Jay-Void-BA/OpenKeys/hardware/README.md

# 硬件导航

当前版本为 **[R0.5 PIN＋十键](r05/README.md)**，包含 10 页电路、已布线四层 PCB、BOM、制造包与结构候选。

| 内容 | 文件 |
|---|---|
| 整机图 | [尺寸 PDF](r05/exports/OpenKeys-dimensions.pdf)、[PNG](r05/exports/OpenKeys-dimensions.png) |
| 电路 / 板源 | [原理图](r05/exports/OpenKeys-schematic.pdf)、[PCB](r05/kicad/OpenKeys.kicad_pcb) |
| 打样 | [Gerber / 钻孔](r05/exports/OpenKeys-fabrication.zip)、[BOM](r05/BOM.csv)、[坐标](r05/exports/OpenKeys-SMD-position.csv) |
| 固件对应 | [引脚](r05/pinout.csv)、[R05 目标](../firmware/r05/README.md) |
| 规则与摘要 | [板网报告](r05/review/board-check.json)、[CAD 清单](r05/review/cad-manifest.json) |
| 制作 / 验证 | [R05 手册](../manufacturing/BUILD_R05_ZH.md)、[安全复查](../docs/SECURITY_REVIEW_R05.md) |

当前工程候选未生产放行，完整认证镜像和物理安全验证尚未完成。

历史：[R04 指纹 / 四键](r04/README.md)、[R03](r03/README.md)、[R02](HISTORY_R02.md)。旧资料保持原路径追溯，不与 R05 制造包混用。不要运行旧生成器覆盖新板。
