Jay-Void-BA/OpenKeys/docs/SE_NATIVE_PIN_FEASIBILITY_R05.md

# SE 原生 PIN 强制：候选机制与验收条件

当前经典版已改选 SE051C2 / OEF A8FA / Applet 7.2；本页旧 E2 / 通用 SE05x API 研究不能视为新实片资格证明。见[选型与待验项目](CLASSICAL_SE_POWER_R05.md)。
[当前复查](SECURITY_REVIEW_R05.md) · [会话规则](PIN_SESSIONS_R05.md)

**整机尚未接通或通过实片验证。** 已新增[原生 PIN v4 后端](NATIVE_PIN_RUNTIME_R05.md)
与密封私钥接口；旧 `pin_only` 的 HKDF / MCU 比较后端继续保留用于历史与回归，
不能充当原生私钥权限。SE_EN 不是 PIN 验证器，本页不能作为整机硬件强制的证明。

## 已核对的原厂接口事实

来源：[NXP plug-and-trust](https://github.com/NXP/plug-and-trust/tree/7102413e0457d3dfa4fc4be686ca8ec50bd9f5e2)，
固定提交 `7102413e0457d3dfa4fc4be686ca8ec50bd9f5e2`，
`hostlib/hostLib/se05x_03_xx_xx/se05x_APDU_apis.h` 中的接口说明：

- `WriteUserID` 创建 4–16 字节的 UserID 对象，因此六个数字的编码长度在范围内。
- 创建认证对象时可指定 `TAG_MAX_ATTEMPTS`；PIN 的最大尝试值必须小于 256。
  **省略或填 0 表示无限次数**，不能用于本项目。该字段只在首次创建且设置
  `INS_AUTH_OBJECT` 时适用，不能假设后续普通写入会改变限次策略。
- `CreateSession` 引用四字节认证对象 ID，返回八字节临时会话标识；
  `VerifySessionUserID` 验证成功才完成该类会话建立，错误则不建立。
- `CloseSession` 关闭后不能重开该会话，参数为临时状态。
- AN12413 Rev2.12 §3.2.4.4 明确 UserID 的通用 object counter 不报告失败次数，
  保持 0；不能据此判断没有猜测、次数返还或原生限次正确。须用有限次数的合成对象
  直接验证拒绝行为。`ReadSize` 对 UserID 不返回长度，不能作为六位 PIN 检查。

这是通用 SE05x API 的描述。仍须确认 **实际采购的 SE051C2 料号、Applet / profile、
对象策略、SCP 组合、尝试计数及掉电行为**。有函数声明不代表选定器件和配置已经满足要求。
没有复制或编译 NXP C 实现。

## 不能只增加一次 Verify 调用

1. FIDO / OpenPGP / PIV 私钥、OTP HMAC 与 vault 解密 / 包装密钥，必须由 SE 对象 ACL
   限制为正确的本地 PIN 认证会话。仅在 MCU 设置 `unlocked=true`，或用 SCP03
   验证 MCU 身份后直接允许全部密码操作，仍然能够绕过本地 PIN。
2. 必须排除运行期管理员凭证的旁路授权。尤其不能允许删除 / 重写 PIN 对象后复用
   同一 AuthID 访问旧私钥；这会违反“改硬件 PIN 清空全部数据”。对象 ID 的复用、
   PIN 对象生命周期与所有私钥生命周期需要共同审查。
3. UserID / PIN 不可在未保护的 I2C 上传输。Platform SCP03、Applet SCP03 和 UserID
   会话是不同概念；必须验证实际组合和全程加密 / 完整性，不能根据接口名称推断。
4. SE 临时会话标识只留在受保护 Root 内部，不导出到管理器、日志或任意 APDU
   转发接口。设备配对通道的对端 / transcript / RF 场次绑定仍需独立完成。
5. 原生限次通常只说明认证对象会被限制，**不等于第 11 次失败自动擦除其他对象**。
   完整清空、掉电恢复、Flash 密钥 / 目录 / staging、协议 PIN 和配对必须另行实现。
   锁住 PIN 后如何执行不可读取旧秘密的全清空，也必须验证。
6. 原生会话不能被假设自带 30 秒空闲期限。可信计时、断连 / 离场撤权、SE 关闭 /
   断电和故障响应必须实测；不能把周期保活或 `RefreshSession` 当成用户有效活动。
   如果要求在 Root 已被攻陷时仍保证期限，需要额外硬件机制或更换能强制该策略的器件。

## 全清空的特殊响应不能放宽普通通道校验

同一固定 SDK 的 `DeleteAll` 文档明确：该命令只允许由
`RESERVED_ID_FACTORY_RESET` 凭据认证的会话执行；NXP 信任预置的对象不删除。
它会关闭运行中的会话，响应可能“not encrypted and no R-MAC”。

因此，收到裸 `9000`、断连或一次普通 SCP03 校验失败，都不能证明已经清空。
不能为此修改普通 `ScpSession`，让它接受未认证响应。当前代码没有加入这种例外，
已补[固定 DeleteAll 请求与冷复位后观察](../crates/se-state/src/reset.rs)：独立16字节
reset-only UserID 认证、一次固定命令、不接受裸应答为完成、物理断电、重新认证后清点；
没有放宽普通 SCP03，也没有默认 / 工厂密钥。该组件只产生 Pending / Observation，
不能表示整机全清空。完整擦除服务仍需要独立状态机：先持久锁存擦除中，执行受控
重置，再重新建立认证通道，核对预期的 NXP 预置对象、所有用户命名空间和 Flash
解密 / 包装密钥的销毁结果；错误、断电或无法核对时继续保持锁定。

缺少 PIN 标记或用户对象不是“已回到安全空白”的证明。尤其要测试半擦除后
PIN AuthID 被删除 / 重建、旧私钥仍残留的情况，不能让新 PIN 访问旧秘密。
这项设计风险必须在完整销毁服务和真实 Applet 验证完成后才能关闭。

保留[默认关闭的样板会话探针](NATIVE_UID_QUALIFICATION_R05.md)用于独立实验；新原生
后端已实现编码 / 账本 / 私钥接口，完整擦除、初始化、Root 与资格验证仍是放行阻断项。

## 最小实片负向测试

使用合成密钥逐项测试：未验证 / 错 PIN / 错 AuthID / 错协议角色时签名、解密、
HKDF、OTP 均失败；跨每个 APDU 边界断电不能返还次数；十次错误后第十一次正确
与第十一次错误分别核对；达到限制后复位 / 重建会话 / 换接口不能恢复旧权限。

尝试普通 MCU SCP 会话、工厂命令、更新模式、对象删除重建、旧会话 ID 重放和
管理员权限替换，均不能保留旧秘密并跳过本地 PIN。随后验证改 PIN 全清空、
半擦除重启、NFC 快速重入、USB 重置 / 挂起、30 秒保活、短电压 / 时钟 / EM 故障。

必须记录器件批次、Applet/profile、对象策略字节、固件提交及测量证据。
在这些条件关闭前，当前 R05 继续维持生产放行 BLOCKED。
