Jay-Void-BA/OpenKeys/hardware/pinout.csv

pin | gpio | net | function
1 | VBAT | +3V3 | power / GPIO / dedicated
2 | PC13 | CASE_TAMPER_N | power / GPIO / dedicated
7 | NRST | NRST | power / GPIO / dedicated
10 | PC2 | FLASH_MISO | SPI2_MISO AF5
11 | PC3 | RTC_INT_N | power / GPIO / dedicated
12 | VSSA | GND | power / GPIO / dedicated
13 | VDDA | VDDA | power / GPIO / dedicated
14 | PA0 | USB_SEL | power / GPIO / dedicated
15 | PA1 | USB_OE_N | power / GPIO / dedicated
16 | PA2 | PGOOD_N | power / GPIO / dedicated
17 | PA3 | CHG_N | power / GPIO / dedicated
18 | VSS | GND | power / GPIO / dedicated
19 | VDD | +3V3 | power / GPIO / dedicated
20 | PA4 | NFC_CS_N | power / GPIO / dedicated
21 | PA5 | NFC_SCK | SPI1_SCK AF5
22 | PA6 | NFC_MISO | SPI1_MISO AF5
23 | PA7 | NFC_MOSI | SPI1_MOSI AF5
24 | PC4 | VBUS_A_N | power / GPIO / dedicated
25 | PC5 | VBUS_C_N | power / GPIO / dedicated
26 | PB0 | BTN_UP_N | power / GPIO / dedicated
27 | PB1 | BTN_DOWN_N | power / GPIO / dedicated
28 | PB2 | BTN_OK_N | power / GPIO / dedicated
29 | PB10 | UI_SCL | I2C2_SCL AF4
30 | VCAP | VCAP | power / GPIO / dedicated
31 | VSS | GND | power / GPIO / dedicated
32 | VDD | +3V3 | power / GPIO / dedicated
33 | PB12 | FLASH_CS_N | power / GPIO / dedicated
34 | PB13 | FLASH_SCK | SPI2_SCK AF5
35 | PB14 | UI_SDA | I2C2_SDA AF4
36 | PB15 | FLASH_MOSI | SPI2_MOSI AF5
37 | PC6 | NFC_IRQ_N | power / GPIO / dedicated
38 | PC7 | FP_RESET_N | power / GPIO / dedicated
39 | PC8 | SE_EN | power / GPIO / dedicated
40 | PC9 | FP_IRQ | power / GPIO / dedicated
44 | PA11 | USB_DM | USB_DM AF10
45 | PA12 | USB_DP | USB_DP AF10
46 | PA13 | SWDIO | power / GPIO / dedicated
47 | VSS | GND | power / GPIO / dedicated
48 | VDDUSB | +3V3 | power / GPIO / dedicated
49 | PA14 | SWCLK | power / GPIO / dedicated
50 | PA15 | FP_CS_N | power / GPIO / dedicated
51 | PC10 | FP_SCK | SPI3_SCK AF6
52 | PC11 | FP_MISO | SPI3_MISO AF6
53 | PC12 | FP_MOSI | SPI3_MOSI AF6
55 | PB3 | SWO | power / GPIO / dedicated
56 | PB4 | CHARGE_ENABLE | power / GPIO / dedicated
57 | PB5 | BTN_CANCEL_N | power / GPIO / dedicated
58 | PB6 | USB_LIMIT_500 | power / GPIO / dedicated
59 | PB7 | USB_LIMIT_EXT | power / GPIO / dedicated
60 | PH3 | BOOT0 | power / GPIO / dedicated
61 | PB8 | SE_SCL | I2C1_SCL AF4
62 | PB9 | SE_SDA | I2C1_SDA AF4
63 | VSS | GND | power / GPIO / dedicated
64 | VDD | +3V3 | power / GPIO / dedicated
