Jay-Void-BA/OpenKeys/docs/ADVERSARIAL_REVIEW_R04.md

# R04对抗性复核：当前不能给整机安全背书

日期：2026-11-09。范围：当前R04电路/PCB网表、Rust源码及其明确补丁；不是独立第三方认证，不证明全部漏洞不存在。

**结论：在已实现的软件切片内有可复现的防绕过措施；整机尚不能被确认“理论上不易攻破”，也尚不能正式投入真实账户。** 生产启动/隔离、实际硬件密钥桥接、管理通道和生命周期尚未闭合，物理攻击资格全部NOT_RUN。零ERC/DRC、Rust、安全芯片和CI成功分别证明有限事项，不能组合成未完成的整机安全证明。

## 从真实网表能确认什么

`SE_ENABLE_REQUEST`只连接U4.39与U12.2，U12另一输入来自NRST；U12.4输出SE_EN到U5.11。没有传感器匹配结果的独立硬件证明输入。它是故障/复位使能门，**不是指纹授权门**。必须由受保护启动/内存/外设归属和经过认证的指纹状态机建立真正授权链。

`CASE_CLOSED`连接SW6、U11及U4.2；NRST同时驱动U12与U15，U15.4进入LCD_RESET_N。复位/开盖具有独立电路路径，但触点/连线仍可能被桥接，I2C LCD也没有对显示内容的密码认证。不能据“可信GPIO/有开关”推定对探针、改屏或维护夹具同样可信。

电源有TPS259470L、TPS3702、电池保护和真实NTC的设计；现有OVLO5.5612–5.8436V仅是DC角落计算。eFuse的VBUS保护不能等同USB数据/CC引脚抵抗任意持续过压，ESD器件额定也不是所有注入能量的安全保证。TPS3702约19µs典型响应不能覆盖更快VCAP/FP/SE/时钟/EM故障。网表/布线摘要与独立核对见R04 review，不假定它们验证了这些物理条件。

## 未关闭风险和交付门槛

| 编号 | 风险／实际攻击路径 | 当前状态与必须关闭的条件 |
|---|---|---|
| A01，阻止交付 | 不可信固件、调试恢复、错误SAU/GTZC/DMA归属可使攻击者直接接触SE、GCM、LCD、按键或授权RAM | OPEN。当前可烧录物是OPEN/TZEN=0诊断；生产可信启动、签名更新/防降级/调试闭合、实际Secure地址及异常退出仍待部署/实测 |
| A02，阻止交付 | 共享FPC对称密钥被掌握后，可以构造传感器方向的合法GCM匹配帧；“标签有效”不独立证明手指确曾通过 | OPEN。Root TCB与密钥使用权必须不可被主机/NS/DMA取得；配对、固件/模块真实性、默认安全状态及传感器替换必须验证。若要抵抗被攻陷Root本身，现有对称协议不能提供该保证，需更换能独立证明匹配的架构 |
| A03，高风险未验证 | 快速降压/VCAP、时钟或EM故障使启动检查、GCM/PIN/授权/计数/提交判定发生错误 | NOT_RUN。分域、关键时间点扫描；有效无指纹输出即失败。外部监控器及软件重复检查不能自动关闭该项 |
| A04，高风险未验证 | 桥接开盖触点、探针或改写LCD总线，使机壳被打开却不撤权，或显示与真实操作不符 | OPEN/NOT_RUN。必须评估结构、断电/备用域丢失策略、屏幕路径；若威胁模型含持续侵入，需评估主动网格/屏蔽/封装和相应撤权/密钥销毁，不能把普通触点作为等价替代 |
| A05，高风险未验证 | 功耗、EM或时序泄漏SE操作、MCU中的配对/会话/派生秘密、CMAC/HMAC相关处理 | NOT_RUN。SAES掩码与SE非导出是部分防护，不覆盖CPU所有中间值；须测SE、SCP、FP、PIN、vault及hmac-secret各实际实现，并报告攻击预算与残余泄漏 |
| A06，可用性门槛 | 8次持久连续失败/不确定取消或65535标签耗尽会阻止新指纹；签名槽预留耗尽/中途失败可消耗容量 | OPEN。新请求必须先有安全GPIO上的本地意图，不能由远端请求直接耗尽预算；制造前须确定维护/轮换和永久锁定的可用性策略，不得用PIN单独恢复。256槽是软件边界，不是SE容量承诺 |
| A07，需量化 | 当前SCP03 S8的MAC为64bit，AES256不改变该标签长度；反复重启/建会话的累计攻击预算不能只看每会话4096命令上限 | OPEN。核对所选SE能力/安全等级、持久失败预算和实际生命周期；不能宣称整条总线有128/256bit认证强度 |
| A08，阻止交付 | 伪装USB/NFC设备、中间人或重放管理请求，导致notes/recovery泄漏或错对象修改 | OPEN。真实认证加密管理通道及完整Root dispatcher尚未部署；VID/PID、序列号、手机系统指纹和主机“成功”按钮都不是设备身份/解锁证明。当前管理器后端拒绝私密操作 |
| A09，需明确范围 | 删除后旧扇区仍有密文；泄漏密钥、强制回退或错误重置流程可能使旧数据可读 | OPEN。现有SE锚点阻止普通快照回退，不等于密码学安全删除；密钥轮换/销毁与全局重置需有跨SE/传感器/vault的掉电安全事务 |
| A10，功能及安全集成门槛 | 1MiB最坏NOR写入超过15s原始批准期限；上游静态密码接口若被接到软件私钥，会丢失预期SE保护 | OPEN，部分源码已修正。新增精确请求绑定、不可续期的Execution，批准必须在15s内消费；慢写执行上限300s，读取/签名15s。FIDO前后检查真实代际并拒绝时钟回退。实际Root检查点、可取消批量staging、硬件Env与故障传播桥接仍未完成；不得全局延长解锁或回退软件私钥 |
| A11，高风险未验证 | 传感器在复位/故障下重复同一配对密钥的GCM IV，可能破坏消息认证；16位请求tag只防旧请求重放，不能修复GCM nonce复用 | NOT_RUN。公开安全补充只说明随机12字节IV，不能据此推定抗故障唯一性；须测试两个方向、状态/识别帧、模块复位和RNG故障，并核对原厂版本与保证。接收端最近nonce缓存也不能证明被攻击者截获/拦下的传感器输出从未重复 |
| A12，高风险未验证 | 假指纹/误匹配也可能让真实模块发出合法匹配帧；总线加密无法判断此次匹配是否来自合法使用者 | NOT_RUN。所选Pro模块公开声明增强spoof检测，但本项目没有生物识别实测或适用证书。必须核对确切模块/算法/固件、匹配阈值、登记数量和模板更新策略，并测FAR/FRR与PAD；不可仅用正常手指的几次成功/失败推断安全性，也不可通过PIN备用路径规避本项目强制指纹要求 |

## 已修正且有软件证据的具体路径

* 主机不能用`uv=false/up=false`绕过设备UV/UP；公共GetInfo去掉私密凭据剩余容量和未开放的主机PIN/config API。
* 私密调用消费不可由主机反序列化/构造的Authorization，绑定操作/实际字节摘要/通道，前后检查时间/状态；授权转移给Root，结束范围即撤销。
* 已批准长事务只获得一次、固定且不可续期的执行范围；不同操作/对象/通道不可借用。FIDO在密码操作前和输出后检查当前授权代际；激活过程中的时钟回退也会在首次密码操作前被拒绝。终端代际耗尽后不再签发授权。
* GetNextAssertion保留原RP、通道、序列和原期限，每个结果需新指纹/确认；U2F不复用缓存触摸。
* I2C仅确认地址阶段忙时可重试；数据阶段NACK、部分收发、时钟回退和晚故障均关闭实例，不自动重发未知完成的SE命令。
* 存储中途掉电/应答丢失不退款nonce，提交锚点坏时不回旧head；流式编辑和范围读取的后段故障会清空前段已复制明文。缓存条目索引也随私密读取故障关闭。
* 逻辑记录排序/数量/长度/命名空间严格核对；notes/recovery另有设备端借用解析器，拒绝错类型、尾随数据、非法UTF8和全部Bidi_Control。主机与设备共享规范编码，不信任主机校验结果。
* SE签名先核对公钥/DER并独立验签；签名计数不回绕、不随notes写入复用，密钥槽先持久预留后生成，未知结果不覆盖或复用。
* 已拦截上游通用FIDO重置，防止先删除共享指纹模板再因持久操作失败而丢失访问。完整Root重置事务未实现时返回不支持，不报告假成功。
* 桌面对话框/后台读取前撤销与遮蔽，选择后重新设备授权；未知焦点、挂起/时钟回退、过期或跨代结果拒绝。宿主/GPU/OS缓存的零化不作绝对保证。

这些测试在公开/合成输入和模型上执行；它们没有把上述OPEN或NOT_RUN改成PASS。芯片已有认证也不自动认证我们的PCB、应用或管理器。下一步由[大陆候选机构](../manufacturing/MAINLAND_SUPPLIERS_AND_LABS.md)先做架构预评估，再按[硬件验收](../manufacturing/HARDWARE_ACCEPTANCE.md)对确定版本开展独立测试。

生物识别的匹配性能与呈现攻击检测应分别评估；参见[FIDO生物识别文件入口](https://fidoalliance.org/certification/resource-documentation-biometric/)及[已发布v4.0要求](https://fidoalliance.org/specs/biometric/requirements/Biometrics-Requirements-v4.0-fd-20240522.html)。委托时与实验室确认当时适用版本和级别，不把2026年v5.0审查草案自动当作已生效要求。
