Jay-Void-BA/OpenKeys/docs/SECURITY_REVIEW_R04.md

# R0.4 硬件与软件核查记录

本记录对应先完成电路与实际PCB、再写板级固件的顺序。源文件和最终电气报告在[hardware/r04](../hardware/r04/README.md)；[安全测试方法](SECURITY_TEST_PLAN.md)给出三把实物的逐项检查。未执行的物理测试保持NOT_RUN。

最新[对抗性复核](ADVERSARIAL_REVIEW_R04.md)按真实网表/当前源码列出未关闭攻击路径；[大陆制造/实验室候选](../manufacturing/MAINLAND_SUPPLIERS_AND_LABS.md)附官方来源。当前不能据本记录确认整机“理论上不易攻破”。下列历史续更中的“尚缺”须结合最新状态表阅读。

| 核查发现 | 修正及证据 | 边界 |
|---|---|---|
| 旧版只有放置研究，无法证明连通 | R04从原理图XML分配实际焊盘网络；完整放置130个BOM位置，最终0DRC/0未连接，624项独立核对 | 不等于芯片实物功能通过 |
| SMD地焊盘不能因为画了内层地面就假定已连接 | 显式连接114个SMD地焊盘并加接地通孔，再交由KiCad连通性检查 | 高频回流、电源瞬态和热仍需测量 |
| LCD只灭背光不能隐藏文字 | 新增U15复位缓冲，NRST独立拉低LCD_RESET_N，3.0V上拉；PC3必须开漏 | AiP31032实际复位清屏时间需实测；不声称瞬时消除残像 |
| 天线图形未被通用路由器当作电气障碍；曾有走线碰馈线 | 明确建模馈线电气铜、RF区域边界和跨层真实导线；最终零短路/零断线 | 最终外壳、手持及器件寄生下仍需VNA与手机互通 |
| 切换电源节点和MCU VCAP容易被长路径/过孔绕行 | 先布短B.Cu电感回路和VCAP局部线，独立检查无过孔、总长度各<6mm | 环路面积、寄生/纹波/故障窗口未由长度检查覆盖 |
| 旧保护电池型号/NTC未冻结 | 明确保护500mAh电池及独立103AT-2贴芯NTC、两组不同插座，预留膨胀和绝缘空间 | 接线极性、保护阈值、温升、容量及寿命须逐样件确认 |
| 屏蔽耦合电容旧封装不符合耐压目标 | 选KEMET C1206C102KGRACTU 1nF/2kV，1206实际封装 | 不能据额定电压推断整机ESD等级 |
| 结构图曾混淆二维Y向下与三维右手系 | SCAD/Blender/尺寸数据统一X=x,Y=98-y,Z向外；修正LCD LED孔及圆形指纹模块/排线 | 打印收缩、接插件和按键行程需要实物试装 |

## 仍须解决和验证的安全条件

1. **硬件强制指纹尚不能单凭电路宣称成立。** SE_EN门控只反映复位与主控请求。认证传感器协议、可信启动和TrustZone/GTZC/DMA归属必须实际部署，私密操作在同一保护域内消费单次凭据后执行，不允许主机/非安全域发原始SE、GCM、显示或GPIO指令。
2. **SE050及FPC的安全配对和持久预算没有实物证据。** 工厂测试密钥、默认SCP03密钥不可用于真实秘密。16位指纹操作tag不得回绕；耗尽、断电歧义和备用域丢失必须锁定，不能回退PIN或重新变成空白设备。密钥轮换与恢复流程必须在耗尽前验证。
3. **快故障注入仍是开放威胁。** TPS3702约19µs典型传播延迟不覆盖更短VCAP降压、时钟/EM/激光故障。外部比较器、Brownout、软件重复检查或Rust均不证明无旁路；参照测试计划扫描时间/幅度/脉宽，若产生无指纹签名或秘密输出即停用该版本。
4. **触点防拆可能被短接。** 结构没有经过验证的主动网格或不可绕过断电清除。电池拔除、backup丢失、保留电压、传感器替换、探针接触和调试恢复分别测试。禁止把“有开盖开关”写成抗所有物理攻击。
5. **侧信道未测。** SE私钥不可导出、常时代码和零化都是设计条件。功耗/近场EM/时序、编译优化和受控请求条件下泄漏仍需测量。TVLA筛查阴性不等于无泄漏，须结合攻击实验及密钥/模板保护评审。
6. **电源保护计算只覆盖已列DC角落。** 需实测eFuse动态越压、反灌、TVS/PPTC热与能量协调，USB枚举/休眠限流及Apple20W适配器5V下实际输入/充电电流。不能给成品充电功率贴0.42W保证值。
7. **软件当前范围不能冒充完整认证器。** 现有策略、导入解析和锁定桌面程序的测试仅覆盖其真实实现。完整CTAP、SE持久存储、认证管理通道、签名更新与实际ARM运行时须分别通过功能/负向/模糊测试；未实现的接口保持拒绝，不伪造成功。

未发现问题的有限测试不能得出“所有软件漏洞均已排除”。仓库记录可重现的工具、具体输入和测试范围；不提供自签的安全认证结论，不借用上游或芯片认证为本整机背书。

## 板级软件自查续更

- LCD驱动在通信失败、非法字符、锁定和对象释放时主动拉低复位，保持至少2ms，避免GPIO析构恢复浮空后保留可见文字。I/O故障在该实例内不可重新初始化解锁。总线ACK不是实际显示内容的光学证明，仍须U04实测。
- 四键只在稳定释放后产生一次短按或长按；组合键、场景切换残留按键、长采样中断和时钟回退会丢弃或锁住输入。Flash驱动在发送写命令前检查地址/长度/页边界，检查WEL，写后回读；这些不是AEAD持久vault或抗回滚实现。
- 桌面端发现仅凭`Instant`可能在部分系统休眠后延长显示授权，已增加独立墙钟期限/回退拒绝及帧间隔检查。设备端授权与USB挂起撤销仍是安全权威；这个修正不宣称覆盖所有OS的短休眠通知。
- 严格依赖扫描发现Cortex-M0.7.10依赖已归档`bare-metal`（RUSTSEC-2026-0110，维护警告）。已用明确记录的源码补丁移除该兼容层，改为维护中的critical-section token/Mutex，保留原PRIMASK及内存屏障后端；添加嵌套、线程互斥和异常释放测试。未通过审计忽略列表消除警告。补丁及许可证随源交付。
- ARM诊断ELF/BIN是真实目标代码，但不是安全启动/认证运行时；SE/指纹始终关闭，无充电服务、USB/NFC/FIDO或私密写入。不会把“可烧录”当作“可存真实秘密”。

## 加密存储与硬件AEAD续更

新增no_std双区快照核心及实际W25Q64区间适配：提交点之前只写非活动区；源摘要、密文回读和flush全部成功后才更新受保护head。模型逐点断电（含半写扇区及commit已生效但返回不确定）、完整旧快照重放、分块交换和写后篡改均作为负向案例。epoch必须由真实SE预扣且永不退款，不能用测试内存计数替代。

自查发现开始时检查授权不足以覆盖慢I/O；已增加强制Checkpoint，跨读写/加解密后重读实时状态，并在最终输出/提交前拒绝过期或取消。测试确认在解密完成后过期仍输出全零，在每个写入检查点取消均不改变旧head。实际Ledger提交必须保持在同一保护域；已经线性化的提交无法被事后取消“撤销”。

实际H573 SAES AES-256-GCM适配器已编写并进行目标编译/Clippy检查：先在私有零化缓冲中解密，常时核对tag后才复制明文；每次运算及释放时用IPRST清理硬件key状态，清理失败重置MCU。它要求受保护的独立vault密钥、正确外设/RAM/DMA归属及watchdog；不会由公开UID、默认常量或测试key生成生产密钥。尚无芯片KAT、波形或侧信道证据，编译通过不是这些条件的证明。

明确未解决：真实SE原子ledger和密钥配对、记录解析与授权集成、旧密文安全删除、大小/活动时序泄漏及全部物理侧信道/故障测试。它们仍阻止生产安全发布，不能被新的模型测试覆盖或自动豁免。

## SE与H573密码续更

后续对照厂商资料发现前述SAES适配所用HAL存在H573 IV映射/故障标志处理及通用RNG配置问题，已经由专用有界寄存器序列与检查型RNG替换，不能继续把旧路径的“编译通过”当作密码行为证据。新增严格T=1和SCP03组合，要求四项保护、实时检查及异常终止；全部参考版本、修正、unsafe MMIO例外和未执行项目见[专项核查](H573_CRYPTO_REVIEW.md)。

桌面端先前发现同步文件选择/读取会阻塞帧驱动的清屏和超时处理。源码现已改为：先撤销授权、清除私密行并完成两帧遮蔽，再创建异步文件选择器；选择结果只含路径，必须重新通过设备指纹才允许后台读取；读取取消、代际绑定和过期结果丢弃独立检查。整个批次1 MiB/256条上限，最多一个未结束读取线程。原生选择器即使回退同步，创建前也已经撤销/遮蔽。模型与真实后台fixture测试不证明三系统合成器已经显示遮蔽帧，焦点/挂起/慢网络盘/原生对话框仍须M03实测。当前硬件后端继续拒绝解锁和写入；未用主机假授权绕过。详情与宿主内存清理边界见[AuthDesk说明](../apps/manager/README.md)。

## 持久SE实现续更

新增实际SE050对象指令和持久状态适配，明确分开nonce预扣、未提交head写入及commit锚点。模型逐条APDU中断/应答丢失/半写后，重启只接受锚点指定的完整旧版或新版；选中head坏、旧head重放、counter回退均拒绝。测试还将真实device-vault核心接到这个ledger，对NOR旧镜像进行负向验证。成功返回与readback的实际NVM持久语义仍需实片证明。

硬化credit接口与状态共享：仅在已认证指纹结果、原请求和预扣tag/次数一致时credit；失败实例不能自动重开。共享State和SAES服务重入后整个服务被poison，外层正在执行的调用也不能释放成功结果。密码错误清零输出；FPC GCM和vault标签错使共享密码服务拒绝后续运算。Root仍须独立撤销授权、清屏并处理硬件fault。

当时命名空间只含生物重试与vault对象；当前schema2已补独立签名计数与密钥槽预留，PIN持久适配和完整管理协议仍未完成。8次持久失败可能永久停止该配对的指纹尝试，PIN不能替代；尚无经验证的维护恢复。marker绑定策略与布局，但既不证明对象ACL，也不证明对端芯片身份。禁止将源码模型通过提升为量产批准。

## 指纹SPI与发送续更

受保护Identify构造在持久预扣之后、加密之前及之后重读时间；SE应答不确定/密码错误不返回报文。发送消费构造器输出，前后核对当前request/channel及期限；SPI错误不重试，保持reset并锁住实例。独立AES-GCM双向向量、真实ExclusiveDevice与模型总线检查已加入。详见[FPC专项核查](FPC_RUNTIME_REVIEW.md)。

自查新增明确约束：阻塞HAL中的标志等待不能由事后100ms检查抢占，必须有独立硬件watchdog；H573 PAC使用非安全别名范围，不能以引脚匹配或U5专用trustzone-secure功能推定实际安全事务。SAU/GTZC/GPIO/RCC/中断/DMA配置、传感器随机IV抗故障以及配对/取消/模板管理仍未合格，生产发布继续阻止。

导入解析追加自查修复：原来只拒绝bidi覆盖/隔离控制，遗漏了ALM(U+061C)、LRM(U+200E)、RLM(U+200F)，可导致标题/恢复码视觉顺序混淆。现拒绝全部Unicode Bidi_Control码点；新增恶意notes/recovery JSON回归输入。此修复不等于一般Unicode同形字符问题已消失，可信设备确认仍须绑定实际内容摘要。

焦点自查追加修复：原先只在OS明确报告focused=false时撤销桌面授权，focused未知(None)仍被放行。现在只有Some(true)保持显示授权；未知焦点同样清除预览并取消/丢弃后台结果。现有焦点/休眠测试追加None输入，整套125项测试保留。
