Jay-Void-BA/OpenKeys/hardware/r04/exports/OpenKeys-dimensions.pdf

# OPENKEYS R0.4

### ASSEMBLY / ELECTRICAL PCB CANDIDATE - PHYSICAL QUALIFICATION REQUIRED

# 74 x 98 x 20 mm

USB-C female / white16x2 LCD / device fingerprint

74.0

98.0

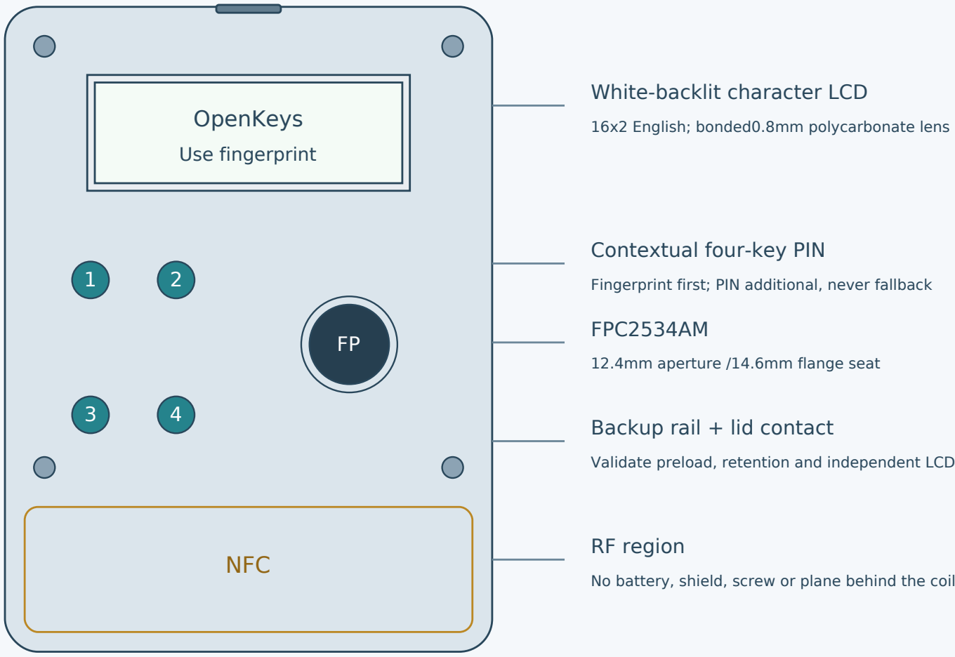
[picture p5: figure]
OpenKeys; Use fingerprint; NFC; White-backlit character LCD; 16x2 English; bonded0.8mm polycarbonate lens; Contextual four-key PIN; FPC2534AM; 12.4mm aperture /14.6mm flange seat; Backup rail + lid contact; RF region

## FRONT

Fingerprint first; PIN additional, never fallback

Validate preload, retention and independent LCD reset

No battery, shield, screw or plane behind the coil

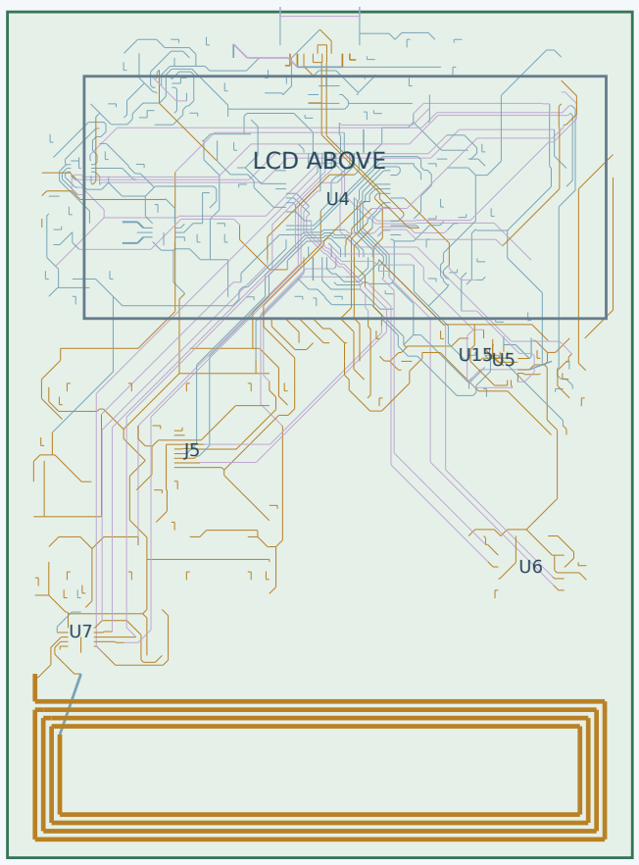
[picture p6: figure]
LCD ABOVE

ACTUAL PCB LINEWORK

F.Cu / B.Cu / In2 signals; In1 ground

RF
20.0

SECTION / PCB1.0 / wall1.8 / floor1.6

## ASSEMBLY NOTES

PCB and enclosure controls checked together.

FP tail left, contacts down; pin1 at lower edge.

Support sensor back; do not clamp the flex bend.

500mAh protected pack plus attached10k NTC.

0.50W input budget; cell charge up to0.42W.

No IP rating or physical-attack certificate.

CAD AND SIMULATION ARE ENGINEERING EVIDENCE / QUALIFY BEFORE REAL KEY PROVISIONING
