Jay-Void-BA/OpenKeys/hardware/r03/exports/OpenKeys-dimensions.pdf

# OPENKEYS R0.3

DIMENSIONED ENGINEERING REVIEW / NOT FOR MANUFACTURE

# 74 x 98 x 20 mm

Single USB-C / 16x2 white LCD / fingerprint mandatory

74.0

98.0

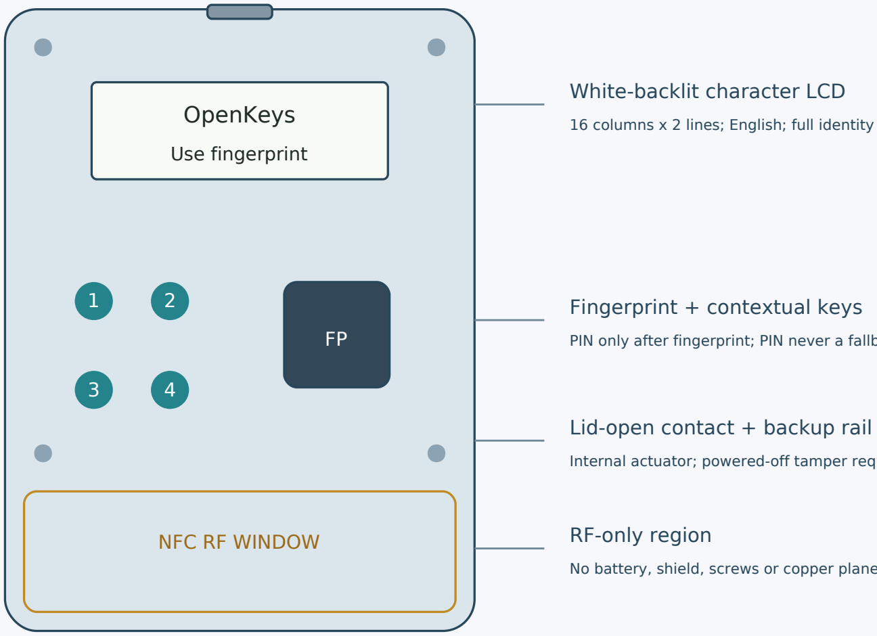
[picture p7: figure]
OpenKeys; Use fingerprint; NFC RF WINDOW; White-backlit character LCD; Fingerprint + contextual keys; Lid-open contact + backup rail; RF-only region

## FRONT

16 columns x 2 lines; English; full identity paging

PIN only after fingerprint; PIN never a fallback

Internal actuator; powered-off tamper requires VBAT/LSE

No battery, shield, screws or copper planes here

LCD envelope

CELL BELOW

RF ONLY

68 x 92 x 1.0 / 4 LAYERS

UNROUTED PLACEMENT STUDY

RF
20.0

SECTION / enclosure1.6mm / PCB1.0mm

## ASSEMBLY LIMITS

LCD selected; FP/body/connector fit needs actual samples.

Protected500mAh pack target:32x37x6mm incl PCM/NTC.

Polymer shell; four M2 fasteners; captive button plungers.

Tamper contact travel/preload must be measured, not assumed.

Target mass60-100g is a budget, not measured product weight.

No IP rating, physical-attack certification or battery-life claim.

REVIEW DRAWING / NO GERBER RELEASE / ASSEMBLY + RF + SECURITY TESTS PENDING
