Jay-Void-BA/OpenKeys/manufacturing/ORDER_SHEET_R04.md

# OpenKeys R0.4 工程首板订购 / 代焊确认单

[完整制作说明书](BUILD_MANUAL_ZH.md) · [板上采购表](procurement-r04-board.csv) · [板外采购表](procurement-r04-external.csv) · [硬件验收](HARDWARE_ACCEPTANCE.md)

用途：供个人、小批量工程询价与 DFM；**不是生产放行、已付款订单或正式安全认证器出厂指令**。

## 委托与数量

| 字段 | 约定内容 / 待填写 |
|---|---|
| 委托主体 | 个人；工厂须书面确认个人合同、付款和凭证方式 |
| 项目版本 | 本次 Git 提交：由双方填入；R0.4 CAD 摘要随附件 |
| 最终目标 | K01 / K02 / K03 三把日用密钥；完整软件与安全资格尚未完成 |
| 首轮询价 | 裸板 MOQ 依报价；可询 5 裸板、先只装 1 块 E01 |
| 后续装配 | 首板审核通过再定；开发板不默认计入三把成品 |
| 额外样件 | 实验室破坏试验板另列数量与费用，不自动追加 |
| 一次性 / 单件费用 | PCB、工程边、钢网、物料、两面贴片、后焊、治具、测试、结构、税运与返工分列 |

## PCB 和装配参数

| 项目 | 设计条件 |
|---|---|
| 层序 | F.Cu / In1.Cu / In2.Cu / B.Cu，共 4 层 |
| 板厚 | 1.0 mm；实际公差 / 叠层待审核 |
| 外形 | 主体 68×92 mm，加顶部 12×2.5 mm 凸出；最大外包络 68×94.5 mm，不含工程边；以原 Gerber 外形为准 |
| 线 / 间距与通孔 | 最小 0.15 / 0.15 mm；典型过孔铜盘 / 孔 0.60 / 0.30 mm，完整孔表为准 |
| 材料 / 表面 | 可先按 FR-4、1 oz 铜、无铅 ENIG 询价；具体材料、叠层和阻抗审核后确认 |
| 工艺 | 双面 SMT；顶面 50、底面 76，共 126 个 SMD 位置 |
| 后焊 | J2 电池板端连接器、U8 LCD，及 LCD 背光 A/K 线、批准的线束 / 机械装配 |
| 非采购位置 | J4 为 PCB 铜天线，不另买线圈 / 连接器 |
| 生产 DNP | J3 内部 SWD；开发治具 / 临时排针另约定，最终无外露调试口 |
| 采购表边界 | J2 / J5 / J6 是板端连接器；电池、指纹模块、真实 NTC 和线束见板外表；LCD U8 已计入原 BOM，不重复采购 |
| 方向 / 坐标 | 使用交付 CPL 和两面图；按原点与厂商旋转规范核对，不手工镜像底层 |
| RF / 结构 | 不改线圈、不加 RF 区金属 / 地铜 / 标记；工程边 / 拼板须回传审核 |

## 工厂确认清单

- [ ] 接受个人和本次数量，并明确最少费用 / 排期 / 报价有效期。
- [ ] 已补齐完整 MPN、容差 / 耐压 / 功率 / 温度参数、采购 MOQ 和损耗；F1 等待定物料已明确。
- [ ] 特殊 SE / NFC / 电源封装、指纹底接触插座与实际物料图纸核对一致；安全关键料不自行替代。
- [ ] 回传 DFM、工程边 / 拼板、钢网开窗和贴装预览；有源单板改动须回项目修订。
- [ ] 机贴后进行 AOI 和关键焊点检查，QFN / EP 的检查方法明确。
- [ ] 首次上电先不装电池，核对 J2.1=BAT+、J2.2=GND 与实物插头极性。
- [ ] 电源 / 故障 / 显示复位按验收表记录波形；不以“亮屏”代替测量。
- [ ] 现有镜像仅为空白 OPEN / TZEN=0 板的电气诊断，不启用指纹、SE、充电、USB / NFC 认证。
- [ ] NFC 装壳调谐和手机实测需相应固件 / 仪器，另列范围。
- [ ] 未接收生产密钥、真实指纹模板、PIN 或恢复码；本单不授权生产个性化、熔丝闭合或付费安全认证。

## 工厂交回资料

报价 / 受理确认、实际物料 / 批次、未决项、DFM / 厂稿、AOI / X-ray 结果、装配照片、上电与波形、诊断镜像摘要 / 工具版本、返修 / 不良 / 退料清单。任何超出本单的收费工作须先取得用户明确同意。
