Jay-Void-BA/OpenKeys/manufacturing/critical-parts-r05.csv

reference | manufacturer | bom_value | footprint | status | source | mainland_channels | personal_three_piece_order | notes
U4 | STMicroelectronics | STM32H573RIT6 | Package_QFP:LQFP-64_10x10mm_P0.5mm | ENGINEERING_CANDIDATE_NOT_QUALIFIED | https://www.st.com/resource/en/datasheet/stm32h573ri.pdf | Authorized China distributor / exact-part PCBA consignment quote; do not infer domestic stock | NOT_CONFIRMED | STiRoT/closed lifecycle and active backup configuration require qualification
U5 | NXP | SE051C2HQ1/Z01XDZ | OpenKeys:SE050_SOT1969-1_HX2QFN20 | ENGINEERING_CANDIDATE_NOT_QUALIFIED | https://www.nxp.com/docs/en/data-sheet/SE051.pdf | Authorized China distributor / exact-part PCBA consignment quote; do not infer domestic stock | NOT_CONFIRMED | Exact C2 OEF A8FA Applet7.2;12NC935414457472; unique keys; no E2 substitution
U2 | Texas Instruments | BQ25185DLHR | Package_DFN_QFN:Texas_DLH0010A_WSON-10-1EP_2.2x2mm_P0.4mm_EP0.9x1.5mm | ENGINEERING_CANDIDATE_NOT_QUALIFIED | https://www.ti.com/lit/ds/symlink/bq25185.pdf | Authorized China distributor / exact-part PCBA consignment quote; do not infer domestic stock | NOT_CONFIRMED | 100mA input/charge target; real protected main pack and pouch NTC
U7 | Fudan Micro | FM11NC08S (DFN10 + EP) | OpenKeys:FM11NC08S_DFN10_3x3_EP1.7x2.4 | ENGINEERING_CANDIDATE_NOT_QUALIFIED | https://wiki.nfc.im/attachments/7 | Authorized China distributor / exact-part PCBA consignment quote; do not infer domestic stock | NOT_CONFIRMED | Exact DN-T-G DFN10+EP drawing/lot approval; not a whole-device NFC power source
U13 | Texas Instruments | LM66100DCKR | Package_TO_SOT_SMD:SOT-363_SC-70-6 | ENGINEERING_CANDIDATE_NOT_QUALIFIED | https://www.ti.com/lit/ds/symlink/lm66100.pdf | Authorized China distributor / exact-part PCBA consignment quote; do not infer domestic stock | NOT_CONFIRMED | CE must equal VOUT; unused ST grounded; finite reverse leakage; primary-cell acceptance pending
U24 | Texas Instruments | SN74AUP1G99DCUR | Package_SO:VSSOP-8_2.3x2mm_P0.5mm | ENGINEERING_CANDIDATE_NOT_QUALIFIED | https://www.ti.com/lit/ds/symlink/sn74aup1g99.pdf | Authorized China distributor / exact-part PCBA consignment quote; do not infer domestic stock | NOT_CONFIRMED | DCU8; fixed XOR straps; needs U27 conditioned fast inputs
U25 | Texas Instruments | SN74LVC1G14DCKR | Package_TO_SOT_SMD:SOT-353_SC-70-5 | ENGINEERING_CANDIDATE_NOT_QUALIFIED | https://www.ti.com/lit/ds/symlink/sn74lvc1g14.pdf | Authorized China distributor / exact-part PCBA consignment quote; do not infer domestic stock | NOT_CONFIRMED | Schmitt RC receiver; ordinary inverter substitution forbidden
U26 | Texas Instruments | SN74LVC1G07DCKR | Package_TO_SOT_SMD:SOT-353_SC-70-5 | ENGINEERING_CANDIDATE_NOT_QUALIFIED | https://www.ti.com/lit/ds/symlink/sn74lvc1g07.pdf | Authorized China distributor / exact-part PCBA consignment quote; do not infer domestic stock | NOT_CONFIRMED | Open-drain reset; push-pull substitution forbidden
U27 | Texas Instruments | SN74AUP2G17DCKR | Package_TO_SOT_SMD:SOT-363_SC-70-6 | ENGINEERING_CANDIDATE_NOT_QUALIFIED | https://www.ti.com/lit/ds/symlink/sn74aup2g17.pdf | Authorized China distributor / exact-part PCBA consignment quote; do not infer domestic stock | NOT_CONFIRMED | DCK6 not a single-gate pinout; VBAT-live inputs require Ioff and slow-input support
U28 | Texas Instruments | TMUX1511RWBR | Package_DFN_QFN:Texas_X2QFN-12_1.6x1.6mm_P0.4mm | ENGINEERING_CANDIDATE_NOT_QUALIFIED | https://www.ti.com/lit/ds/symlink/tmux1511.pdf | Authorized China distributor / exact-part PCBA consignment quote; do not infer domestic stock | NOT_CONFIRMED | RWB0012A12pins; signal-path powered-off protection; not TMUX1101 or TS5A3166
BT1 | Panasonic | Panasonic CR-2032/HFN | Battery:Battery_Panasonic_CR2032-HFN_Horizontal_CircularHoles | ENGINEERING_CANDIDATE_NOT_QUALIFIED |  | Authorized China distributor / exact-part PCBA consignment quote; do not infer domestic stock | NOT_CONFIRMED | Pre-tabbed primary CR-2032/HFN only; current manufacturer tab/capacity/reverse-current documents required; never rechargeable
J7 | DFRobot | DFR0555 V1.1 - OFFBOARD MODULE | Connector_PinHeader_2.54mm:PinHeader_1x04_P2.54mm_Vertical | ENGINEERING_CANDIDATE_NOT_QUALIFIED | https://www.dfrobot.com.cn/goods-1697.html | Authorized China distributor / exact-part PCBA consignment quote; do not infer domestic stock | NOT_CONFIRMED | DFR0555 V1.1 module plus custom pin-checked VCC/GND/SCL/SDA harness; no new stock check
SW12 | E-Switch | LID RESET contact | Button_Switch_SMD:SW_SPST_TL3342 | ENGINEERING_CANDIDATE_NOT_QUALIFIED | https://www.e-switch.com/product/tl3342-series-tact-switch/ | Authorized China distributor / exact-part PCBA consignment quote; do not infer domestic stock | NOT_CONFIRMED | Four internal lid contacts SW12..15; separate from ten user keys; actuator preload qualification
