Jay-Void-BA/OpenKeys/manufacturing/critical-parts.csv

reference | manufacturer | part_number | selection_status | footprint_or_interface | source | unit_price_cny | price_tax | observed_date | notes
U4 | STMicroelectronics | STM32H573RIT6 | selected | LQFP64 10x10 0.5mm | https://www.st.com/resource/en/datasheet/stm32h573ri.pdf |  |  | 2026-11-08 | STiRoT target; lifecycle/GTZC configuration and exact silicon revision not production-qualified
U5 | NXP | SE050E2HQ1/Z01Z3Z | selected | HX2QFN20 SOT1969-1 | https://www.nxp.com/docs/en/package-information/SOT1969-1.pdf |  |  | 2026-11-08 | Custom 1.9mm EP land pattern transcribed from NXP; not generic HVQFN
FP1 | Fingerprint Cards AB | 100026230 | selected_for_EVT | FPC2534AM flex 12pin 0.5mm 0.3mm bottom contact | https://www.digikey.cn/zh/products/detail/fingerprint-cards-ab/100026230/25649789 | 246.53 | 13% VAT included | 2026-11-08 | Snapshot price MOQ1; observed stock17 is not reservation; GCM and persistent operation-tag protocol must be enabled and validated
FP1-low-cost-option | Fingerprint Cards AB | 100026223 | alternative_not_in_current_circuit | FPC2534AP LGA47 | https://www.digikey.cn/zh/products/detail/fingerprint-cards-ab/100026230/25649789 | 197.24 | 13% VAT included | 2026-11-08 | Related-part price on same supplier page; LGA footprint and SMT rework cost not validated; cannot substitute without PCB revision
J5 | Hirose | FH12-12S-0.5SH(55) | selected_for_EVT | 12pin 0.5mm bottom-contact 0.3mm FPC | https://www.hirose.com/product/p/CL0586-0704-0-55 |  |  | 2026-11-08 | Electrical pin order and flex contact orientation must be continuity-checked on sample; same keying cannot be inferred from appearance
J1 | HRO | TYPE-C-31-M-12 | selected_for_EVT | KiCad HRO 16pad USB2 footprint | https://en.krhro.com/Product-Details/726.html |  |  | 2026-11-08 | Lock actual drawing revision and verify sample mating height
SW1 | C&K | JS102011SAQN | selected_for_EVT | SW_SPDT_CK_JS102011SAQN | https://www.digikey.com/en/products/detail/c-k/JS102011SAQN/1640095 |  |  | 2026-11-08 | Active part; PCM12SMTR obsolete and not selected
SW2-SW6 | E-Switch | TL3342F160QG | selected_for_EVT | SW_SPST_TL3342 | https://www.e-switch.com/product/tl3342-series-tact-switch/ |  |  | 2026-11-08 | SW6 also needs a dimensioned lid actuator; fitted footprint alone does not prove tamper response
U7 | Fudan Micro | FM11NC08S-DN-T-G | selected_for_EVT | DFN10 3x3 0.5mm pitch; rotated EP1.7x2.4 | https://wiki.nfc.im/attachments/7 |  |  | 2026-11-08 | Fudan-authored v1.0 p9 geometry now transcribed. Supplier revision, sample orientation and stencil/DFM not production-qualified
ANT1 | OpenKeys PCB copper | R04_integral_4T_62x15 | selected_for_EVT | NFC_PCB_Loop_4T_62x15;56pF initial match | hardware/r04/tools/footprints.py |  |  | 2026-11-08 | Actual copper and return connection routed; VNA and phones in final enclosure not qualified
U2 | TI | BQ25185DLHR | selected_for_EVT | DLH WSON10+EP | https://www.ti.com/lit/ds/symlink/bq25185.pdf |  |  | 2026-11-08 | 24k selects4.2V/input100mA;3k ISET target100mA
U8 | Newhaven Display | NHD-C0216CiZ-FSW-FBW-3V3 | selected_for_EVT | 1.5mm pins plus separate LED leads | https://newhavendisplay.com/content/specs/NHD-C0216CiZ-FSW-FBW-3V3.pdf |  |  | 2026-11-08 | 16x2 I2C white LED;3.0V logic; physical sample fit pending
U10 | TI | TPS3702CX33DDCR | selected_for_EVT | TSOT23-6 | https://www.ti.com/lit/ds/symlink/tps3702.pdf |  |  | 2026-11-08 | Open-drain UV/OV; SET high3.17/3.43V nominal; delay and fault coverage unmeasured
U13 | Microchip | MCP1700T-3002E/TT | selected_for_EVT | SOT23-3 | https://ww1.microchip.com/downloads/en/DeviceDoc/MCP1700-Data-Sheet-20001826F.pdf |  |  | 2026-11-08 | 3.0V always-on VBAT/tamper; backup injection/leakage tests pending
BAT1 | Adafruit | 1578 | selected_for_EVT | Protected500mAh29x36x4.75mm;JST PH2;separate10k NTC | https://www.adafruit.com/product/1578 |  |  | 2026-11-08 | Source-defined pack; availability not reserved; measure connector polarity; add insulated103AT-2 directly on pouch
Y1 | Abracon | ABS07-32.768KHZ-6-T | selected_for_EVT | 3215 2pad | https://abracon.com/Support/32khz-ultimate-solutions.pdf |  |  | 2026-11-08 | LSE tamper clock; actual load/startup/drive unqualified
U14 | Texas Instruments | TPS259470LRPWR | selected_for_EVT | RPW0010A VQFN-HR10 2x2 | https://www.ti.com/lit/ds/symlink/tps25947.pdf |  |  | 2026-11-08 | Independent adjustable input OVLO; true reverse blocking; EN divider/clamp. DC math only; startup/OV/fault thermal tests pending
D4 | Nexperia | BZT52-C5V1,115 | selected_for_EVT | SOD123 | https://www.nexperia.com/products/diodes/zener-diodes/serie/bzt52-c-series/ |  |  | 2026-11-08 | EN/UVLO clamp; leakage/temperature and actual supplier curve require qualification
D5 | Littelfuse | SMF16A | selected_for_EVT | SOD123F | https://www.mouser.com/datasheet/2/240/Littelfuse_TVS_Diode_SMF_Datasheet.pdf-1698977.pdf |  |  | 2026-11-08 | Input TVS after PPTC;26V datasheet pulse clamp is not a whole-device surge guarantee; qualify energy/layout/temperature
NTC1/J6 | Semitec | 103AT-2 | selected_for_EVT | 10k B3435;separate JST SH2 factory crimp harness | https://www.semitec-global.com/products/thermistor/at-thermistor/ |  |  | 2026-11-08 | Insulated thermal contact to cell; ambient-only or fixed resistor prohibited
C1 | KEMET | C1206C102KGRACTU | selected_for_EVT | 1206;1nF2kV X7R10percent | https://search.kemet.com/download/specsheet/C1206C102KGRACTU |  |  | 2026-11-08 | Source voltage rating; system ESD qualification still required
L1 | Sunlord | SWPA3015S1R5MT | selected_for_EVT | 3.0x3.0x1.5mm1.5uH;KiCad SWPA3015S | https://www.lcsc.com/product-detail/C83434.html |  |  | 2026-11-08 | Datasheet/supplier confirm current and saturation at temperature before purchasing
U15 | Texas Instruments | SN74LVC1G07DCKR | selected_for_EVT | SC70-5 open-drain LCD reset buffer | https://www.ti.com/lit/ds/symlink/sn74lvc1g07.pdf |  |  | 2026-11-08 | NRST independently pulls LCD reset low;R43 pulls up to LCD3V0;PC3 open-drain only
