Jay-Void-BA/OpenKeys/hardware/BOM.csv

ref | value | footprint | sheet | dnp | note
J1 | USB-A male (plug) | OpenKeys:USB_A_Plug_THT_PENDING | 01-usb | False | Exact plug mechanical footprint is a fabrication blocker
J2 | USB-C USB2 receptacle | Connector_USB:USB_C_Receptacle_HRO_TYPE-C-31-M-12 | 01-usb | False | HRO TYPE-C-31-M-12; verify actual connector drawing and mating envelope in EVT
U1 | TS3USB30EDGSR | Package_SO:VSSOP-10_3x3mm_P0.5mm | 01-usb | False
U2 | USBLC6-2SC6 | Package_TO_SOT_SMD:SOT-23-6 | 01-usb | False
U3 | USBLC6-2SC6 | Package_TO_SOT_SMD:SOT-23-6 | 01-usb | False
R1 | 5.1k 1% | Resistor_SMD:R_0603_1608Metric | 01-usb | False
R2 | 5.1k 1% | Resistor_SMD:R_0603_1608Metric | 01-usb | False
R3 | 100k | Resistor_SMD:R_0603_1608Metric | 01-usb | False
R4 | 100k | Resistor_SMD:R_0603_1608Metric | 01-usb | False
R5 | 1M | Resistor_SMD:R_0603_1608Metric | 01-usb | False
C1 | 1nF / 2kV | Capacitor_SMD:C_0603_1608Metric | 01-usb | False
Q1 | 2N7002 | Package_TO_SOT_SMD:SOT-23 | 01-usb | False
R6 | 100k | Resistor_SMD:R_0603_1608Metric | 01-usb | False
R7 | 1M | Resistor_SMD:R_0603_1608Metric | 01-usb | False
Q2 | 2N7002 | Package_TO_SOT_SMD:SOT-23 | 01-usb | False
R8 | 100k | Resistor_SMD:R_0603_1608Metric | 01-usb | False
R9 | 1M | Resistor_SMD:R_0603_1608Metric | 01-usb | False
C2 | 100nF | Capacitor_SMD:C_0603_1608Metric | 01-usb | False
D1 | SMF5.0A | Diode_SMD:D_SOD-123F | 01-usb | False
D2 | SMF5.0A | Diode_SMD:D_SOD-123F | 01-usb | False
D3 | PESD5V0S1BA | Diode_SMD:D_SOD-323 | 01-usb | False
D4 | PESD5V0S1BA | Diode_SMD:D_SOD-323 | 01-usb | False
F1 | 250mA hold - verify trip | Fuse:Fuse_1206_3216Metric | 02-power | False
F2 | 250mA hold - verify trip | Fuse:Fuse_1206_3216Metric | 02-power | False
U4 | TPS2116DRL | Package_TO_SOT_SMD:SOT-583-8 | 02-power | False
R10 | 300k 1% | Resistor_SMD:R_0603_1608Metric | 02-power | False
R11 | 100k 1% | Resistor_SMD:R_0603_1608Metric | 02-power | False
R12 | 100k | Resistor_SMD:R_0603_1608Metric | 02-power | False
U5 | BQ24074RGT | Package_DFN_QFN:VQFN-16-1EP_3x3mm_P0.5mm_EP1.6x1.6mm | 02-power | False
J3 | Protected 1S 200mAh + 10k NTC | Connector_JST:JST_PH_S3B-PH-K_1x03_P2.00mm_Horizontal | 02-power | False | NTC must be in cell pack; protection must include over/under-voltage and overcurrent
R13 | 8.87k 1% | Resistor_SMD:R_0603_1608Metric | 02-power | False | About 100 mA fast-charge; verify actual pack rating
R14 | 7.5k 1% | Resistor_SMD:R_0603_1608Metric | 02-power | False
R15 | 100k | Resistor_SMD:R_0603_1608Metric | 02-power | False
Q3 | 2N7002 | Package_TO_SOT_SMD:SOT-23 | 02-power | False
R16 | 100k | Resistor_SMD:R_0603_1608Metric | 02-power | False
R17 | 100k | Resistor_SMD:R_0603_1608Metric | 02-power | False
R18 | 100k | Resistor_SMD:R_0603_1608Metric | 02-power | False
C3 | 1uF 10V | Capacitor_SMD:C_0603_1608Metric | 02-power | False
C4 | 1uF 10V | Capacitor_SMD:C_0603_1608Metric | 02-power | False
C5 | 4.7uF 10V | Capacitor_SMD:C_0603_1608Metric | 02-power | False
C6 | 10uF 6.3V | Capacitor_SMD:C_0603_1608Metric | 02-power | False
C7 | 10uF 10V | Capacitor_SMD:C_0603_1608Metric | 02-power | False
SW1 | OFF / ON | Button_Switch_SMD:SW_SPDT_CK_JS102011SAQN | 02-power | False
U6 | TPS63031DSK (3.3 V) | Package_SON:WSON-10-1EP_2.5x2.5mm_P0.5mm_EP1.2x2mm | 02-power | False
R19 | 0R | Resistor_SMD:R_0603_1608Metric | 02-power | False
L1 | 1.5uH Isat>=1.5A | Inductor_SMD:L_Taiyo-Yuden_MD-3030 | 02-power | False
C8 | 10uF 10V | Capacitor_SMD:C_0603_1608Metric | 02-power | False
C9 | 100nF | Capacitor_SMD:C_0603_1608Metric | 02-power | False
C10 | 10uF 6.3V | Capacitor_SMD:C_0603_1608Metric | 02-power | False
C11 | 10uF 6.3V | Capacitor_SMD:C_0603_1608Metric | 02-power | False
C12 | 100nF | Capacitor_SMD:C_0603_1608Metric | 03-mcu | False
C13 | 100nF | Capacitor_SMD:C_0603_1608Metric | 03-mcu | False
C14 | 100nF | Capacitor_SMD:C_0603_1608Metric | 03-mcu | False
C15 | 100nF | Capacitor_SMD:C_0603_1608Metric | 03-mcu | False
C16 | 4.7uF | Capacitor_SMD:C_0603_1608Metric | 03-mcu | False
C17 | 4.7uF low ESR | Capacitor_SMD:C_0603_1608Metric | 03-mcu | False
C18 | 100nF | Capacitor_SMD:C_0603_1608Metric | 03-mcu | False
C19 | 1uF | Capacitor_SMD:C_0603_1608Metric | 03-mcu | False
FB1 | 600R@100MHz | Inductor_SMD:L_0603_1608Metric | 03-mcu | False
R20 | 10k | Resistor_SMD:R_0603_1608Metric | 03-mcu | False
C20 | 100nF | Capacitor_SMD:C_0603_1608Metric | 03-mcu | False
R21 | 10k | Resistor_SMD:R_0603_1608Metric | 03-mcu | False
J4 | Cortex SWD - DNP production | Connector_PinHeader_1.27mm:PinHeader_2x05_P1.27mm_Vertical | 03-mcu | True
U7 | STM32U585RIT6 | Package_QFP:LQFP-64_10x10mm_P0.5mm | 03-mcu | False | No PB11 on LQFP64; PC2=SPI2_MISO AF5, PB14=I2C2_SDA AF4
U8 | SE050E2HQ1/Z01Z3Z | OpenKeys:SE050_SOT1969-1_HX2QFN20 | 04-se-storage-rtc | False | Deep-power-down topology. VOUT powers VCC, never connect VOUT to +3V3
U9 | W25Q64JVSSIQ | Package_SO:SOIC-8_5.3x5.3mm_P1.27mm | 04-se-storage-rtc | False
U10 | RV-3028-C7 | Package_SON:MicroCrystal_C7_SON-8_1.5x3.2mm_P0.9mm | 04-se-storage-rtc | False
R22 | 4.7k | Resistor_SMD:R_0603_1608Metric | 04-se-storage-rtc | False
R23 | 4.7k | Resistor_SMD:R_0603_1608Metric | 04-se-storage-rtc | False
R24 | 100k | Resistor_SMD:R_0603_1608Metric | 04-se-storage-rtc | False
R25 | 47k | Resistor_SMD:R_0603_1608Metric | 04-se-storage-rtc | False
R26 | 4.7k | Resistor_SMD:R_0603_1608Metric | 04-se-storage-rtc | False
R27 | 4.7k | Resistor_SMD:R_0603_1608Metric | 04-se-storage-rtc | False
R28 | 47k | Resistor_SMD:R_0603_1608Metric | 04-se-storage-rtc | False
R29 | 47k | Resistor_SMD:R_0603_1608Metric | 04-se-storage-rtc | False
R30 | 47k | Resistor_SMD:R_0603_1608Metric | 04-se-storage-rtc | False
R31 | 47k | Resistor_SMD:R_0603_1608Metric | 04-se-storage-rtc | False
R32 | 47k | Resistor_SMD:R_0603_1608Metric | 04-se-storage-rtc | False
C21 | 100nF | Capacitor_SMD:C_0603_1608Metric | 04-se-storage-rtc | False
C22 | 100nF | Capacitor_SMD:C_0603_1608Metric | 04-se-storage-rtc | False
C23 | 1uF | Capacitor_SMD:C_0603_1608Metric | 04-se-storage-rtc | False
C24 | 100nF | Capacitor_SMD:C_0603_1608Metric | 04-se-storage-rtc | False
C25 | 100nF | Capacitor_SMD:C_0603_1608Metric | 04-se-storage-rtc | False
U11 | FM11NC08S (DFN10 + EP) | OpenKeys:FM11NC08S_DFN10_PENDING | 05-nfc | False | Fudan official pin map, EP must be checked against orderable package drawing
J5 | 13.56MHz PCB loop / fixture | OpenKeys:NFC_LOOP_PENDING | 05-nfc | False | Provisional RF window 38x18mm; coil geometry/tuning not released
C26 | 100nF | Capacitor_SMD:C_0603_1608Metric | 05-nfc | False
C27 | 1uF | Capacitor_SMD:C_0603_1608Metric | 05-nfc | False
C28 | 100nF 10V | Capacitor_SMD:C_0603_1608Metric | 05-nfc | False
C29 | DNP C0G tune | Capacitor_SMD:C_0603_1608Metric | 05-nfc | True
R33 | 47k | Resistor_SMD:R_0603_1608Metric | 05-nfc | False
R34 | 47k | Resistor_SMD:R_0603_1608Metric | 05-nfc | False
J6 | OLED 128x64 I2C / SSD1306 | Connector_PinHeader_2.54mm:PinHeader_1x04_P2.54mm_Vertical | 06-trusted-ui | False | Pick exact display and confirm pin order, supply and logic voltage
J7 | FPC2534AM / FH12-12S-0.5SH(55) | Connector_FFC-FPC:Hirose_FH12-12S-0.5SH_1x12-1MP_P0.50mm_Horizontal | 06-trusted-ui | False | Target module 100026230: 0.5mm, 0.3mm bottom-contact flex; verify contact orientation on EVT; key provisioning + SE persistent operation tags required
FB2 | 600R@100MHz | Inductor_SMD:L_0603_1608Metric | 06-trusted-ui | False
C30 | 1uF | Capacitor_SMD:C_0603_1608Metric | 06-trusted-ui | False
C31 | 100nF | Capacitor_SMD:C_0603_1608Metric | 06-trusted-ui | False
C32 | 10uF | Capacitor_SMD:C_0603_1608Metric | 06-trusted-ui | False
C33 | 100nF | Capacitor_SMD:C_0603_1608Metric | 06-trusted-ui | False
R35 | 47k | Resistor_SMD:R_0603_1608Metric | 06-trusted-ui | False
R36 | 100k | Resistor_SMD:R_0603_1608Metric | 06-trusted-ui | False
R37 | 100k | Resistor_SMD:R_0603_1608Metric | 06-trusted-ui | False
SW2 | UP | Button_Switch_SMD:SW_SPST_TL3342 | 06-trusted-ui | False
R38 | 47k | Resistor_SMD:R_0603_1608Metric | 06-trusted-ui | False
C34 | 10nF | Capacitor_SMD:C_0603_1608Metric | 06-trusted-ui | False
SW3 | DOWN | Button_Switch_SMD:SW_SPST_TL3342 | 06-trusted-ui | False
R39 | 47k | Resistor_SMD:R_0603_1608Metric | 06-trusted-ui | False
C35 | 10nF | Capacitor_SMD:C_0603_1608Metric | 06-trusted-ui | False
SW4 | CONFIRM | Button_Switch_SMD:SW_SPST_TL3342 | 06-trusted-ui | False
R40 | 47k | Resistor_SMD:R_0603_1608Metric | 06-trusted-ui | False
C36 | 10nF | Capacitor_SMD:C_0603_1608Metric | 06-trusted-ui | False
SW5 | CANCEL | Button_Switch_SMD:SW_SPST_TL3342 | 06-trusted-ui | False
R41 | 47k | Resistor_SMD:R_0603_1608Metric | 06-trusted-ui | False
C37 | 10nF | Capacitor_SMD:C_0603_1608Metric | 06-trusted-ui | False
SW6 | CASE CLOSED | Button_Switch_SMD:SW_SPST_TL3342 | 06-trusted-ui | False
R42 | 47k | Resistor_SMD:R_0603_1608Metric | 06-trusted-ui | False
C38 | 10nF | Capacitor_SMD:C_0603_1608Metric | 06-trusted-ui | False
