Jay-Void-BA/OpenKeys/hardware/r05/review/placement.csv

ref | x_mm | y_mm | rotation_deg | side | dnp
BT1 | 71.75 | 100.0 | 0.0 | B | False
C1 | 53.5 | 11.0 | 0.0 | B | False
C10 | 54.75 | 14.825 | 90.0 | B | False
C11 | 59.175 | 27.75 | 0.0 | B | False
C12 | 45.25 | 33.175 | -90.0 | B | False
C13 | 49.55 | 33.175 | -90.0 | B | False
C14 | 41.0 | 26.0 | 0.0 | B | False
C15 | 52.75 | 14.825 | 90.0 | B | False
C16 | 47.25 | 33.175 | -90.0 | B | False
C17 | 40.825 | 21.75 | 180.0 | B | False
C18 | 52.5 | 32.0 | 0.0 | B | False
C19 | 41.5 | 20.0 | 0.0 | B | False
C2 | 13.0 | 20.0 | 0.0 | B | False
C20 | 50.0 | 16.0 | 0.0 | B | False
C21 | 41.5 | 24.0 | 0.0 | B | False
C22 | 88.0 | 56.0 | 0.0 | F | False
C23 | 80.5 | 62.0 | 0.0 | F | False
C24 | 87.5 | 62.0 | 0.0 | F | False
C25 | 80.0 | 54.0 | 0.0 | F | False
C26 | 28.5 | 51.0 | 0.0 | F | False
C27 | 29.0 | 49.0 | 0.0 | F | False
C28 | 27.0 | 56.0 | 0.0 | F | False
C29 | 29.0 | 47.0 | 0.0 | F | False
C3 | 13.0 | 17.5 | 0.0 | B | False
C30 | 42.0 | 52.0 | 0.0 | F | False
C31 | 60.0 | 52.0 | 0.0 | F | False
C32 | 76.0 | 59.0 | -90.0 | F | False
C33 | 42.0 | 66.0 | 0.0 | F | False
C34 | 60.0 | 66.0 | 0.0 | F | False
C35 | 78.0 | 66.0 | 0.0 | F | False
C36 | 42.0 | 80.0 | 0.0 | F | False
C37 | 60.0 | 80.0 | 0.0 | F | False
C38 | 76.0 | 84.0 | 0.0 | F | False
C39 | 60.0 | 94.0 | 0.0 | F | False
C4 | 9.0 | 20.0 | 0.0 | B | False
C40 | 38.25 | 35.25 | -90.0 | B | False
C41 | 42.0 | 31.25 | -90.0 | B | False
C42 | 72.5 | 23.5 | 0.0 | B | False
C43 | 67.5 | 27.5 | 0.0 | B | False
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
U27 | 45.0 | 103.0 | 0.0 | F | False
U28 | 37.25 | 26.25 | -90.0 | F | False
U3 | 20.0 | 25.0 | 0.0 | B | False
U4 | 50.0 | 24.0 | 0.0 | B | False
U5 | 84.0 | 55.0 | 0.0 | F | False
U6 | 84.0 | 81.0 | 0.0 | F | False
U7 | 25.0 | 51.0 | -90.0 | F | False
Y1 | 60.0 | 22.5 | 90.0 | B | False
