Jay-Void-BA/OpenKeys/hardware/r05/exports/OpenKeys-base.stl

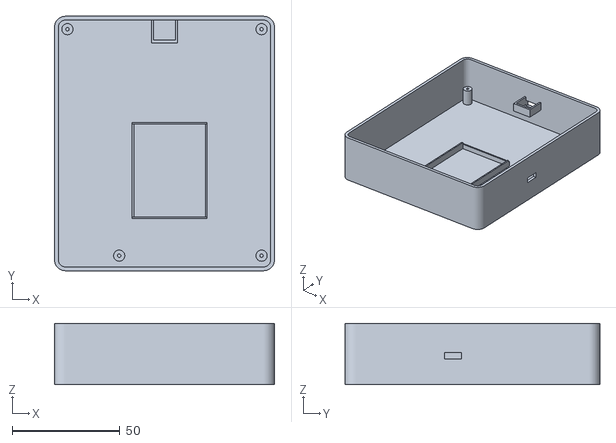
[picture p8: CAD file, 2026-11-14]
hardware/r05/exports/OpenKeys-base.stl
102.0 x 118.0 x 28.4
