Jay-Void-BA/OpenKeys/hardware/r05/exports/OpenKeys-PCB.step

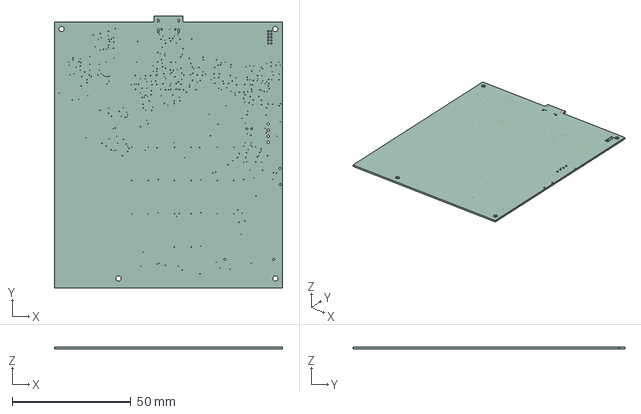
[picture p9: CAD file, 2026-11-14]
hardware/r05/exports/OpenKeys-PCB.step
96.0 x 114.5 x 0.91 mm
