Jay-Void-BA/OpenKeys/hardware/r05/exports/OpenKeys-retainer.stl

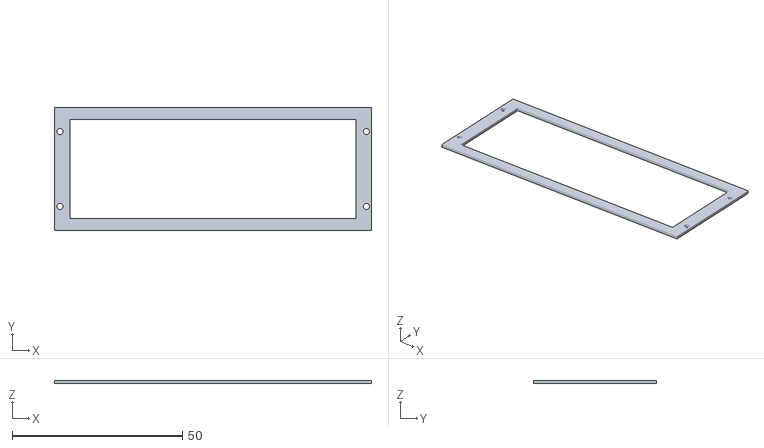
[picture p10: CAD file, 2026-11-14]
hardware/r05/exports/OpenKeys-retainer.stl
93.1 x 36.0 x 1.00
