Jay-Void-BA/OpenKeys/hardware/r05/exports/OpenKeys-lid.stl

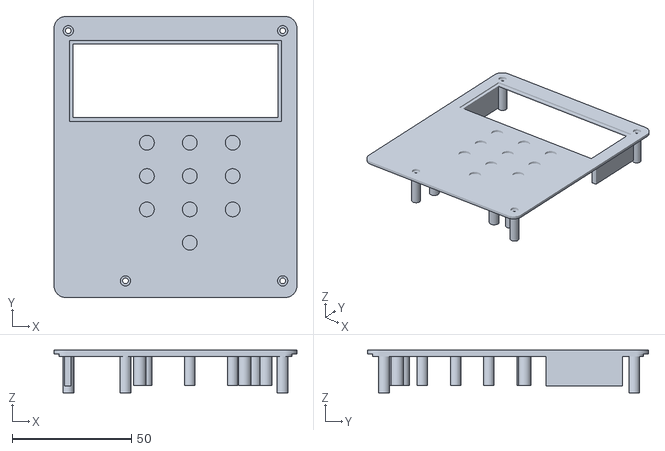
[picture p11: CAD file, 2026-11-14]
hardware/r05/exports/OpenKeys-lid.stl
102.0 x 118.0 x 18.0
