Jay-Void-BA/OpenKeys/hardware/r05/exports/OpenKeys-plungers.stl

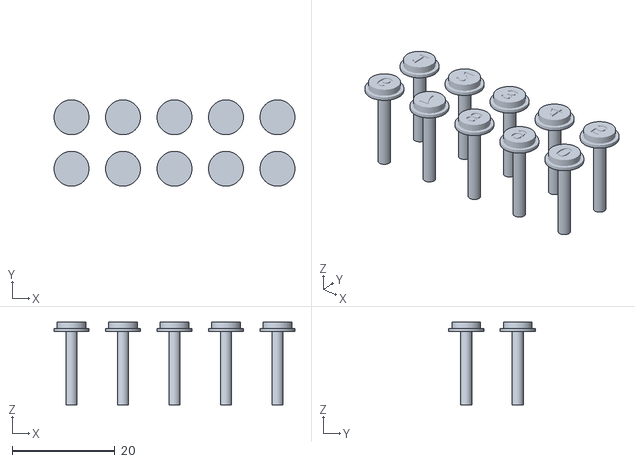
[picture p12: CAD file, 2026-11-14]
hardware/r05/exports/OpenKeys-plungers.stl
46.8 x 16.8 x 16.1
