Jay-Void-BA/OpenKeys/hardware/exports/OpenKeys-plungers.stl

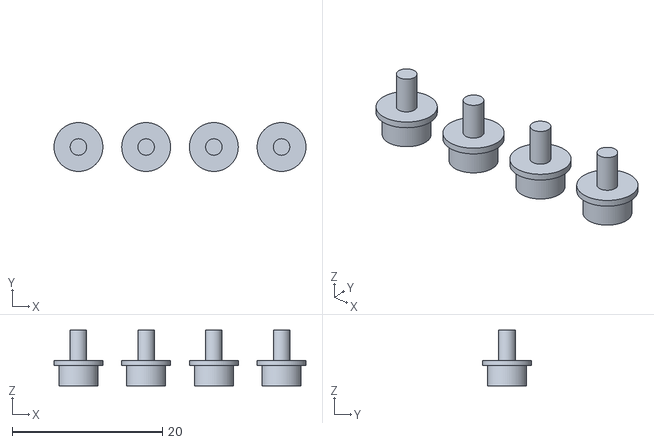
[picture p13: CAD file, 2026-11-08, an earlier design]
hardware/exports/OpenKeys-plungers.stl
33.5 x 6.50 x 7.40
