Jay-Void-BA/OpenKeys/hardware/r03/exports/OpenKeys-base.stl

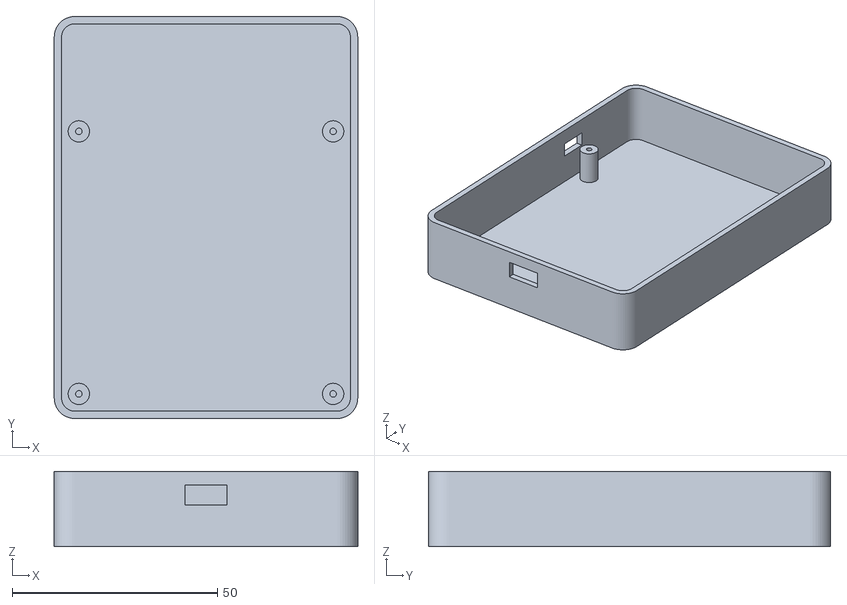
[picture p14: CAD file, 2026-11-08, an earlier design]
hardware/r03/exports/OpenKeys-base.stl
74.0 x 98.0 x 18.4
