Jay-Void-BA/OpenKeys/hardware/r04/exports/OpenKeys-PCB.step

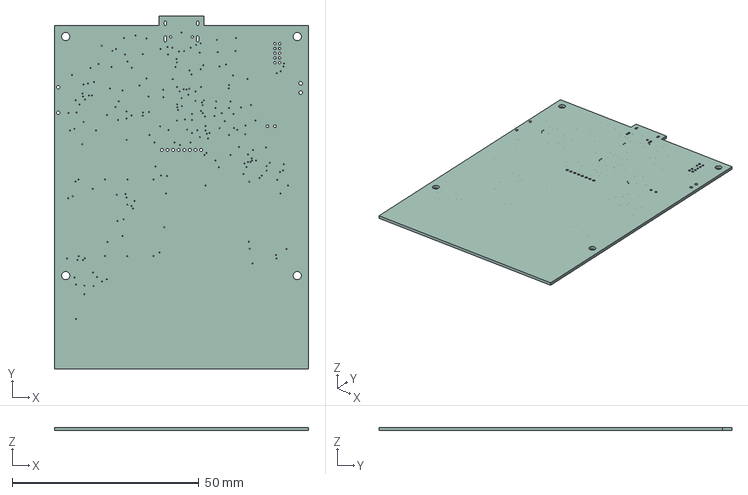
[picture p15: CAD file, 2026-11-08, an earlier design]
hardware/r04/exports/OpenKeys-PCB.step
68.0 x 94.5 x 0.91 mm
