Jay-Void-BA/OpenKeys/hardware/exports/OpenKeys-lid.stl

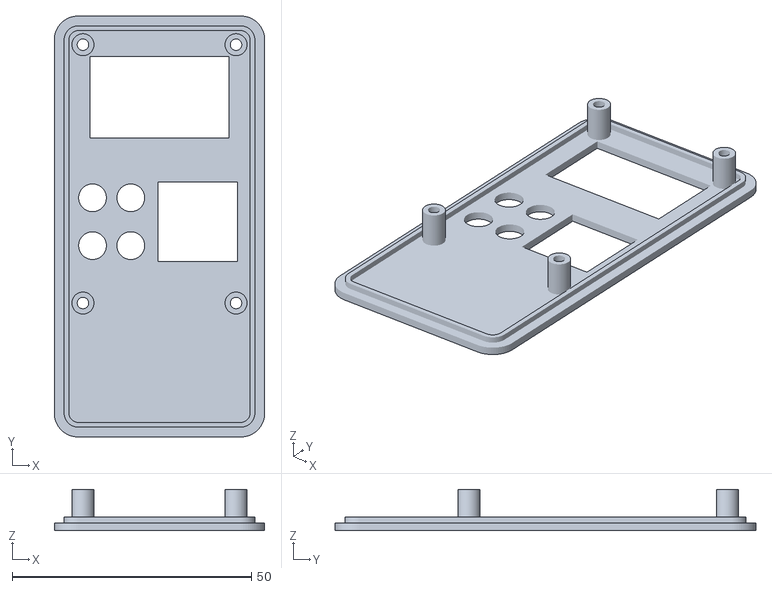
[picture p16: CAD file, 2026-11-08, an earlier design]
hardware/exports/OpenKeys-lid.stl
44.0 x 88.0 x 8.60
