Jay-Void-BA/OpenKeys/hardware/r04/exports/OpenKeys-plungers.stl

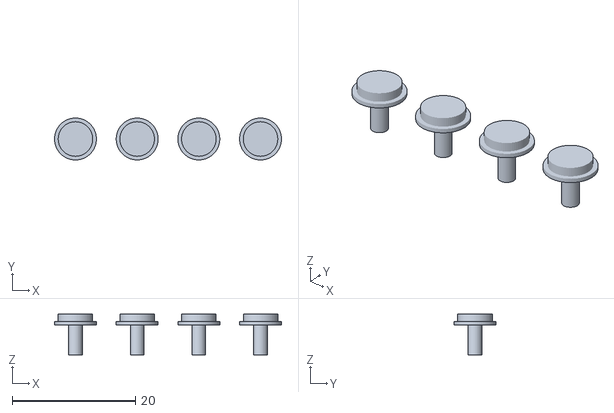
[picture p18: CAD file, 2026-11-08, an earlier design]
hardware/r04/exports/OpenKeys-plungers.stl
36.8 x 6.80 x 6.61
