Jay-Void-BA/OpenKeys/hardware/exports/OpenKeys-base.stl

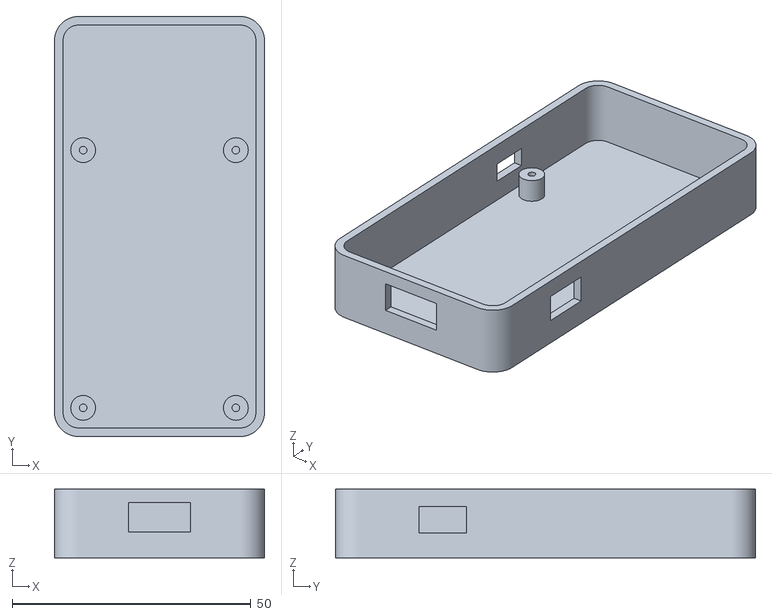
[picture p19: CAD file, 2026-11-08, an earlier design]
hardware/exports/OpenKeys-base.stl
44.0 x 88.0 x 14.4
