Jay-Void-BA/OpenKeys/hardware/r03/exports/OpenKeys-plungers.stl

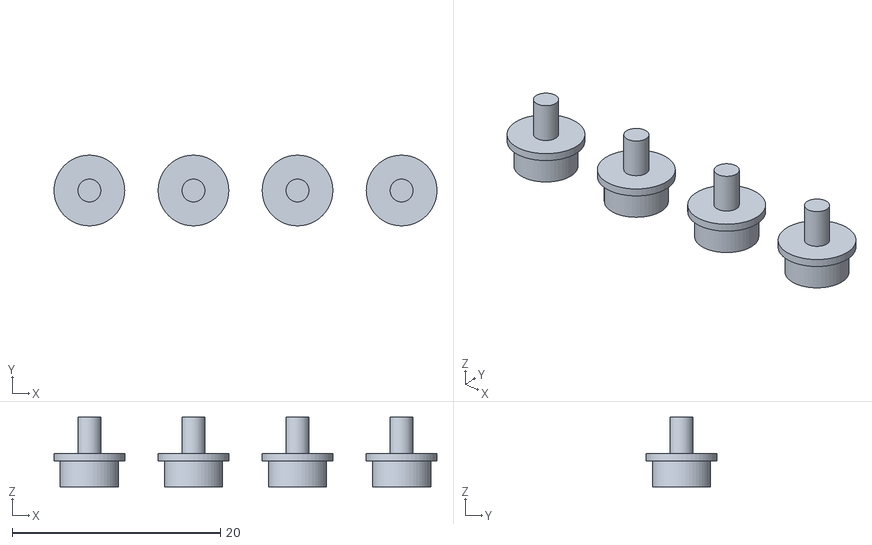
[picture p20: CAD file, 2026-11-08, an earlier design]
hardware/r03/exports/OpenKeys-plungers.stl
36.8 x 6.80 x 6.70
