Jay-Void-BA/OpenKeys/hardware/r04/exports/OpenKeys-lid.stl

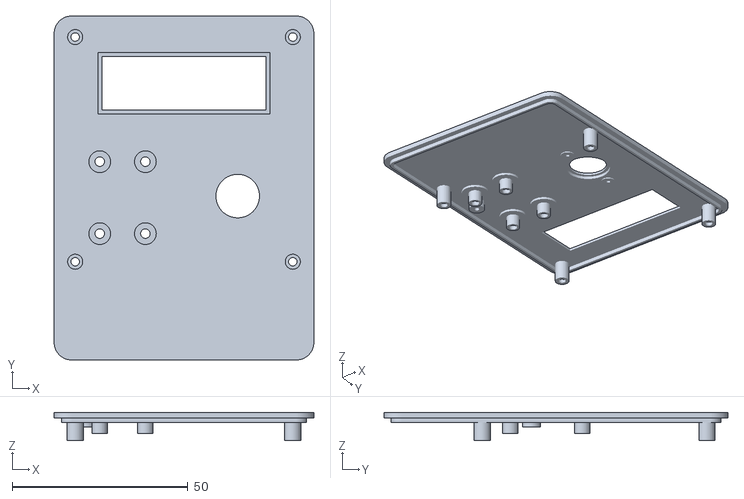
[picture p21: CAD file, 2026-11-08, an earlier design]
hardware/r04/exports/OpenKeys-lid.stl
74.0 x 98.0 x 8.00
