Jay-Void-BA/OpenKeys/hardware/r04/exports/OpenKeys-base.stl

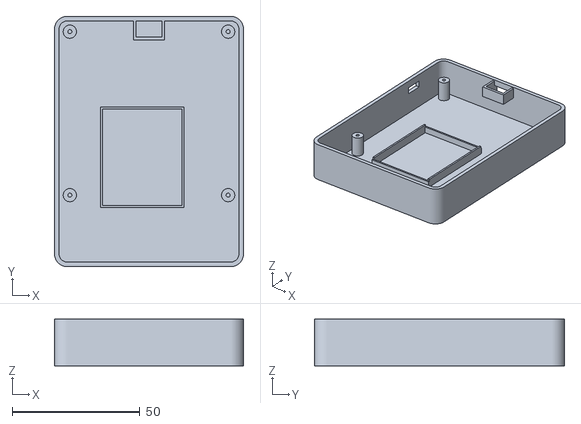
[picture p22: CAD file, 2026-11-08, an earlier design]
hardware/r04/exports/OpenKeys-base.stl
74.0 x 98.0 x 18.4
