Jay-Void-BA/OpenKeys/hardware/r04/exports/OpenKeys-retainer.stl

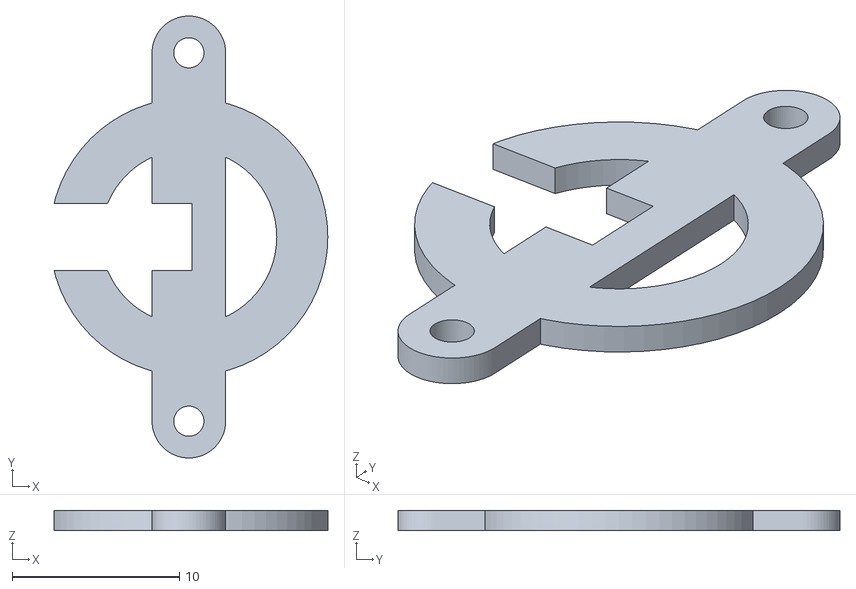
[picture p23: CAD file, 2026-11-08, an earlier design]
hardware/r04/exports/OpenKeys-retainer.stl
16.3 x 26.4 x 1.20
