Jay-Void-BA/OpenKeys/(list of files, cad)

Other CAD files:
hardware/mechanical/OpenKeys.scad
hardware/r04/mechanical/enclosure.scad
hardware/mechanical/OpenKeys-assembly.blend
hardware/r03/mechanical/OpenKeys-assembly.blend
hardware/r04/mechanical/OpenKeys-assembly.blend
