Jay-Void-BA/OpenKeys/manufacturing/REQUEST_FOR_CONFIRMATION.md

# 个人、小批量委托确认模板

[制造入口](README.md) · [候选与公开证据](MAINLAND_SUPPLIERS_AND_LABS.md) · [R05 制作与验收](BUILD_R05_ZH.md)

以下是 **2026-11-13 更新的 R05 经典版未发送稿**。2026-11-10 实际发出的是旧 R04 指纹版询问，
其回信与后续记录见[联系状态](OUTREACH_STATUS.md)。SGS Brightsight 已明确不接个人且询问已撤回，
不列为本稿的默认收件方。本轮没有发送新版邮件、追加附件或下单。

供评审的固定源码：[665c0a3](https://github.com/Jay-Void-BA/OpenKeys/tree/665c0a3d807ad49942cd228ba99b3c77d773179c)。
PCB SHA-256：`8e9d3e61d21afd76e613611d21ebfb939d797c794edf4927300f5d9421142efd`。
当前为工程候选；完整生产 Root、初始化 / 擦除、协议 / 管理器接线和电量采集尚未交付。
不能把 CAD 检查、模型测试或诊断镜像描述为已可生产的认证器。先确认个人和小数量受理，再提供正式附件。

## 发给工厂

**主题：个人 OpenKeys 经典版——3 把 USB-C/NFC、六位 PIN 十键认证器工程装配可否受理**

您好，我以个人名义自制 3 把开源认证器，无公司营业执照，希望先做工程审核与首块样板，验证修订后再完成其余设备。请先逐项确认：

1. 能否与个人签约、接受个人付款，并交付个人抬头的合同 / 发票或收款凭证？是否必须企业 / 学校主体？
2. 能否只装配 3 把？裸板、贴片、后焊 / 整机装配各自 MOQ 是多少？若裸板最少 5 片，可否只装 3 片并退回余板，不多购昂贵模块？
3. 是否接受四层 96×112×1mm 板体、含 USB 舌部包络 96×114.5mm、169 个 BOM 位置及工程边审核？主件为 STM32H573RIT6、SE051C2HQ1/Z01XDZ（OEF A8FA / Applet7.2）、DFRobot DFR0555 V1.1 蓝底白字双行 LCD、十个数字键、保护型 1S 500mAh 电池及真实贴芯 NTC；无指纹、无 SM2 / PQC。
4. 是否接受 SE / LCD 客供、双面 SMT、QFN 底焊盘检查、内部 LCD / 电池 / NTC 线束后焊、十键检查、防拆触点、102×118×30mm 非金属壳试装、限流首板上电和逐台测试？请说明不能承接的部分及分包。J4 是板上铜天线，J3 为 DNP；不自动采购或焊上它们。
5. 请分列 DFM、钢网 / 工程费、PCB、元件 / MOQ 损耗、装配、治具、测试、返工、税运、排期和报价有效期，并说明大陆生产主体与地点。

项目公开源码：https://github.com/Jay-Void-BA/OpenKeys 。请按上面的固定版本及 [R05 制作说明](BUILD_R05_ZH.md)审核，勿沿用旧指纹版 68×92mm / 130 位置资料。完整生产固件未完成，本次仅询工程装配资格与费用。后续附件绑定具体提交及摘要；不允许擅自替换芯片、LCD、NTC 或互锁器件，缺少完整 MPN 的通用阻容须列为待工程选料项。

安全配对与密钥注入是独立受控工序。普通代焊不提供生产密钥、真实 PIN 或恢复码。最终三把与工程首件 / 损耗 / 破坏试验样品分别列数、列价，不自行增加采购量。请回复“可以 / 不可以 / 需要补充信息”并指出条件，不仅回复通用能力介绍。

## 发给实验室

**主题：个人 OpenKeys 经典版——3 把 PIN 认证器的安全预评估与 SCA/FI 项目可否受理**

您好，我以个人名义开发三把自用的 USB-C/NFC、六位本地 PIN / 十键认证器，无公司 / 高校委托主体。已取消指纹。希望先做架构 / 源码预评估，再对固定版本工程样板开展专项测试与修复复测。请先逐项确认：

1. 能否接受个人签约、付款和报告抬头？是否需要营业执照、企业 / 高校介绍信、认证申请主体或最低年框？
2. 是否接受此类一次性研发项目，可否先只做预评估 / 工程摸底，不购买完整认证套餐？最低项目费用和最少计费工时是多少？
3. 三把是最终日用设备数量，不是破坏试验样品上限。请分别给出架构评审、SCA / FI、EMC 所需完整样机、牺牲板、治具与对照样本；如需额外板，请先报价。本版无指纹，不报价 FAR / FRR / PAD。
4. 哪些范围可由大陆本实验室完成，哪些需分包？请列实际签约主体、测试地点、认可范围、交付报告类型及可提供的原始证据。
5. 请分别报价各专项、最低费 / 最少计费工时、复测、税运、样品返还 / 销毁、排期和有效期。仅使用测试密钥和合成账户，不要求生产私钥、真实 PIN 或恢复码。

需要评审的目标包括：启动 / 签名更新 / 防降级 / 调试，MCU / SE 原生 PIN / 键盘 / 显示的可信路径，六位首次 PIN 设置、第 11 次完整错误或更改硬件 PIN 后全清空，独立协议 PIN 与配对会话 30 秒租约；FIDO2 / U2F / hmac-secret、OpenPGP / PIV / SSH、只在 LCD 显示六位结果的 TOTP / HOTP、**加密 notes / recovery codes 与桌面 / NFC 管理通道**。当前尚有软件缺口，请把设计预审、已实现代码和未来实机功能测试分开列项，不能把未实现功能当作已测通过。

物理范围包括功耗 / EM 侧信道，SYS / MCU / VCAP / SE 分域电压与时钟 / EM 故障，PIN / 重试账本 / 原生 SID 与 SCP03，防拆 / 总线探针 / 接口旁路，USB 无电池供电、LCD 切电残留 / 硬件延时，NFC 离场 / 重选 / 断连撤权，以及 ESD / 抗扰。测试预算、正负对照和轨迹数量请按专项提出；TVLA 无显著泄漏不等于不能恢复密钥。

希望报告明确实际版本 / 配置、测试预算、正负对照、失败判据、原始波形与未覆盖项。一般 FIDO 认证若不覆盖 notes / 管理器，请单列独立评估范围。项目仍在开发，不申请把当前诊断镜像认证为成品。

项目公开源码：https://github.com/Jay-Void-BA/OpenKeys 。请回复各项是否受理及限制；通用服务页或“可以咨询”不能代替个人与数量确认。

## 收到回复后记录

| 字段 | 填写内容 |
|---|---|
| 机构 / 实际签约主体 | 完整名称及大陆履约地点 |
| 业务联系人 | 私下保存；公开版本按需脱敏 |
| 个人委托 / 付款 / 报告 | 明确“接受”或“不接受”，附条件 |
| 数量 | 裸板 / 装配 MOQ，或各测试所需完整机 / 牺牲板数量 |
| 范围与交付物 | 本地 / 分包范围、报告、原始证据及复测 |
| 费用 / 有效期 | 最低费、一次性费、税运与报价到期日 |
| 确认日期与证据编号 | 邮件 / 报价 / 合同的私有编号，公开脱敏摘要 |
| 结论 | 待确认 / 不符合 / 本项目已确认；仅在必需项明确后升级状态 |

不要把身份证、私人邮箱 / 电话、付款信息或合同原件提交公开 GitHub。未经取得并核对回复，候选清单维持“待确认”。
