Jay-Void-BA/OpenKeys/manufacturing/OUTREACH_STATUS.md

# 个人、小批量接单询问状态

[制造入口](README.md) · [候选与公开证据](MAINLAND_SUPPLIERS_AND_LABS.md) · [确认模板](REQUEST_FOR_CONFIRMATION.md)

**2026-11-10，经用户授权，使用已连接的 iCloud Mail 向 2 家工厂、3 家实验室分别提交了资格询问信。** 每封单独发送，无抄送、无附件；只提供公开项目链接、固定工程版本和受理问题。未下单，也未授权付费服务。

**2026-11-13 已复核相关 iCloud 发件与回信。** 下表保留首次提交记录；当前结论见后面的回信表。
历史询问绑定 R04 指纹版 `9675cc330b10a74800e0c0edd0cd7866f888b648`，不能作为当前
R05 经典版六位 PIN、十键、SE051C2、169 BOM 的接单确认。新版[询问稿](REQUEST_FOR_CONFIRMATION.md)
已经更新，**本轮只读取相关邮件，没有发送新版邮件、附件或下单**。

## 已提交的询问

时间均为 UTC。公开记录不披露个人发件地址、Message-ID 或邮箱内部标识。

| 机构 | 角色与询问重点 | 提交时间 | iCloud 状态 | 接单状态 |
|---|---|---|---|---|
| Seeed Fusion | 工厂：个人合同、仅装 3 把、客供模块及整机后焊 | 03:53:50 | 已接受，已保存发件副本 | 已回信询问数量，接单待确认 |
| 华秋智造 | 工厂：个人合同、3 把工程装配及分项费用 | 03:54:06 | 已接受，已保存发件副本 | 等待书面回复 |
| 泰尔无锡 | 实验室：个人项目、整板 SCA / 分域 FI 与样品数 | 03:54:11 | 已接受，已保存发件副本 | 已转介 SCA 联系人，接单待确认 |
| atsec 北京 | 实验室：个人项目、架构 / 源码 / FIDO 边界预评估 | 03:54:15 | 已接受，已保存发件副本 | 等待书面回复 |
| SGS Brightsight | 实验室：大陆个人项目、预评估及各专项承接地点 | 03:54:22 | 已接受，已保存发件副本 | 已回复不接个人；历史询问已撤回 |

发件副本已逐封核对收件人和消息标识。发送使用公开资料核对过的官方地址，见[候选清单](MAINLAND_SUPPLIERS_AND_LABS.md)。工程审查链接固定到提交 `9675cc330b10a74800e0c0edd0cd7866f888b648`。

## 已复核的回信与跟进

下列是必要受理结论的脱敏摘要；不公开私人邮箱、工单号、Message-ID、签名、邮件全文或附件。

| 机构 | 日期 | 已知事实 | 当前结论 |
|---|---|---|---|
| Seeed Fusion | 2026-11-12 | 询问首批需求量，没有逐项确认个人主体 / 3 把 / 费用 | 待澄清；不能标为已接单 |
| 泰尔无锡 | 2026-11-11 | 转介可做侧信道测试的同事 | 技术联系人已转介；个人合同、样品数和费用仍待确认 |
| 泰尔无锡跟进 | 2026-11-11 | 已说明设计尚未定型，并询参考费用 / 最低起步费，不构成委托 | 本次检索范围内未见该费用问题的后续答复 |
| SGS Brightsight | 2026-11-10 | 明确本次只接公司项目，不承接个人项目；随后已撤回询问，对方确认结束往来 | **当前个人条件不符，移出默认候选**；不再列“等待个人接单确认” |
| 华秋 / atsec 北京 | 截至 2026-11-13 | 本次相关主题检索未找到受理答复 | 待确认，不推定已接受或拒绝 |

检索覆盖收件箱、Archive、Junk 中自 2026-11-10 起含 OpenKeys 的邮件，完成所有返回游标分页，
并核对相应发件记录；不标记已读、不下载附件。未发现匹配结果不代表邮件绝对未送达、
不存在其他主题答复，或正在持续监控邮箱。

## 这些状态代表什么

- **已接受**：iCloud 接受了发送请求并保存发件副本；不代表收件方已送达、阅读或同意接单。
- **待确认**：尚未取得覆盖个人主体、3 把目标、样品数量、当前 R05 范围和费用的确认。
- **当前已确认接单：0 家**。通用介绍、自动工单或“可以咨询”不能升级为项目已确认。

首次发件时的“未见回复”记录已被上面的回信复核更新。发送成功、转介技术同事和询问数量，均不等于本项目已获承接。

## 后续处理

收到回复后按[记录字段](REQUEST_FOR_CONFIRMATION.md)更新脱敏摘要。需企业主体、最低数量不匹配或不能覆盖必要范围时，标明条件或移出可选名单。付费测试、采购下单、追加技术附件或新增联系对象不由这次资格询问自动授权。

私人往来和邮箱证据仅私下保存，不将个人邮箱、合同原件、真实密钥、指纹模板或恢复码提交公开仓库。生产放行状态仍为 BLOCKED。
