Jay-Void-BA/OpenKeys/manufacturing/HANDOFF.md

# R0.4 成品开发与验收任务书

目标为3把个人使用设备。当前是待实作的工程候选设计，不能只交给普通SMT厂就取得可用认证器。源文件以[hardware/r04](../hardware/r04/README.md)为准；原R0.2双口/OLED/OTP版本仅保留历史。

从下载、采购、订板到代焊 / 验收的具体操作见[完整制作说明书](BUILD_MANUAL_ZH.md)及[工厂确认单](ORDER_SHEET_R04.md)。

服务商须明确接受**个人作为合同主体、个人付款和3把项目**。按[筛选证据](MAINLAND_SUPPLIERS_AND_LABS.md)与[书面确认模板](REQUEST_FOR_CONFIRMATION.md)核对；当前没有取得本项目接单回复，技术能力或采购入口不代表已符合这些条件。

固定功能：单USB-C母口兼USB2数据与5V充电、NFC、白背光16x2英文LCD、四个场景按键、强制设备指纹、仅附加的设备PIN；FIDO2/WebAuthn/Passkey、U2F、hmac-secret、凭据管理、加密notes与recovery codes。已取消动态验证码和USB-A。macOS/iOS认证分别验收；桌面管理软件覆盖macOS/Linux/Windows；手机NFC管理作为依赖设备认证协议的独立交付。

推荐核心：STM32H573RIT6、SE050E、FPC2534AM、NHD-C0216CiZ-FSW-FBW-3V3、TPS259470L输入保护、四层PCB。自研运行代码Rust，按模块允许Zig，不引入自研C/C++。芯片ROM/applet与OS/第三方库记录版本和信任边界。容量约500mAh电池包必须有PCM和真实NTC；已选Adafruit1578保护500mAh包及独立Semitec103AT-2热敏线束，仍需到货验证。

验收固定顺序：设备指纹→需要时四键PIN→完整请求与实体确认→单次操作。PIN、手机指纹、USB/NFC发现和工厂命令均不能替代设备指纹。初始化只允许无用户秘密的空白设备，已配置设备不能因为断电/备用域丢失而重开初始化。

| 独立报价项目 | 必须交付与验收 |
|---|---|
| 电路/PCB | 冻结BOM/封装及已绘制RF芯片候选EP的装配资格、天线、完整布局布线、叠层/回流/热/电源瞬态、DRC/DFM；可编辑源文件、Gerber/钻孔、贴片坐标、装配PDF与摘要 |
| Rust固件 | 实际ARM ELF/BIN、可重现构建、签名更新；STiRoT/TrustZone/GTZC/调试生命周期；SE/FP/LCD/按键/Flash/USB/NFC/充电/备用防拆驱动与完整FIDO/vault实现 |
| 生产与配对 | EVT板优先，3把成品另验；每台独立密钥、受控配对夹具、无默认密钥或普通工厂旁路；生产密钥不进入公开仓库/代焊资料 |
| 软件 | 真设备身份与经评审的加密管理通道、只导入选中项、拔插/休眠撤销；三系统真实设备端到端验证、安装包与必要签名/公证 |
| 结构/供电 | LCD/FP/排线/接口/电池配合与绝缘；盖板触点行程/预压；备用域留痕/全掉电锁定；Apple20W适配器5V、USB suspend、热与电池故障测试 |
| 功能/RF | 最终外壳下NFC调谐、目标iPhone/Android实测、FIDO各协议/扩展及负向请求；NFC需带电操作；USB-C插拔/ESD/回灌测试 |
| 安全 | 源码与二进制/配置一致性、持久失败预算、重放/模块替换/模板保护、启动/更新回滚/调试、掉电事务、降压/时钟/EM/时序/功耗分析；写明版本、范围、重复次数和残余风险 |

先评审→EVT证据→功能/负向检查→安全修复复测→制造冻结→3把成品。渲染图、ERC通过、策略库或模拟演示不等于完成上述交付。

## 成本分级

三档都保留指纹/PIN/SE与全部目标功能，不能用降低安全要求来冒充“低档安全成品”。

| 档位 | 用途 | 当前成本口径 |
|---|---|---|
| 低档研发 | 共用PCB/标准件，比较封装与代焊/返修成本，只接合成数据 | 已有R04工程候选BOM，尚未生产冻结或取得正式整机报价；不能据此使用真实秘密 |
| 中档推荐 | flex指纹模块、H573+SE050、选定LCD、低倍率电池、小批量外壳 | 可暂按3把材料/小批量装配/外壳合计¥2400–4200预留询价空间，**工程预算，不是供应商报价** |
| 高档验证 | 在同一功能基础上完成独立审计/EMC/侧信道/故障验证并修订 | 实验室、研发、额外测试板与返板费用单独询价，未承诺金额或认证结果 |

上述不含完整固件与管理软件研发、认证、签名服务或不可预见返板。2026-11-08已核对FPC2534AM模块MOQ1含税快照为¥246.53/颗，3颗¥739.59；不是锁库存承诺。其他新器件尚无本项目正式采购报价。旧R0.2的¥2100–3600预留不套用到新版LCD/备用电源方案。

大陆入口：[嘉立创](https://www.jlc.com/)、[立创商城](https://www.szlcsc.com/)、[华秋PCB](https://www.hqpcb.com/)、[华秋商城](https://www.hqchip.com/)；需Rust/安全认证器定制研发的部分另找具备能力的团队。已有安全密钥/OEM方案可核查[飞天诚信](https://www.ftsafe.com/)与[文鼎创](https://www.excelsecu.com/)是否接受开放源码/图纸/验证条款，不能把商用品默认称作开源替代。已经授权提交的资格询问见[联系进度](OUTREACH_STATUS.md)；没有下单或取得本项目接单承诺，OEM入口亦不是个人、小批量受理的证明。

当前完整未决清单见[SECURITY_REVIEW_R04](../docs/SECURITY_REVIEW_R04.md)与[readiness-report](readiness-report.json)。没有目标样板、手机连接和物理测试仪器，不能验收真实指纹强制授权或抗物理攻击性能。

R04输入保护续更：已补独立eFuse及DC误差计算；实际电气PCB与天线封装完成后ERC/DRC为0违规，不再沿用早期天线警告。过压动态/热/TVS协调以及全部系统安全资格仍未通过，不能仅按数据表值验收。2026-11-09核对的[制造与实验室候选](MAINLAND_SUPPLIERS_AND_LABS.md)包括SMT、客供/后焊及物理攻击/EMC分项能力，尚无本项目正式报价或接单承诺。
