Jay-Void-BA/OpenKeys/hardware/MANUFACTURING.md

> **历史资料**：下文对应较早版本。当前R0.3要求与状态以仓库README、manufacturing/HANDOFF.md和docs/SECURITY_REVIEW_R03.md为准，旧OTP/双USB/PIN备用方案不再适用。

# 中国大陆打样、代焊与询价

此处列出可询价的公开渠道，**未代你联络、未取得报价、没有背书其安全设计能力**。三把成品之外需要功能/破坏性测试板。指纹已收敛为FPC2534AM目标，但完整硬件与固件未验证，当前无法给出可靠的三把整机总价。

| 渠道 | 可询价内容 | 公开入口 |
|---|---|---|
| 嘉立创 / 立创商城 | 四层PCB、SMT、元件可供性及代采；核对小批量起贴/换料成本 | https://www.jlc.com/ 、https://www.szlcsc.com/ |
| 华秋 | 四层PCB、PCBA、DFM、元件采购 | https://www.hqpcb.com/ 、https://www.hqchip.com/ |
| 文鼎创（Excelsecu，深圳） | FIDO/生物认证硬件研发或现成产品是否可公开方案/小批量配合 | https://www.excelsecu.com/ 、https://www.excelsecu.com.cn/ |
| 飞天诚信（FEITIAN，北京） | FIDO/生物认证现成品、模块或研发配合；是否提供可开源交付需另确认 | https://www.ftsafe.com/ 、https://fido.ftsafe.com/products/ |
| NXP / ST 授权分销 | 指定料号/修订、可追溯来源、SE生命周期和配对支持 | https://www.nxp.com/ 、https://www.st.com/ |

现成产品如Solo2、Nitrokey3可作协议与工程参考，现有证据不能证明其中任一款原样满足本项目的屏幕+可信指纹+双USB+NFC+TOTP+私密notes全部要求。不要以普通指纹模块替换可信模块后仍宣称同等安全。

## 询价应附

1. 本包原理图PDF、BOM、分区尺寸图与发布门槛。**当前禁止当作已放行Gerber包使用**。
2. 精确料号、可接受替代规则、库存/价格有效期、最低采购量。MCU/SE/指纹禁止无审批替代；SE需原厂/授权链路与批次可追溯。
3. 完成后的Gerber、叠层/阻抗、贴片坐标、面向、钢网、电池/外壳装配要求。由代工厂给DFM反馈，设计方签核。
4. 由自有受控夹具烧录与每台独立配对，禁止交给代工方统一生产密钥或默认SCP03密钥。记录序号与测试版本，不在公开仓库提交真实密钥/指纹/OTP。
5. 分开报价：PCB、元件/损耗、SMT/钢网、壳体、装配、测试夹具、额外测试板、返板、NFC调谐、安全与EMC实验。

先在开发板验证固件/可信指纹链路和电源预算，再冻结一套PCB。三档预算和未报价项见[TIERS](../docs/TIERS.md)；“高级”应把钱花在独立攻击验证，不能靠更贵MCU或更多层板推定。

R0.2增加了[委托开发与验收任务书](../manufacturing/HANDOFF.md)、[关键器件](../manufacturing/critical-parts.csv)与制造预检。当前任务包含嵌入式/RF/安全开发，不能按普通来料代焊就可完成成品报价。
