Jay-Void-BA/OpenKeys/hardware/r05/exports/OpenKeys-dimensions.pdf

# OPENKEYS R0.5

# 102 x 118 x 30 mm

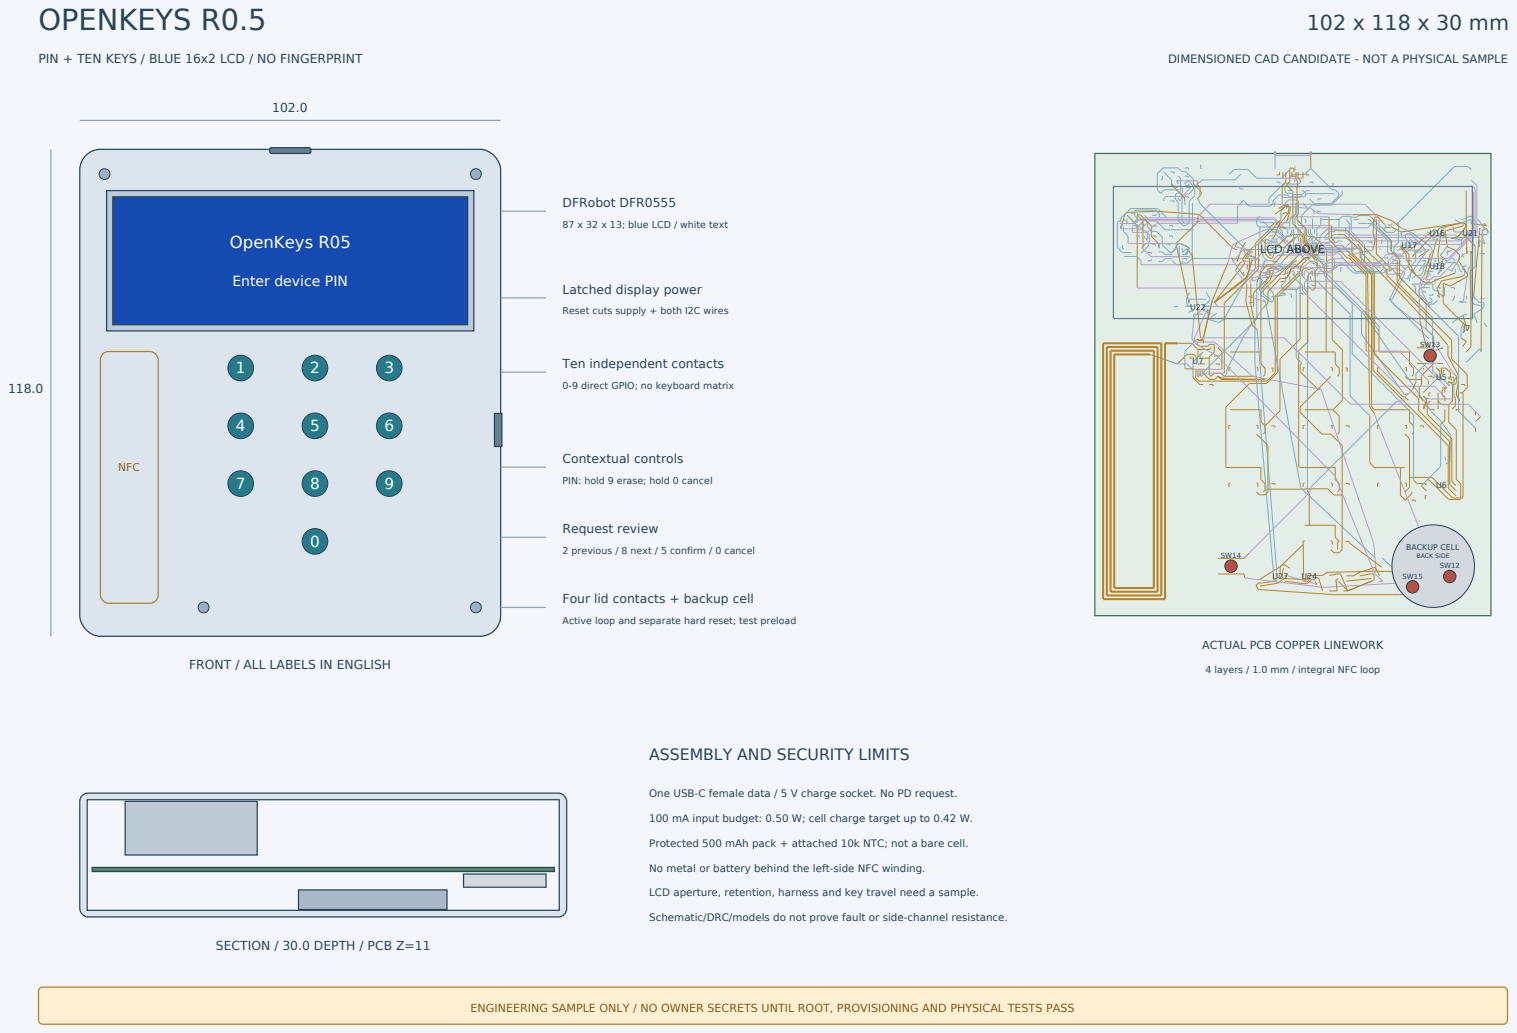
[picture p24: page 1]

PIN + TEN KEYS / BLUE 16x2 LCD / NO FINGERPRINT

DIMENSIONED CAD CANDIDATE - NOT A PHYSICAL SAMPLE

87 x 32 x 13; blue LCD / white text

Reset cuts supply + both I2C wires

0-9 direct GPIO; no keyboard matrix

PIN: hold 9 erase; hold 0 cancel

2 previous / 8 next / 5 confirm / 0 cancel

Four lid contacts + backup cell

Active loop and separate hard reset; test preload

ACTUAL PCB COPPER LINEWORK

FRONT / ALL LABELS IN ENGLISH

4 layers / 1.0 mm / integral NFC loop

ASSEMBLY AND SECURITY LIMITS

One USB-C female data / 5 V charge socket. No PD request.

100 mA input budget: 0.50 W; cell charge target up to 0.42 W.

Protected 500 mAh pack + attached 10k NTC; not a bare cell.

No metal or battery behind the left-side NFC winding.

LCD aperture, retention, harness and key travel need a sample.

Schematic/DRC/models do not prove fault or side-channel resistance.

ENGINEERING SAMPLE ONLY / NO OWNER SECRETS UNTIL ROOT, PROVISIONING AND PHYSICAL TESTS PASS
