Jay-Void-BA/OpenKeys/hardware/r05/exports/OpenKeys-schematic.pdf

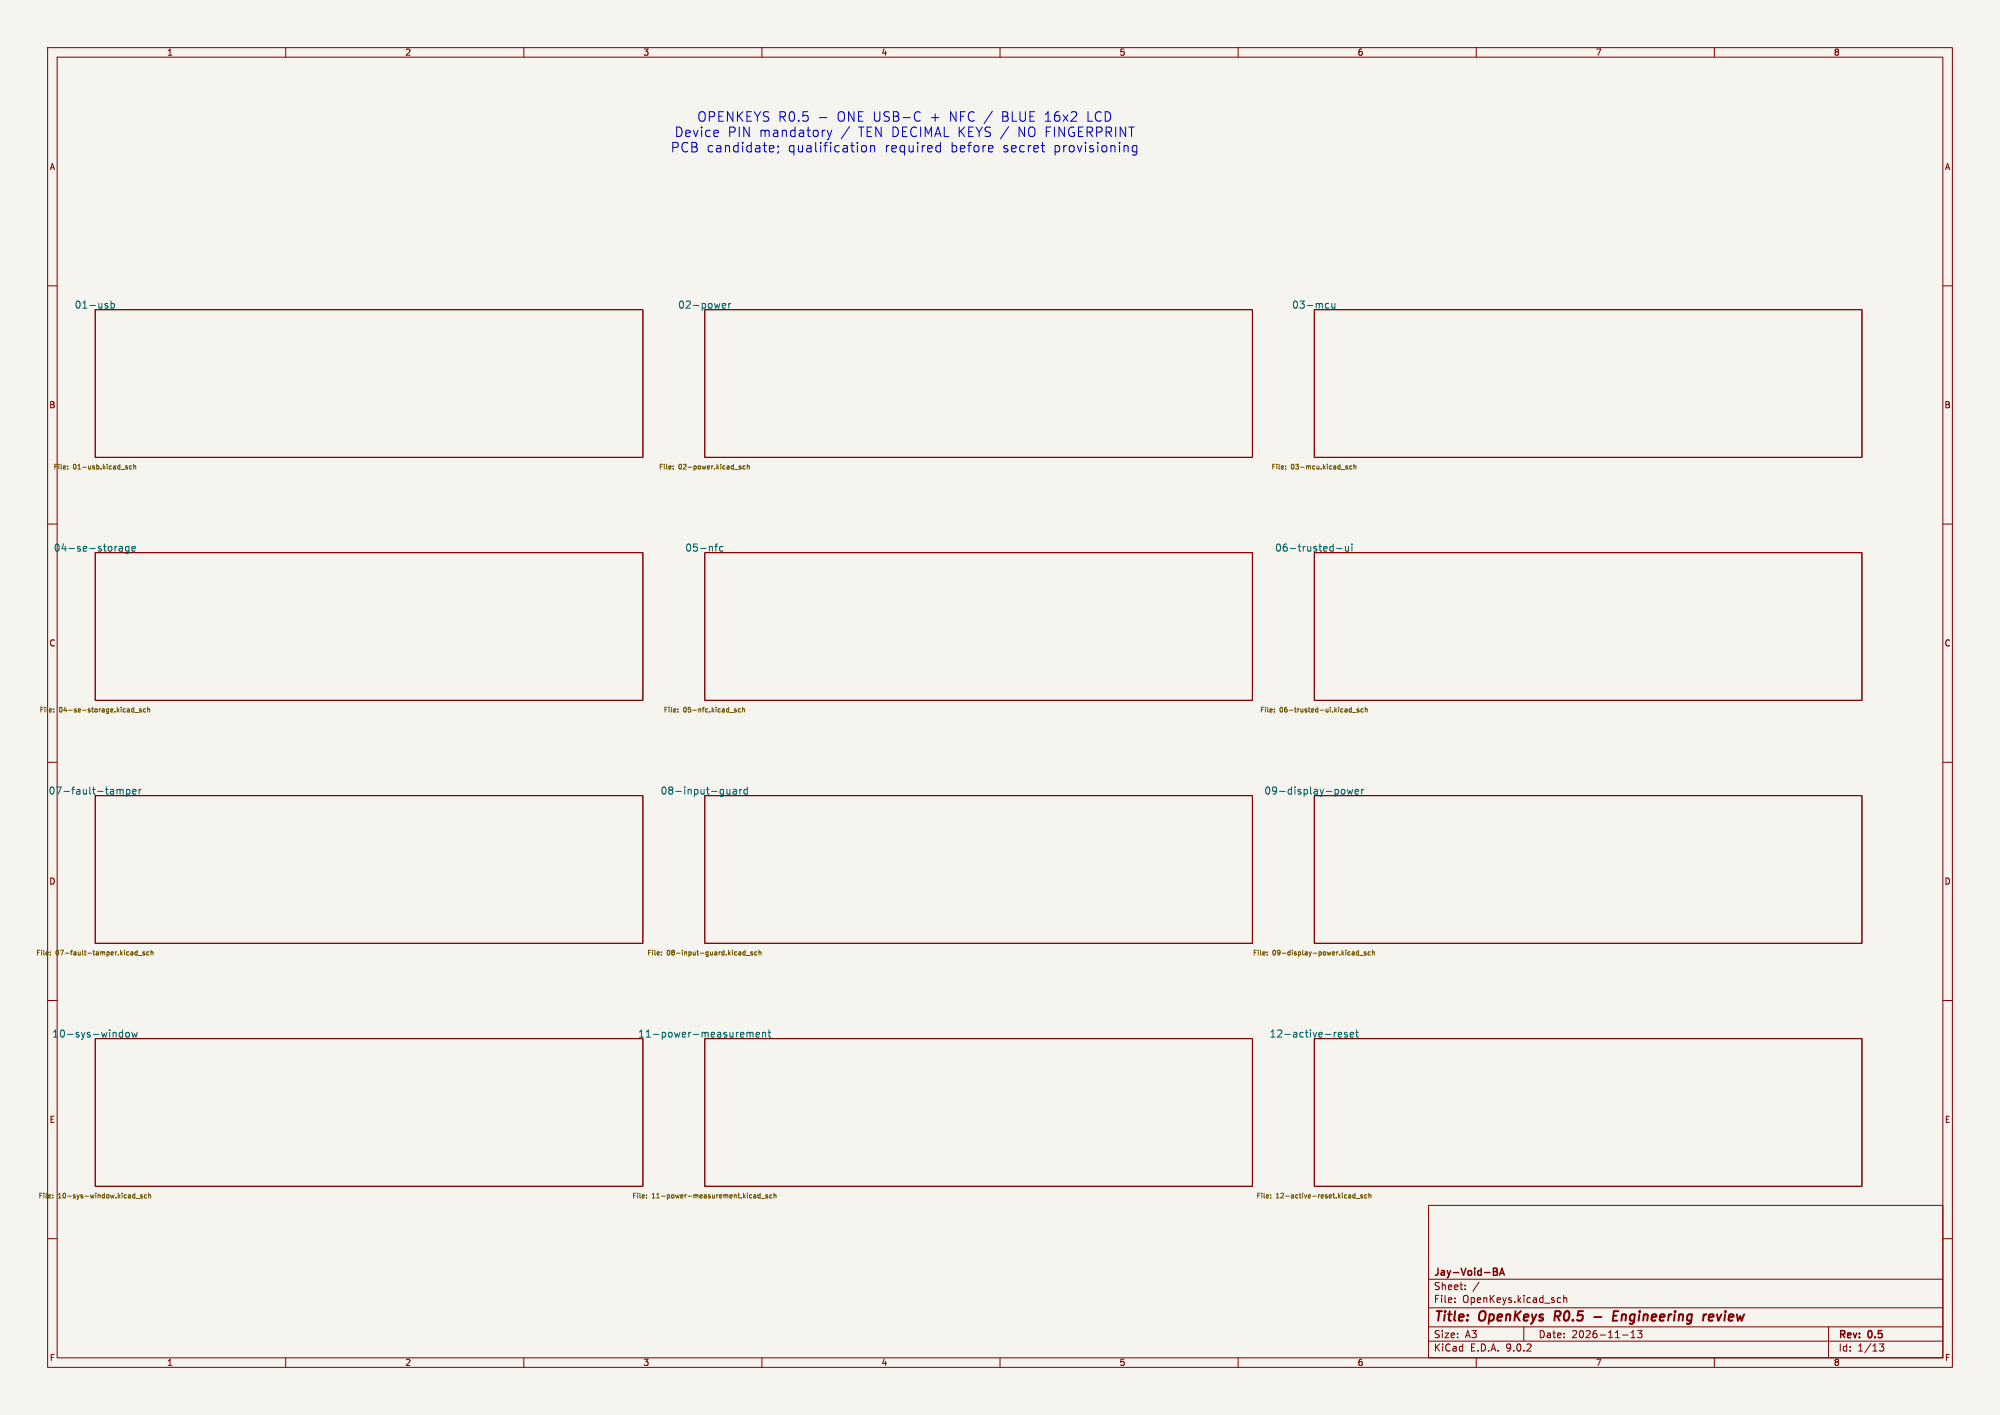
[picture p25: page 1]

File: 08-input-guard.kicad_sch 10-sys-window

File: OpenKeys.kicad_sch Sheet: / Jay-Void-BA

Id: 1/13 Title: OpenKeys R0.5 - Engineering review

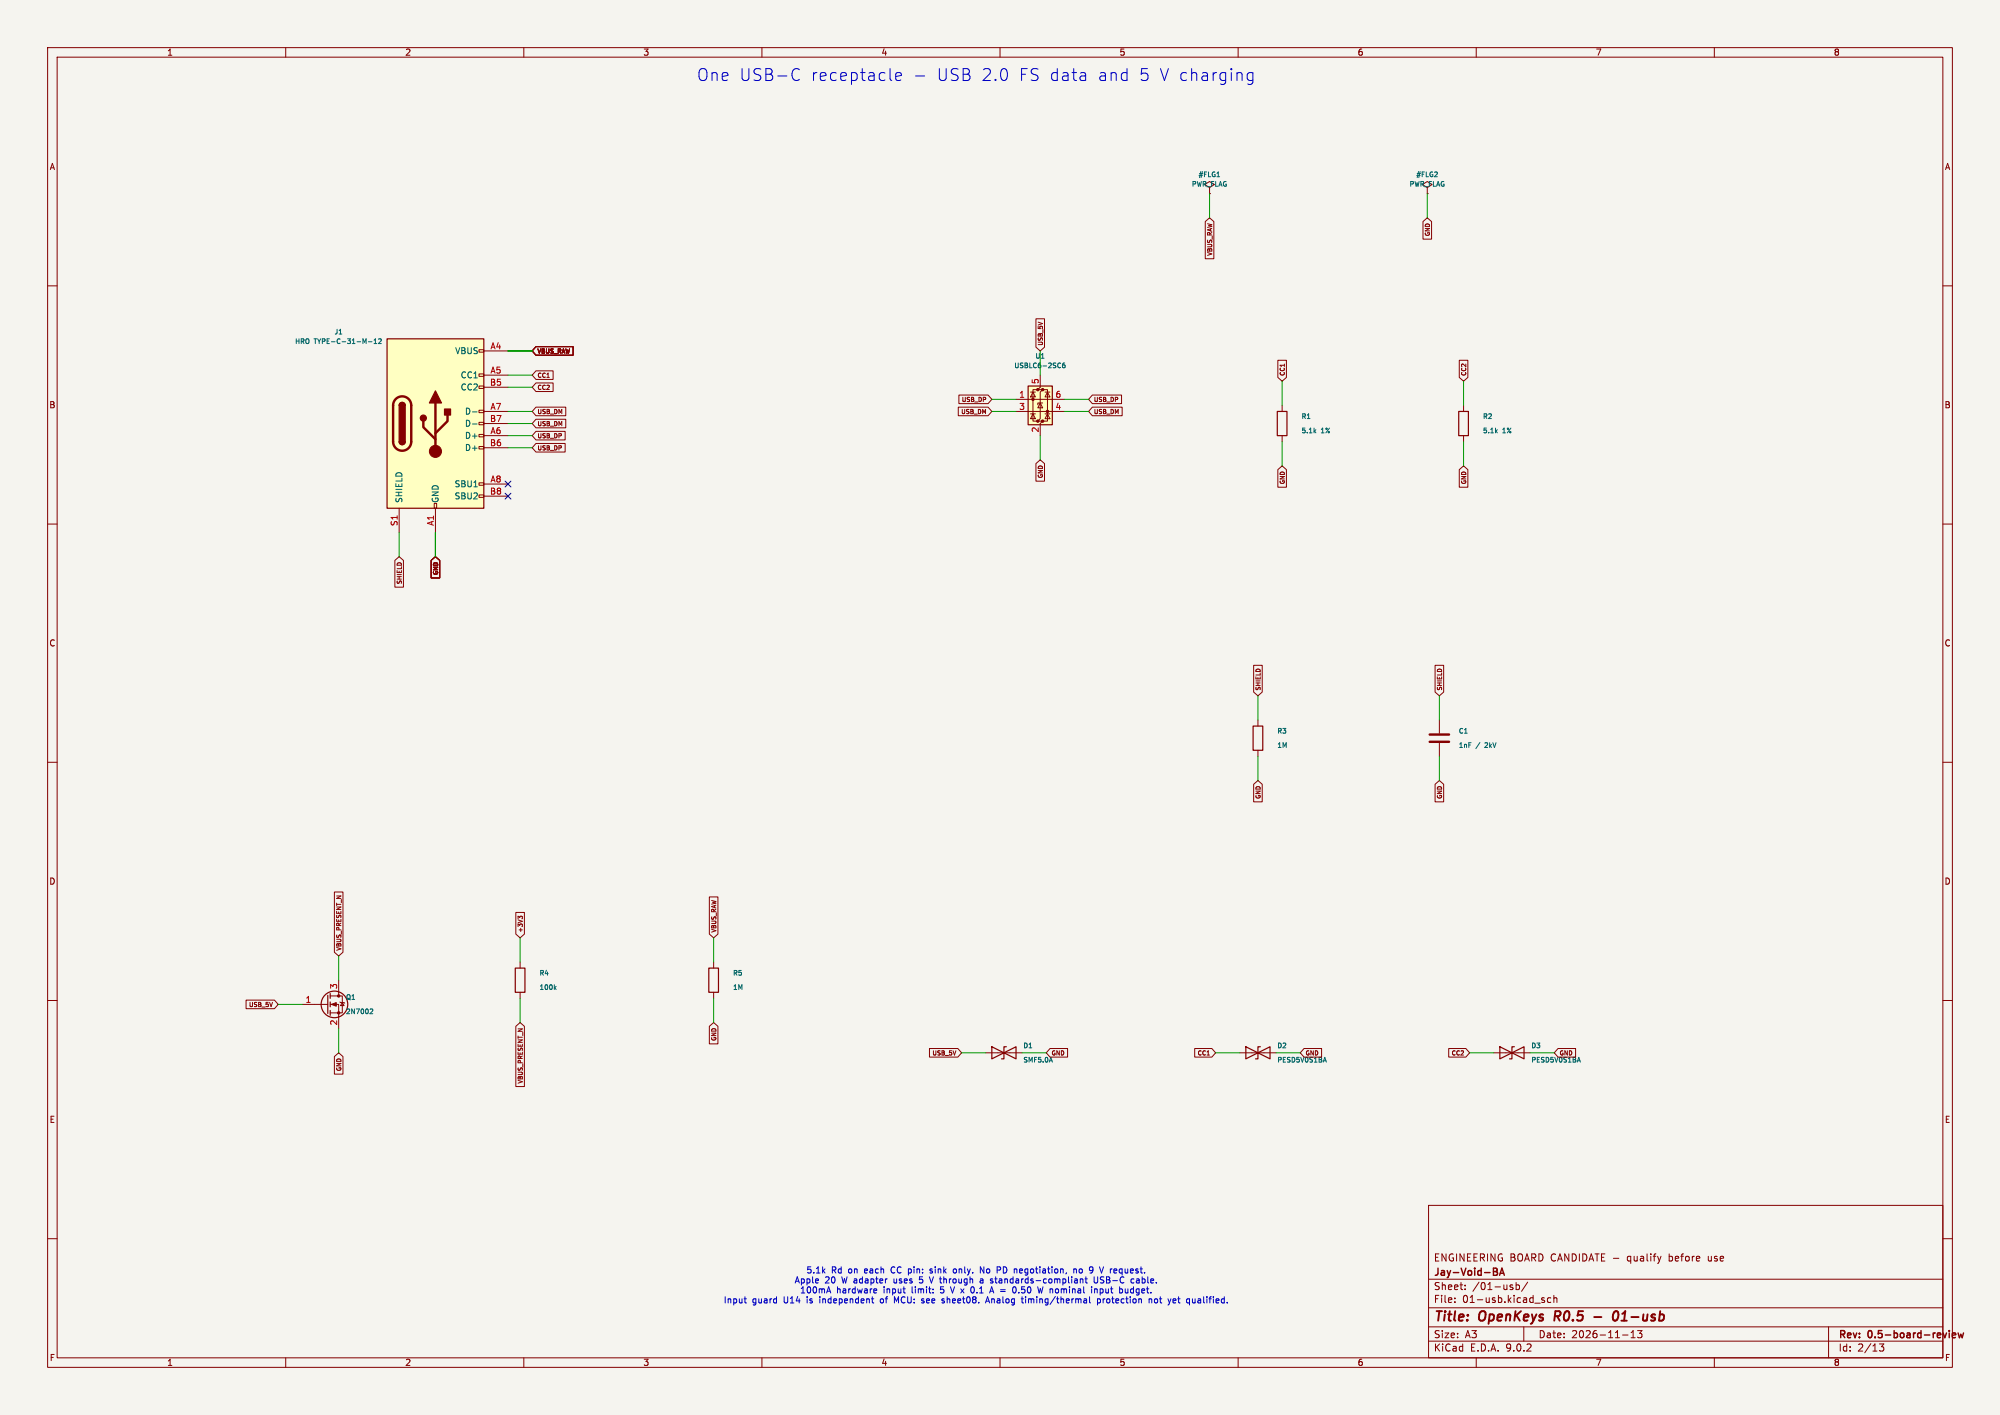
[picture p26: page 2]

File: 01-usb.kicad_sch Sheet: /01-usb/ Jay-Void-BA

Id: 2/13 Title: OpenKeys R0.5 - 01-usb

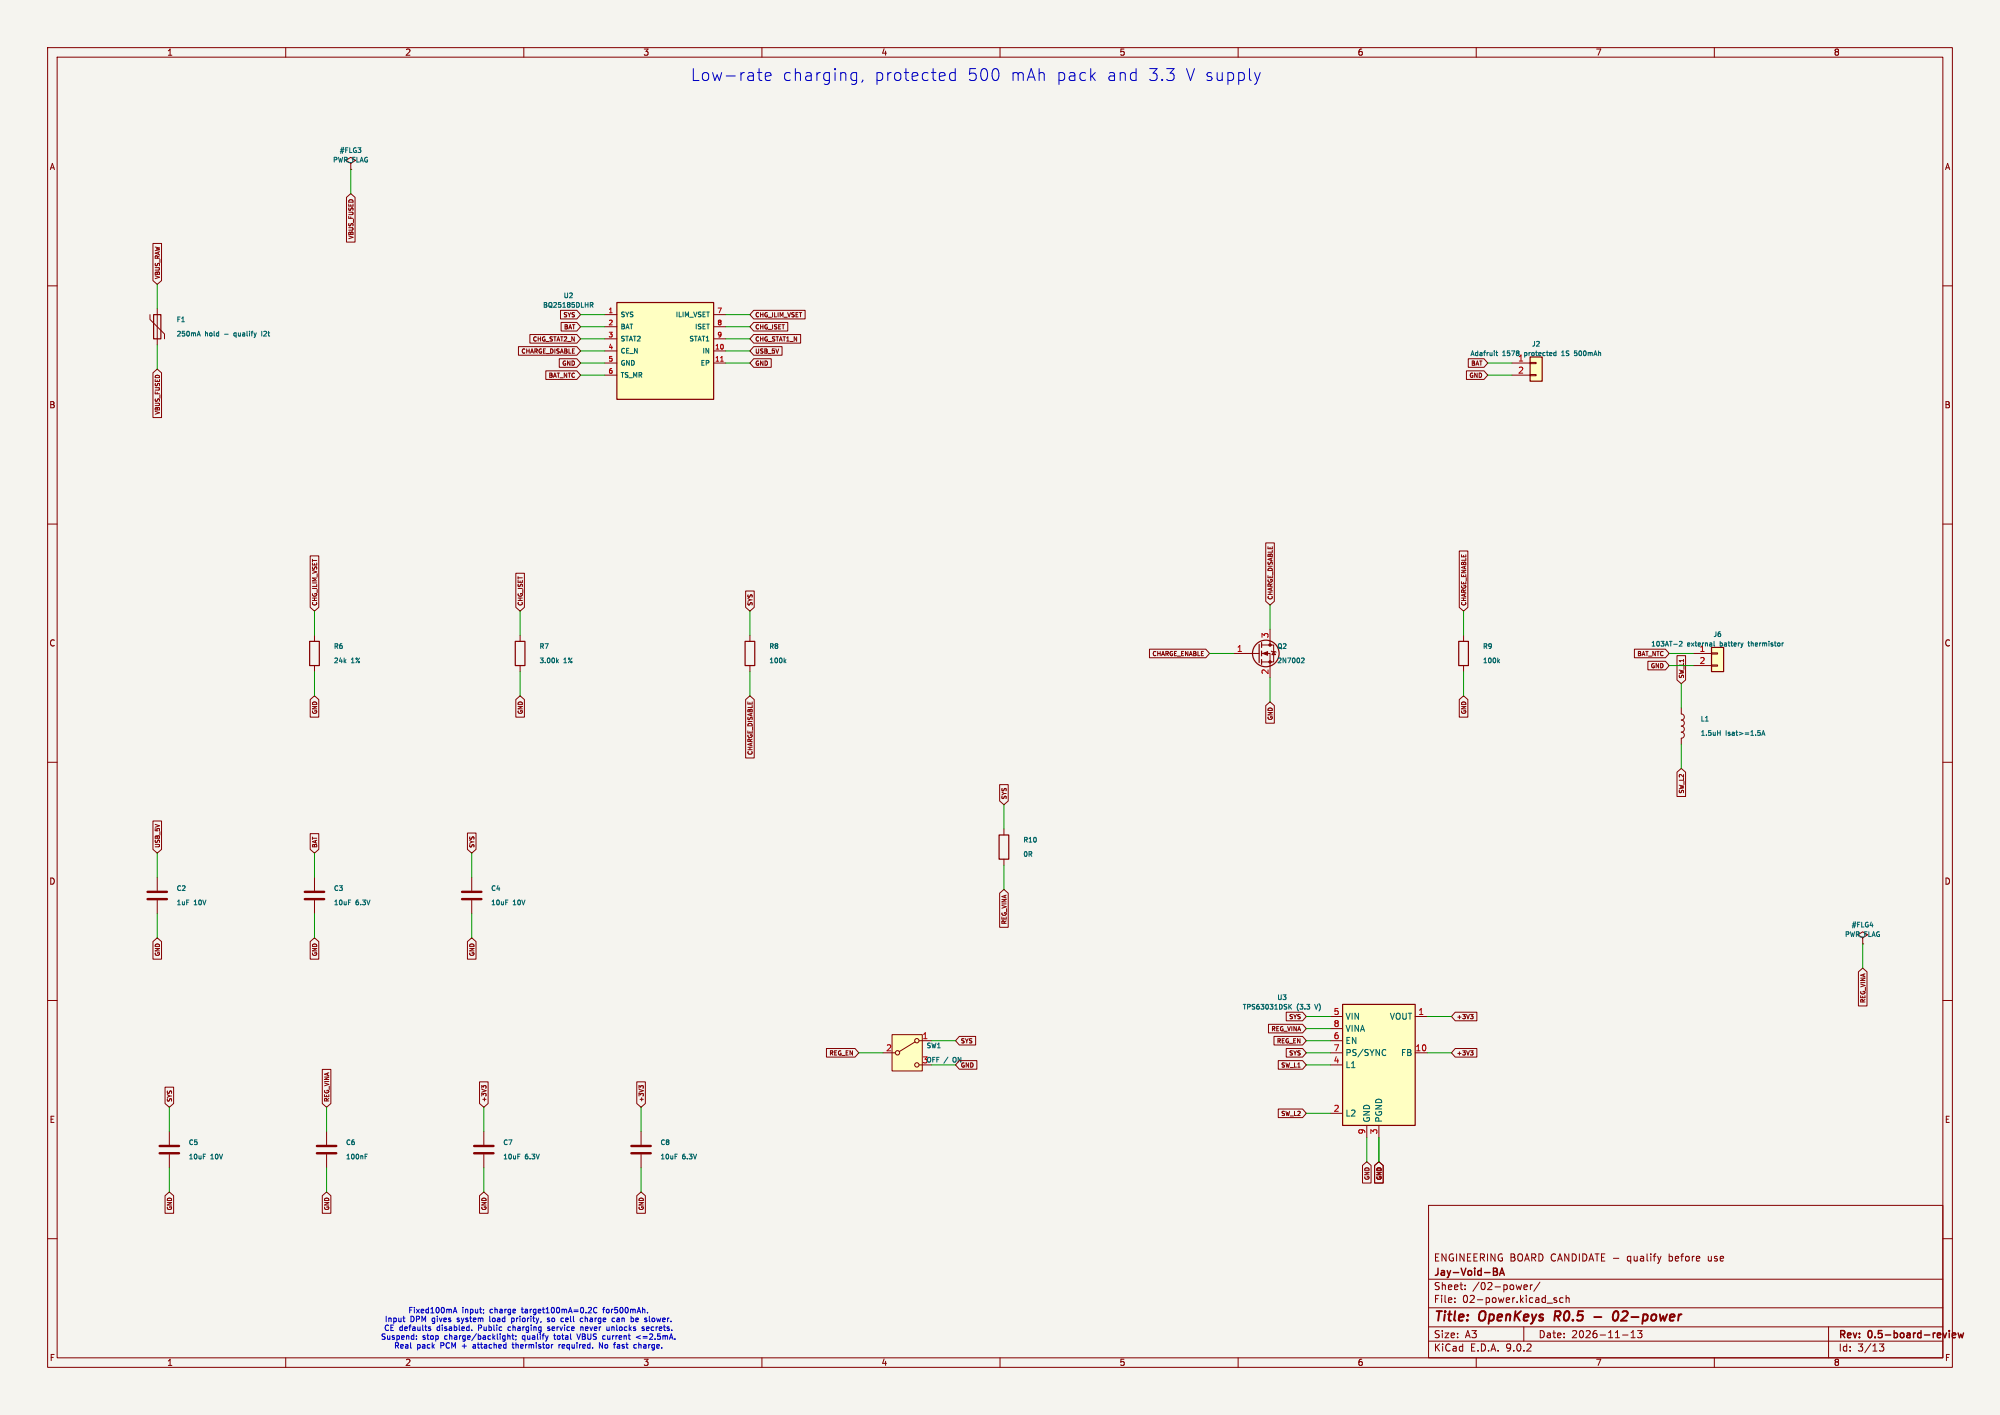
[picture p27: page 3]

Jay-Void-BA
Id: 3/13 Title: OpenKeys R0.5 - 02-power File: 02-power.kicad_sch Sheet: /02-power/

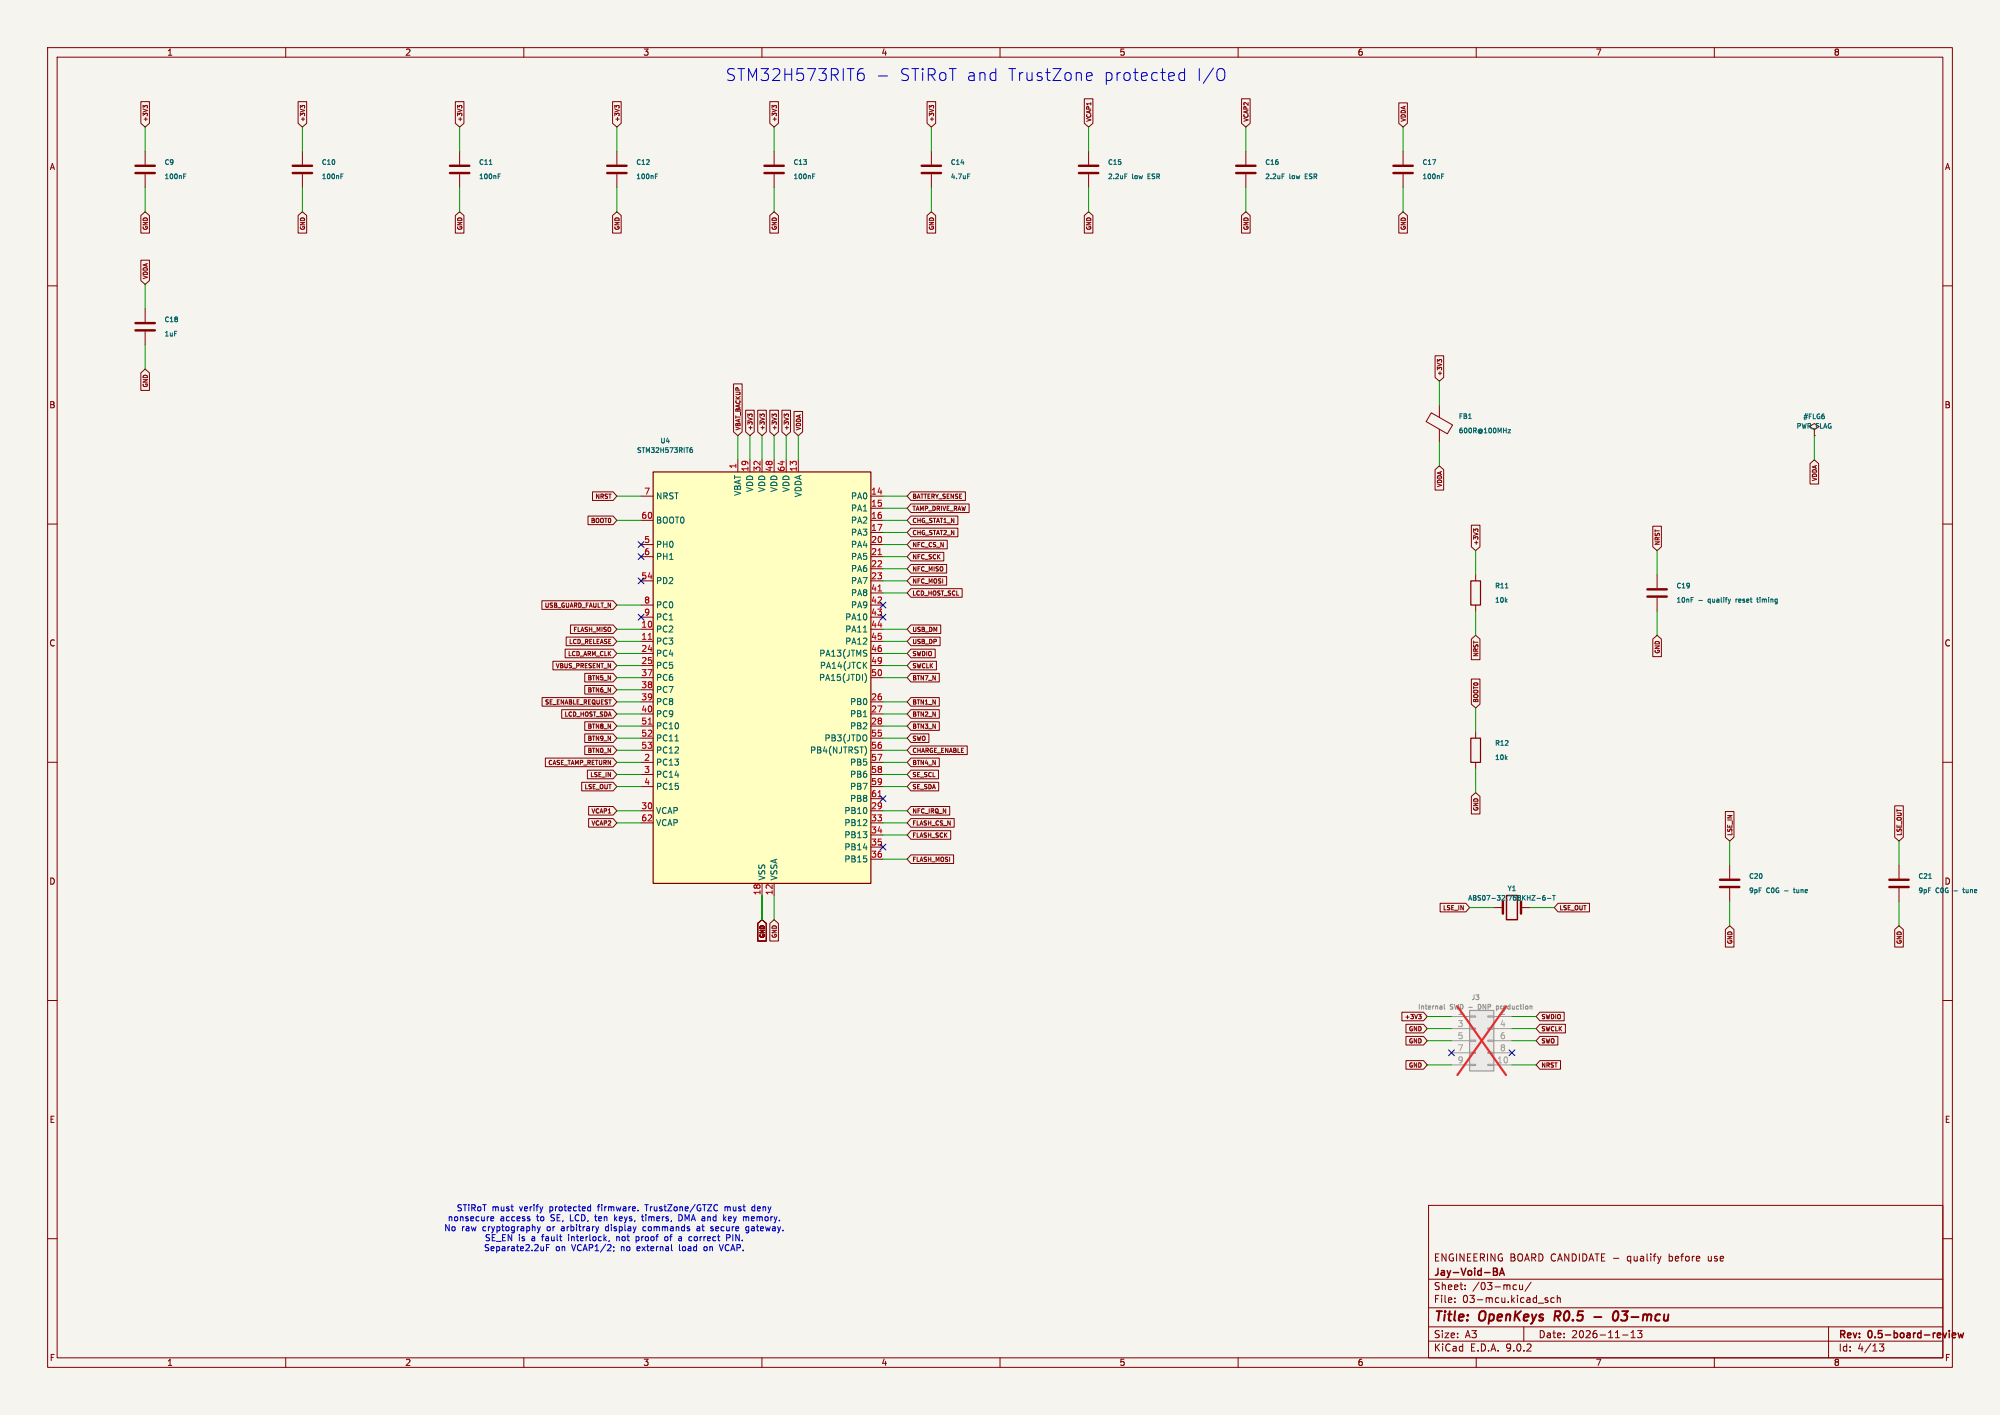
[picture p28: page 4]

1 VDD 19 VDD 32 VSS 18 VDD 48 VSSA 12 VDD 64 VDDA 13 PA0 14 PA1 15 PA2 16 PA3 17 PA4 20 PA5 21 PA6 22 PA7 23 PA8 41 PA9 42 PA10 43 PA11 44 PA12 45 PA13(JTMS 46 PA14(JTCK 49 PA15(JTDI) 50 PB0 26 PB1 27 PB2 28 PB3(JTDO 55 PB4(NJTRST) 56 PB5 57 PB6 58 PB7 59 PB8 61 PB10 29 PB12 33 PB13 34 PB14 35 PB15 36

File: 03-mcu.kicad_sch Sheet: /03-mcu/ Jay-Void-BA

Id: 4/13 Title: OpenKeys R0.5 - 03-mcu

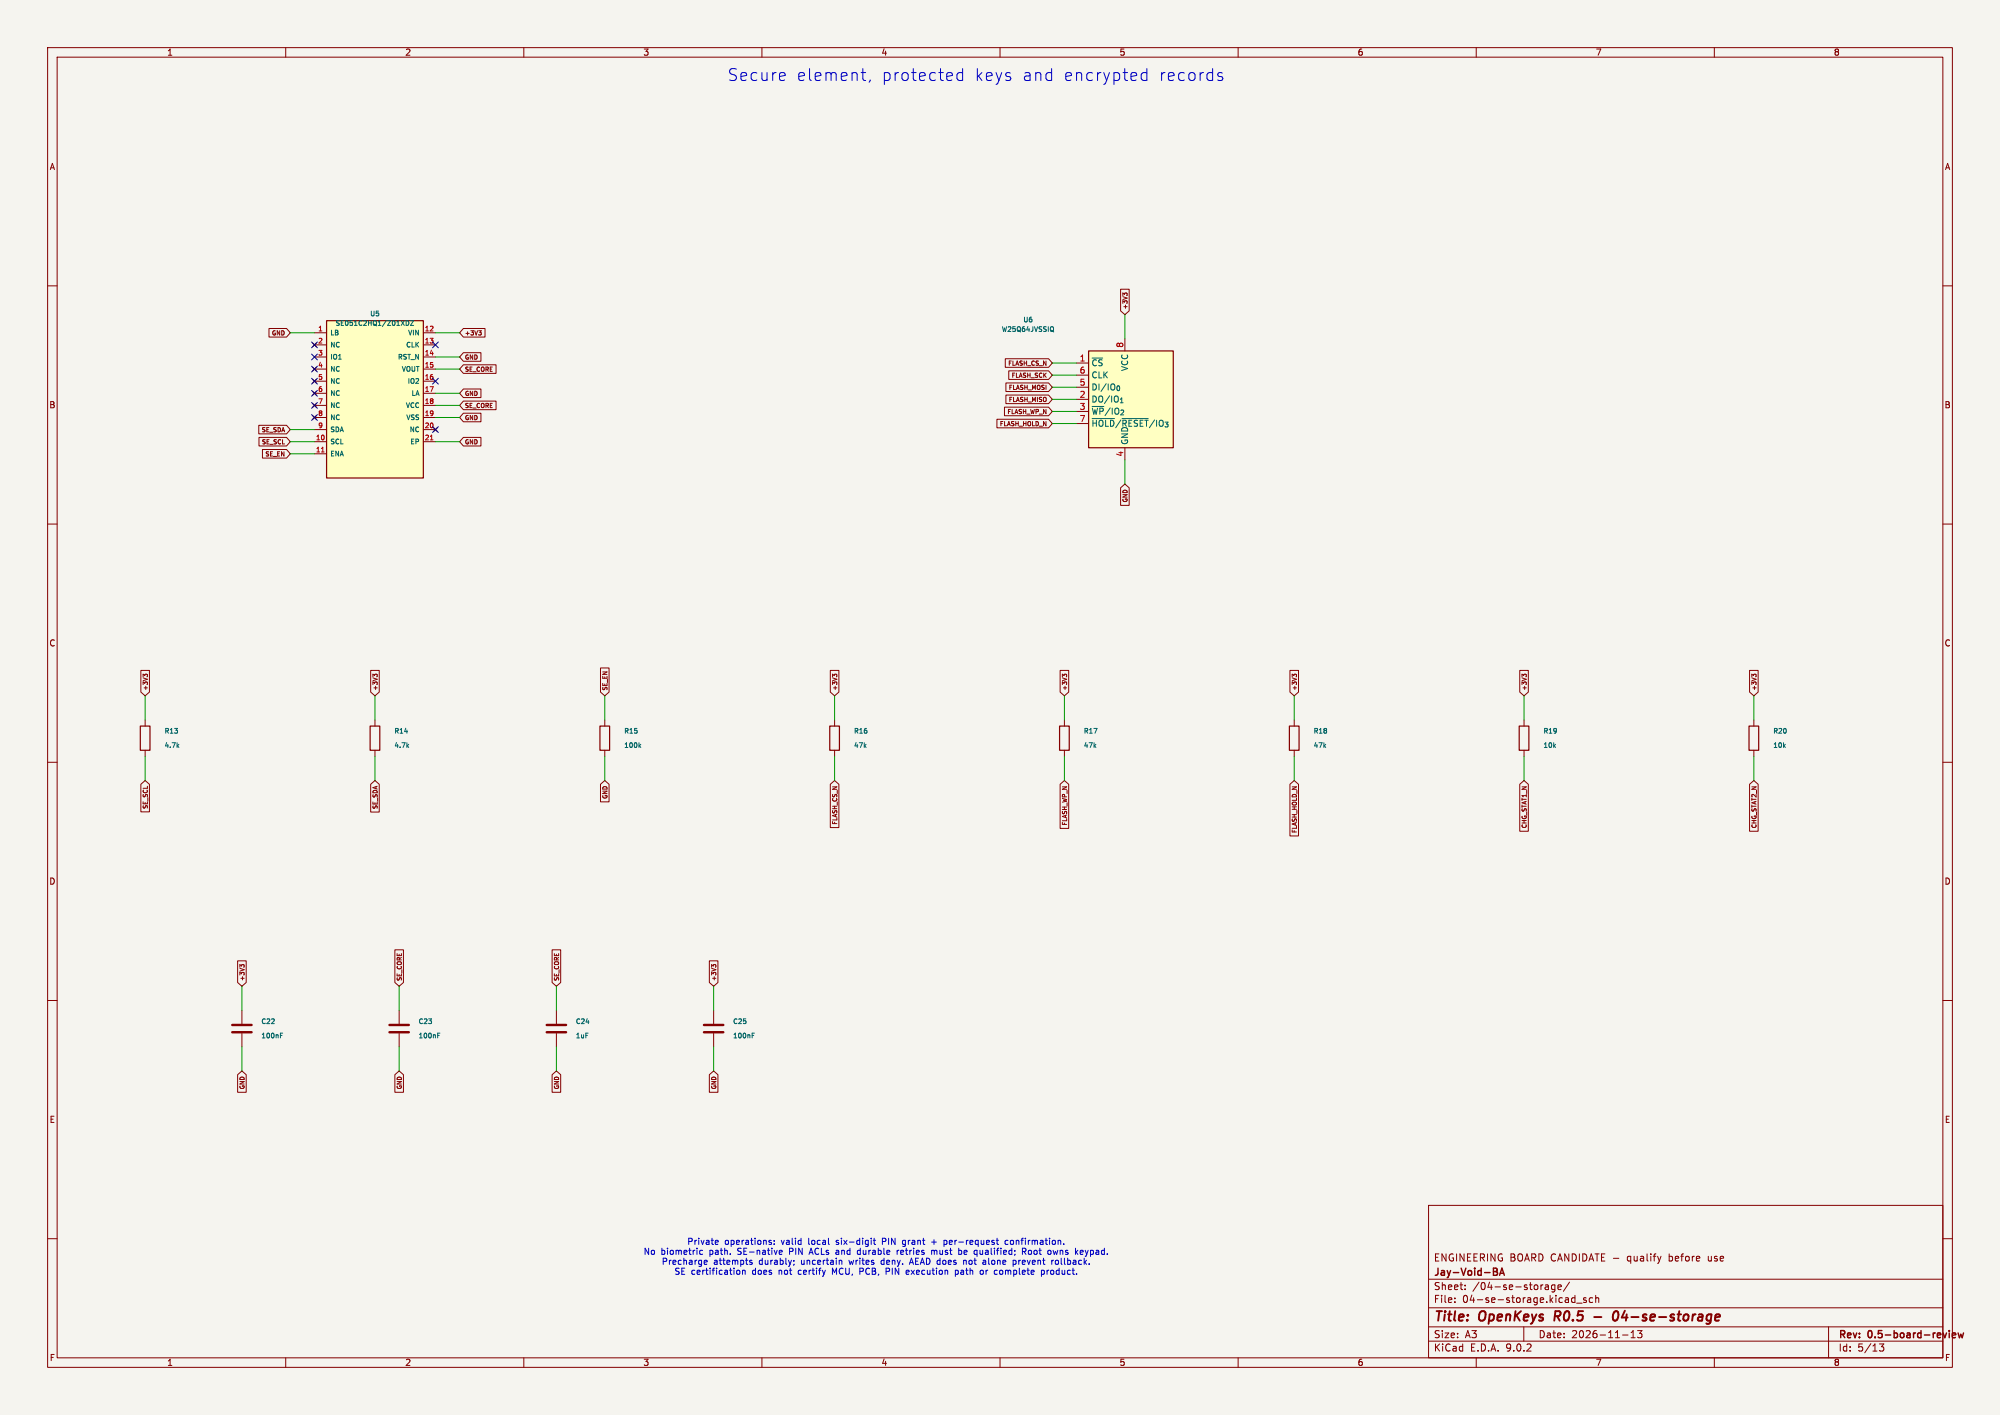
[picture p29: page 5]

Jay-Void-BA
File: 04-se-storage.kicad_sch Sheet: /04-se-storage/
Id: 5/13 Title: OpenKeys R0.5 - 04-se-storage

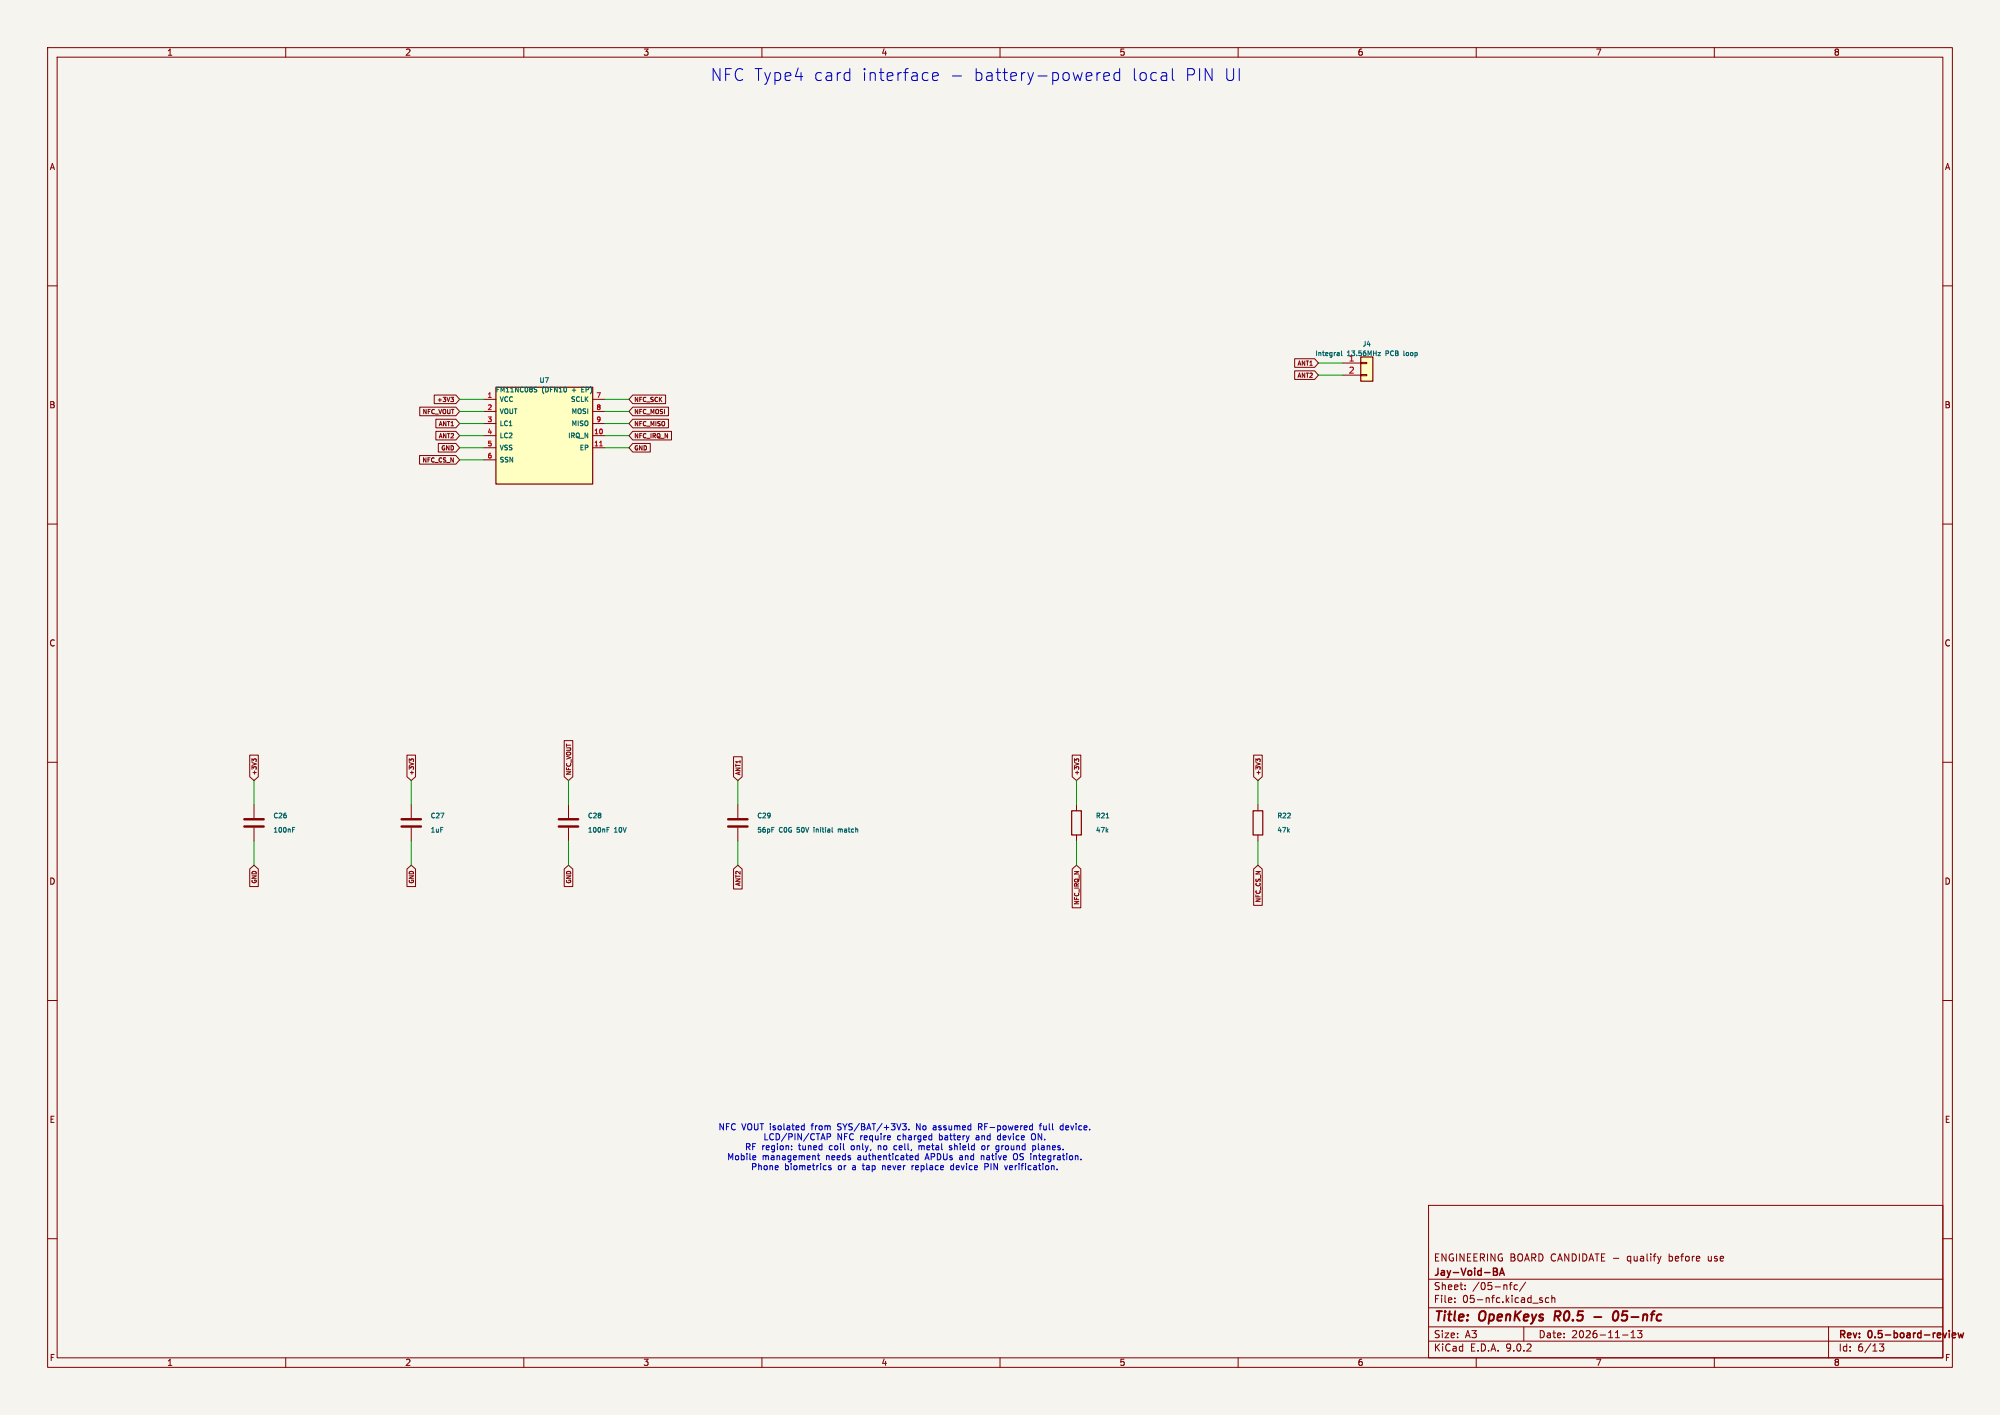
[picture p30: page 6]

File: 05-nfc.kicad_sch Sheet: /05-nfc/ Jay-Void-BA

Id: 6/13 Title: OpenKeys R0.5 - 05-nfc

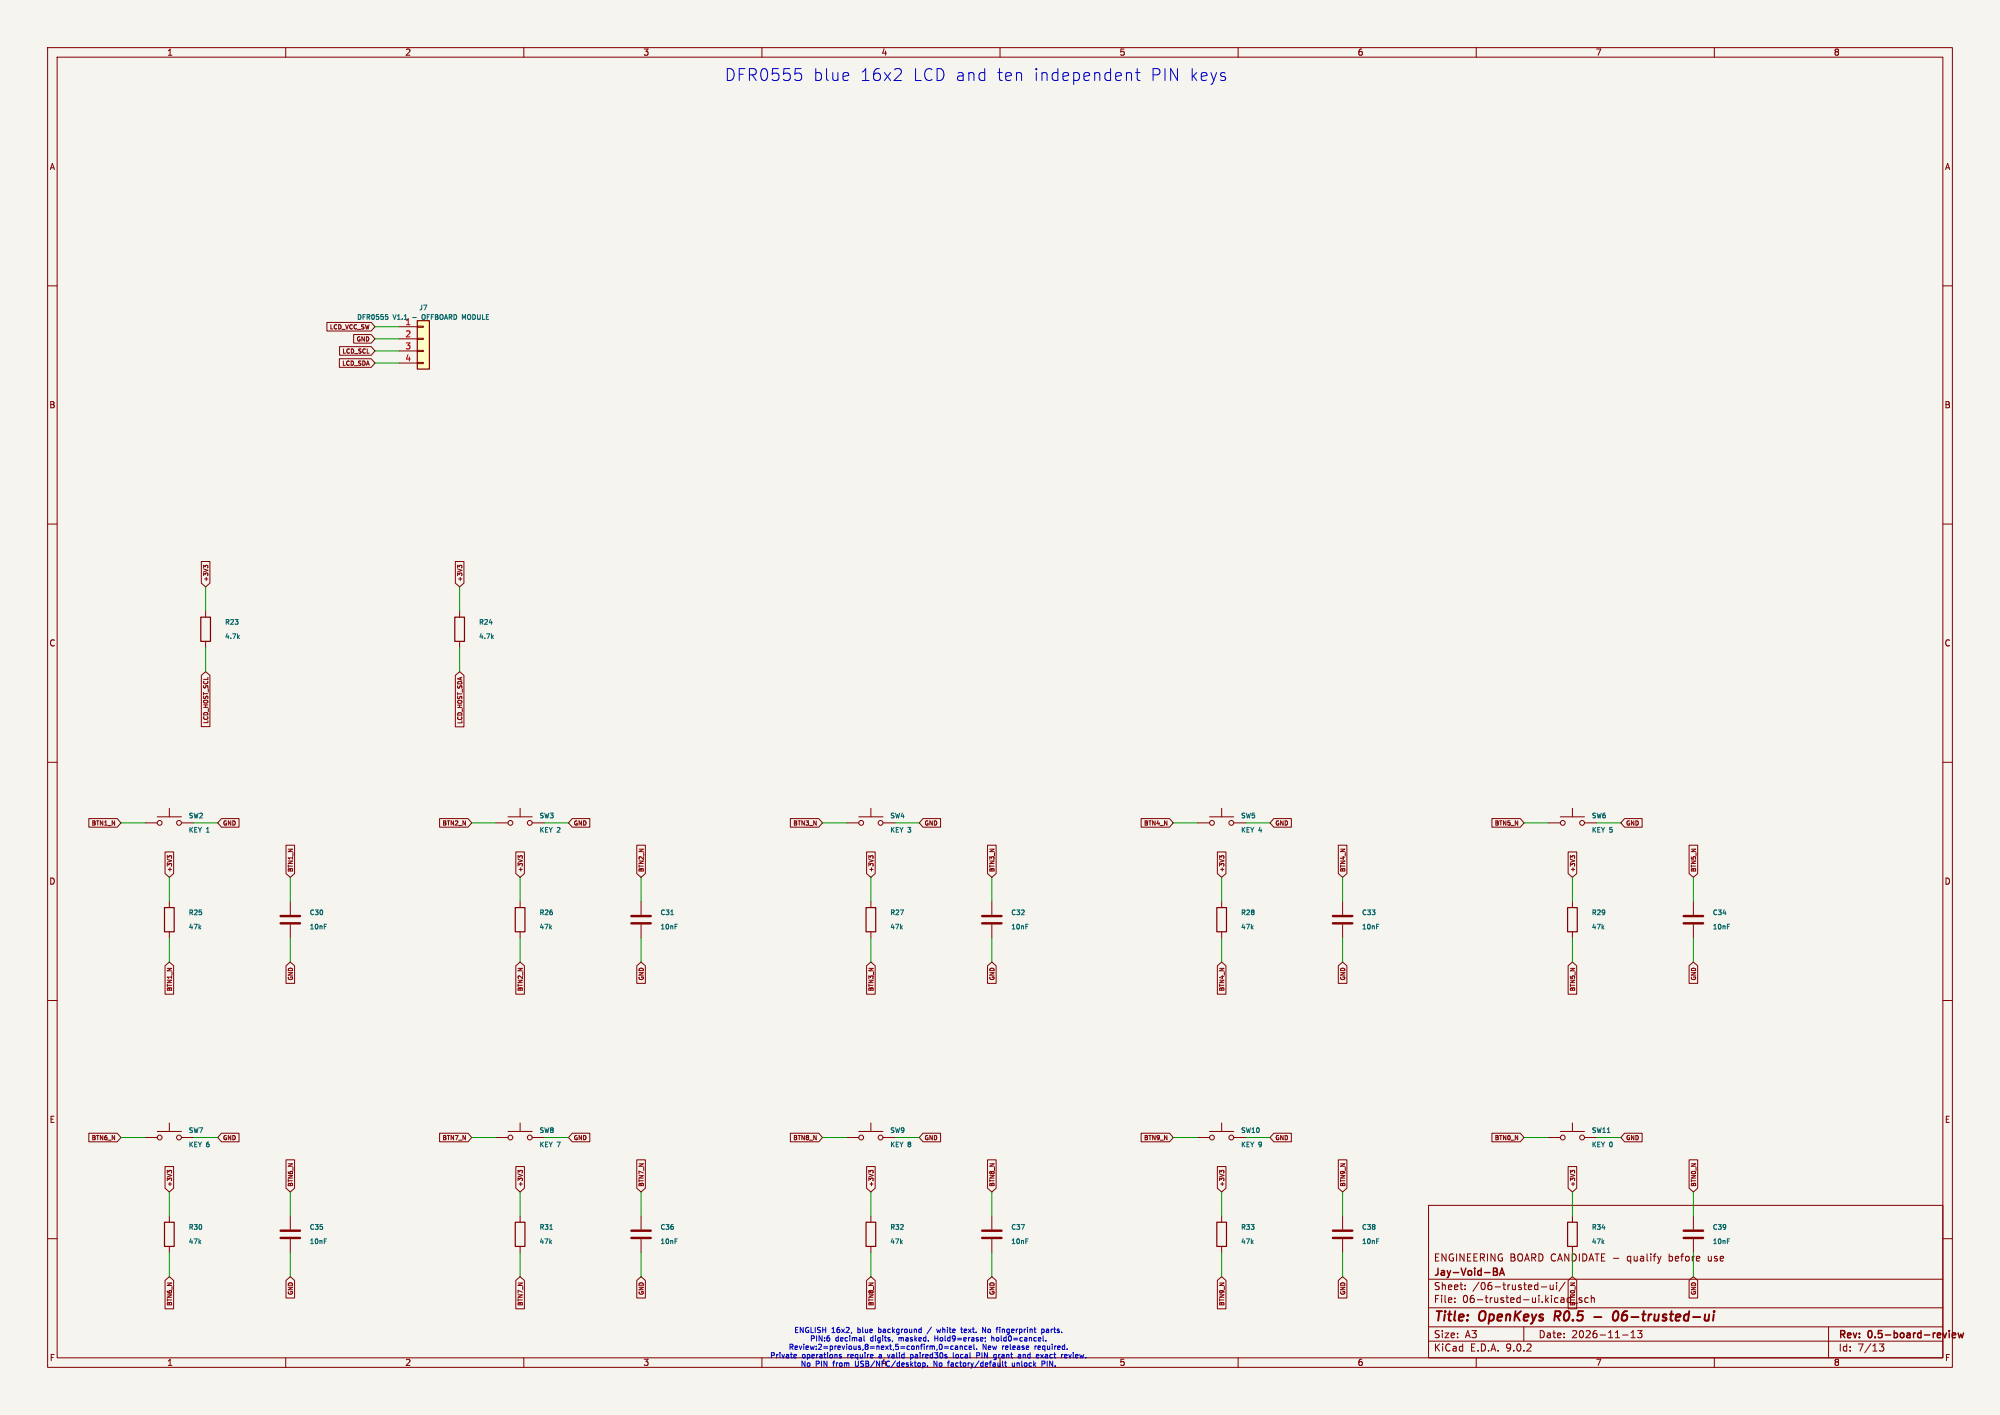
[picture p31: page 7]

Id: 7/13 Title: OpenKeys R0.5 - 06-trusted-ui File: 06-trusted-ui.kicad_sch Sheet: /06-trusted-ui/ Jay-Void-BA

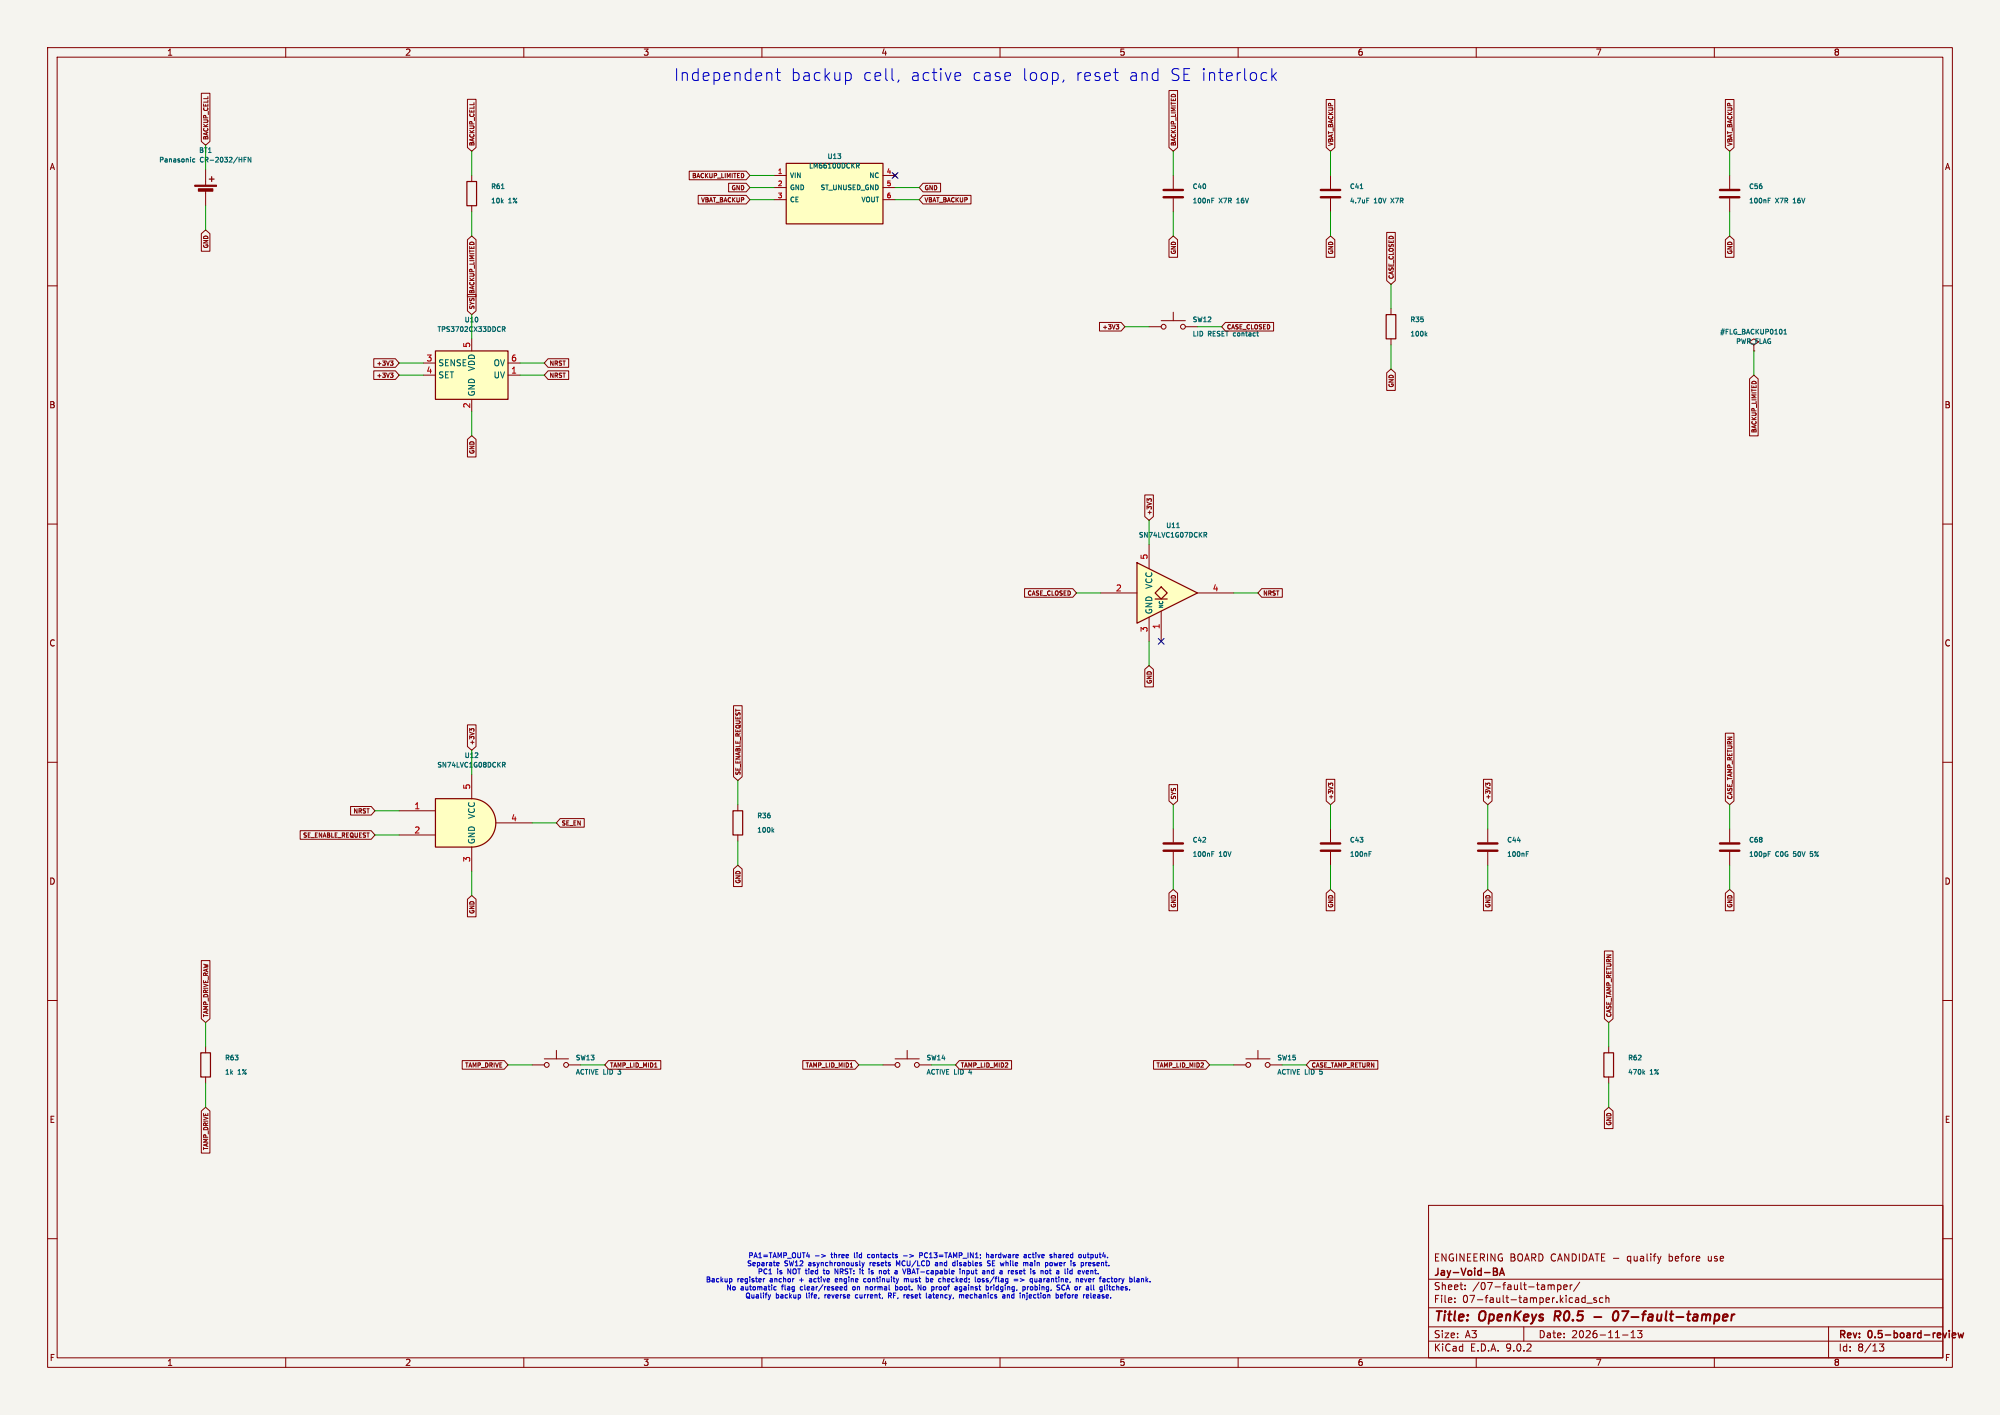
[picture p32: page 8]

Jay-Void-BA
Id: 8/13 Title: OpenKeys R0.5 - 07-fault-tamper File: 07-fault-tamper.kicad_sch Sheet: /07-fault-tamper/

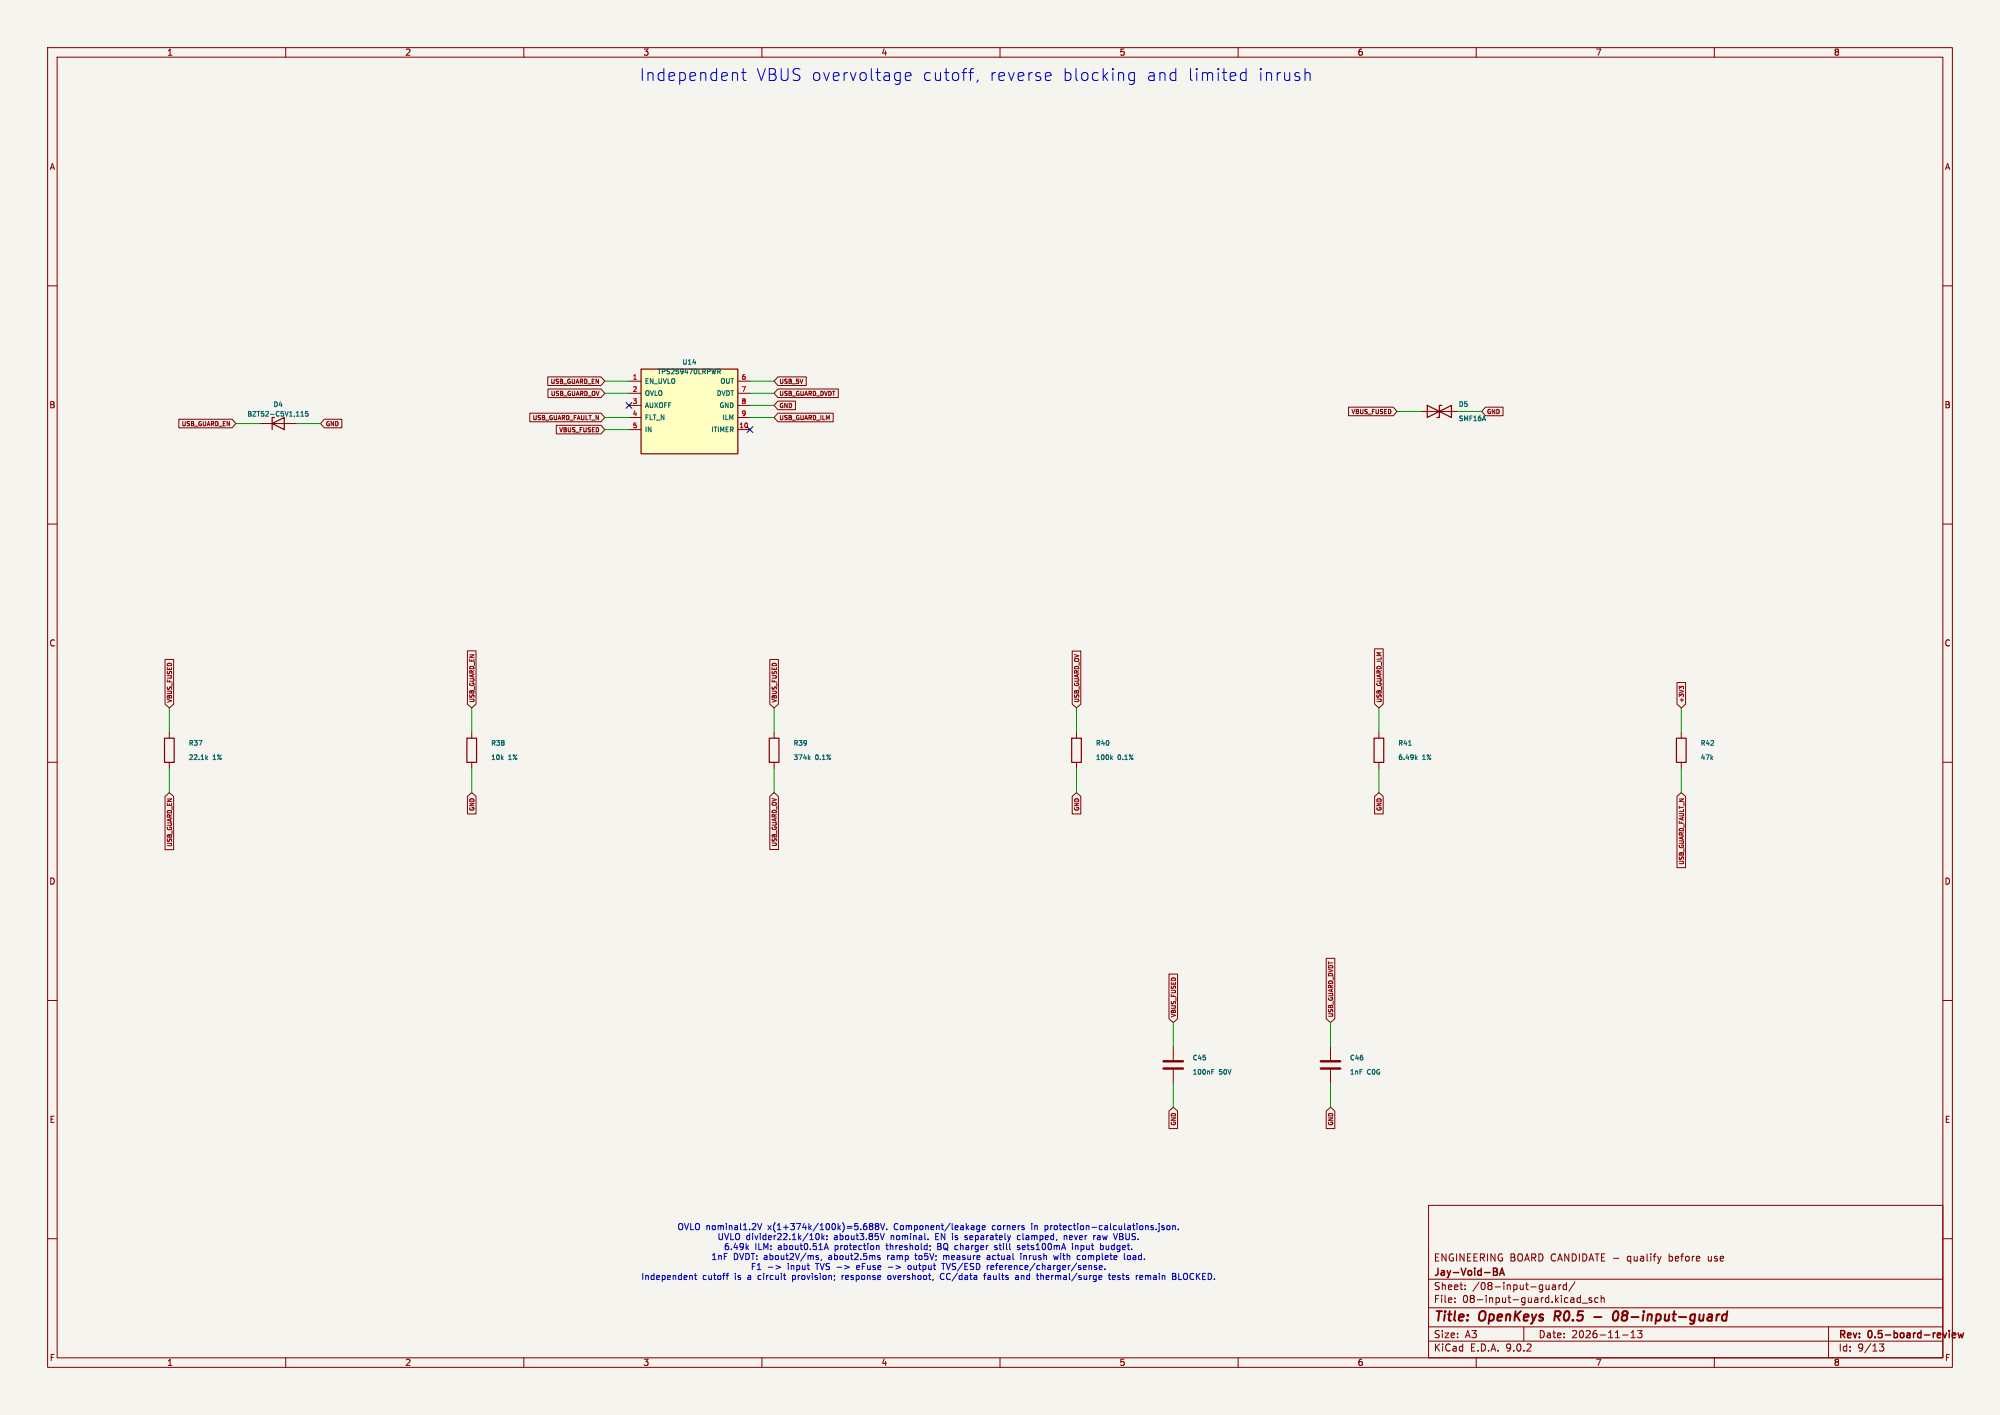
[picture p33: page 9]

Jay-Void-BA
File: 08-input-guard.kicad_sch Sheet: /08-input-guard/
Id: 9/13 Title: OpenKeys R0.5 - 08-input-guard

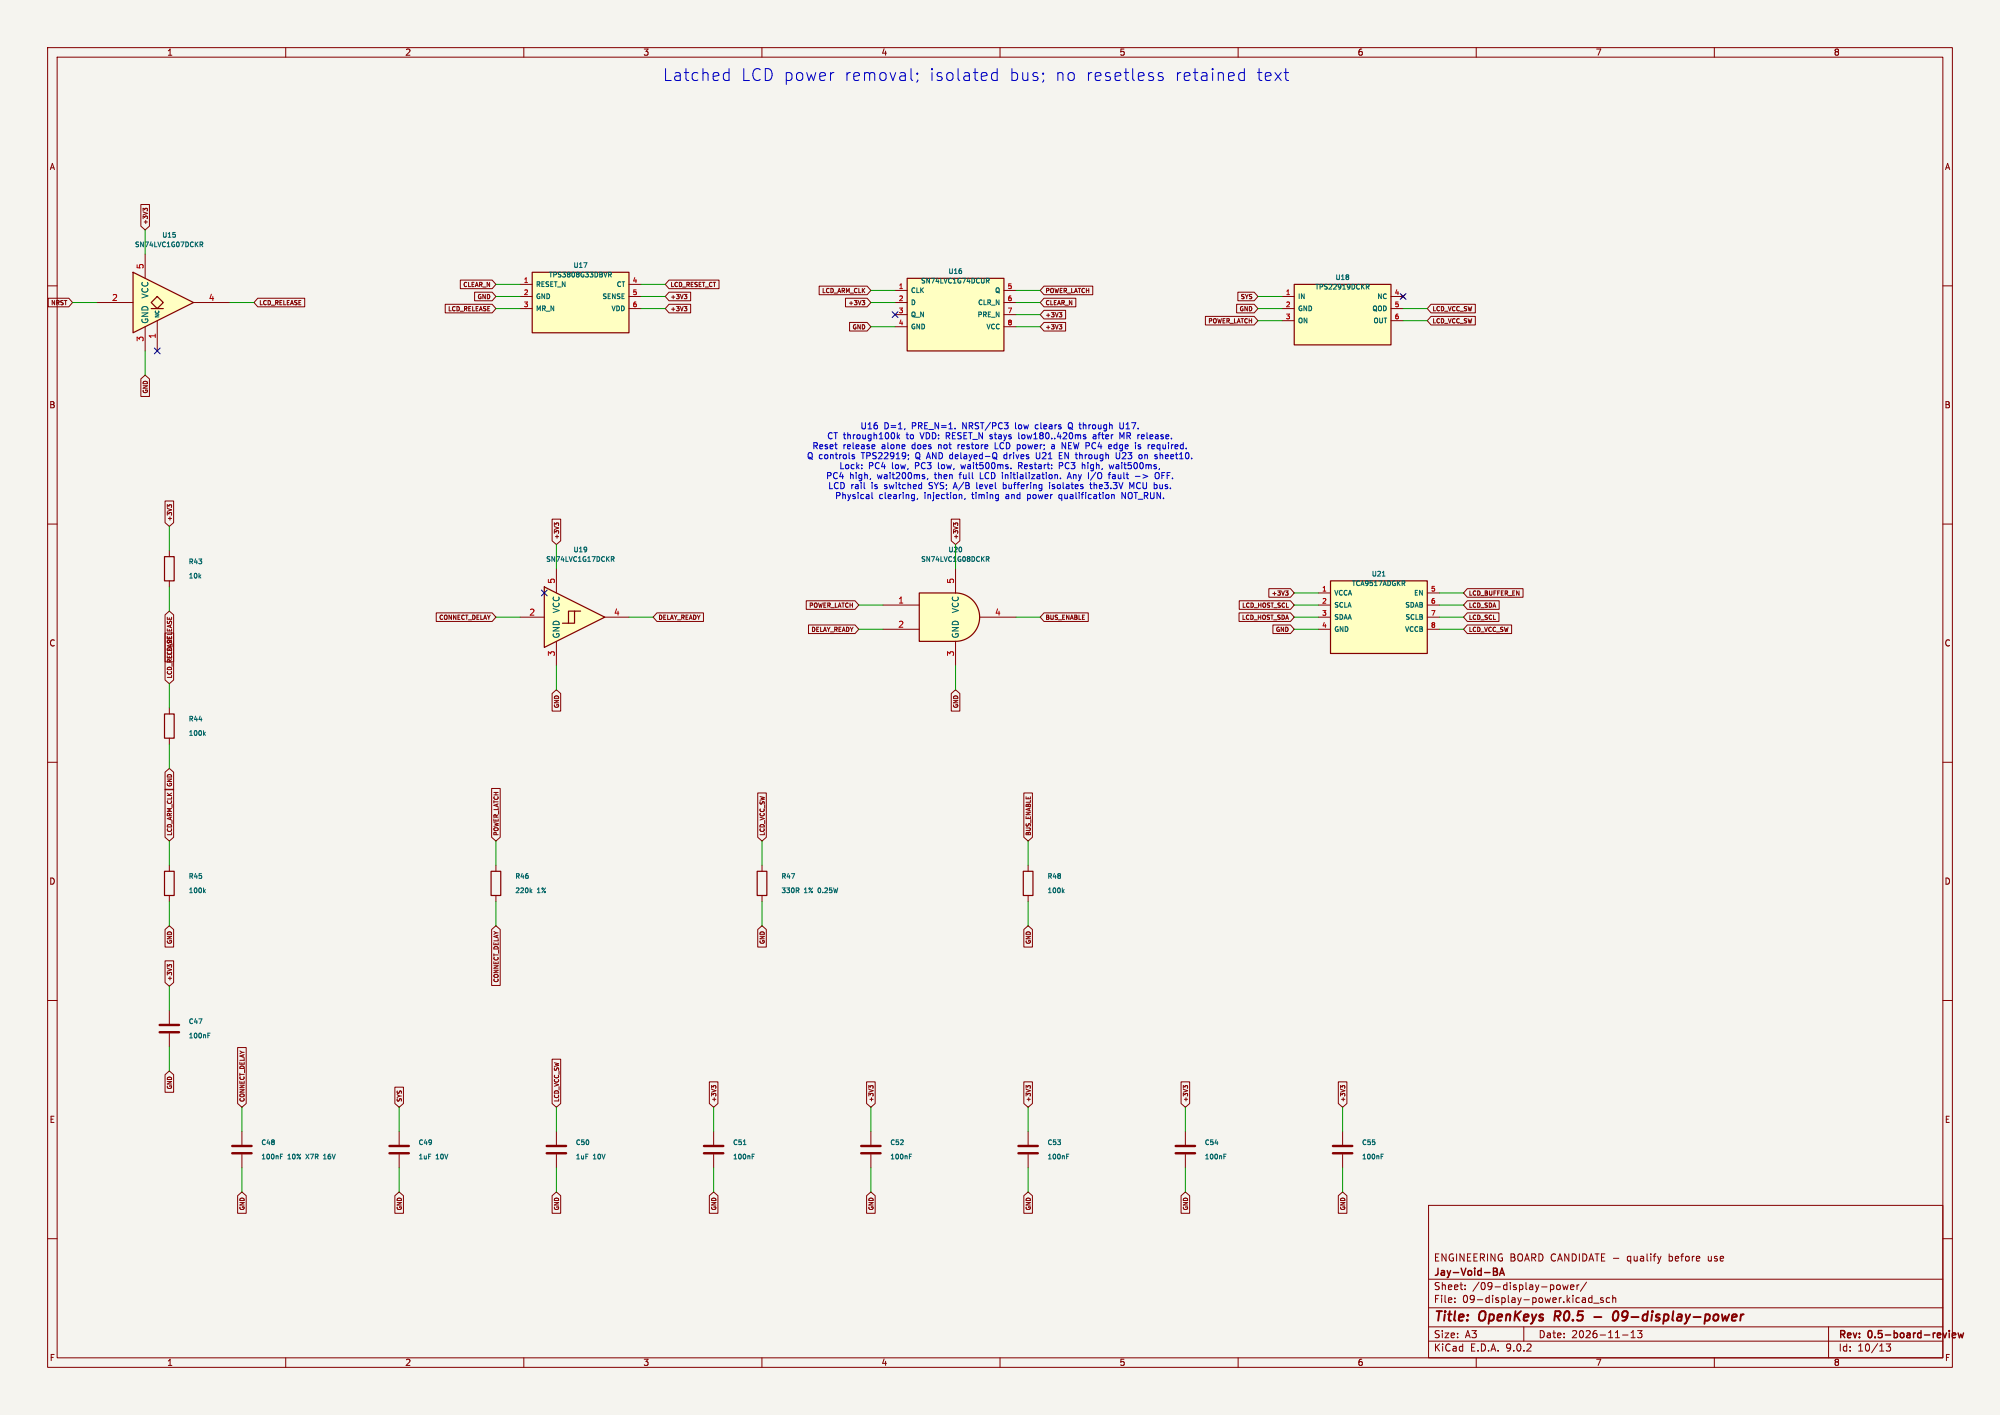
[picture p34: page 10]

Jay-Void-BA
Id: 10/13 Title: OpenKeys R0.5 - 09-display-power File: 09-display-power.kicad_sch Sheet: /09-display-power/

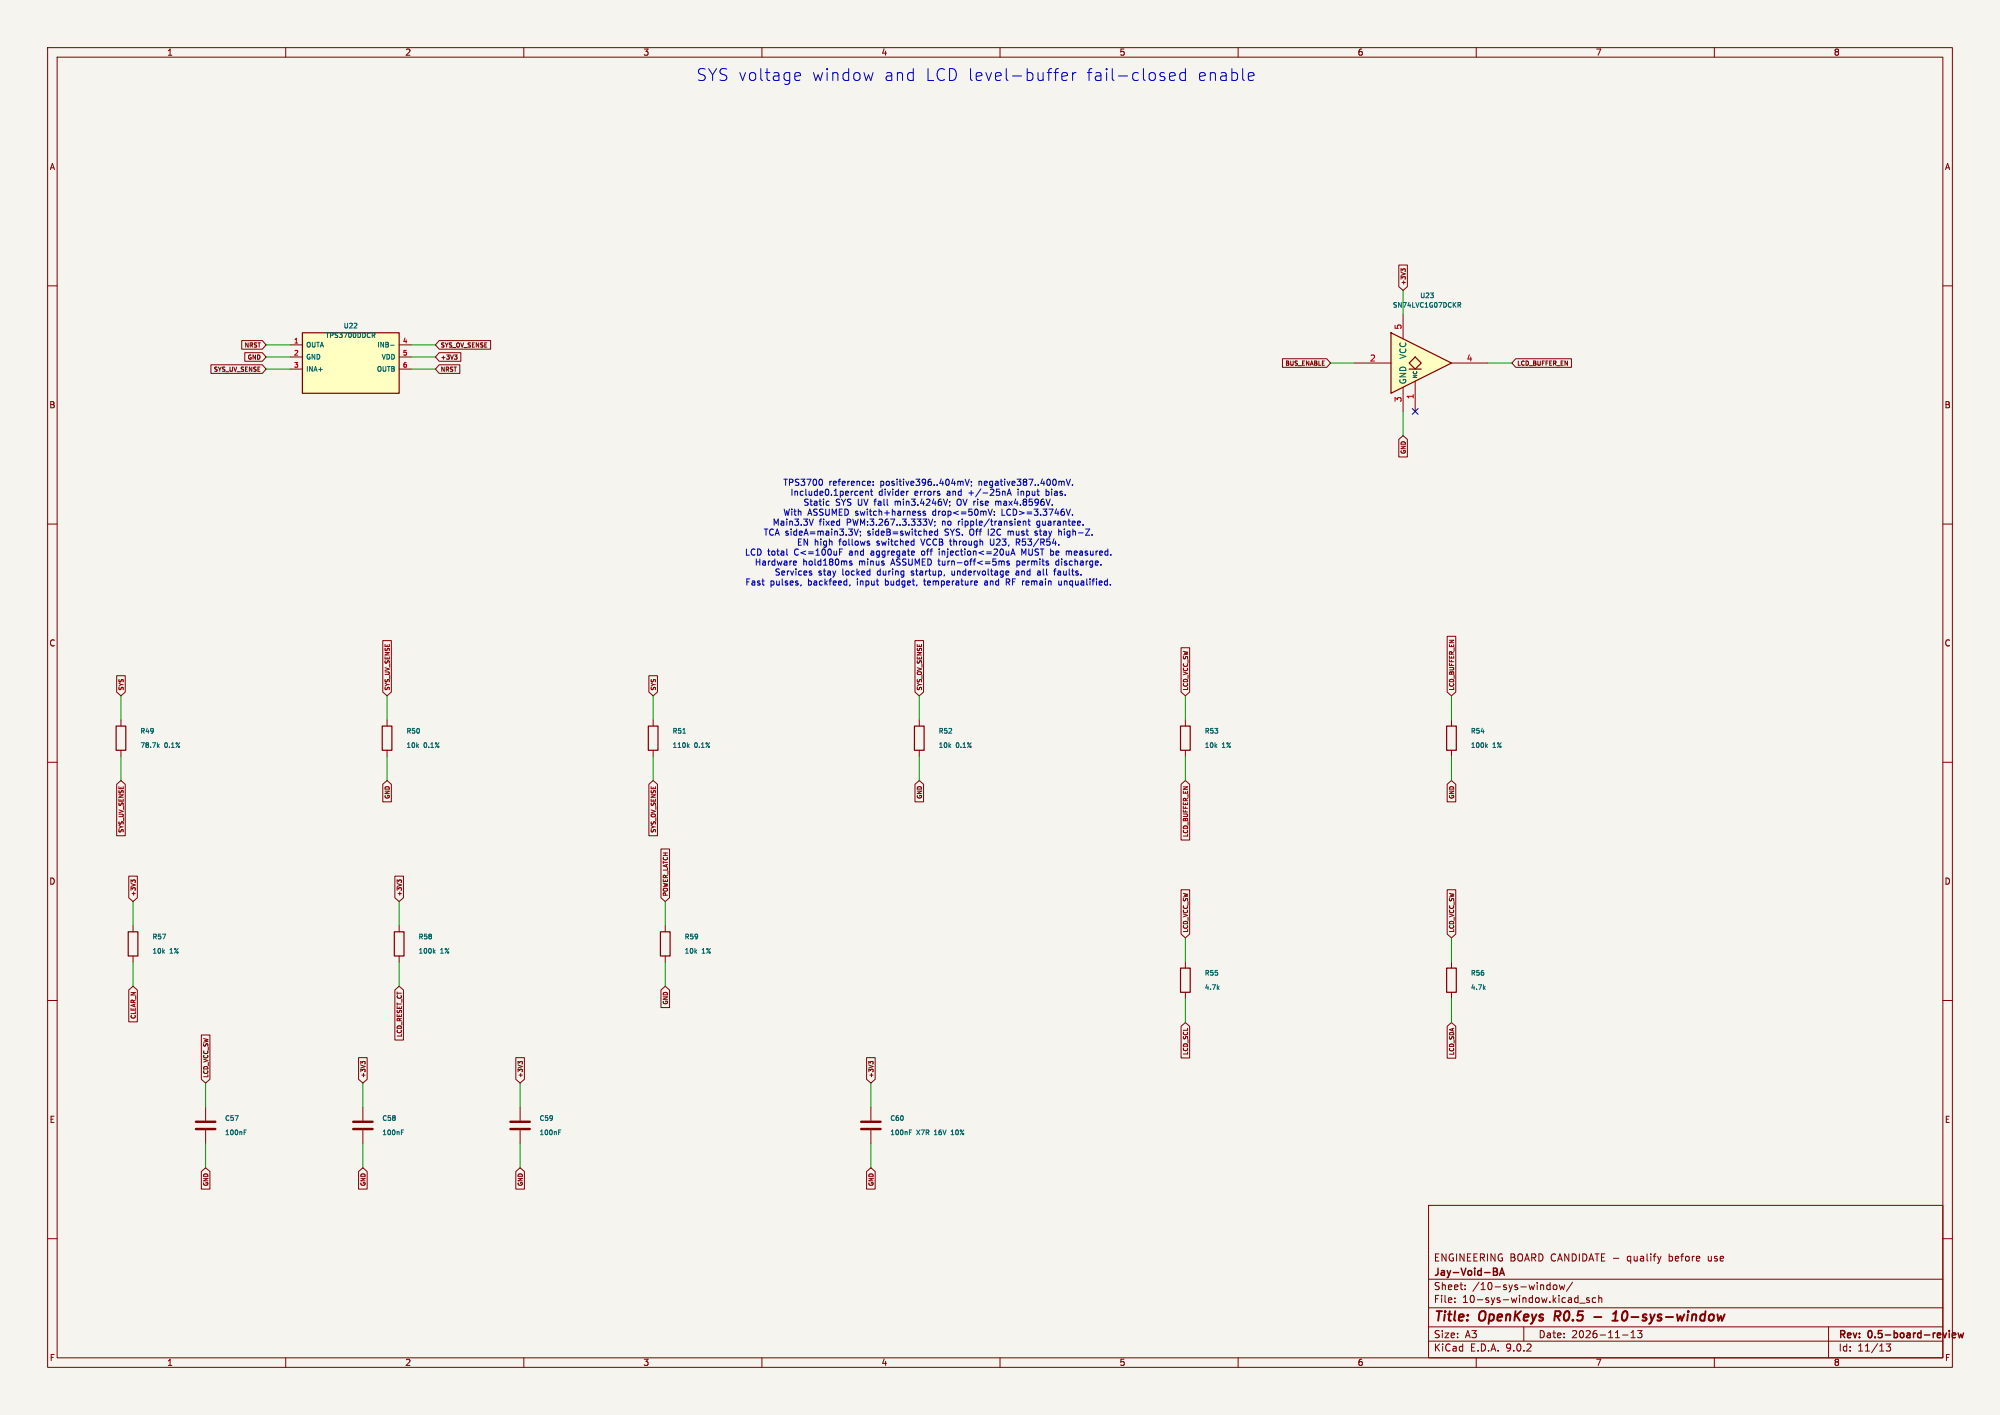
[picture p35: page 11]

Jay-Void-BA
File: 10-sys-window.kicad_sch Sheet: /10-sys-window/
Id: 11/13 Title: OpenKeys R0.5 - 10-sys-window

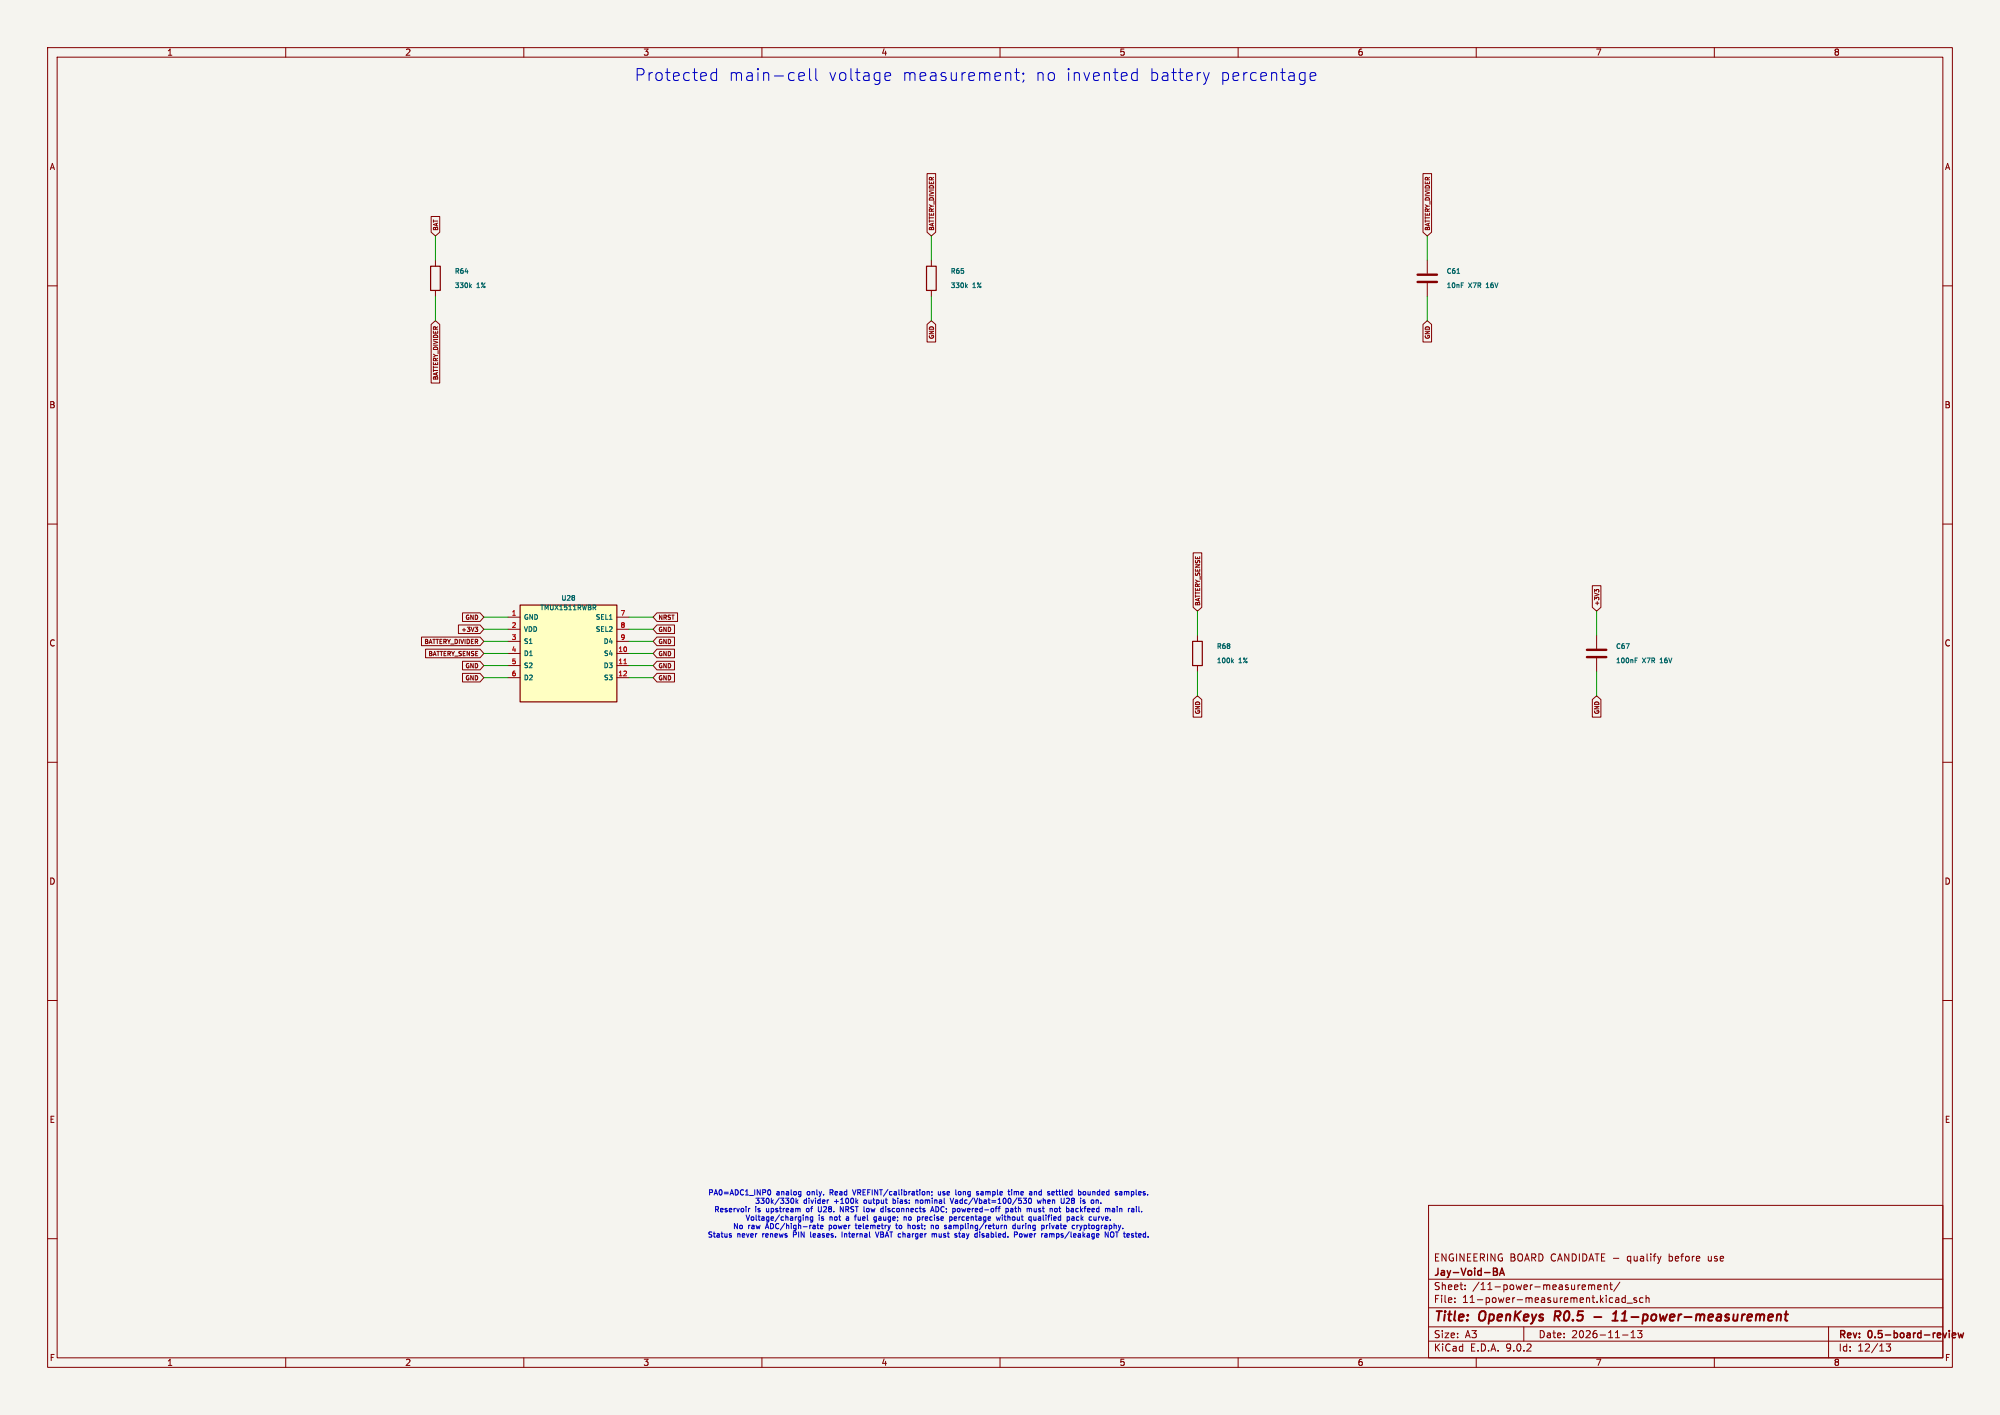
[picture p36: page 12]

Jay-Void-BA
Id: 12/13 Title: OpenKeys R0.5 - 11-power-measurement File: 11-power-measurement.kicad_sch Sheet: /11-power-measurement/

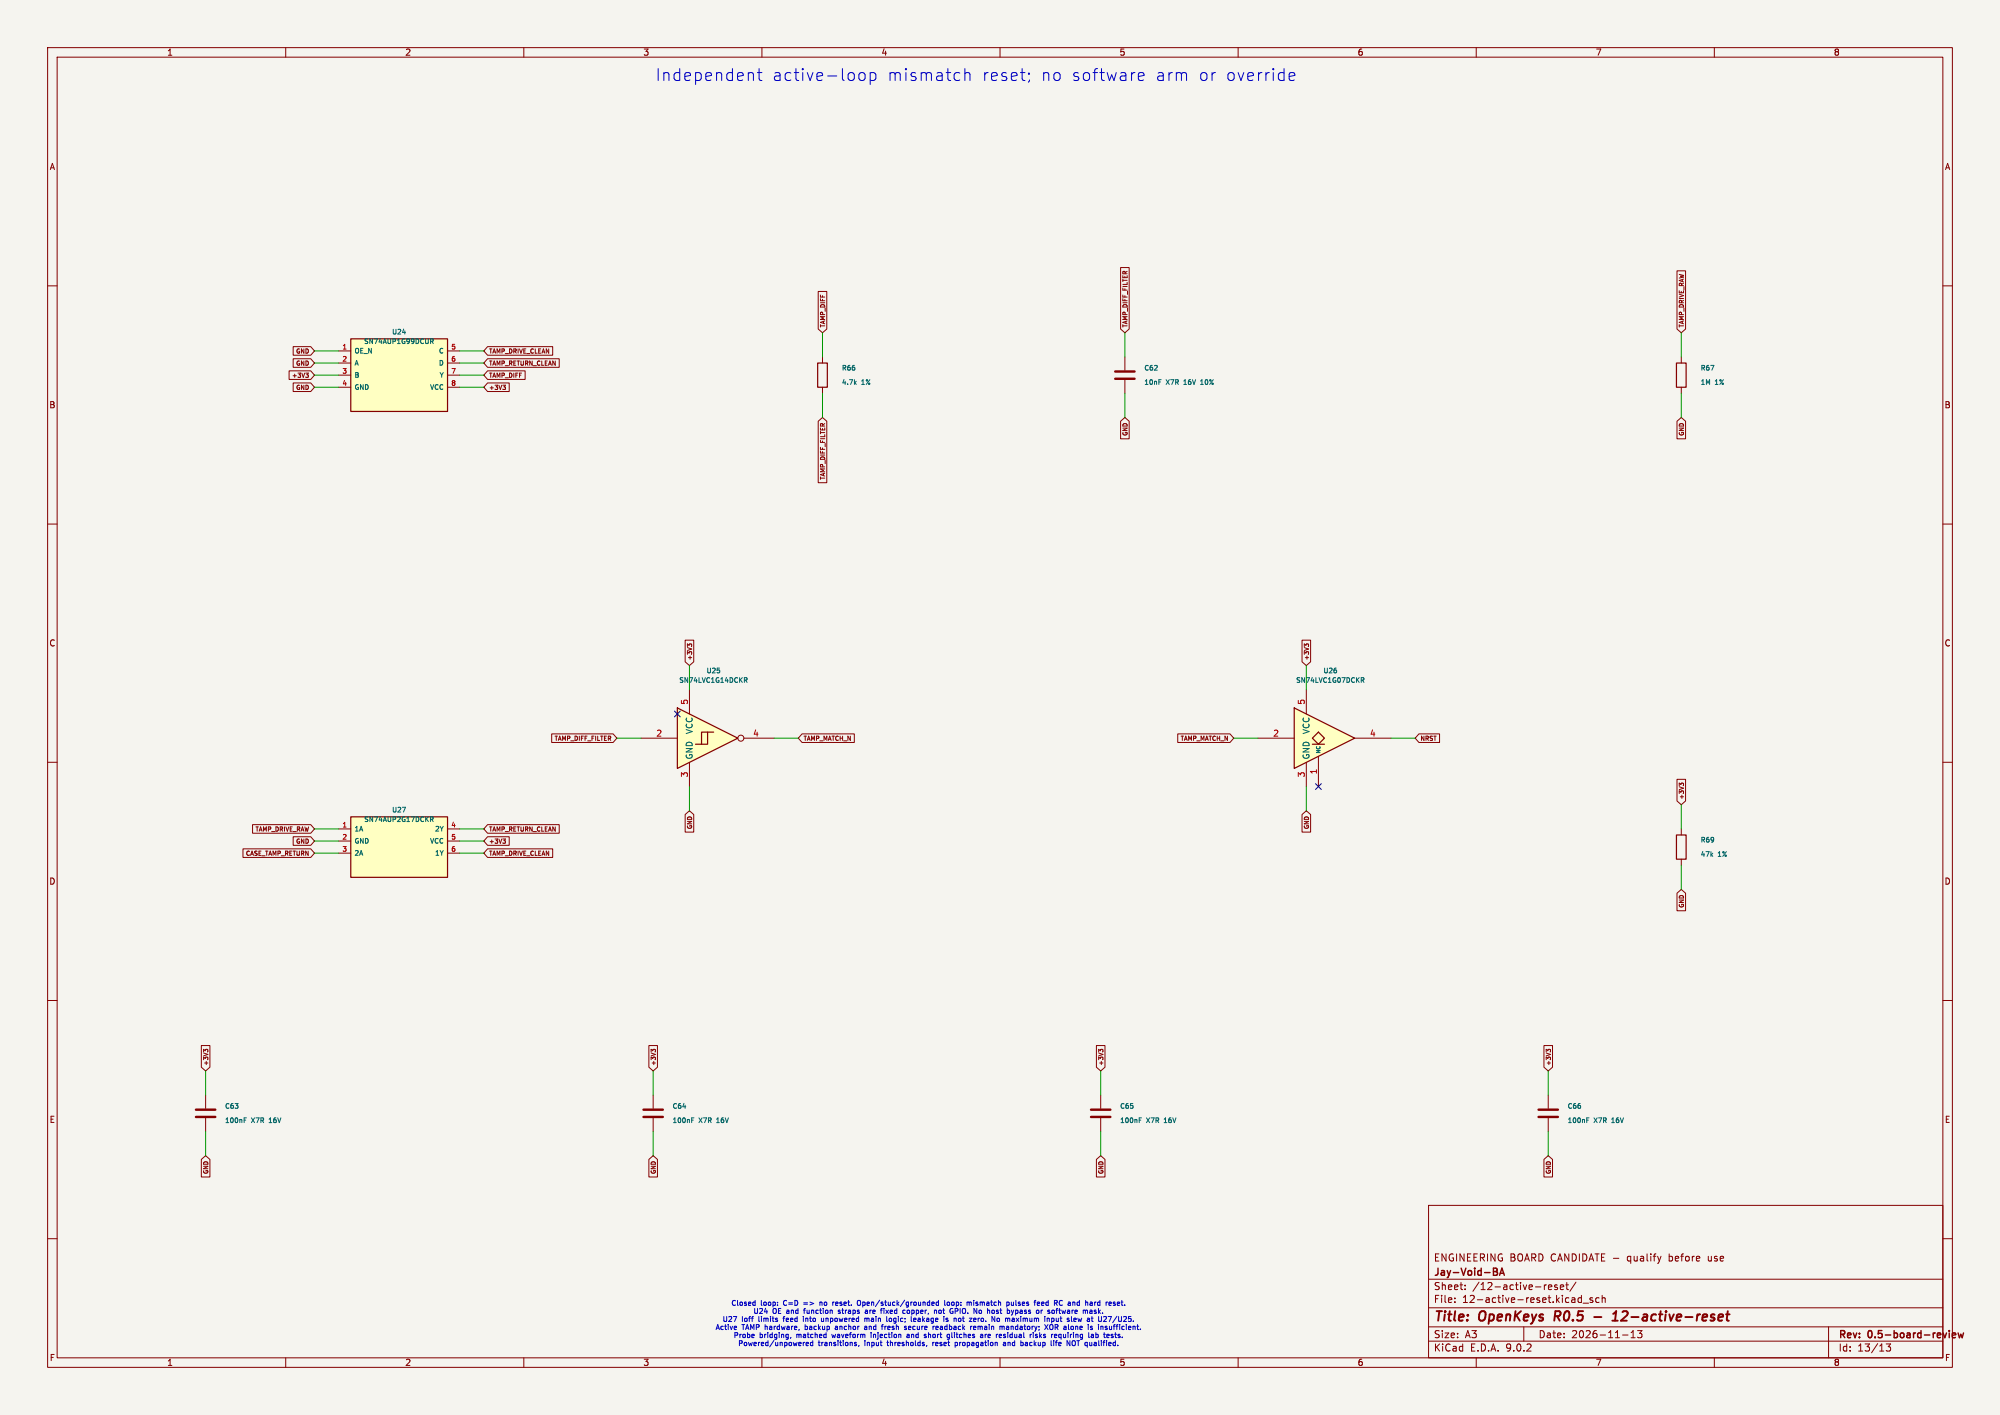
[picture p37: page 13]

Id: 13/13 Title: OpenKeys R0.5 - 12-active-reset File: 12-active-reset.kicad_sch Sheet: /12-active-reset/ Jay-Void-BA
