Jay-Void-BA/OpenKeys/hardware/exports/OpenKeys-dimensions.pdf

# OPENKEYS / R0

## MECHANICAL DESIGN REVIEW · 2026-11-08

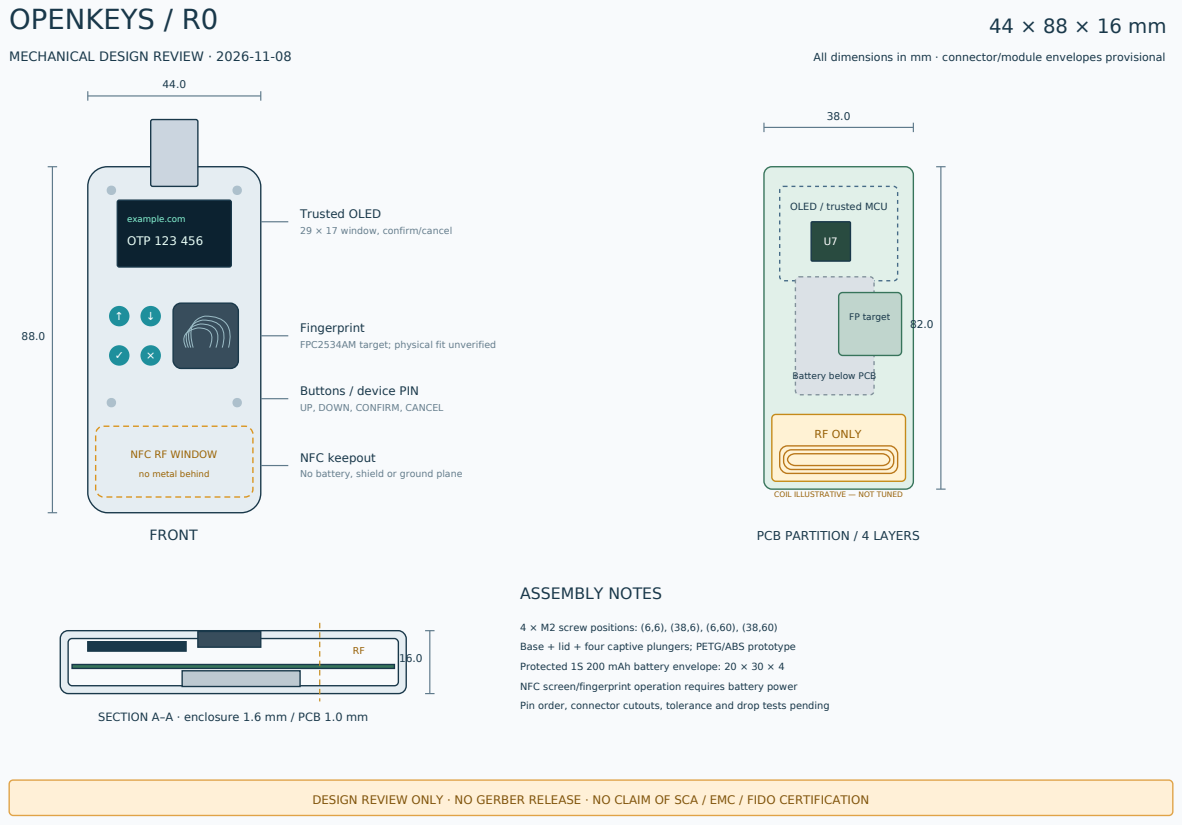
[picture p38: page 1]
example.com; OTP 123 456; FRONT; FP target; RF ONLY; ASSEMBLY NOTES

All dimensions in mm · connector/module envelopes provisional

Trusted OLED
29 × 17 window, confirm/cancel

OLED / trusted MCU

Fingerprint
FPC2534AM target; physical fit unverified

Battery below PCB

Buttons / device PIN
UP, DOWN, CONFIRM, CANCEL

NFC RF WINDOW

NFC keepout
No battery, shield or ground plane

no metal behind

COIL ILLUSTRATIVE — NOT TUNED

PCB PARTITION / 4 LAYERS

4 × M2 screw positions: (6,6), (38,6), (6,60), (38,60)
Base + lid + four captive plungers; PETG/ABS prototype
Protected 1S 200 mAh battery envelope: 20 × 30 × 4
NFC screen/fingerprint operation requires battery power
Pin order, connector cutouts, tolerance and drop tests pending

SECTION A–A · enclosure 1.6 mm / PCB 1.0 mm

DESIGN REVIEW ONLY · NO GERBER RELEASE · NO CLAIM OF SCA / EMC / FIDO CERTIFICATION
