Jay-Void-BA/OpenKeys/hardware/exports/OpenKeys-schematic.pdf

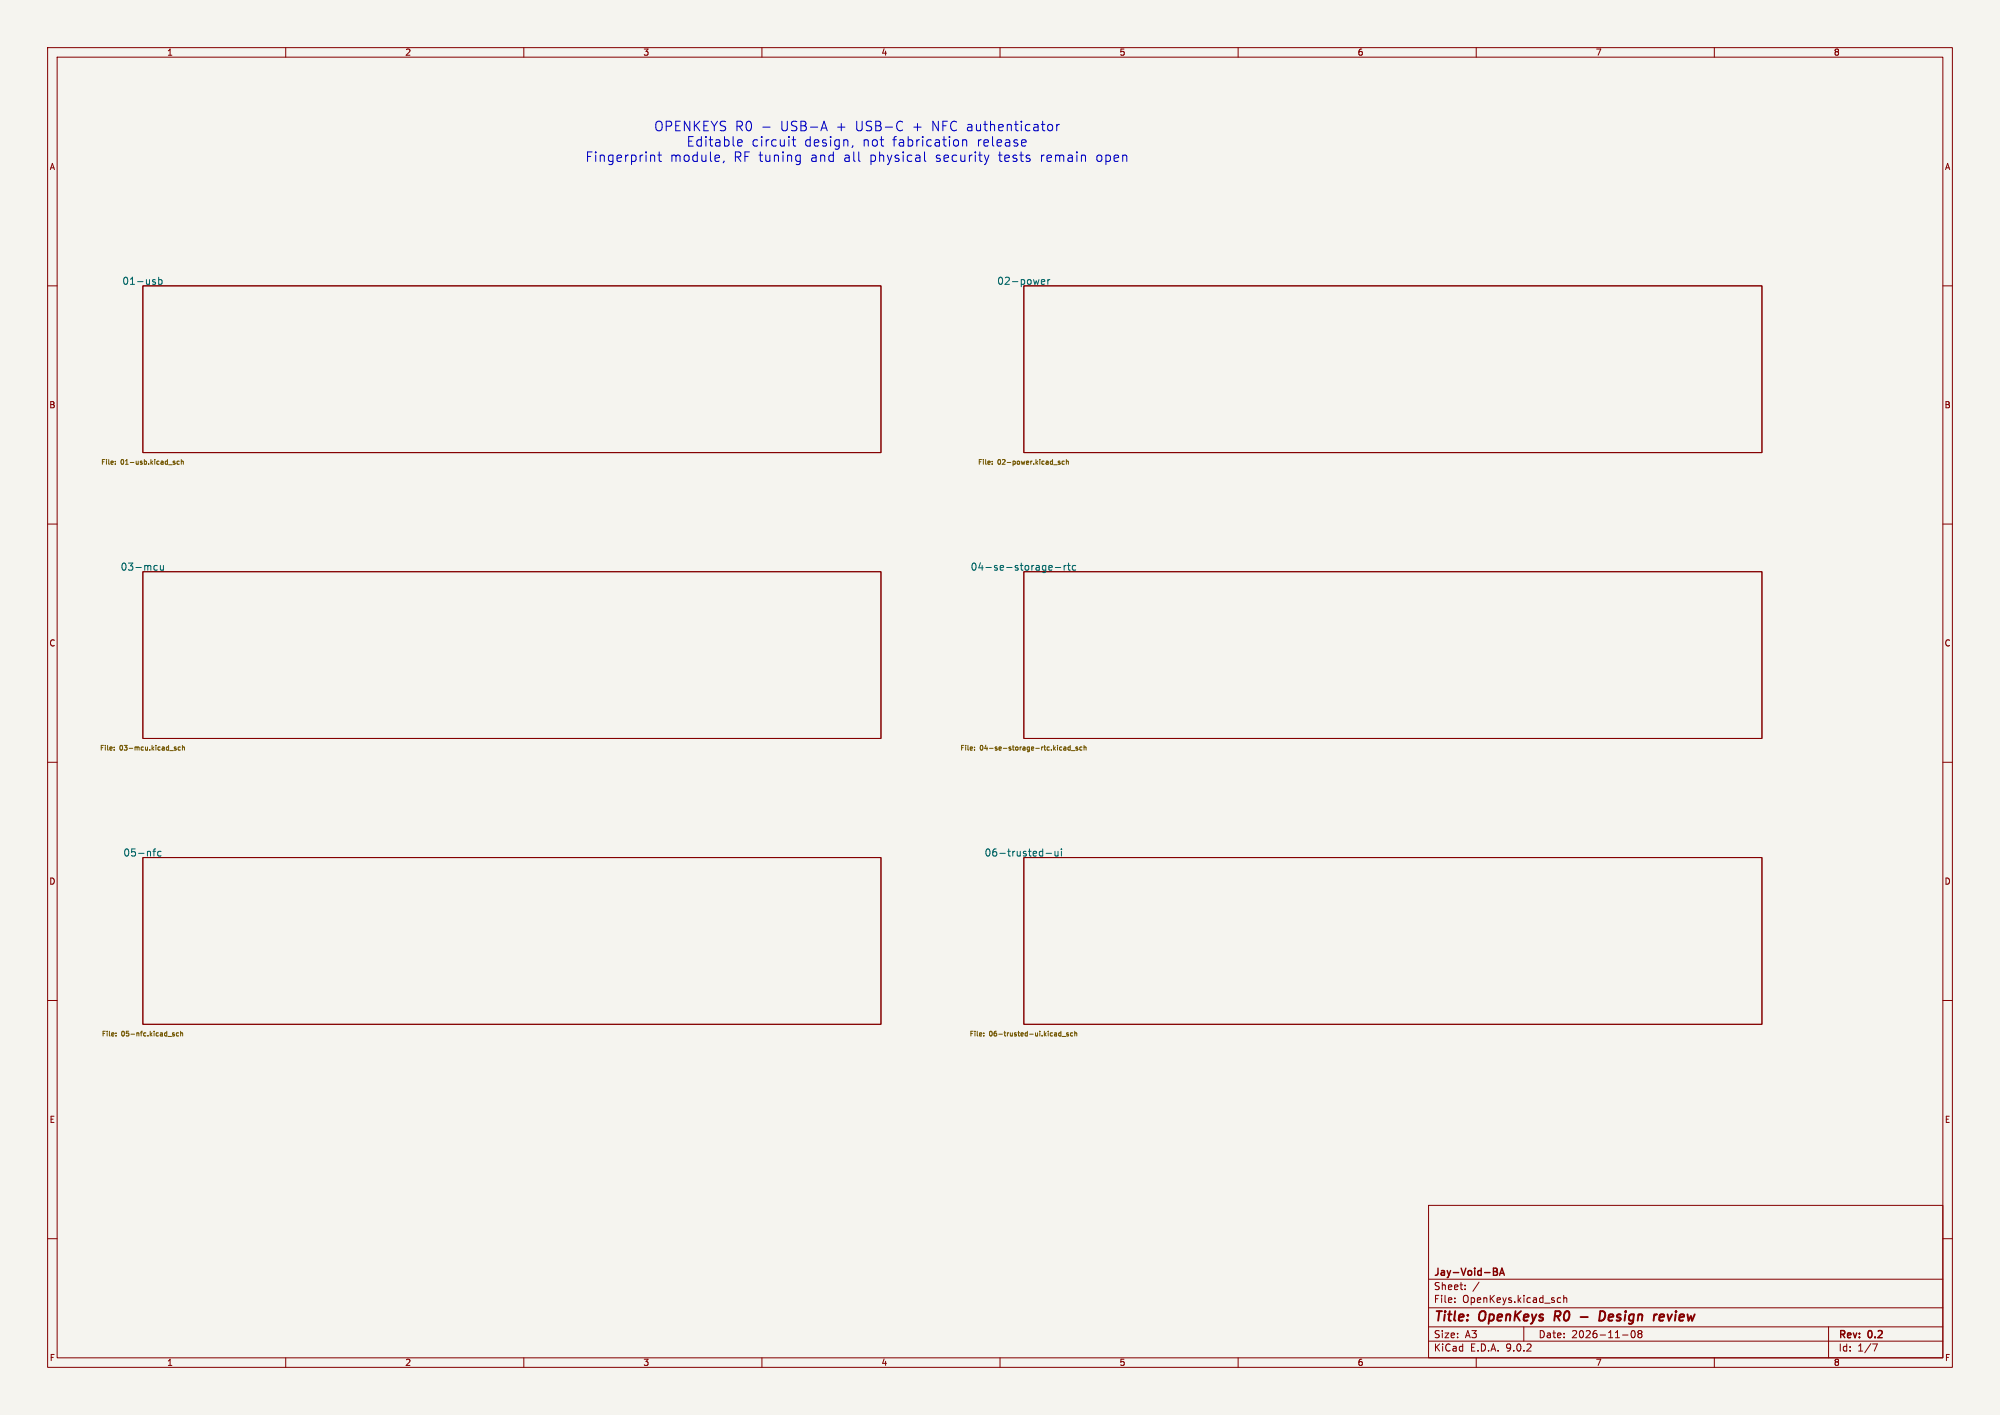
[picture p39: page 1]

File: 04-se-storage-rtc.kicad_sch 05-nfc

File: OpenKeys.kicad_sch Sheet: / Jay-Void-BA

Id: 1/7 Title: OpenKeys R0 - Design review

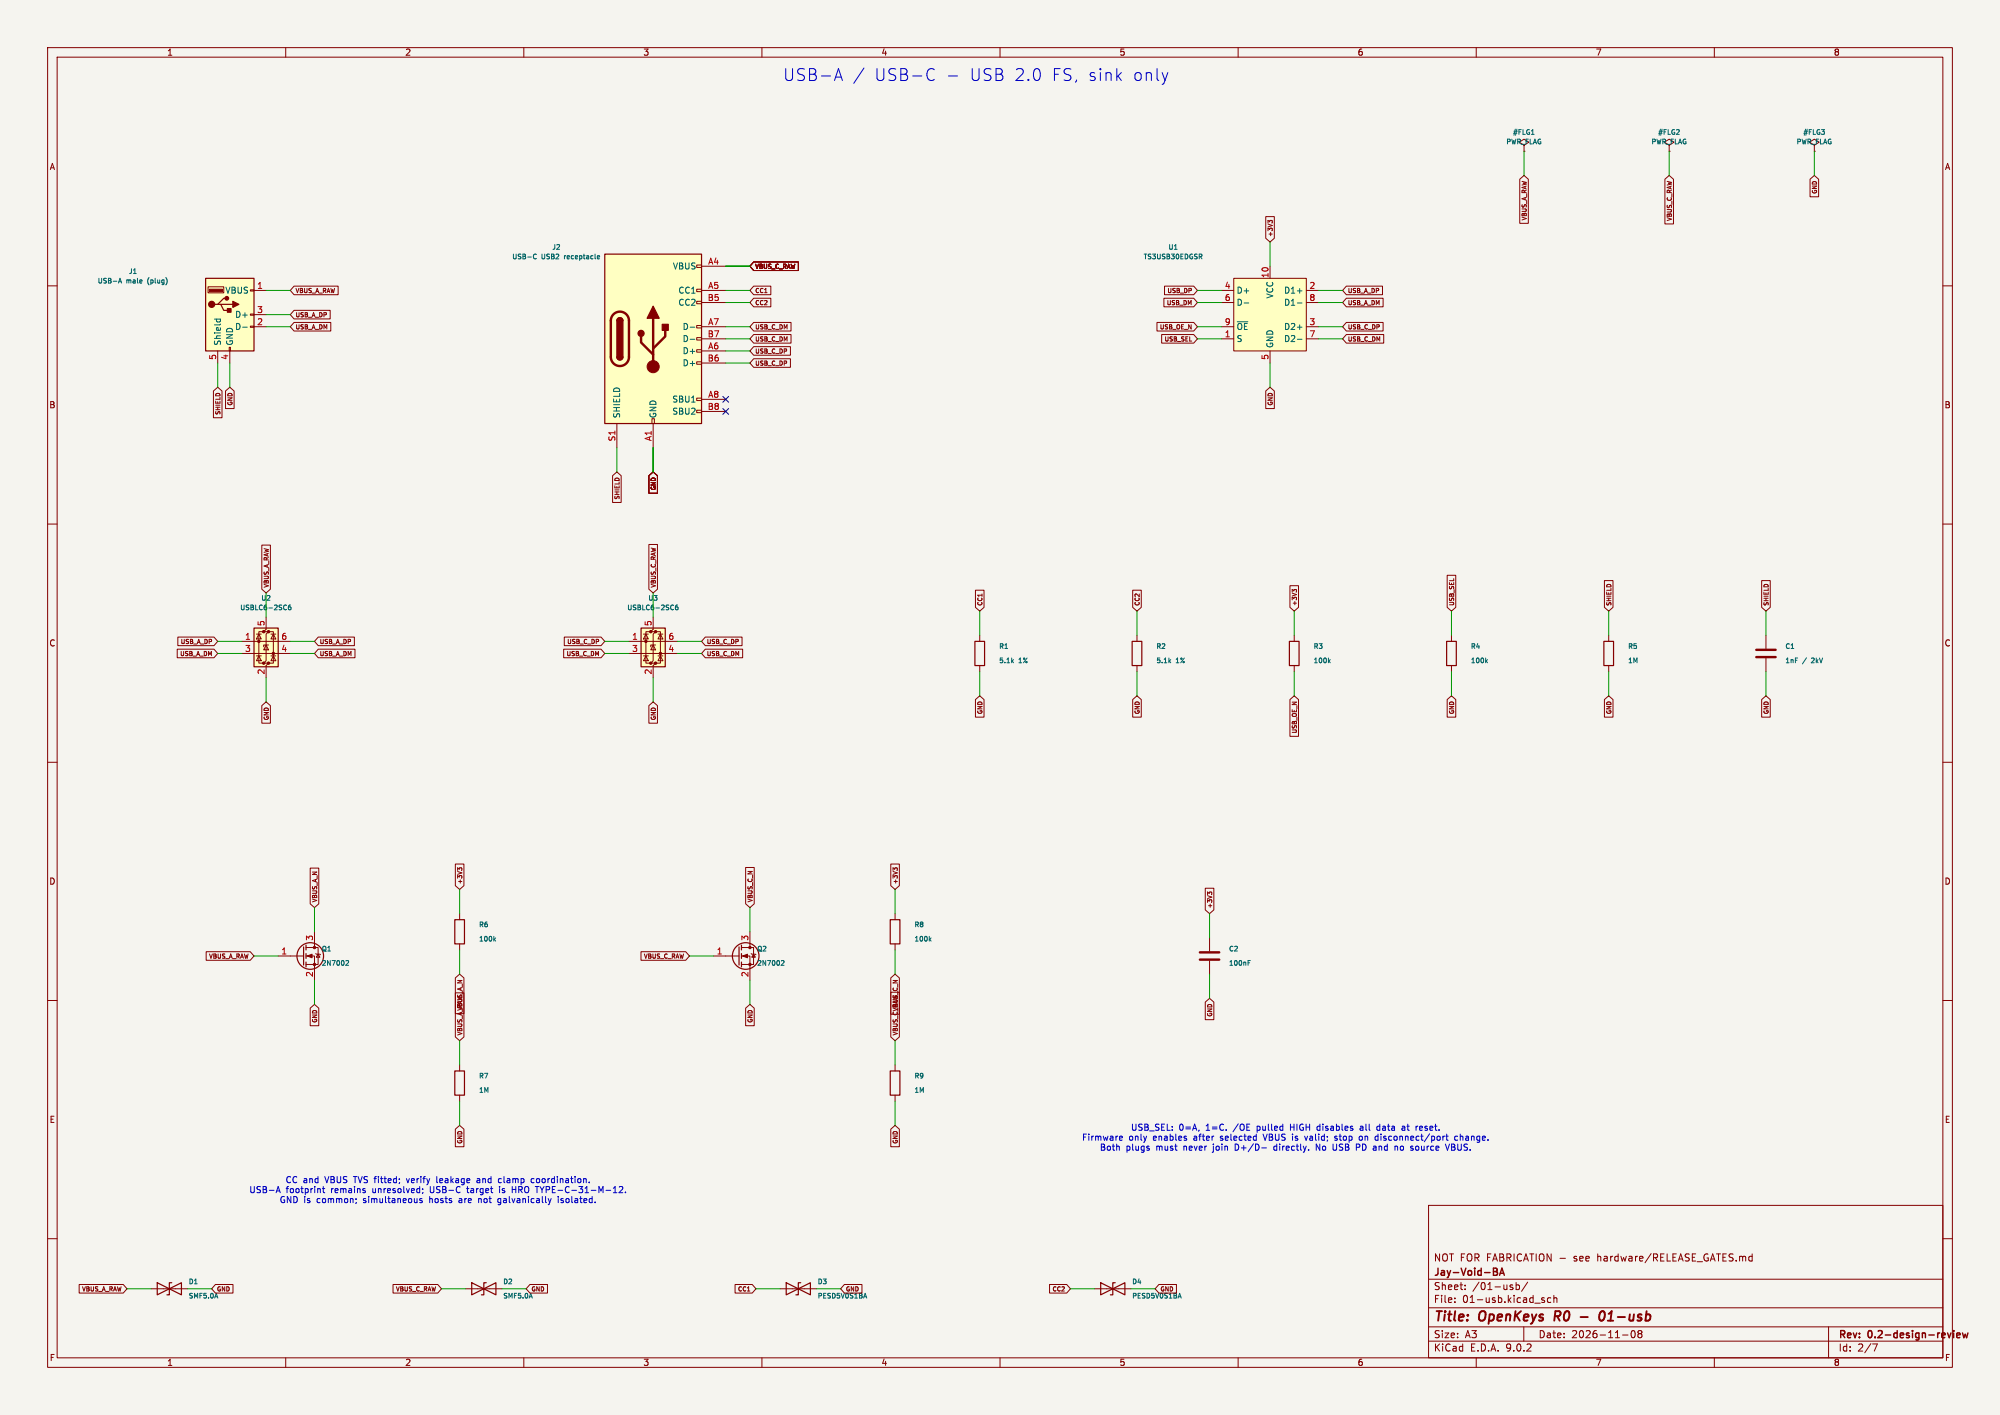
[picture p40: page 2]

USB-A / USB-C - USB 2.0 FS, sink only

File: 01-usb.kicad_sch Sheet: /01-usb/ Jay-Void-BA

Id: 2/7 Title: OpenKeys R0 - 01-usb

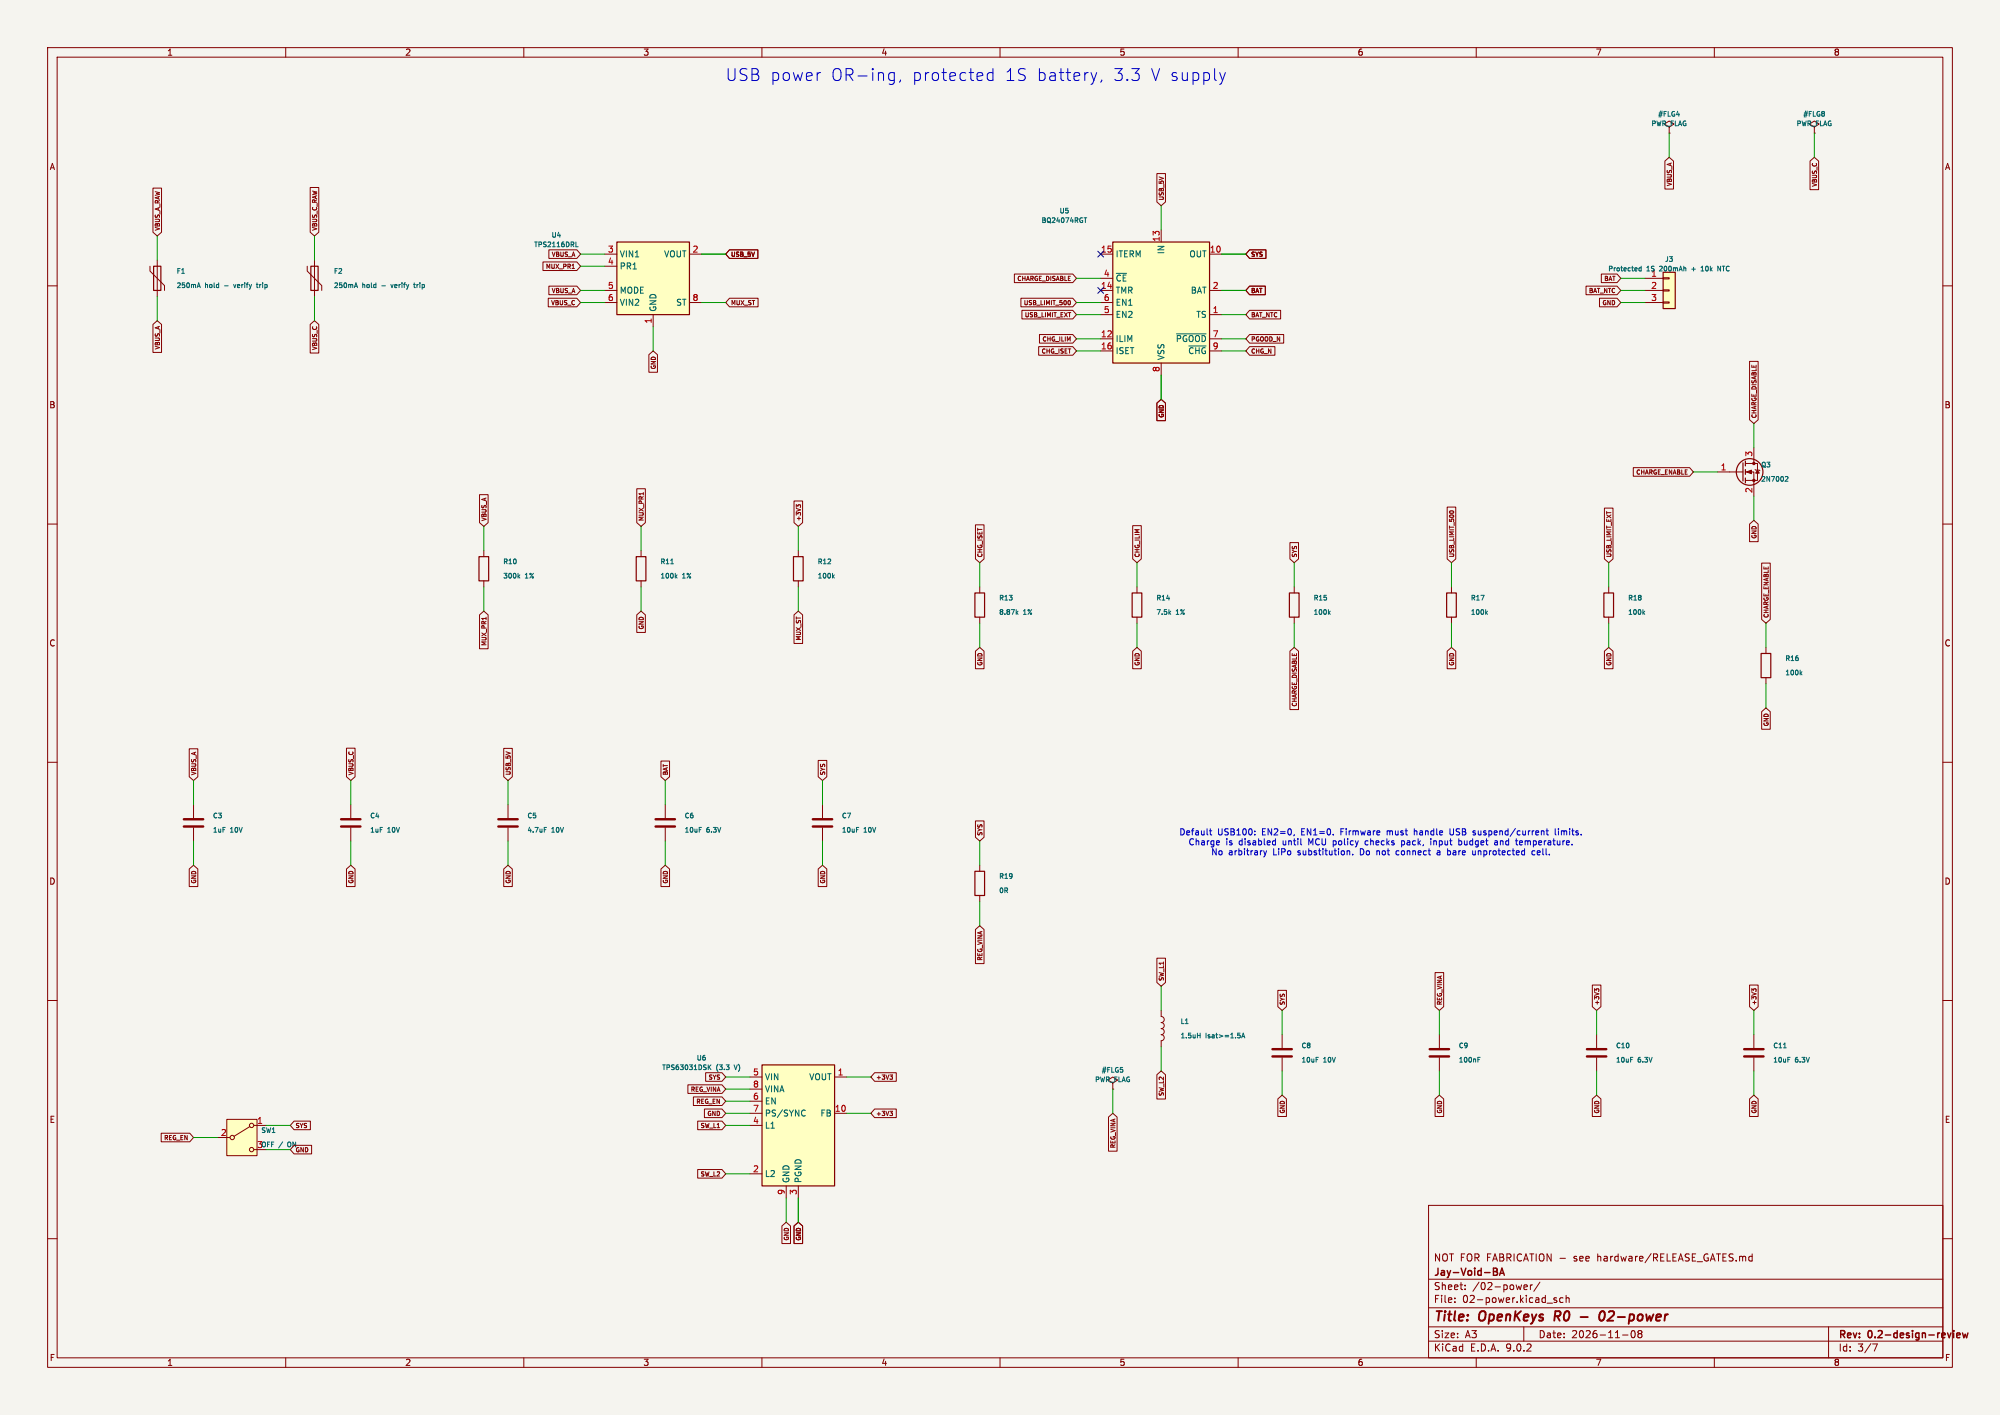
[picture p41: page 3]

8 OUT 10 BAT 2 TS 1 ~{PGOOD}7 ~{CHG}9 U5 BQ24074RGT 1

Jay-Void-BA
Id: 3/7 Title: OpenKeys R0 - 02-power File: 02-power.kicad_sch Sheet: /02-power/

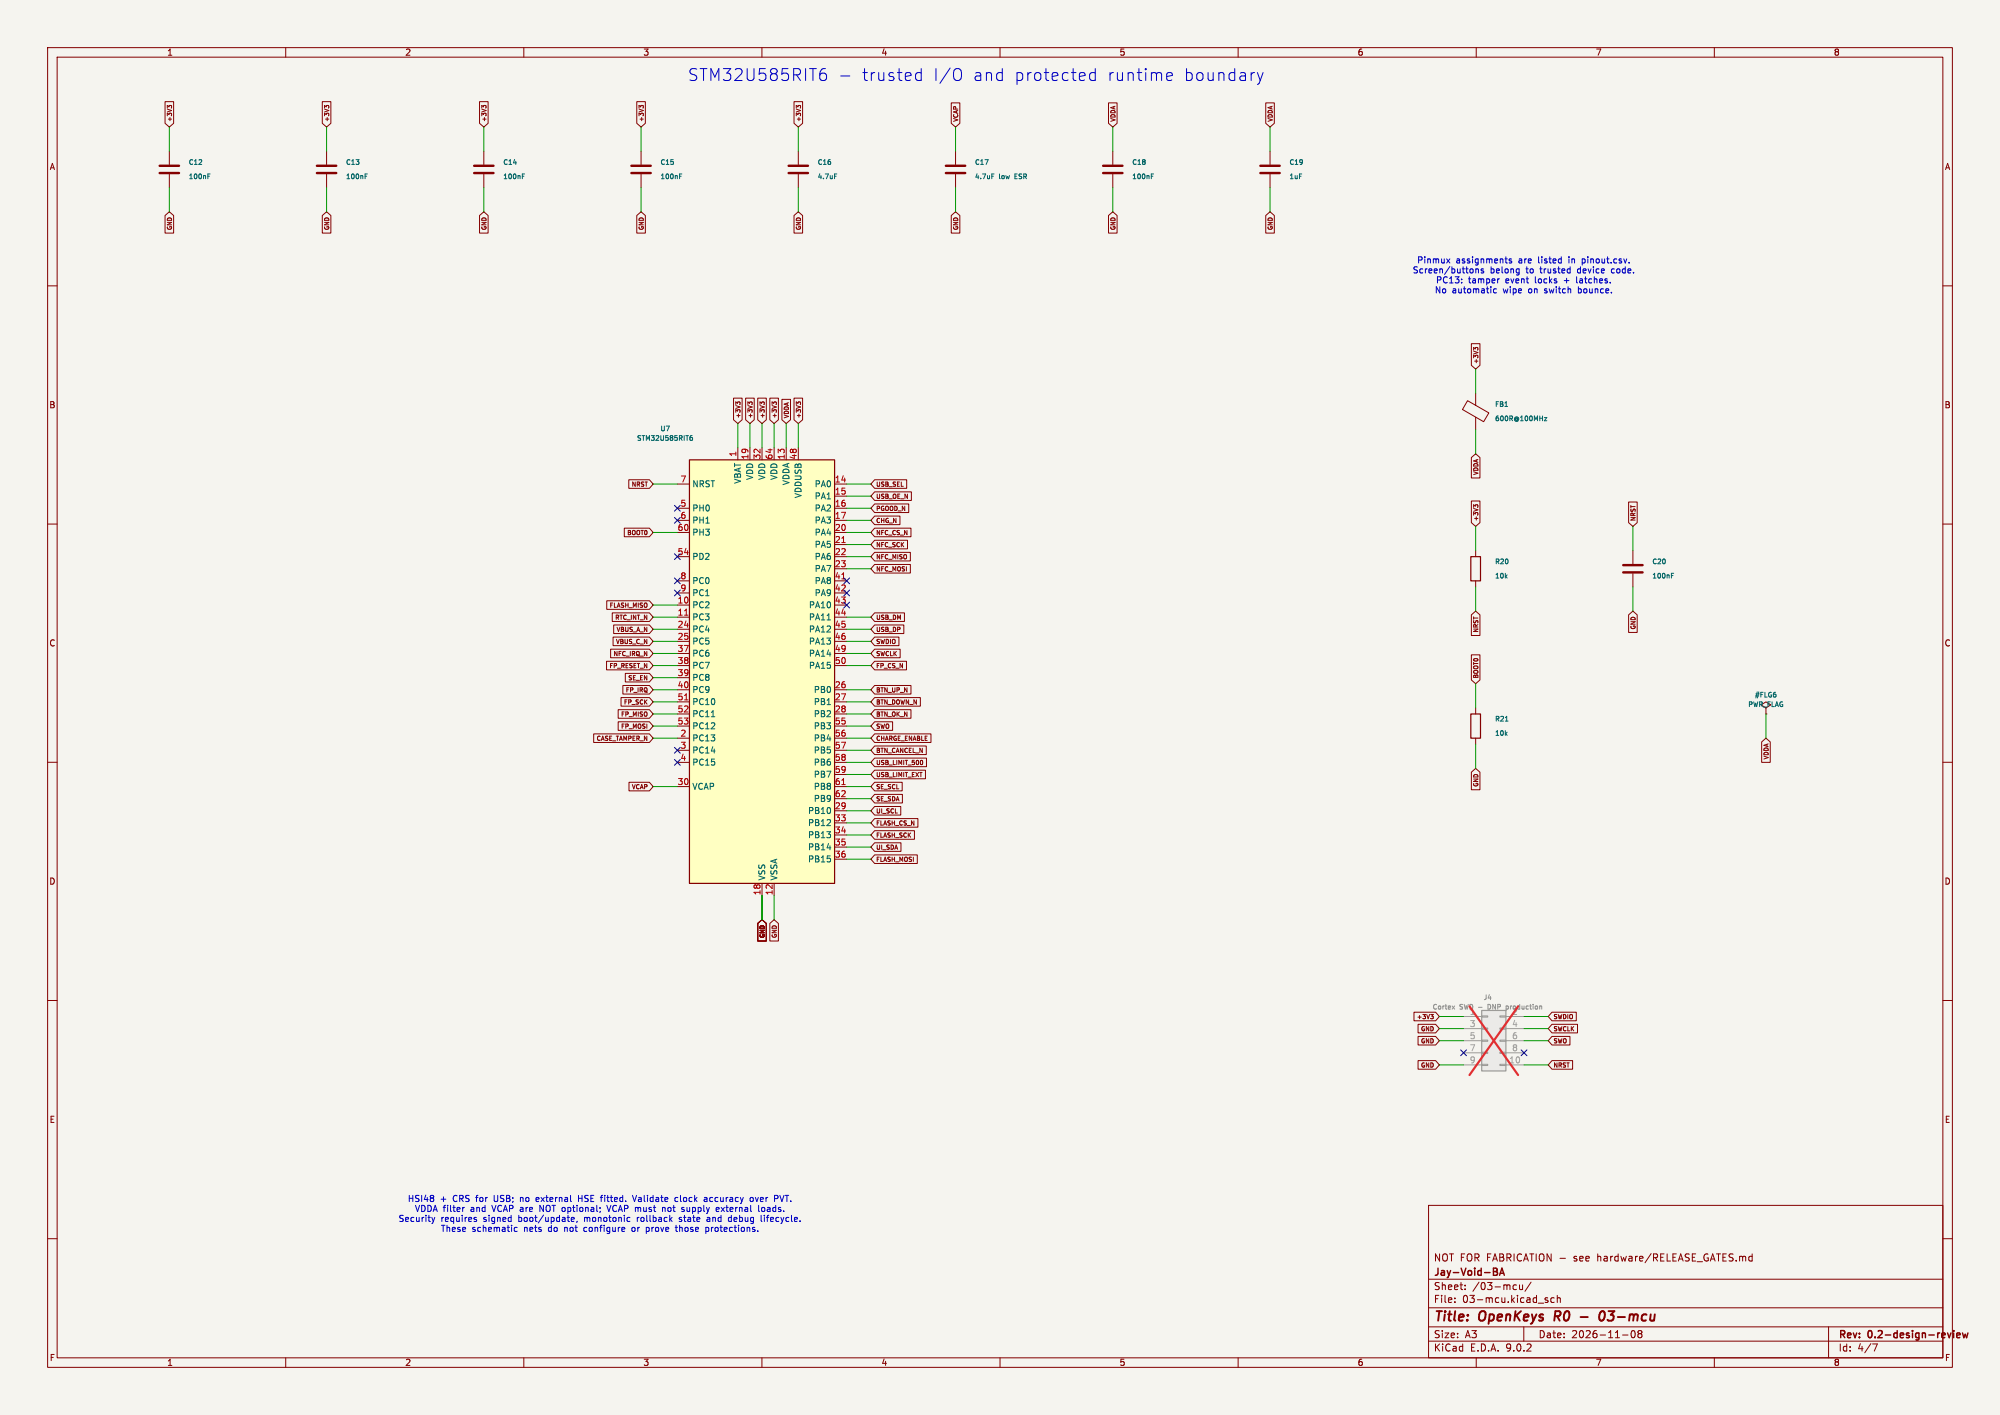
[picture p42: page 4]

1 VDD 19 VDD 32 VSS 18 VDD 64 VSSA 12 VDDA 13 VDDUSB 48 PA0 14 PA1 15 PA2 16 PA3 17 PA4 20 PA5 21 PA6 22 PA7 23 PA8 41 PA9 42 PA10 43 PA11 44 PA12 45 PA13 46 PA14 49 PA15 50 PB0 26 PB1 27 PB2 28 PB3 55 PB4 56 PB5 57 PB6 58 PB7 59 PB8 61 PB9 62 PB10 29 PB12 33 PB13 34 PB14 35 PB15 36

J4 Cortex SWD - DNP production

File: 03-mcu.kicad_sch Sheet: /03-mcu/ Jay-Void-BA

Id: 4/7 Title: OpenKeys R0 - 03-mcu

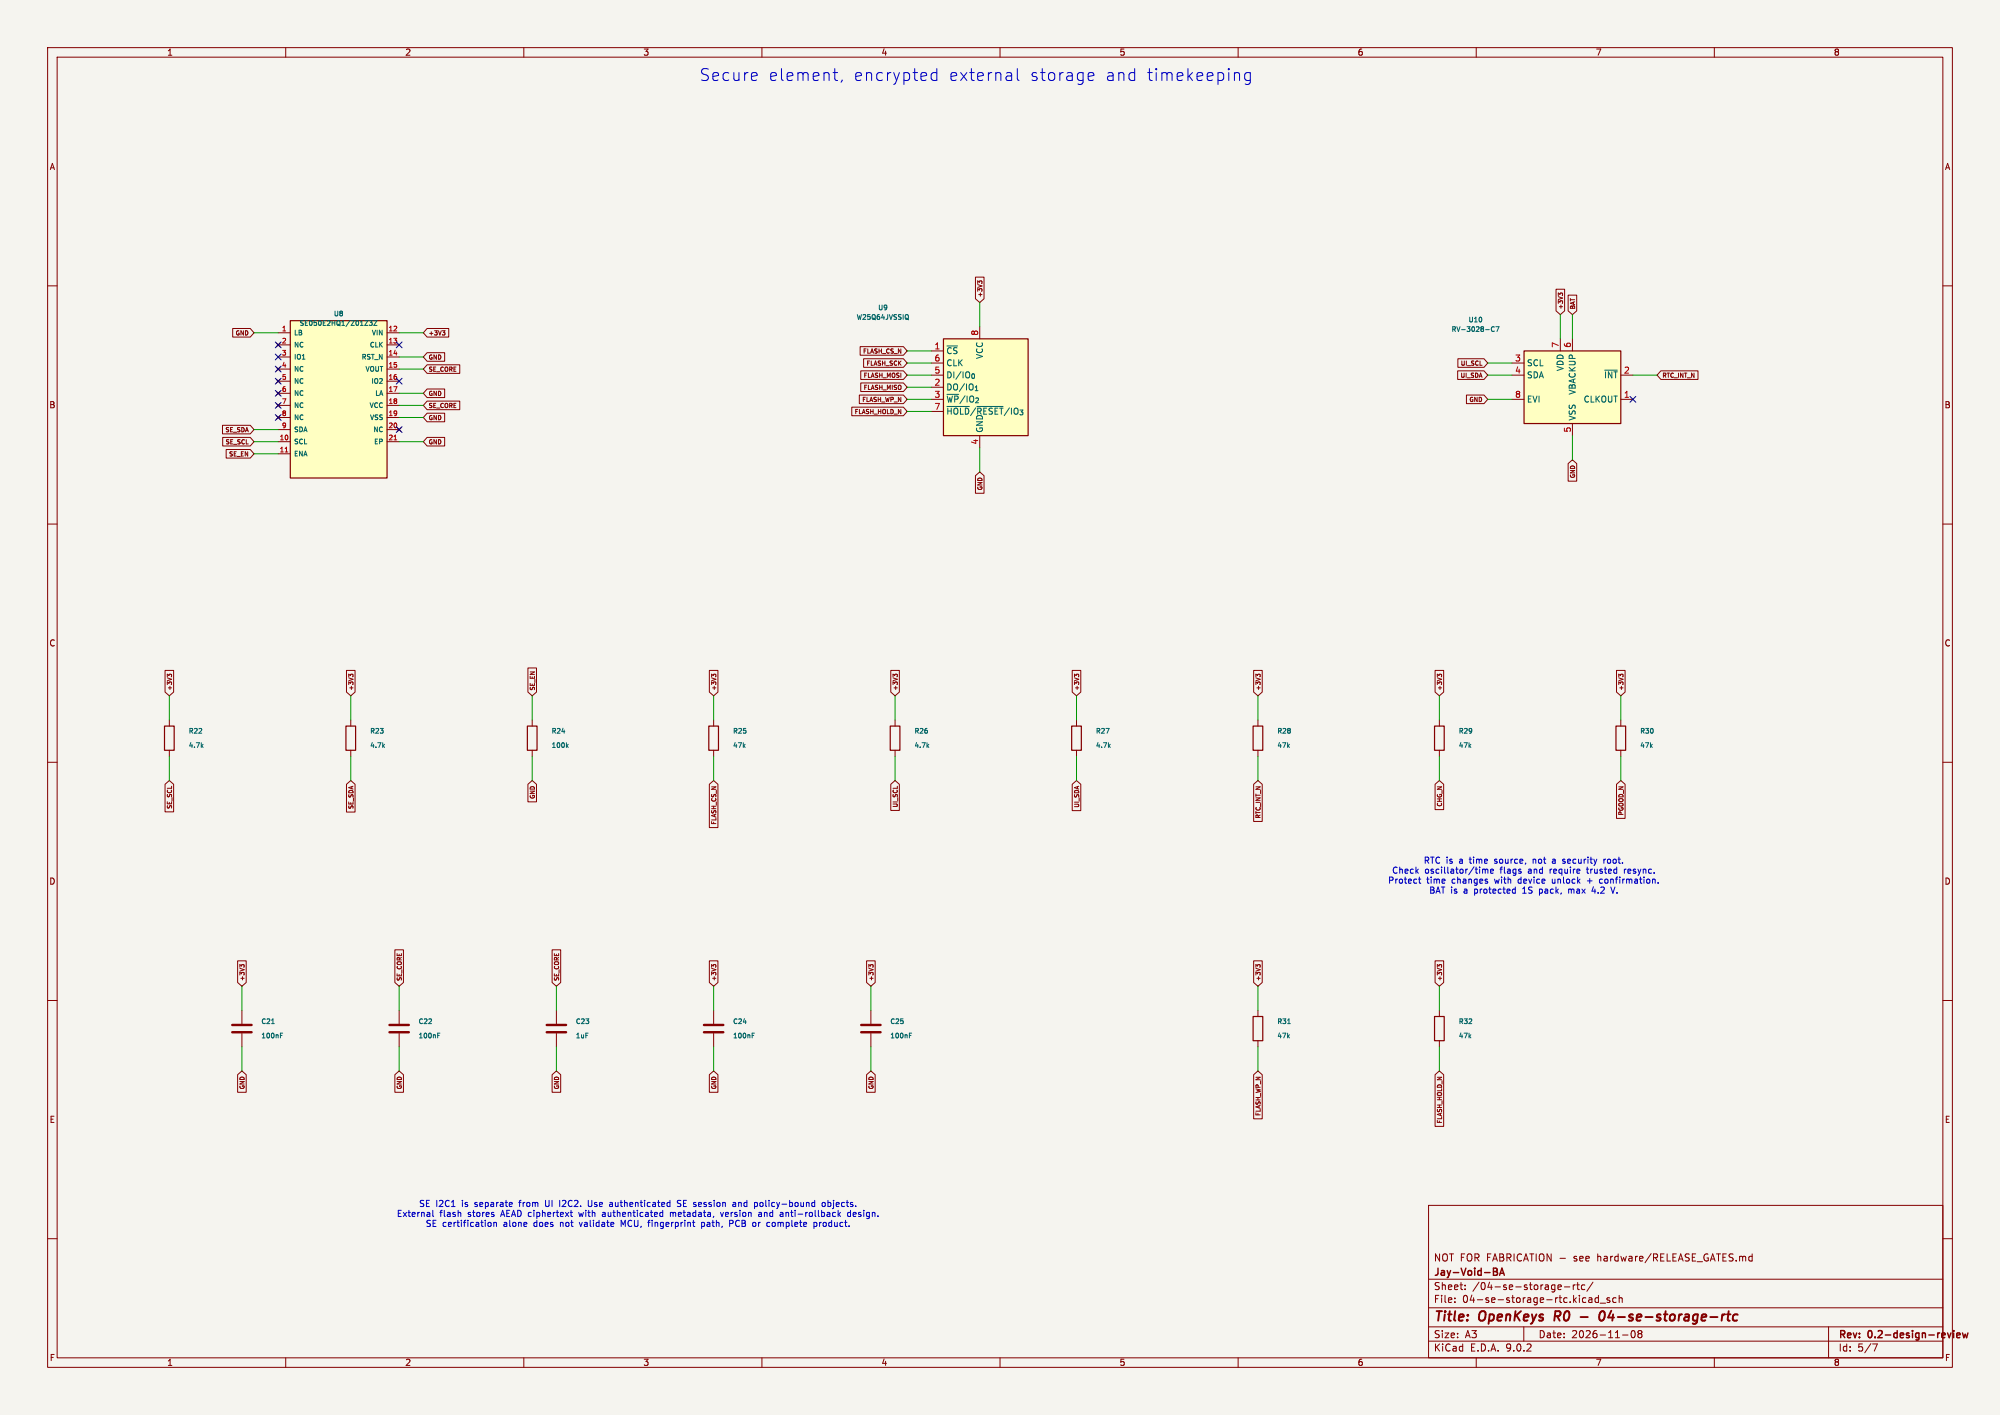
[picture p43: page 5]

Secure element, encrypted external storage and timekeeping

Jay-Void-BA
File: 04-se-storage-rtc.kicad_sch Sheet: /04-se-storage-rtc/
Id: 5/7 Title: OpenKeys R0 - 04-se-storage-rtc

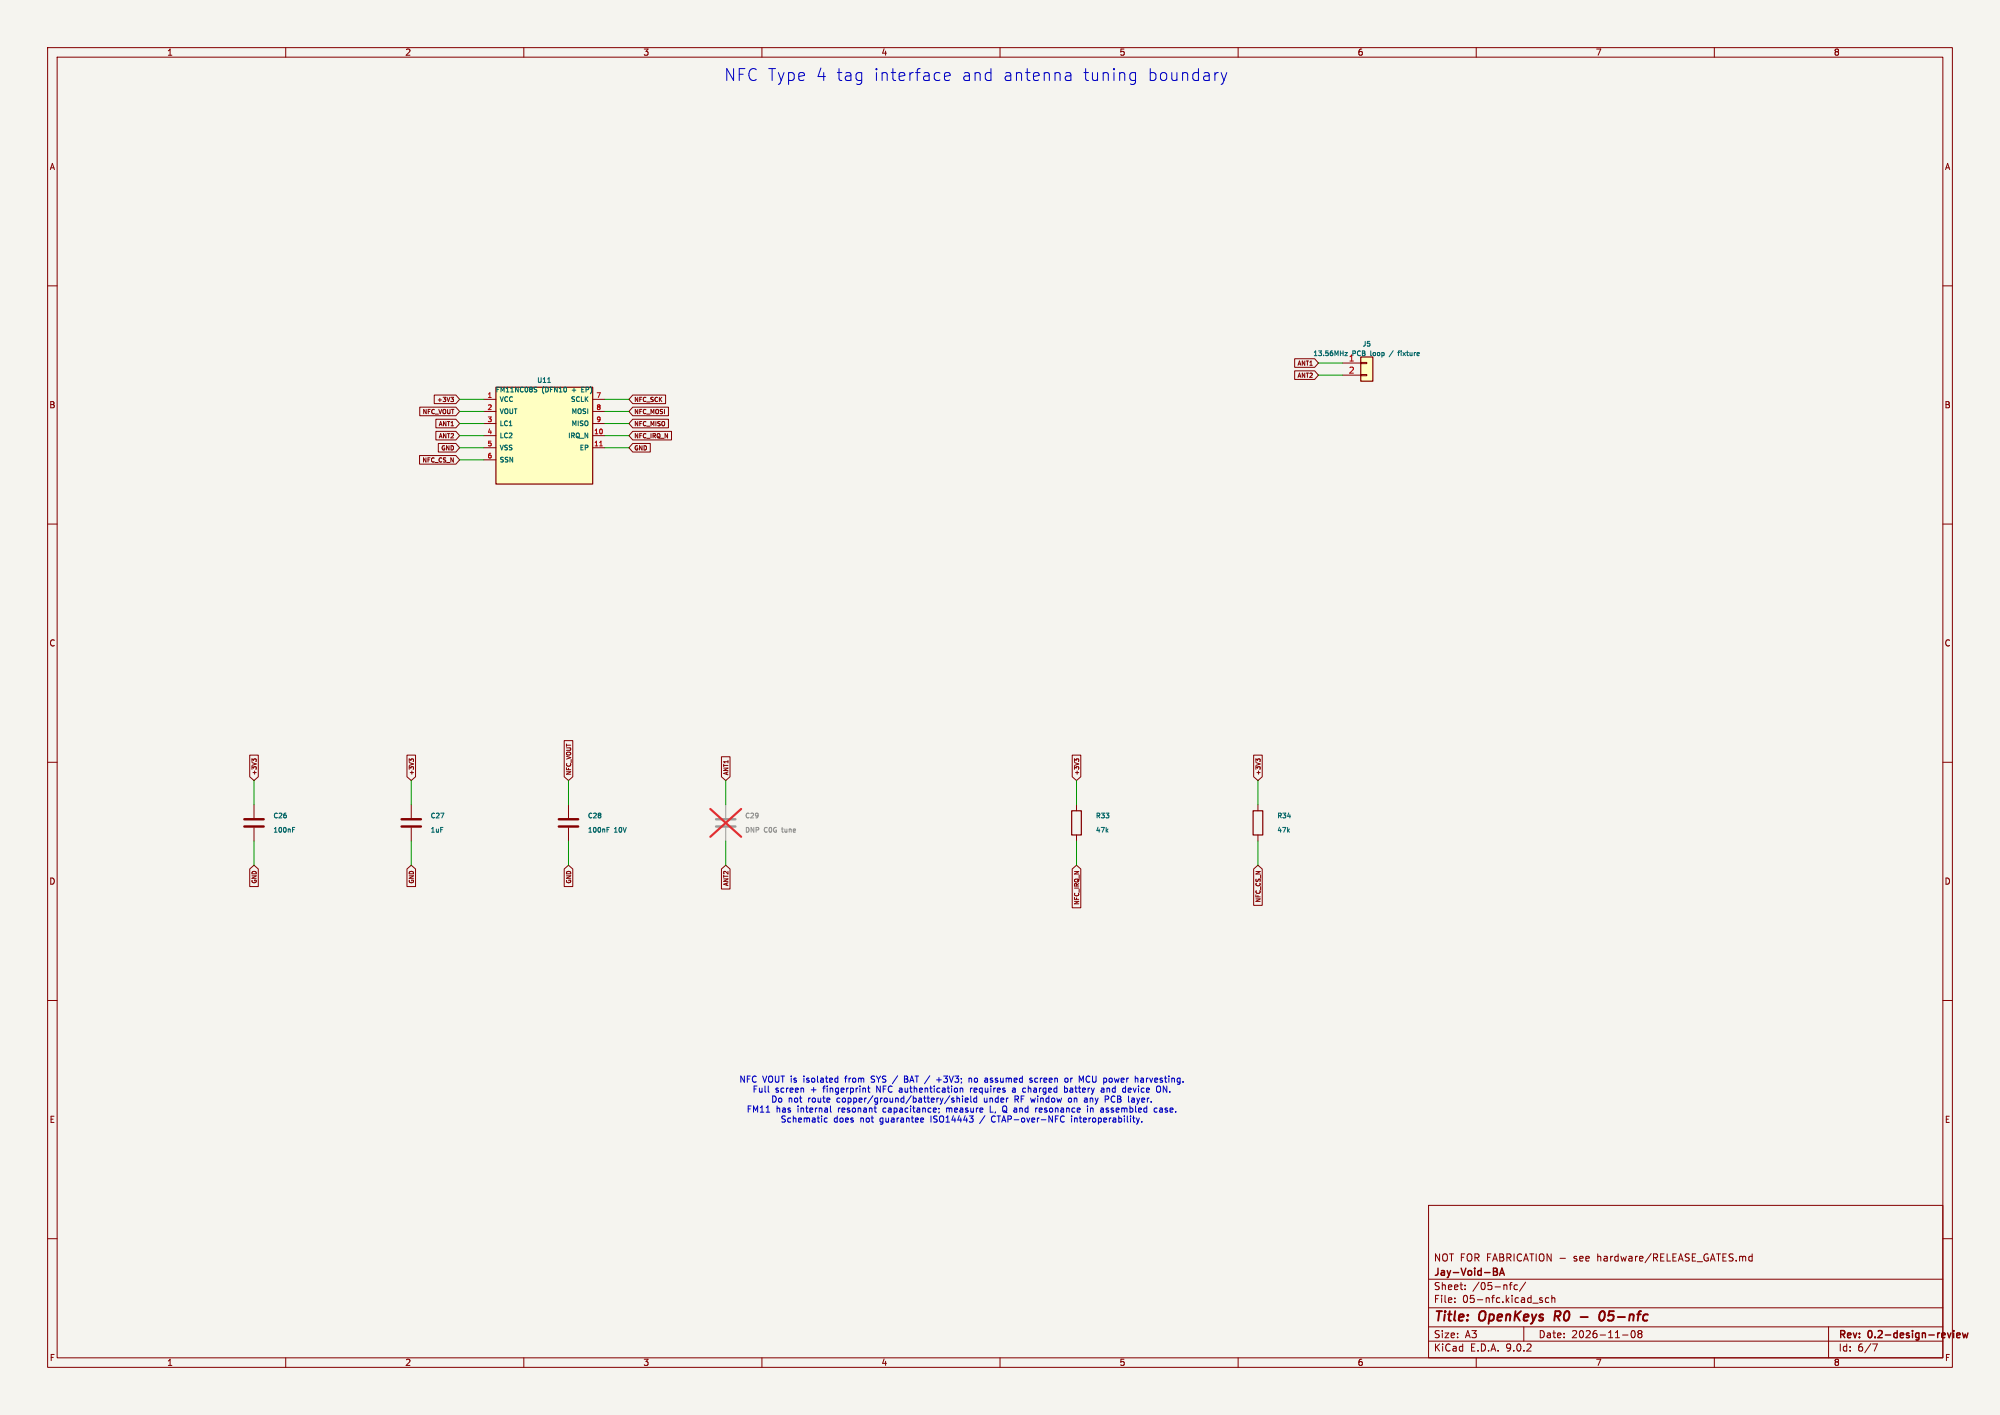
[picture p44: page 6]

File: 05-nfc.kicad_sch Sheet: /05-nfc/ Jay-Void-BA

Id: 6/7 Title: OpenKeys R0 - 05-nfc

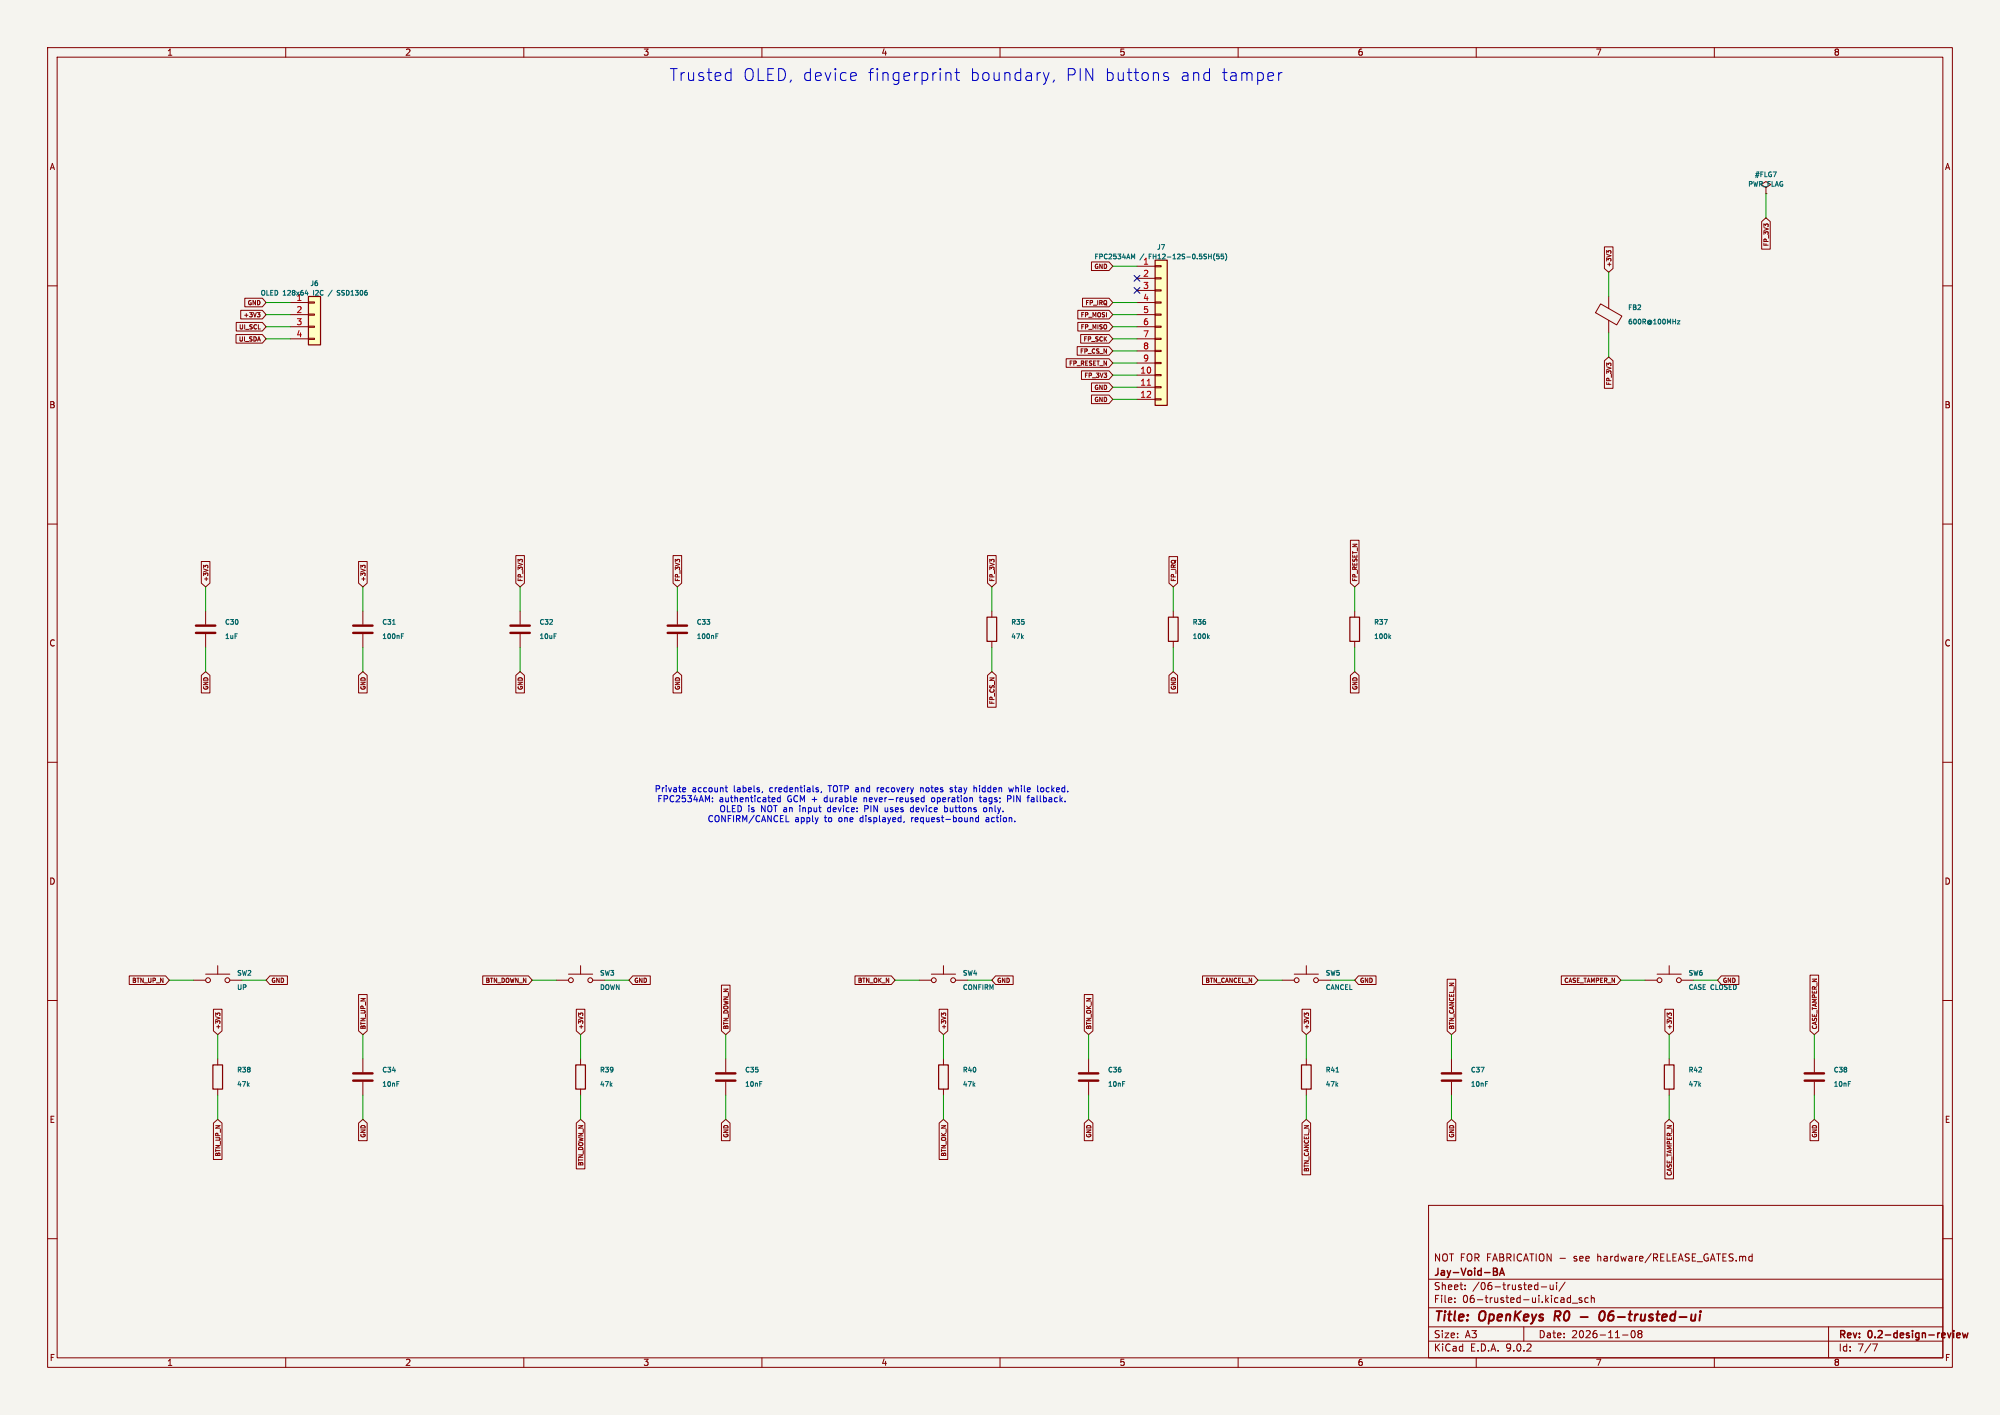
[picture p45: page 7]

Id: 7/7 Title: OpenKeys R0 - 06-trusted-ui File: 06-trusted-ui.kicad_sch Sheet: /06-trusted-ui/ Jay-Void-BA
