Jay-Void-BA/OpenKeys/hardware/r04/exports/OpenKeys-schematic.pdf

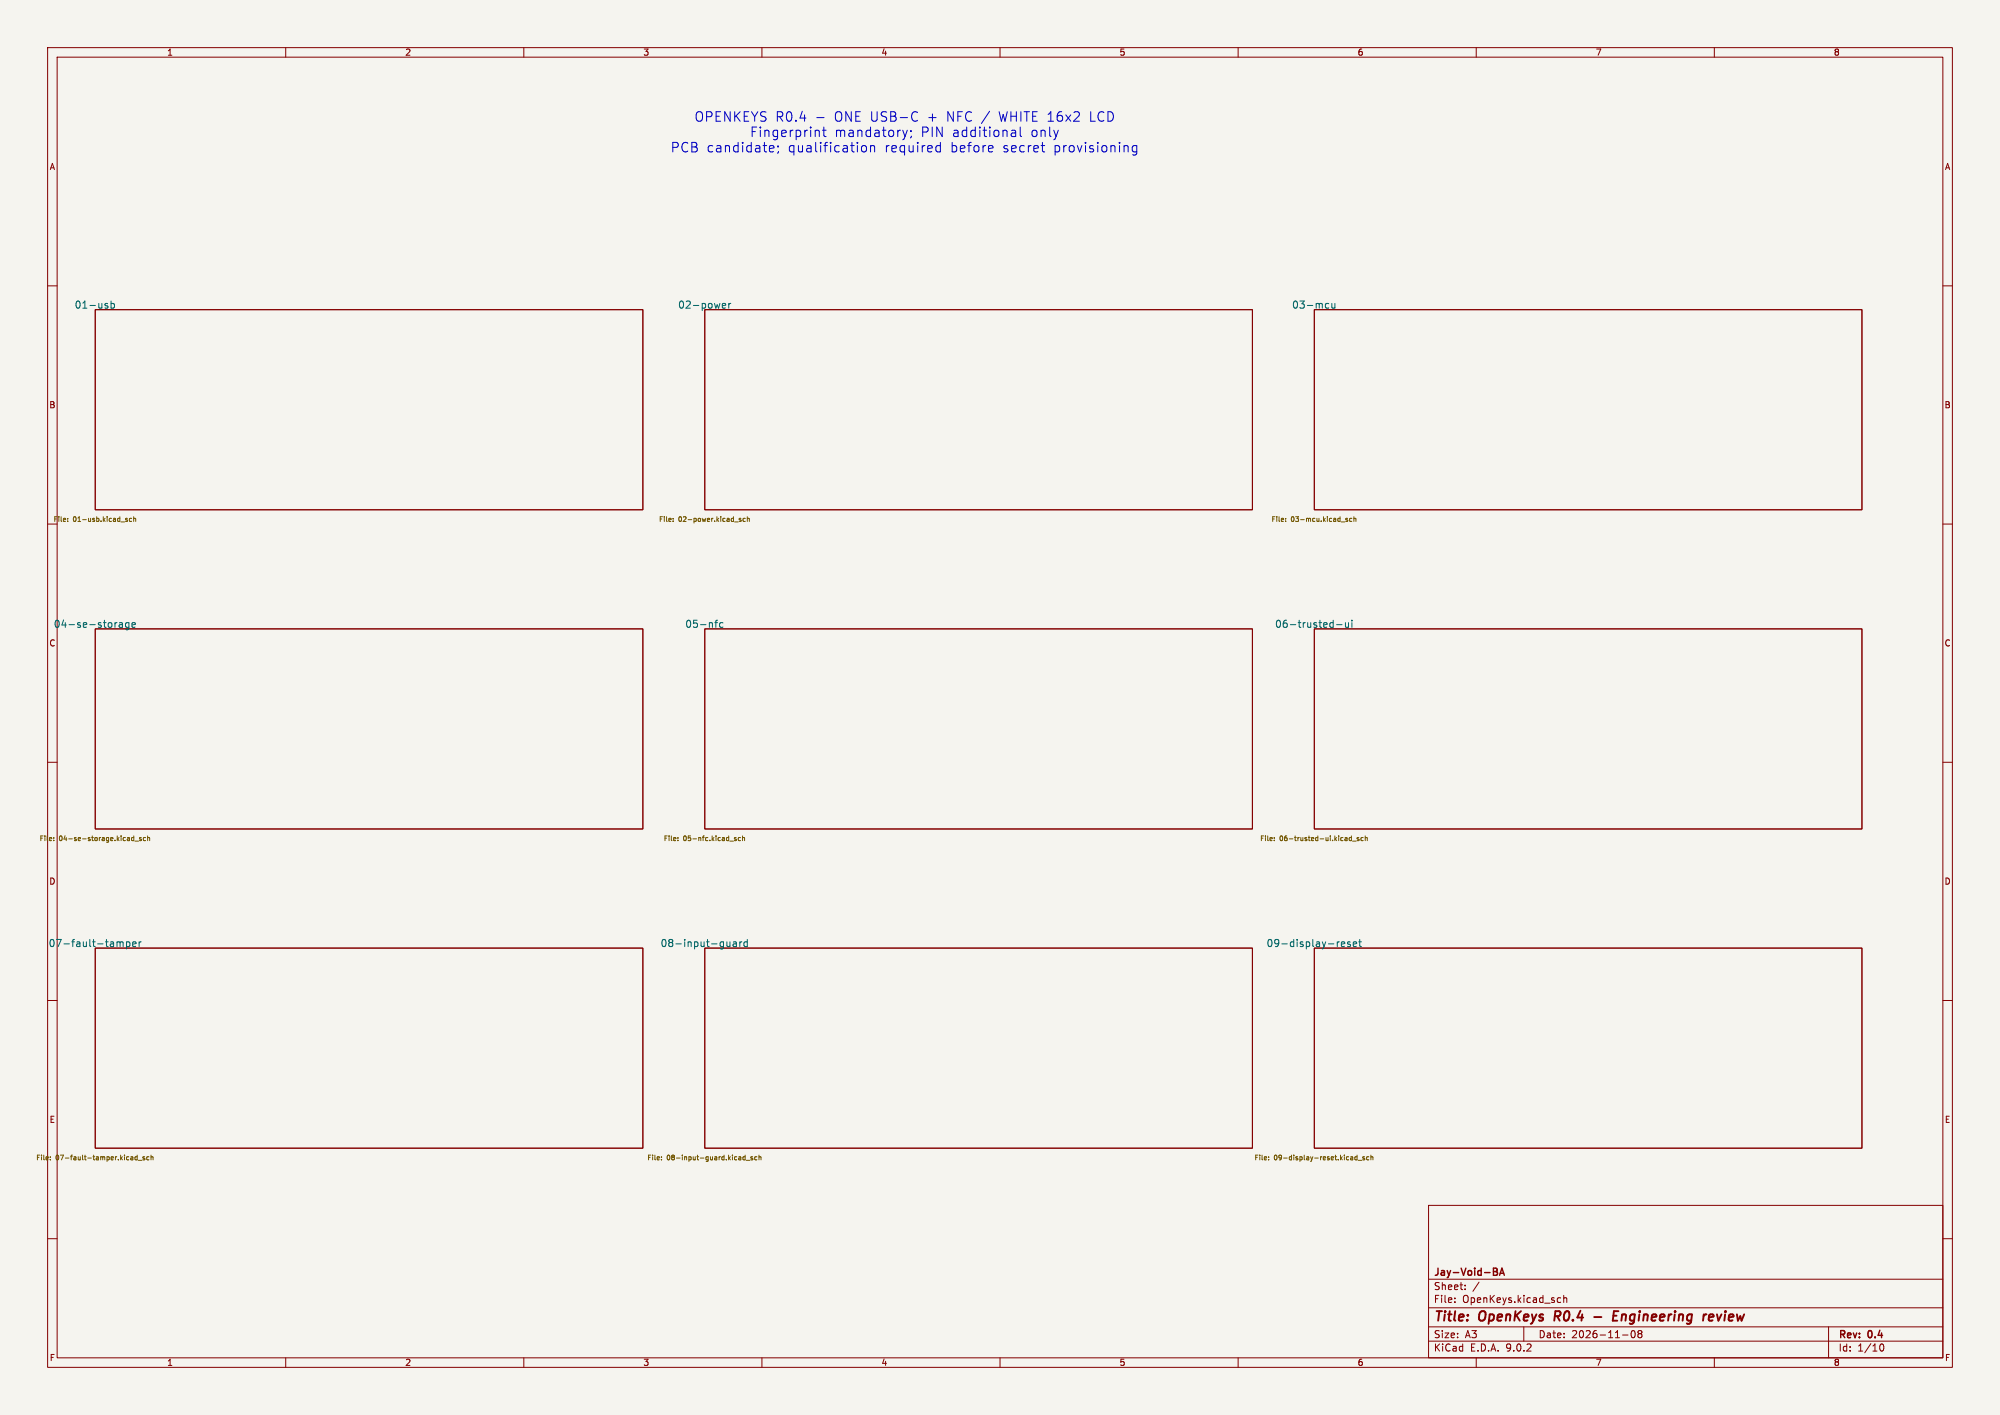
[picture p46: page 1]

File: OpenKeys.kicad_sch Sheet: / Jay-Void-BA

Id: 1/10 Title: OpenKeys R0.4 - Engineering review

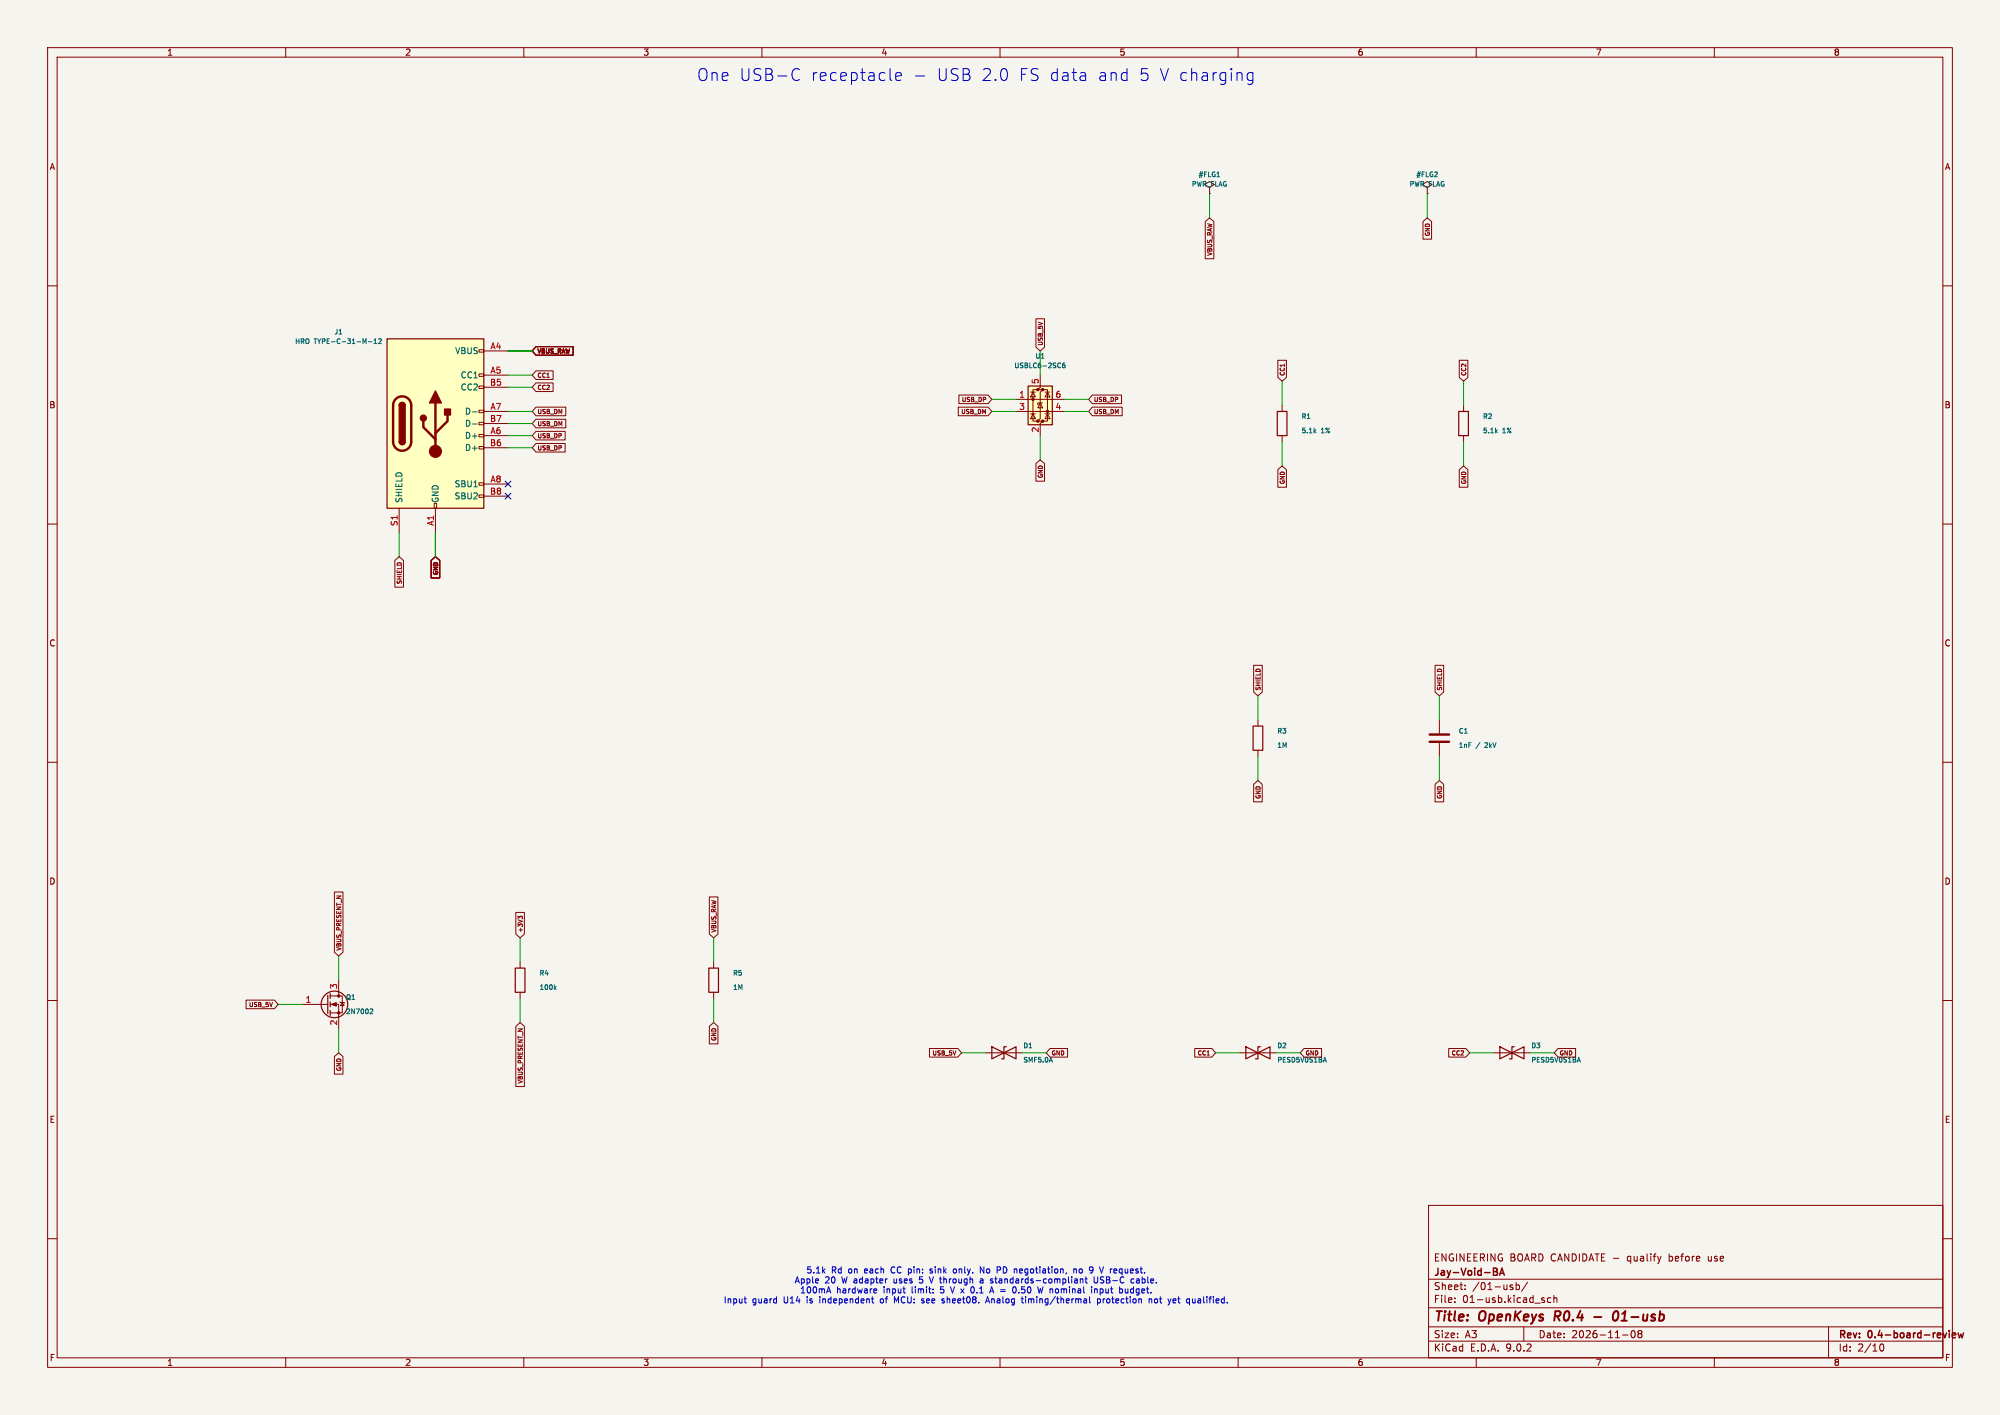
[picture p47: page 2]

File: 01-usb.kicad_sch Sheet: /01-usb/ Jay-Void-BA

Id: 2/10 Title: OpenKeys R0.4 - 01-usb

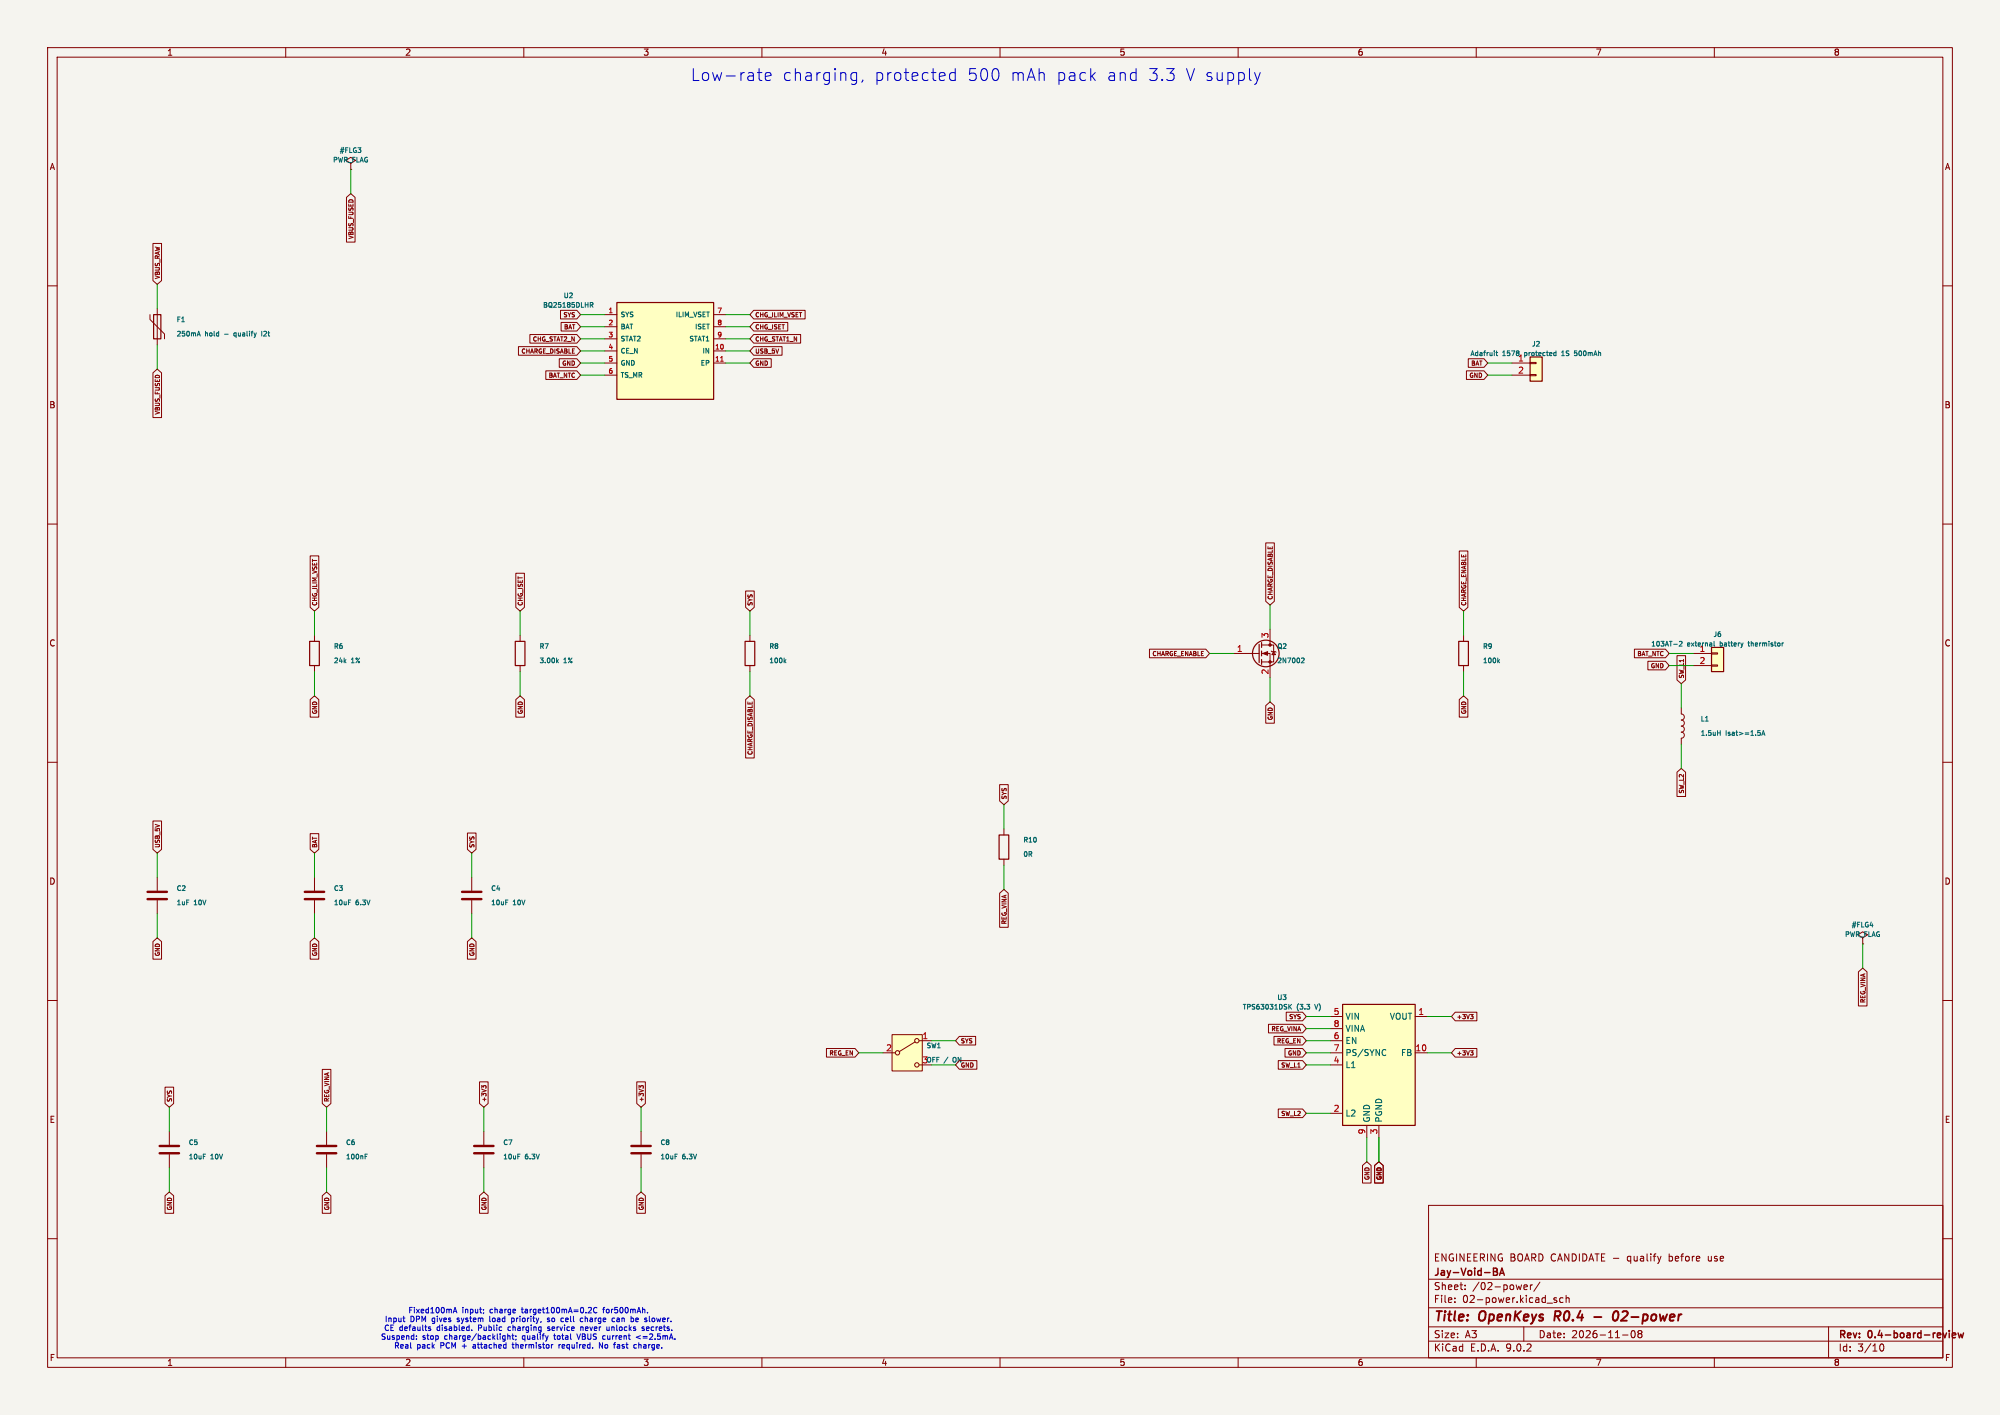
[picture p48: page 3]

Jay-Void-BA
Id: 3/10 Title: OpenKeys R0.4 - 02-power File: 02-power.kicad_sch Sheet: /02-power/

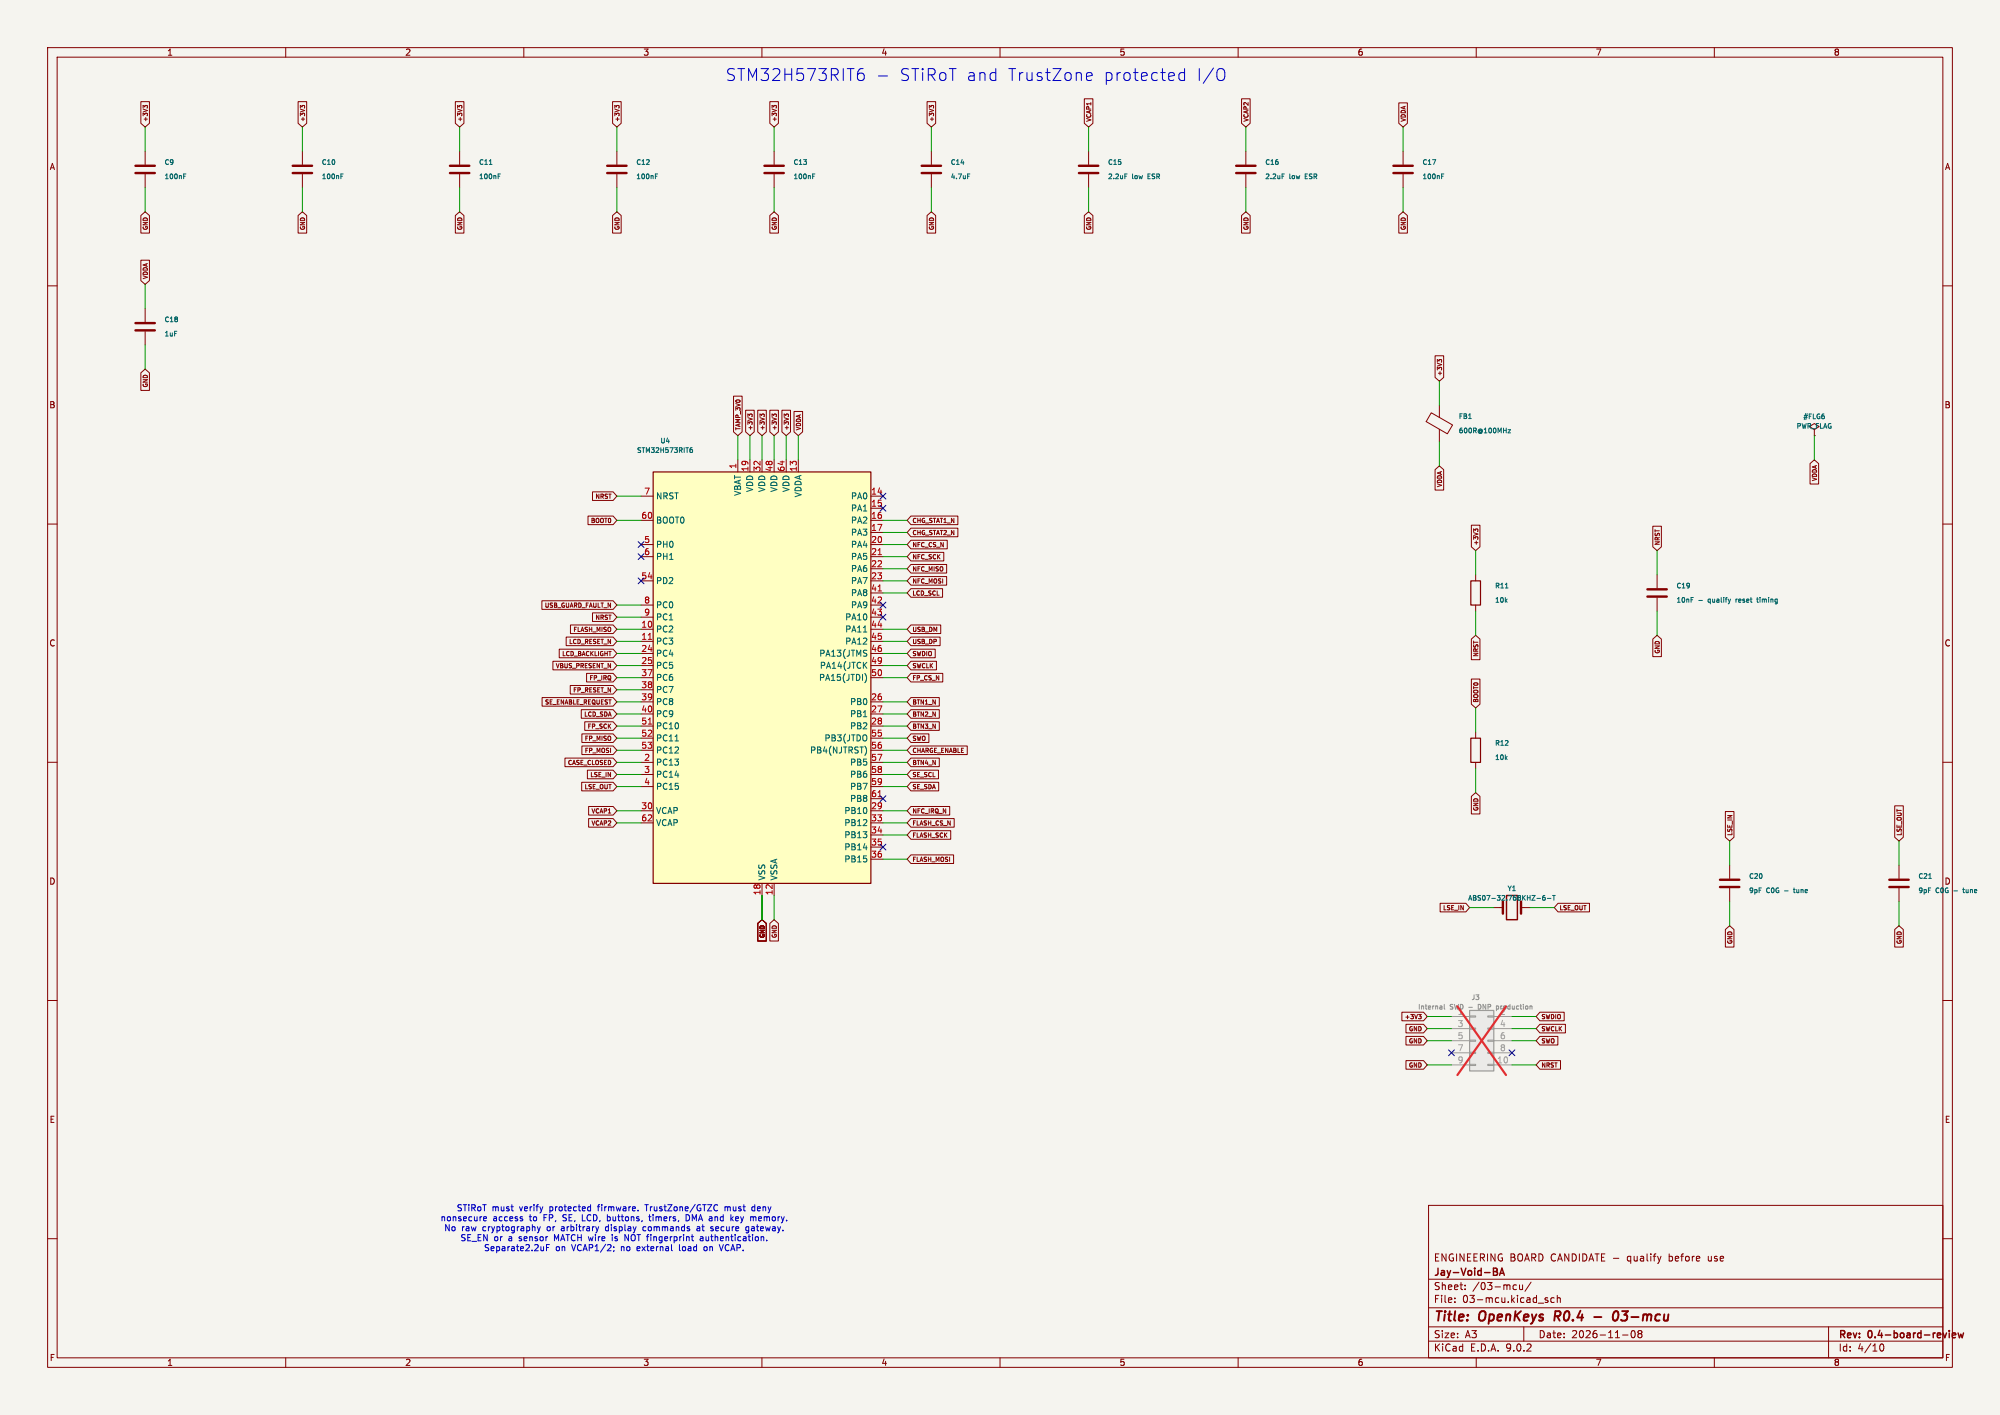
[picture p49: page 4]

1 VDD 19 VDD 32 VSS 18 VDD 48 VSSA 12 VDD 64 VDDA 13 PA0 14 PA1 15 PA2 16 PA3 17 PA4 20 PA5 21 PA6 22 PA7 23 PA8 41 PA9 42 PA10 43 PA11 44 PA12 45 PA13(JTMS 46 PA14(JTCK 49 PA15(JTDI) 50 PB0 26 PB1 27 PB2 28 PB3(JTDO 55 PB4(NJTRST) 56 PB5 57 PB6 58 PB7 59 PB8 61 PB10 29 PB12 33 PB13 34 PB14 35 PB15 36

File: 03-mcu.kicad_sch Sheet: /03-mcu/ Jay-Void-BA

Id: 4/10 Title: OpenKeys R0.4 - 03-mcu

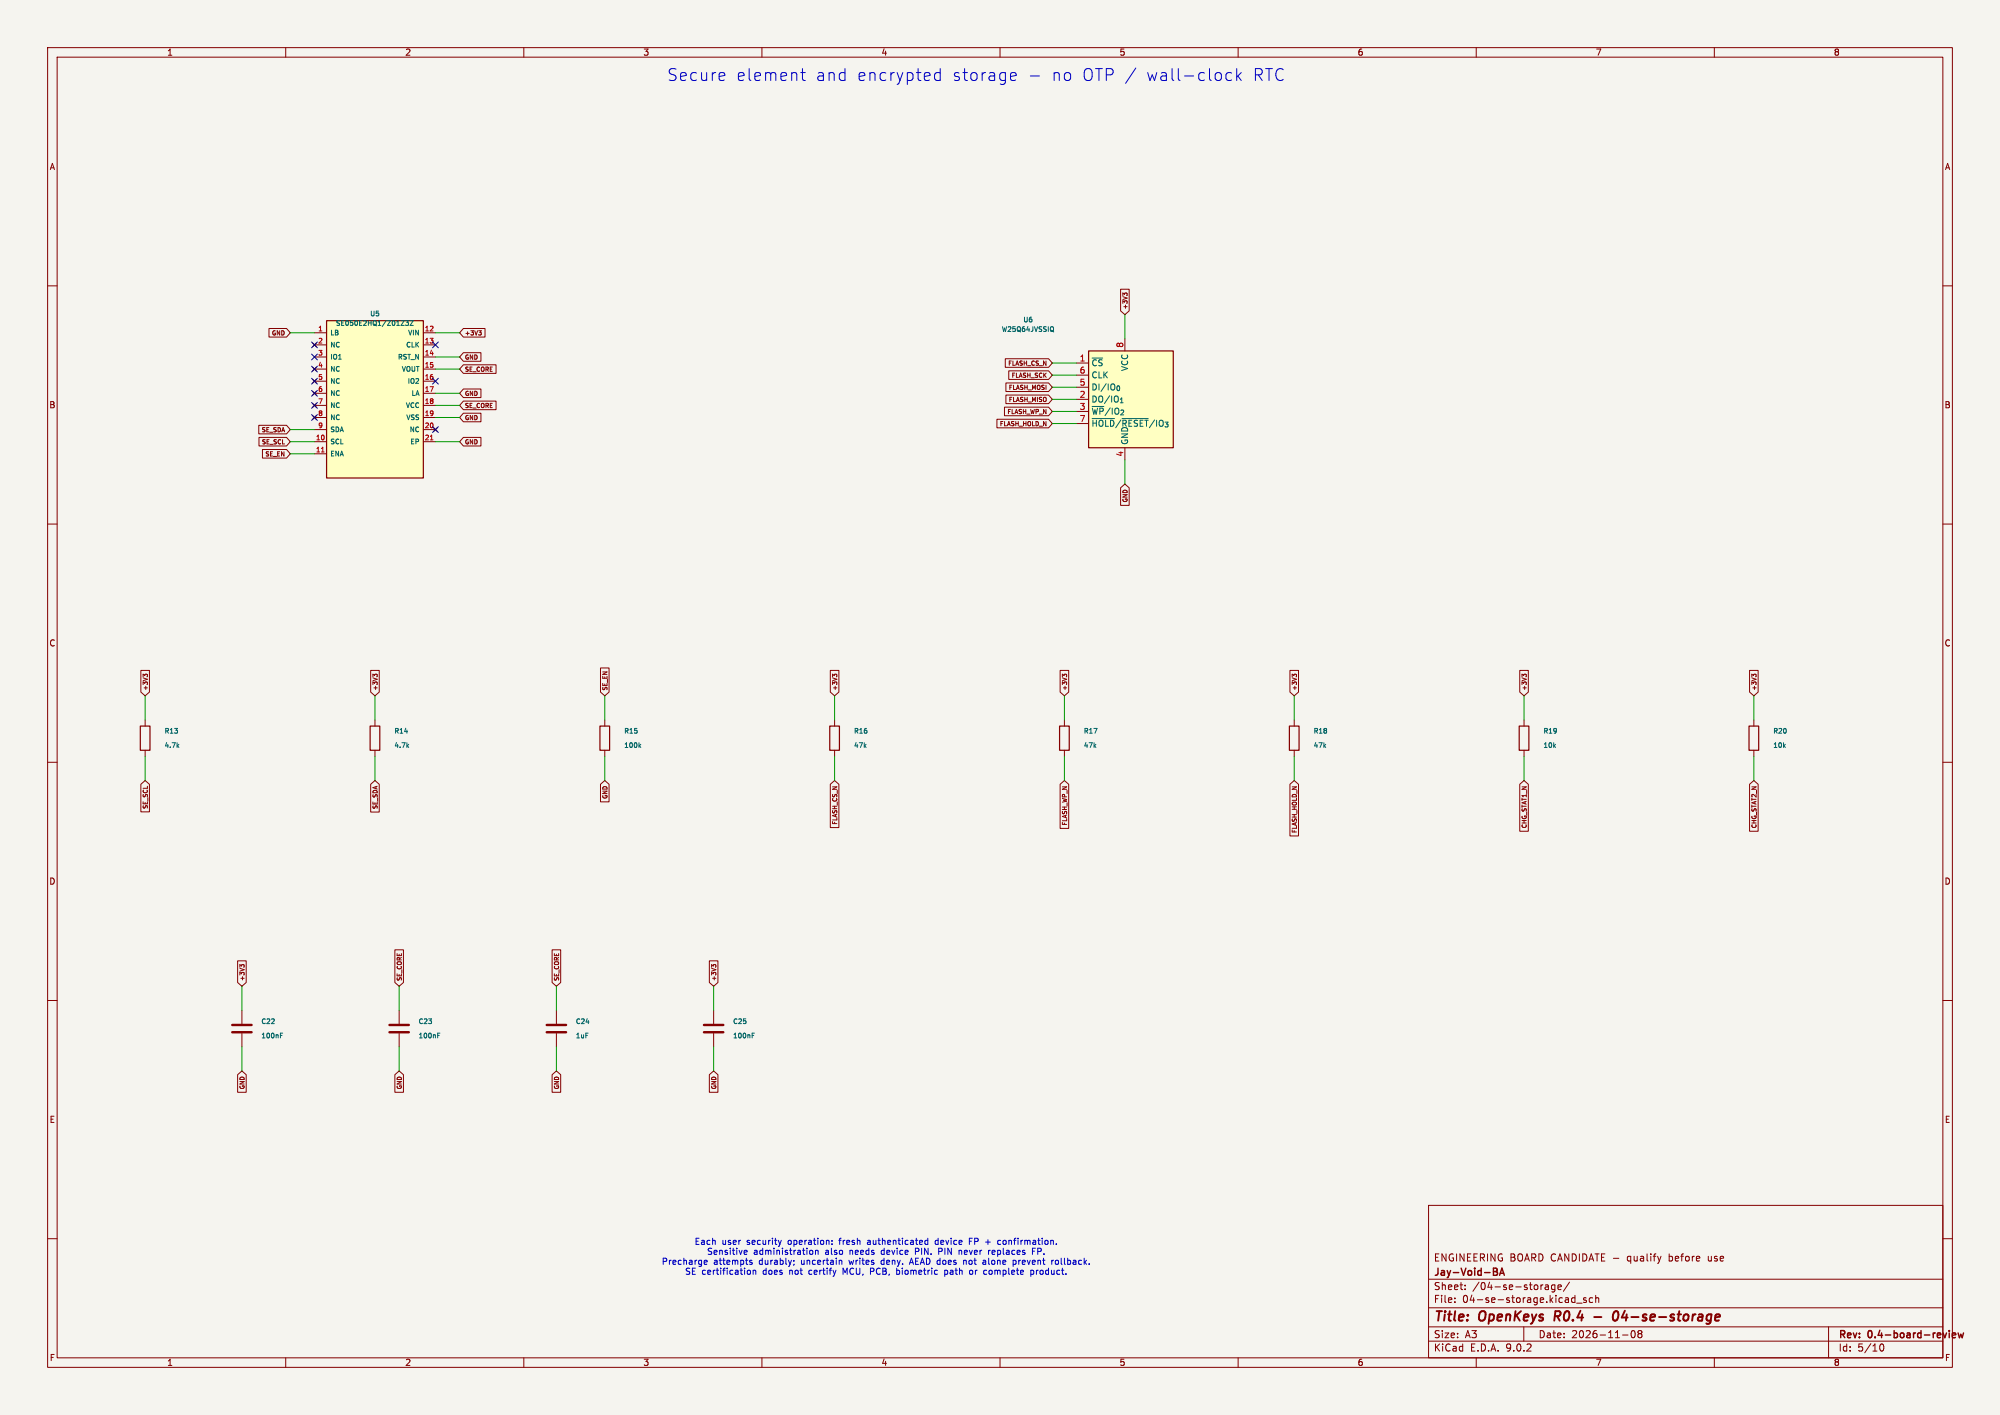
[picture p50: page 5]

Jay-Void-BA
File: 04-se-storage.kicad_sch Sheet: /04-se-storage/
Id: 5/10 Title: OpenKeys R0.4 - 04-se-storage

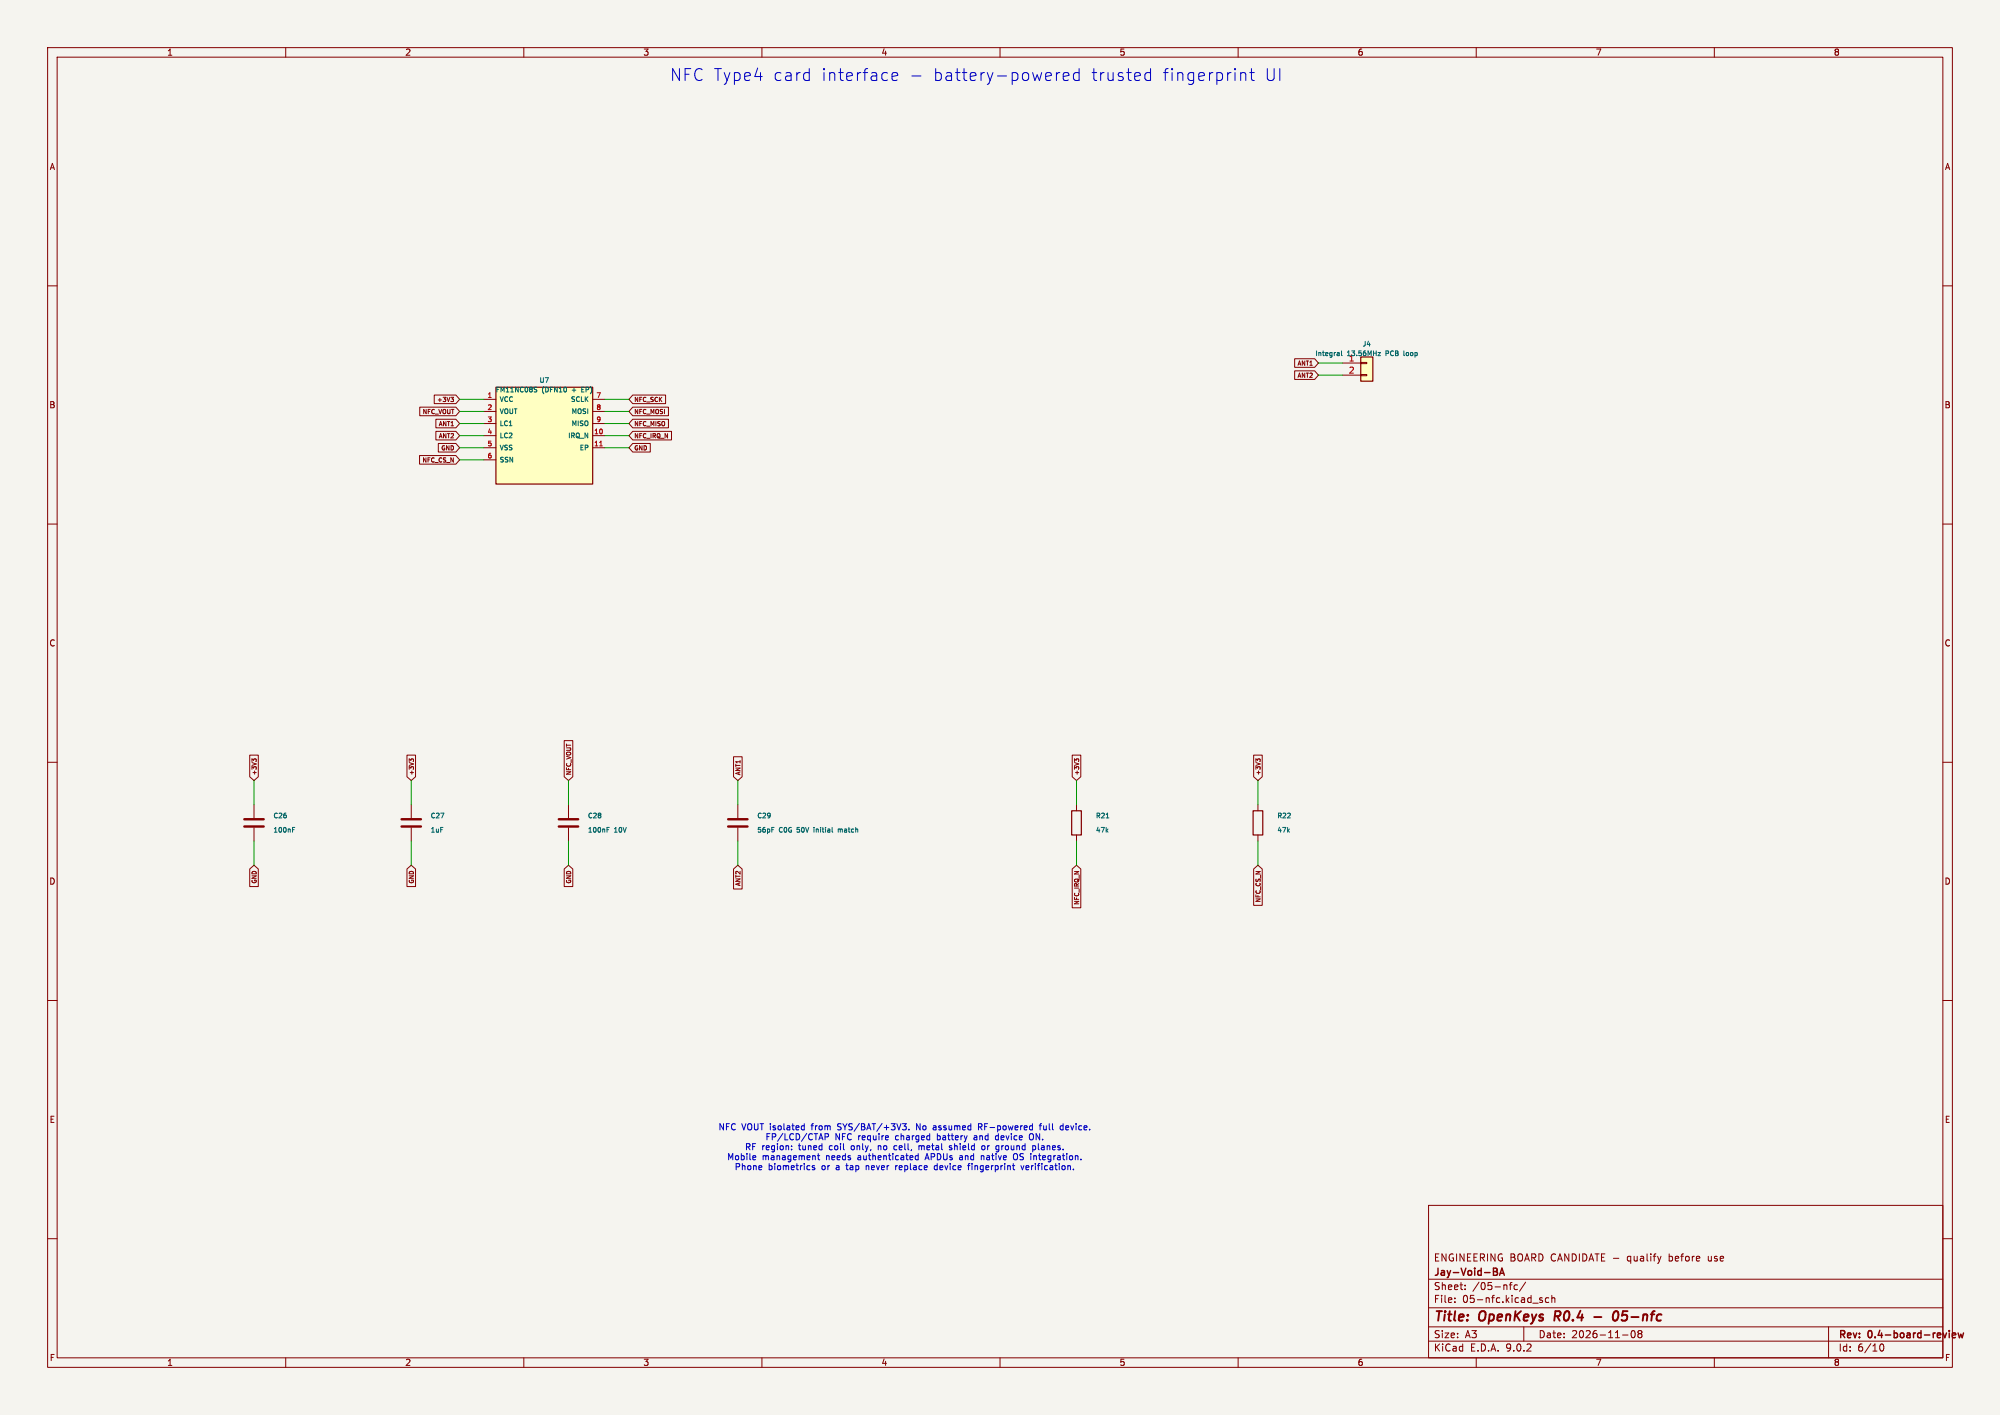
[picture p51: page 6]

File: 05-nfc.kicad_sch Sheet: /05-nfc/ Jay-Void-BA

Id: 6/10 Title: OpenKeys R0.4 - 05-nfc

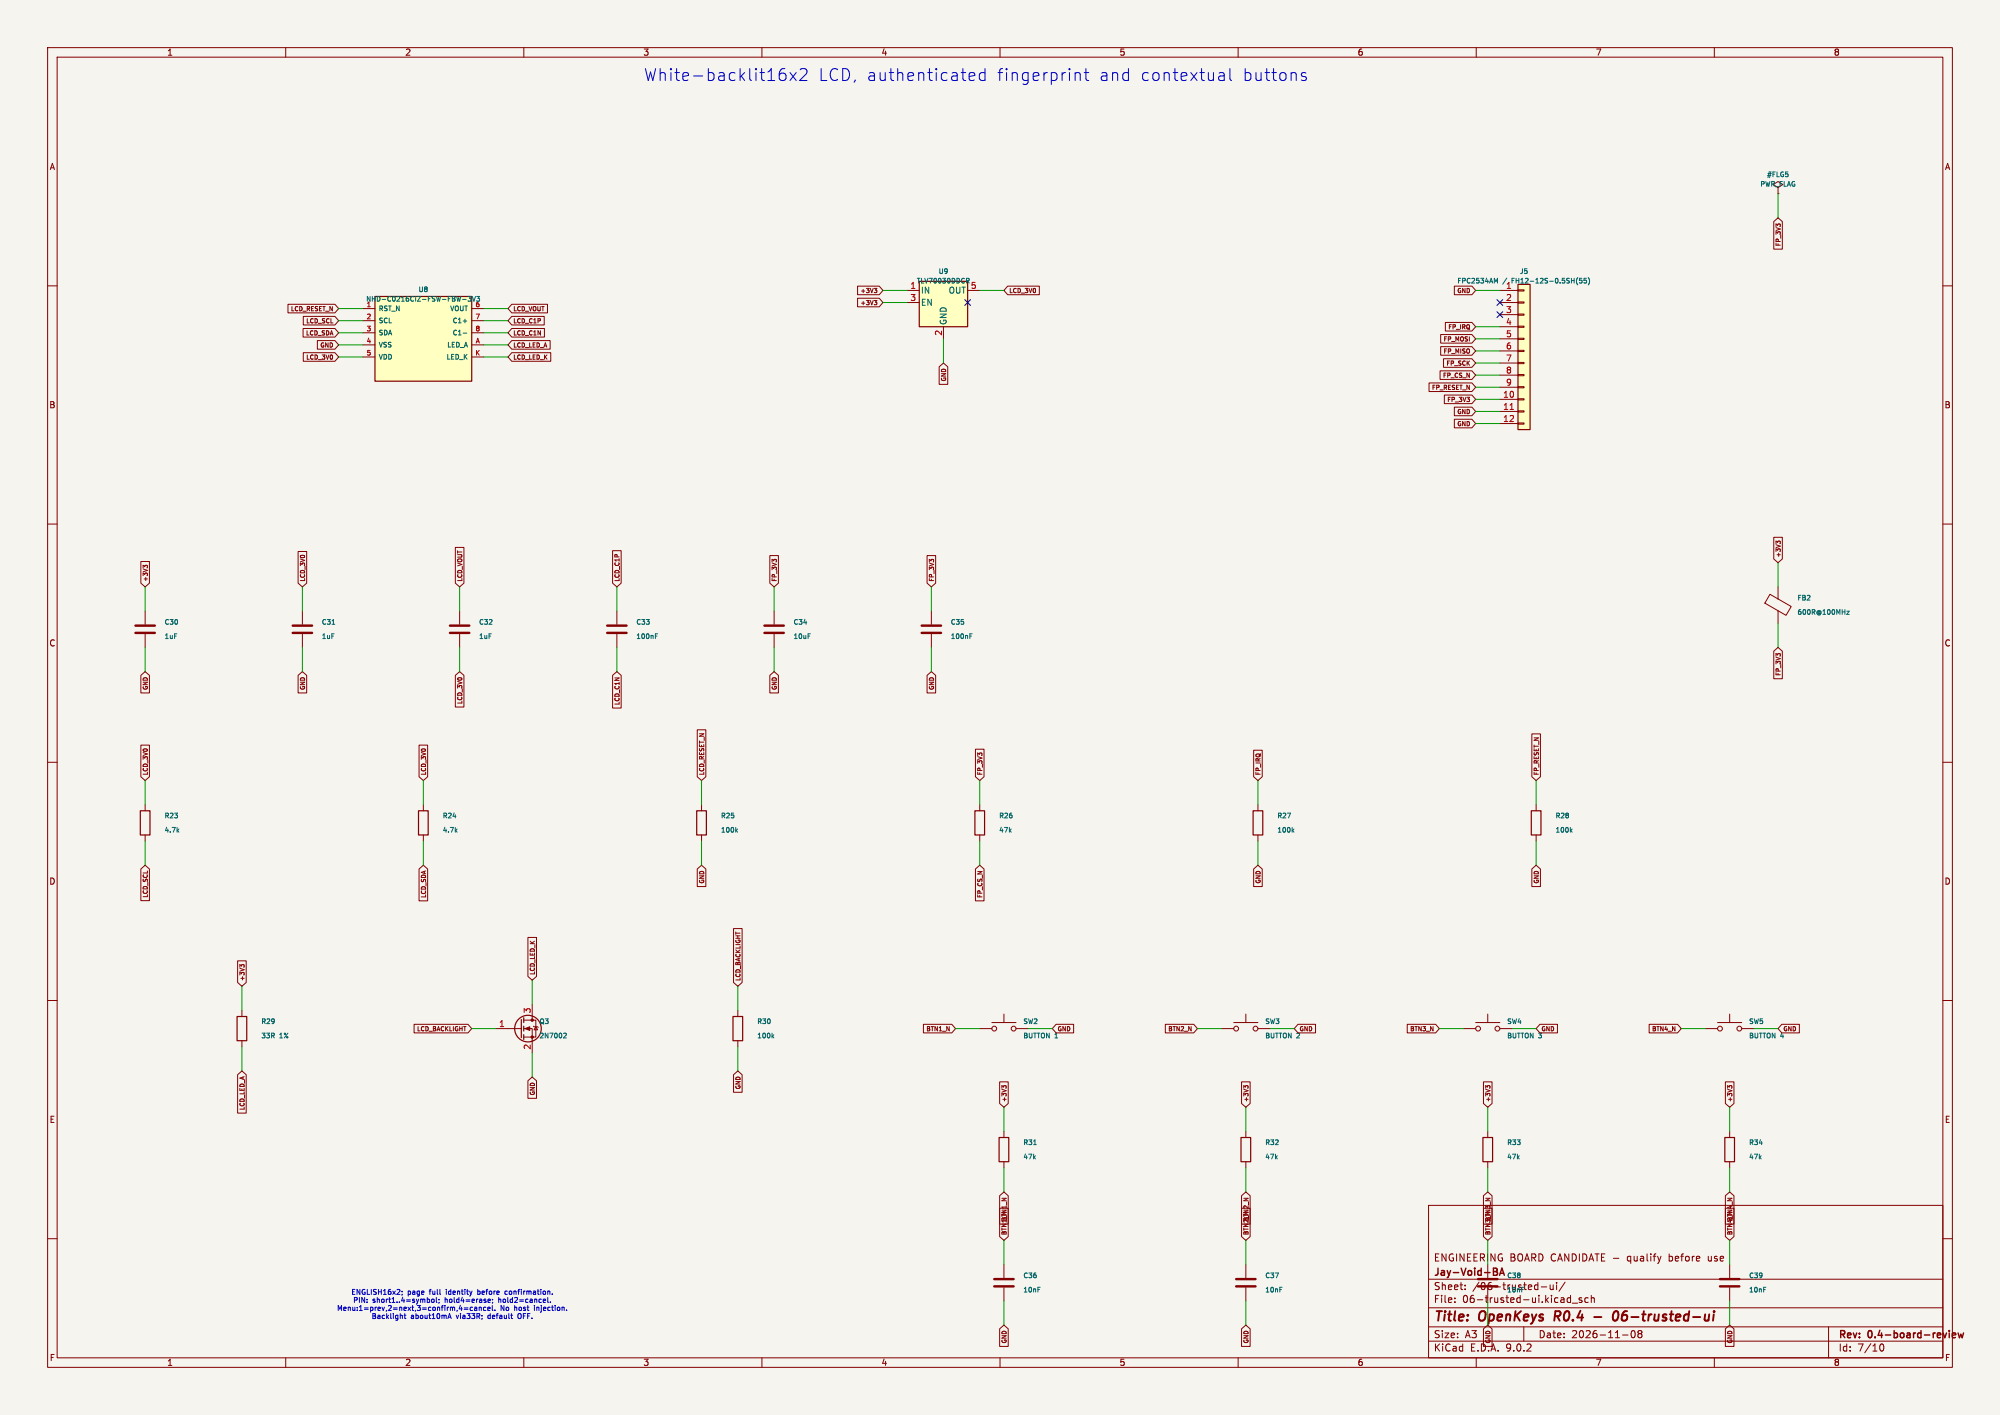
[picture p52: page 7]

Id: 7/10 Title: OpenKeys R0.4 - 06-trusted-ui File: 06-trusted-ui.kicad_sch Sheet: /06-trusted-ui/ Jay-Void-BA

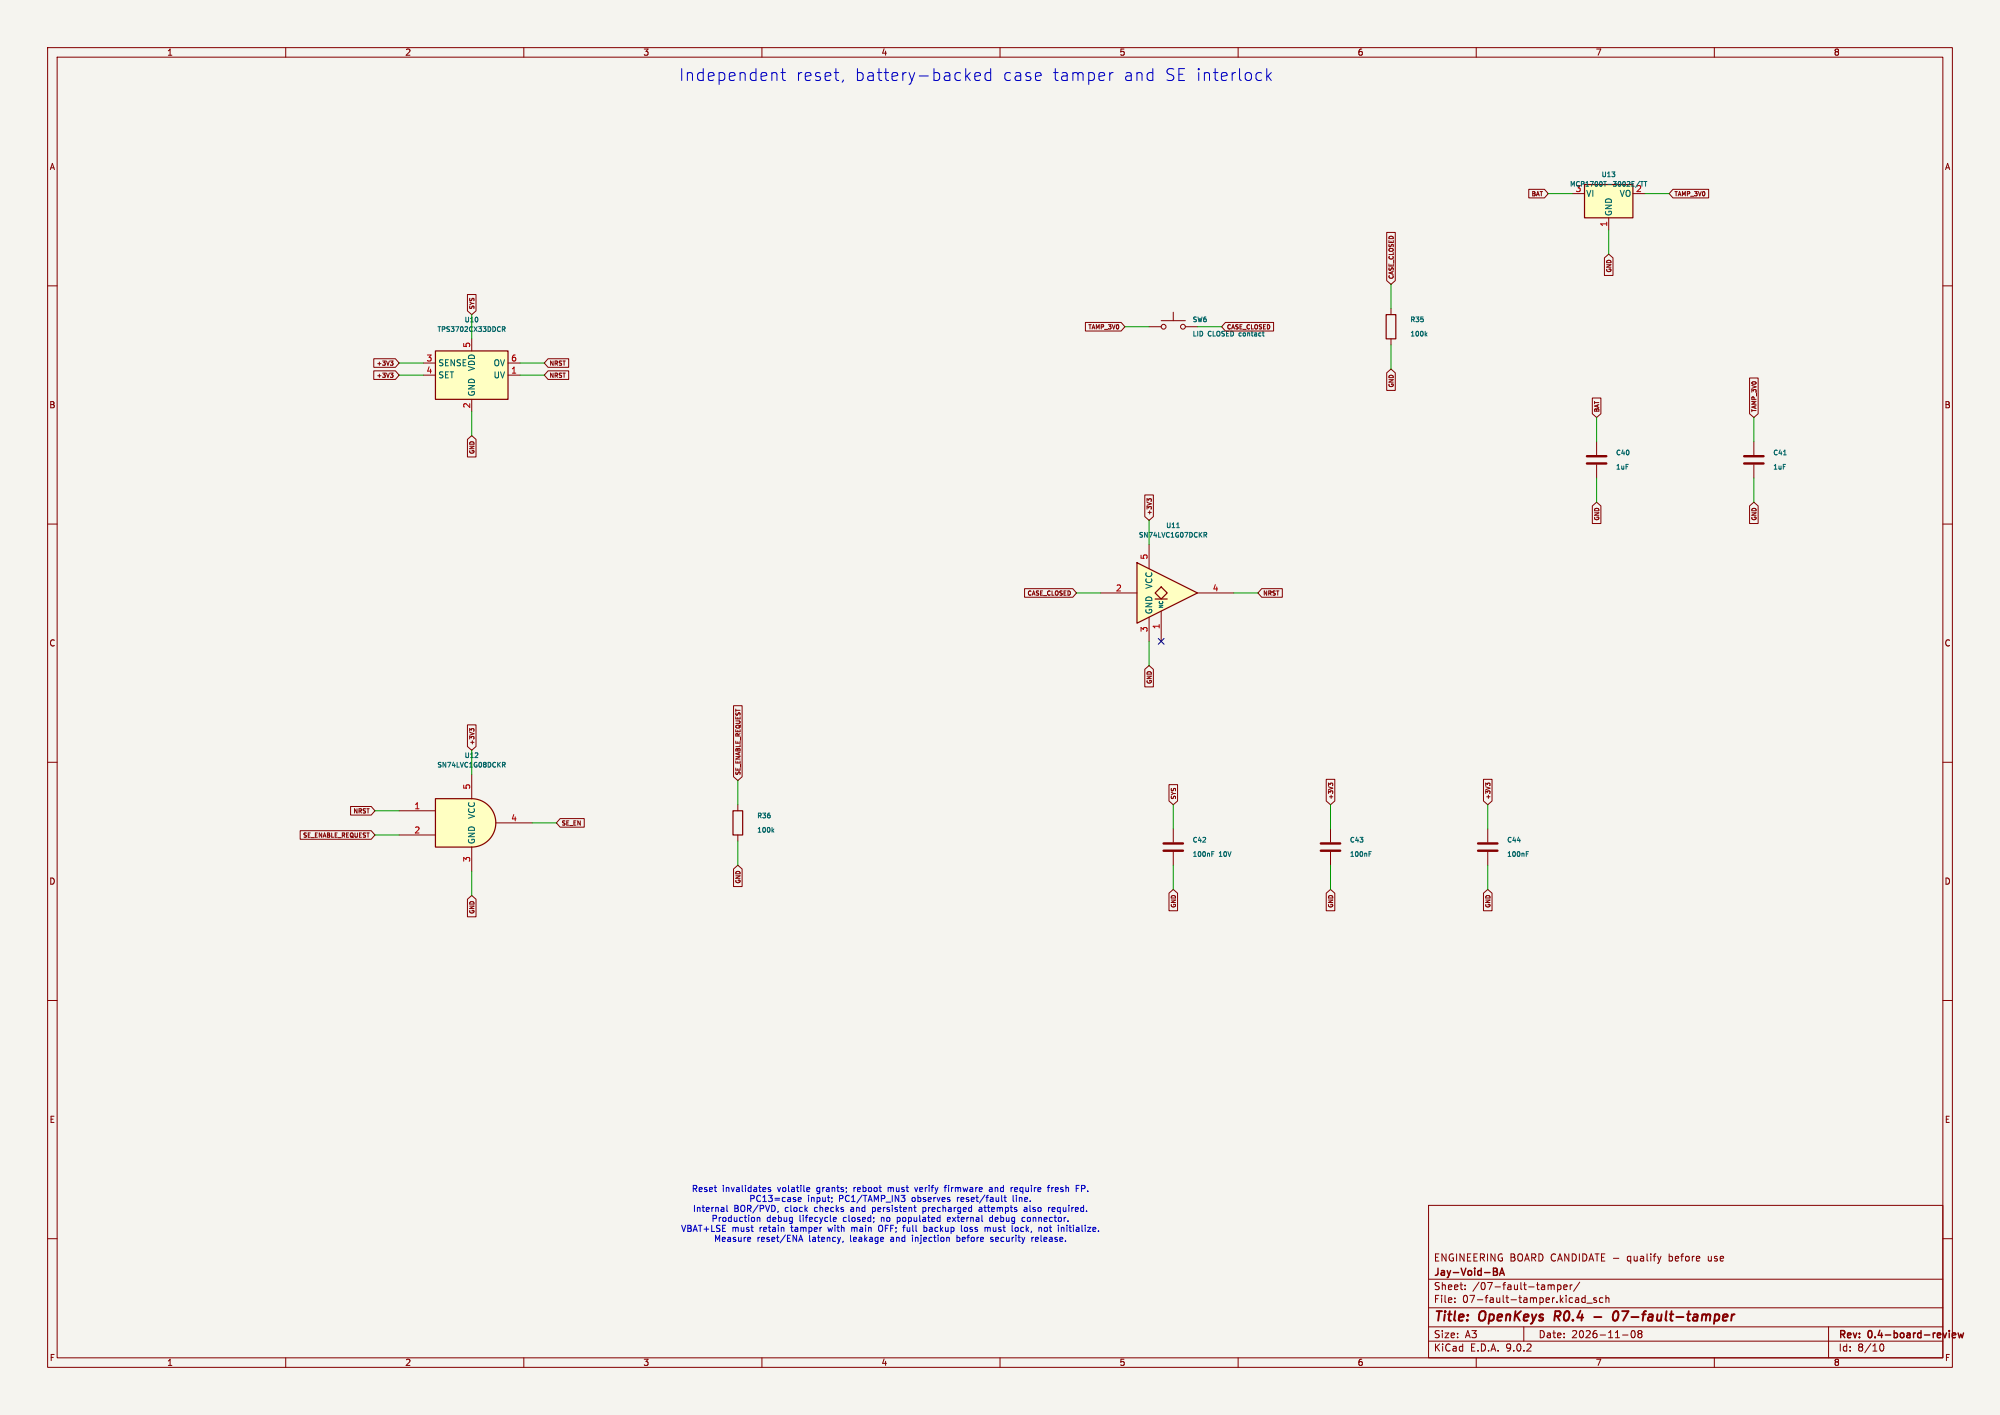
[picture p53: page 8]

Jay-Void-BA
Id: 8/10 Title: OpenKeys R0.4 - 07-fault-tamper File: 07-fault-tamper.kicad_sch Sheet: /07-fault-tamper/

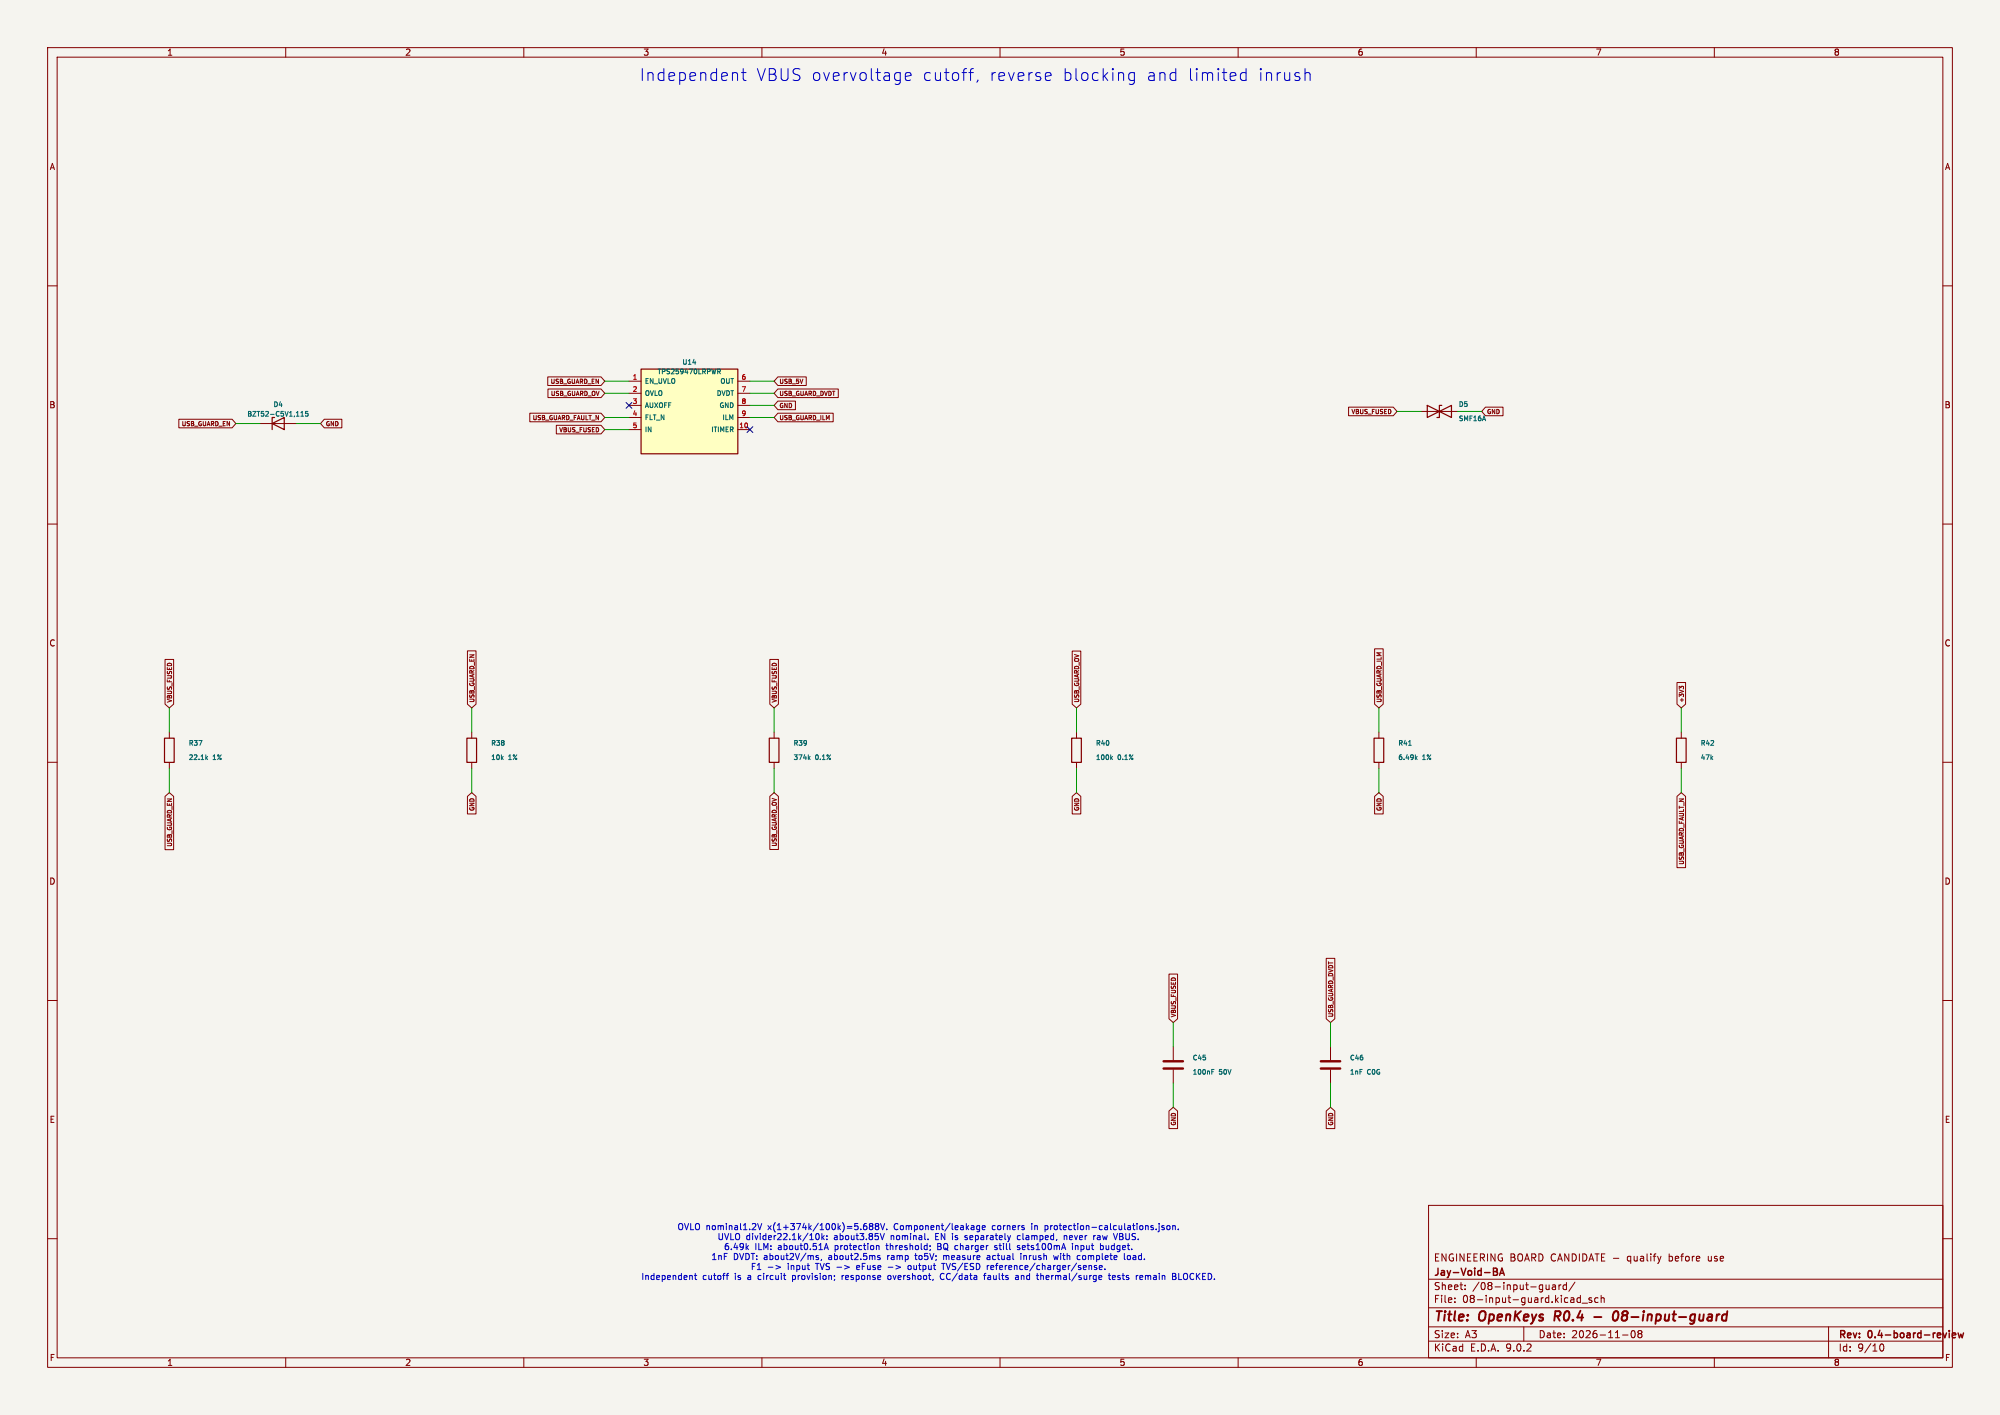
[picture p54: page 9]

Jay-Void-BA
File: 08-input-guard.kicad_sch Sheet: /08-input-guard/
Id: 9/10 Title: OpenKeys R0.4 - 08-input-guard

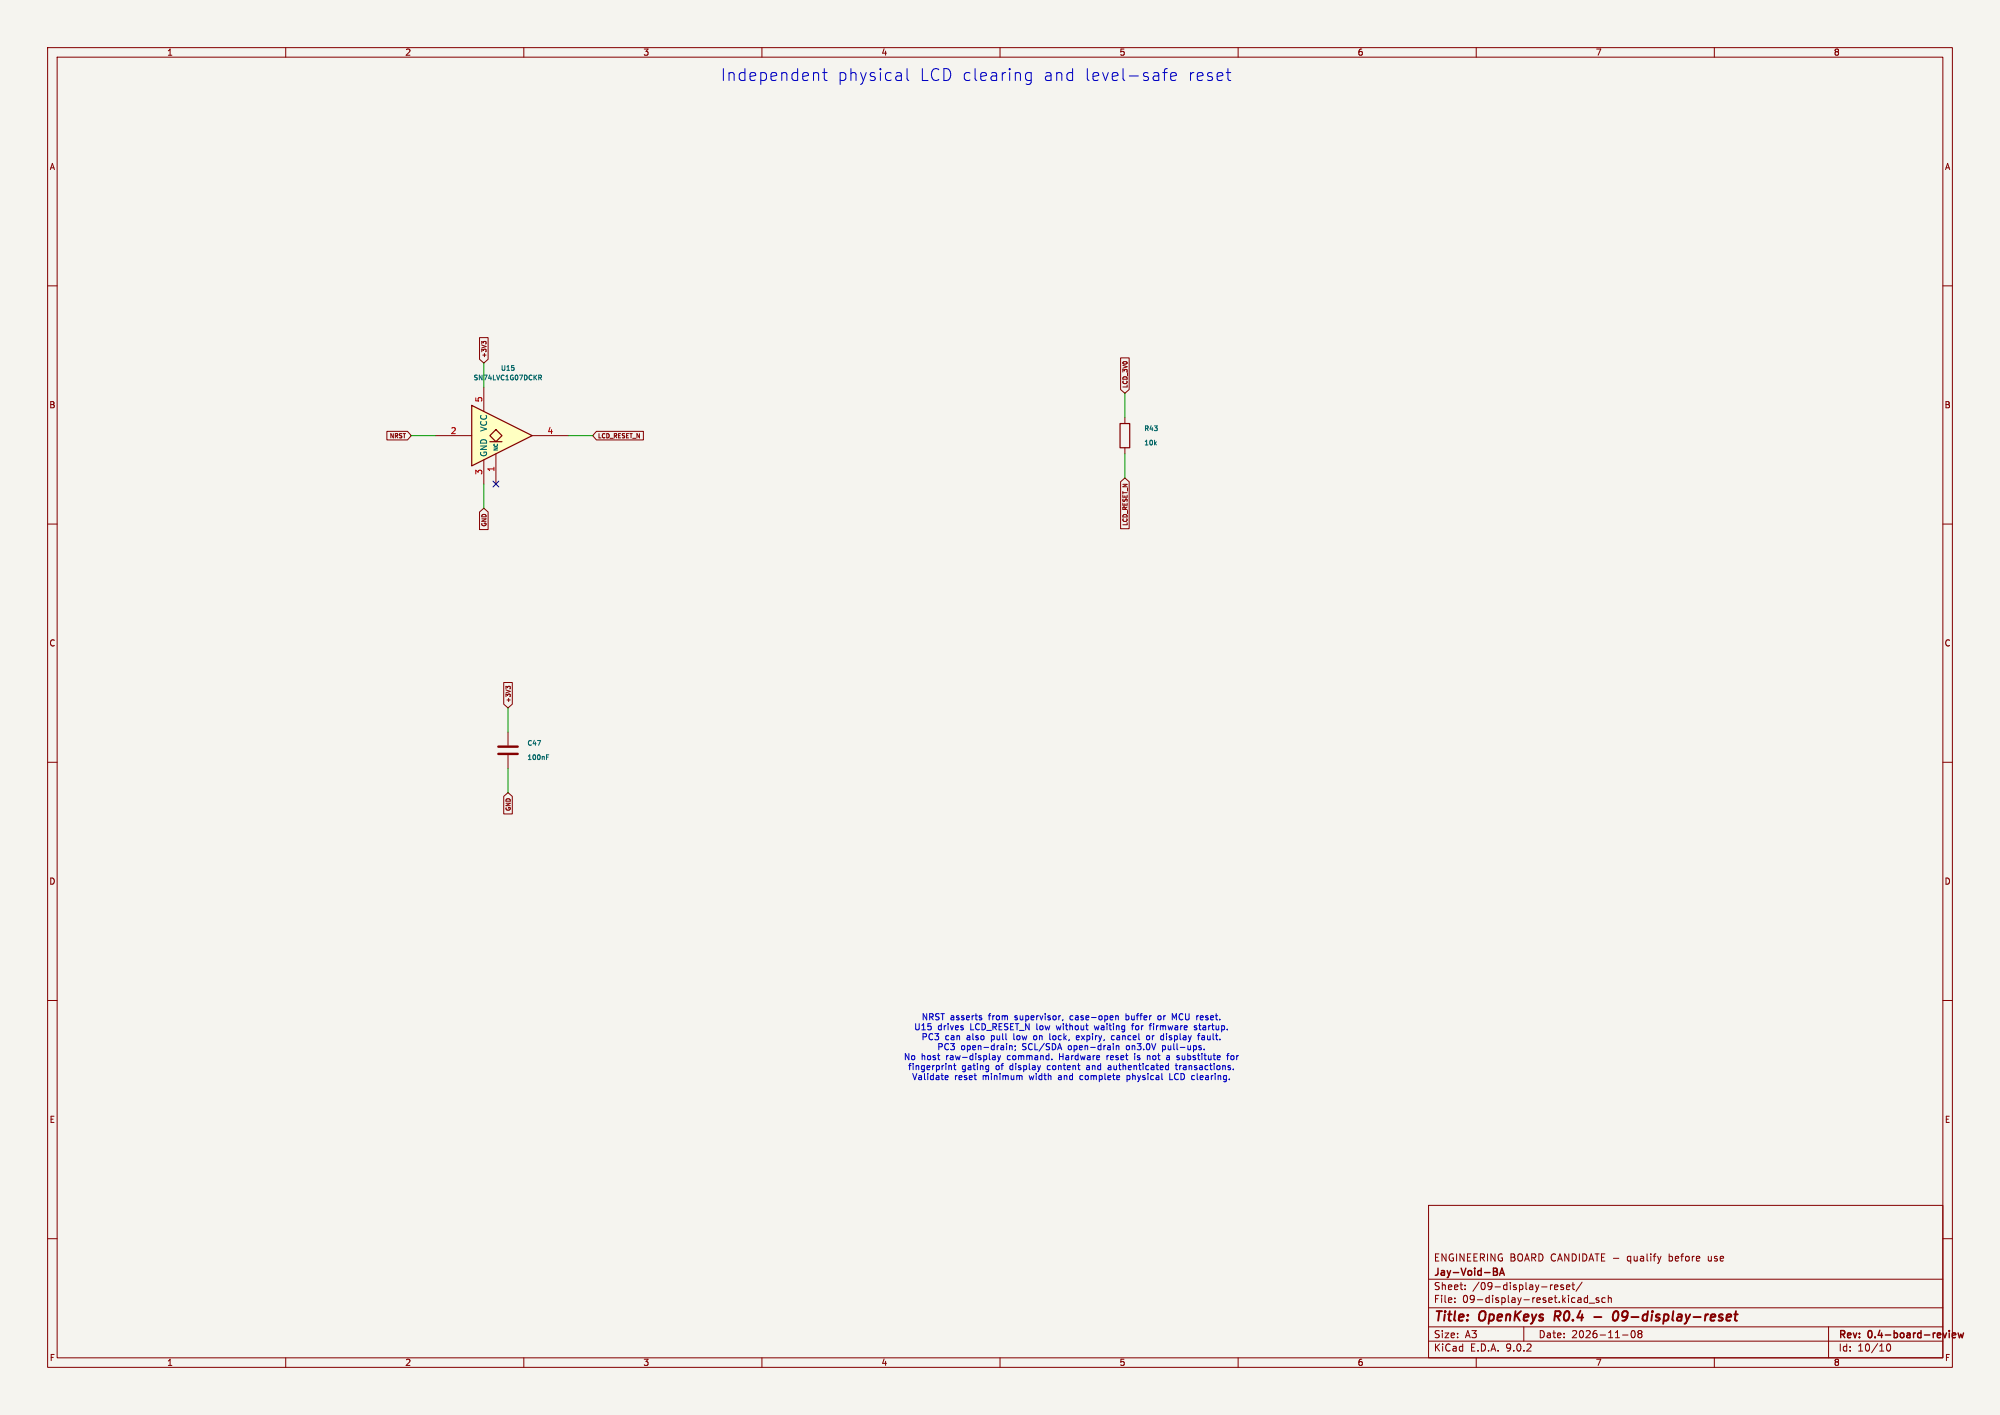
[picture p55: page 10]

Jay-Void-BA
Id: 10/10 Title: OpenKeys R0.4 - 09-display-reset File: 09-display-reset.kicad_sch Sheet: /09-display-reset/
