Jay-Void-BA/OpenKeys/hardware/r03/exports/OpenKeys-schematic.pdf

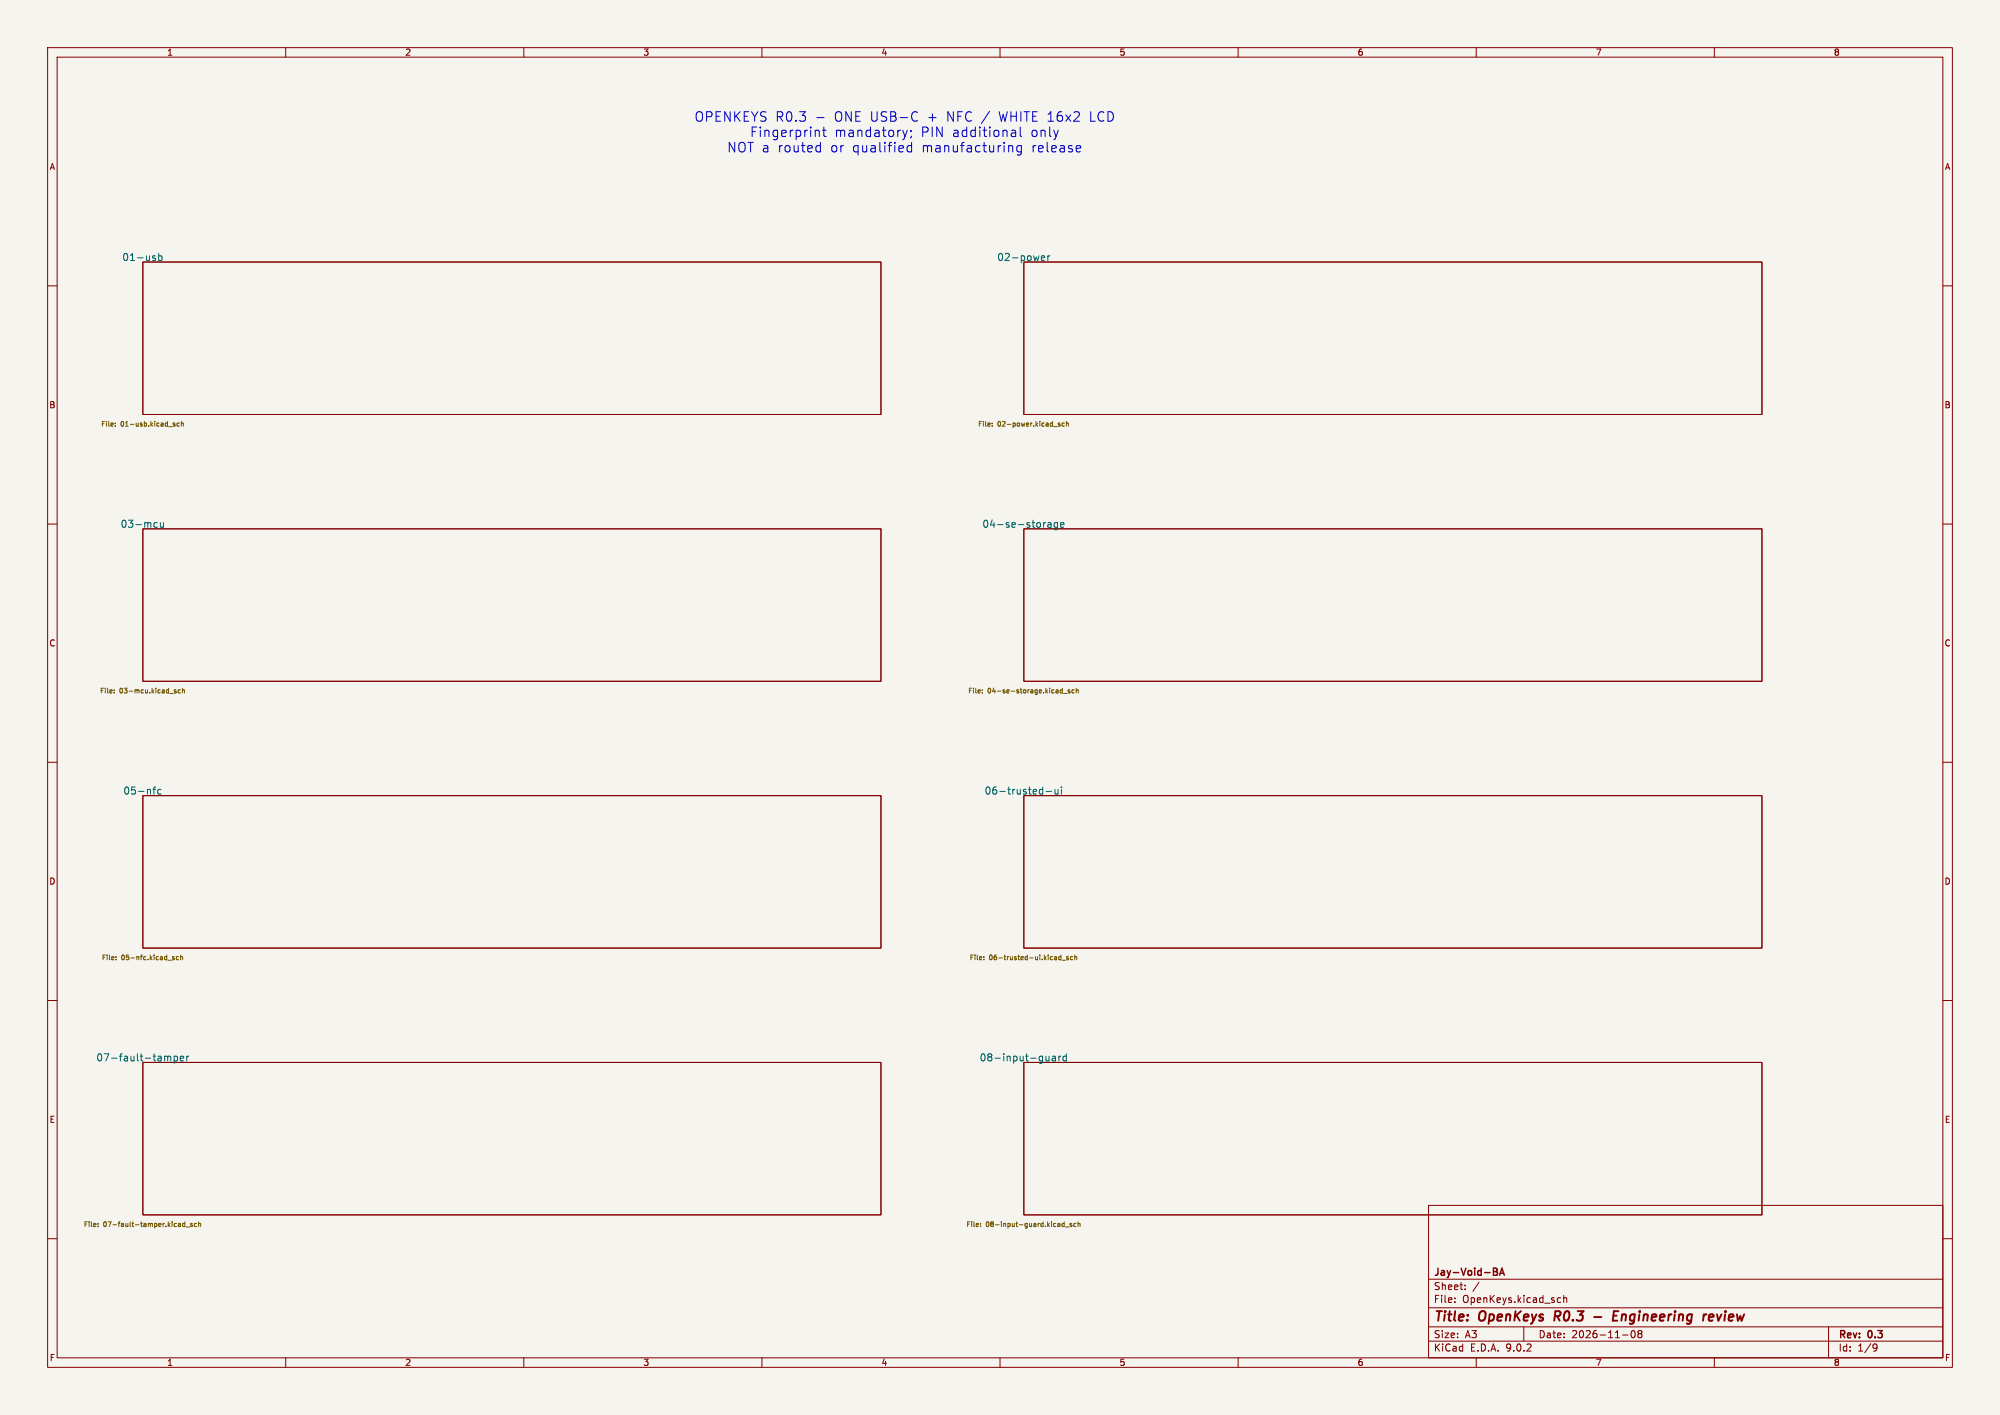
[picture p56: page 1]

02-power File: 02-power.kicad_sch 04-se-storage

File: 04-se-storage.kicad_sch 06-trusted-ui File: 06-trusted-ui.kicad_sch 08-input-guard

File: 05-nfc.kicad_sch 07-fault-tamper File: 07-fault-tamper.kicad_sch

File: OpenKeys.kicad_sch Sheet: / Jay-Void-BA

Id: 1/9 Title: OpenKeys R0.3 - Engineering review

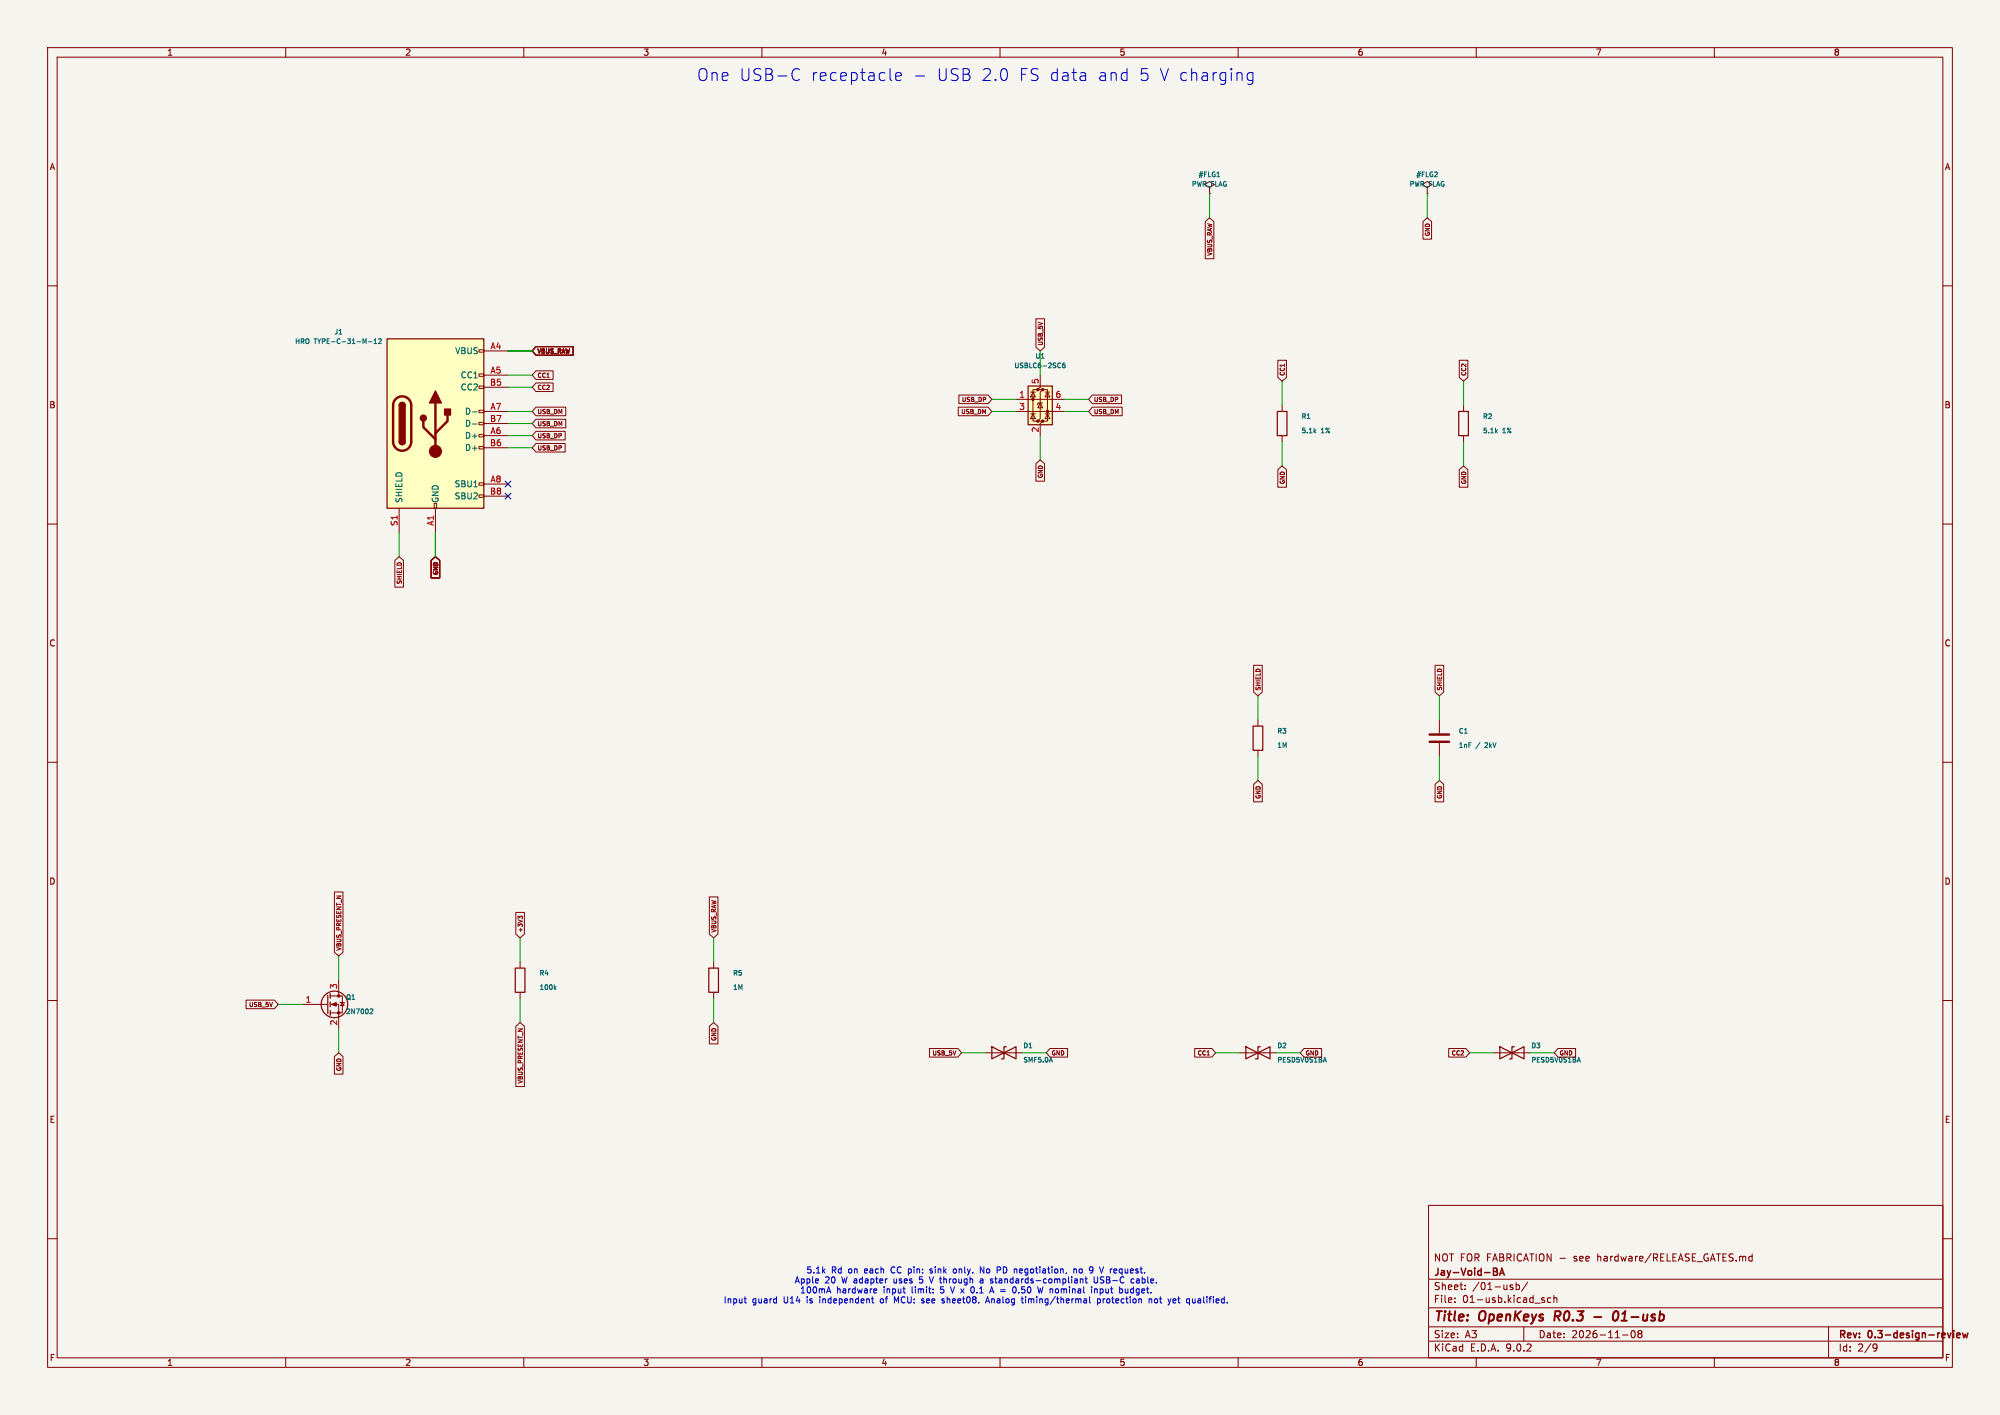
[picture p57: page 2]

File: 01-usb.kicad_sch Sheet: /01-usb/ Jay-Void-BA

Id: 2/9 Title: OpenKeys R0.3 - 01-usb

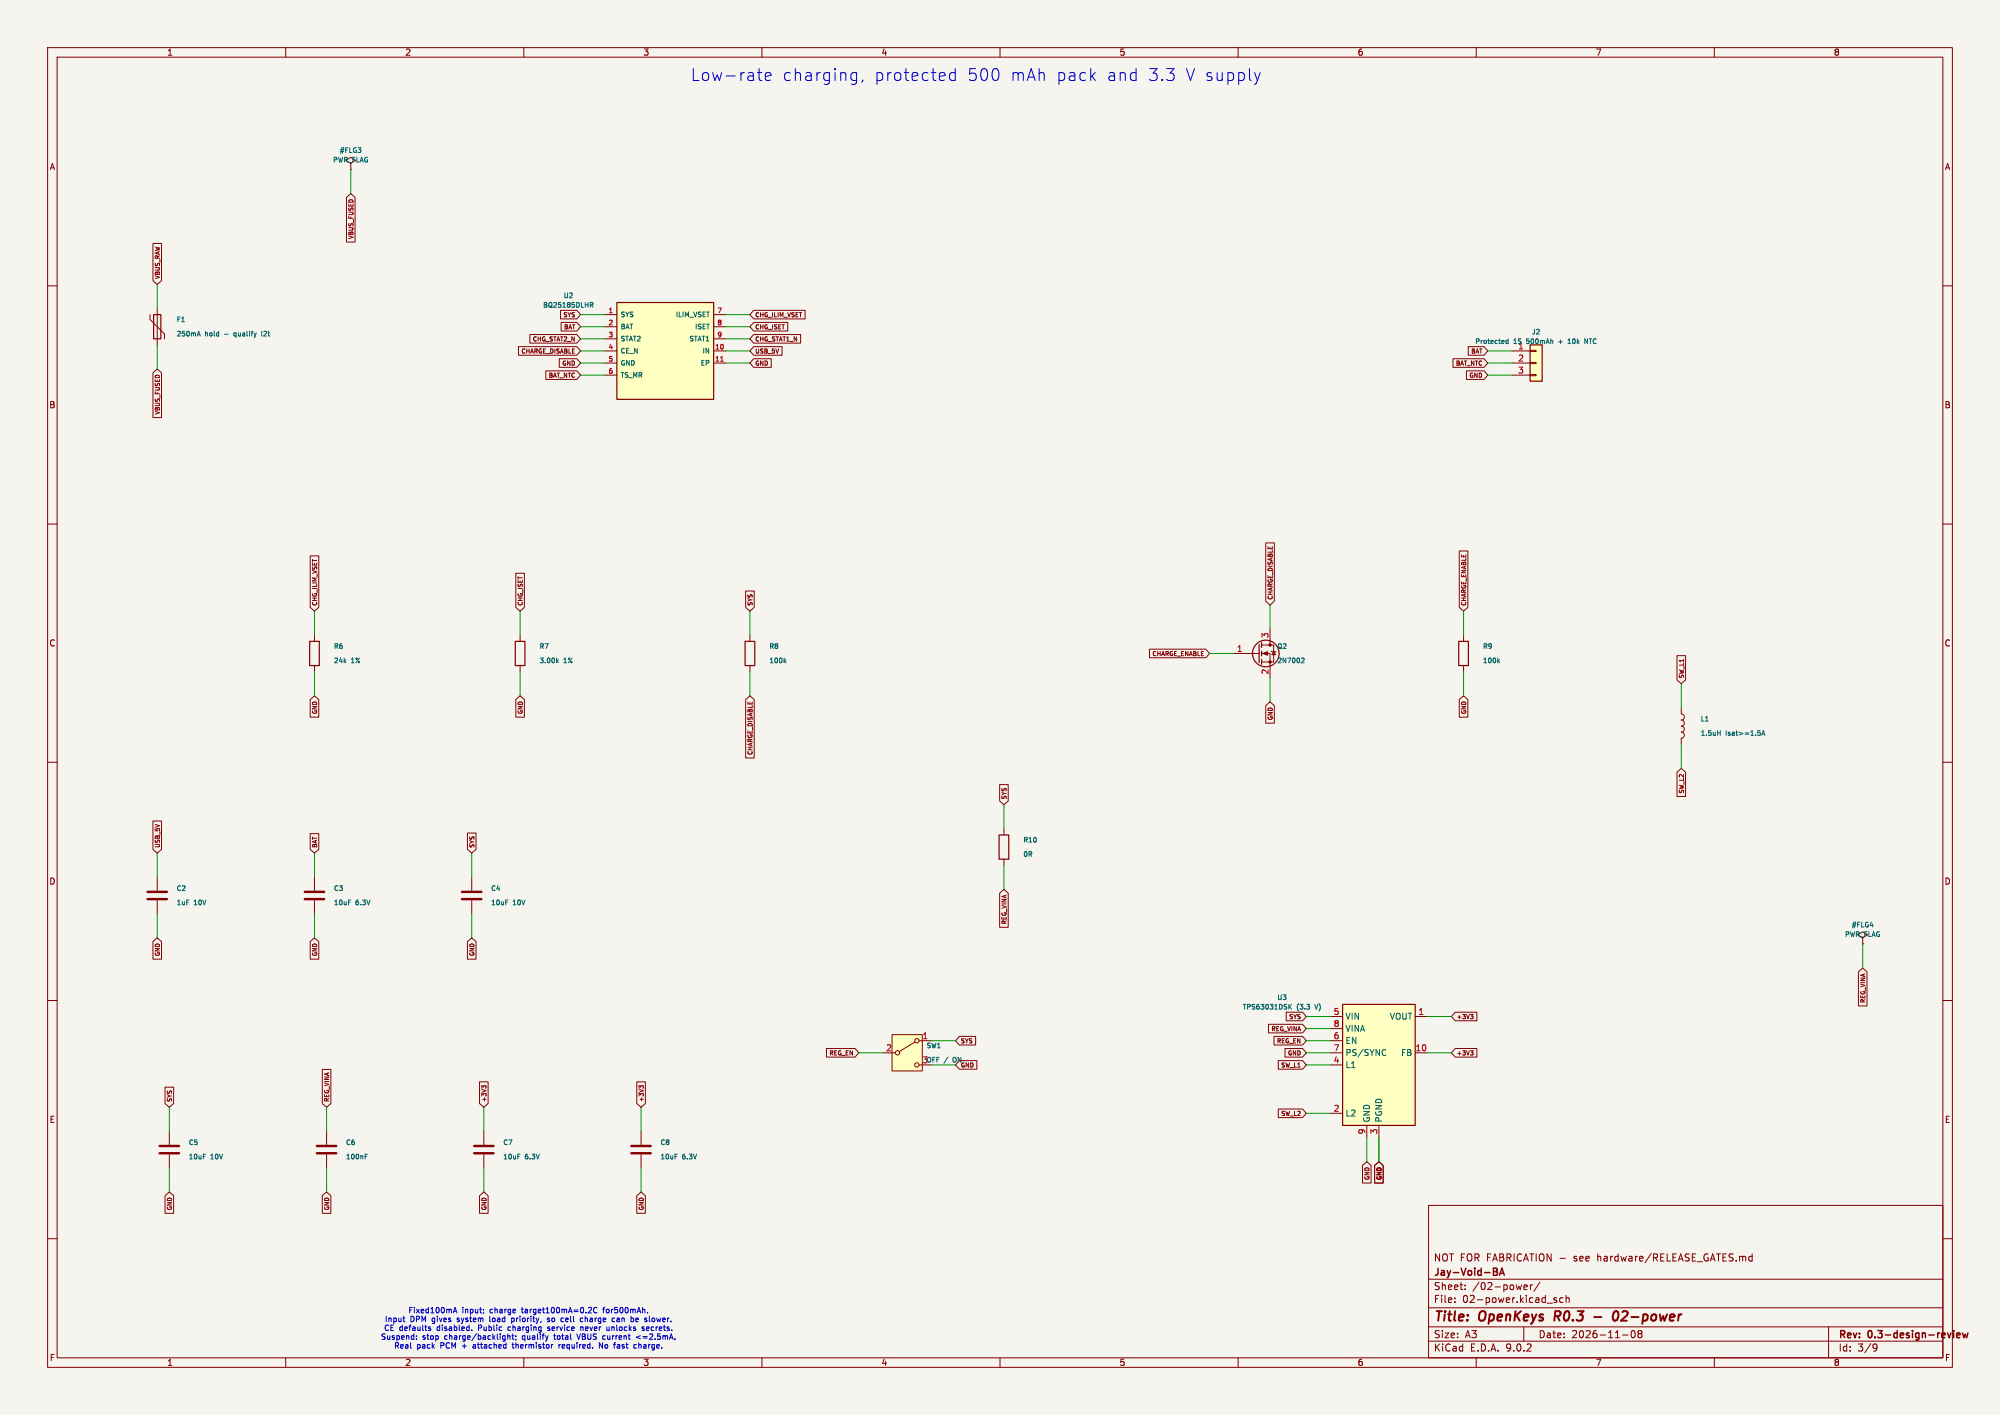
[picture p58: page 3]

Jay-Void-BA
Id: 3/9 Title: OpenKeys R0.3 - 02-power File: 02-power.kicad_sch Sheet: /02-power/

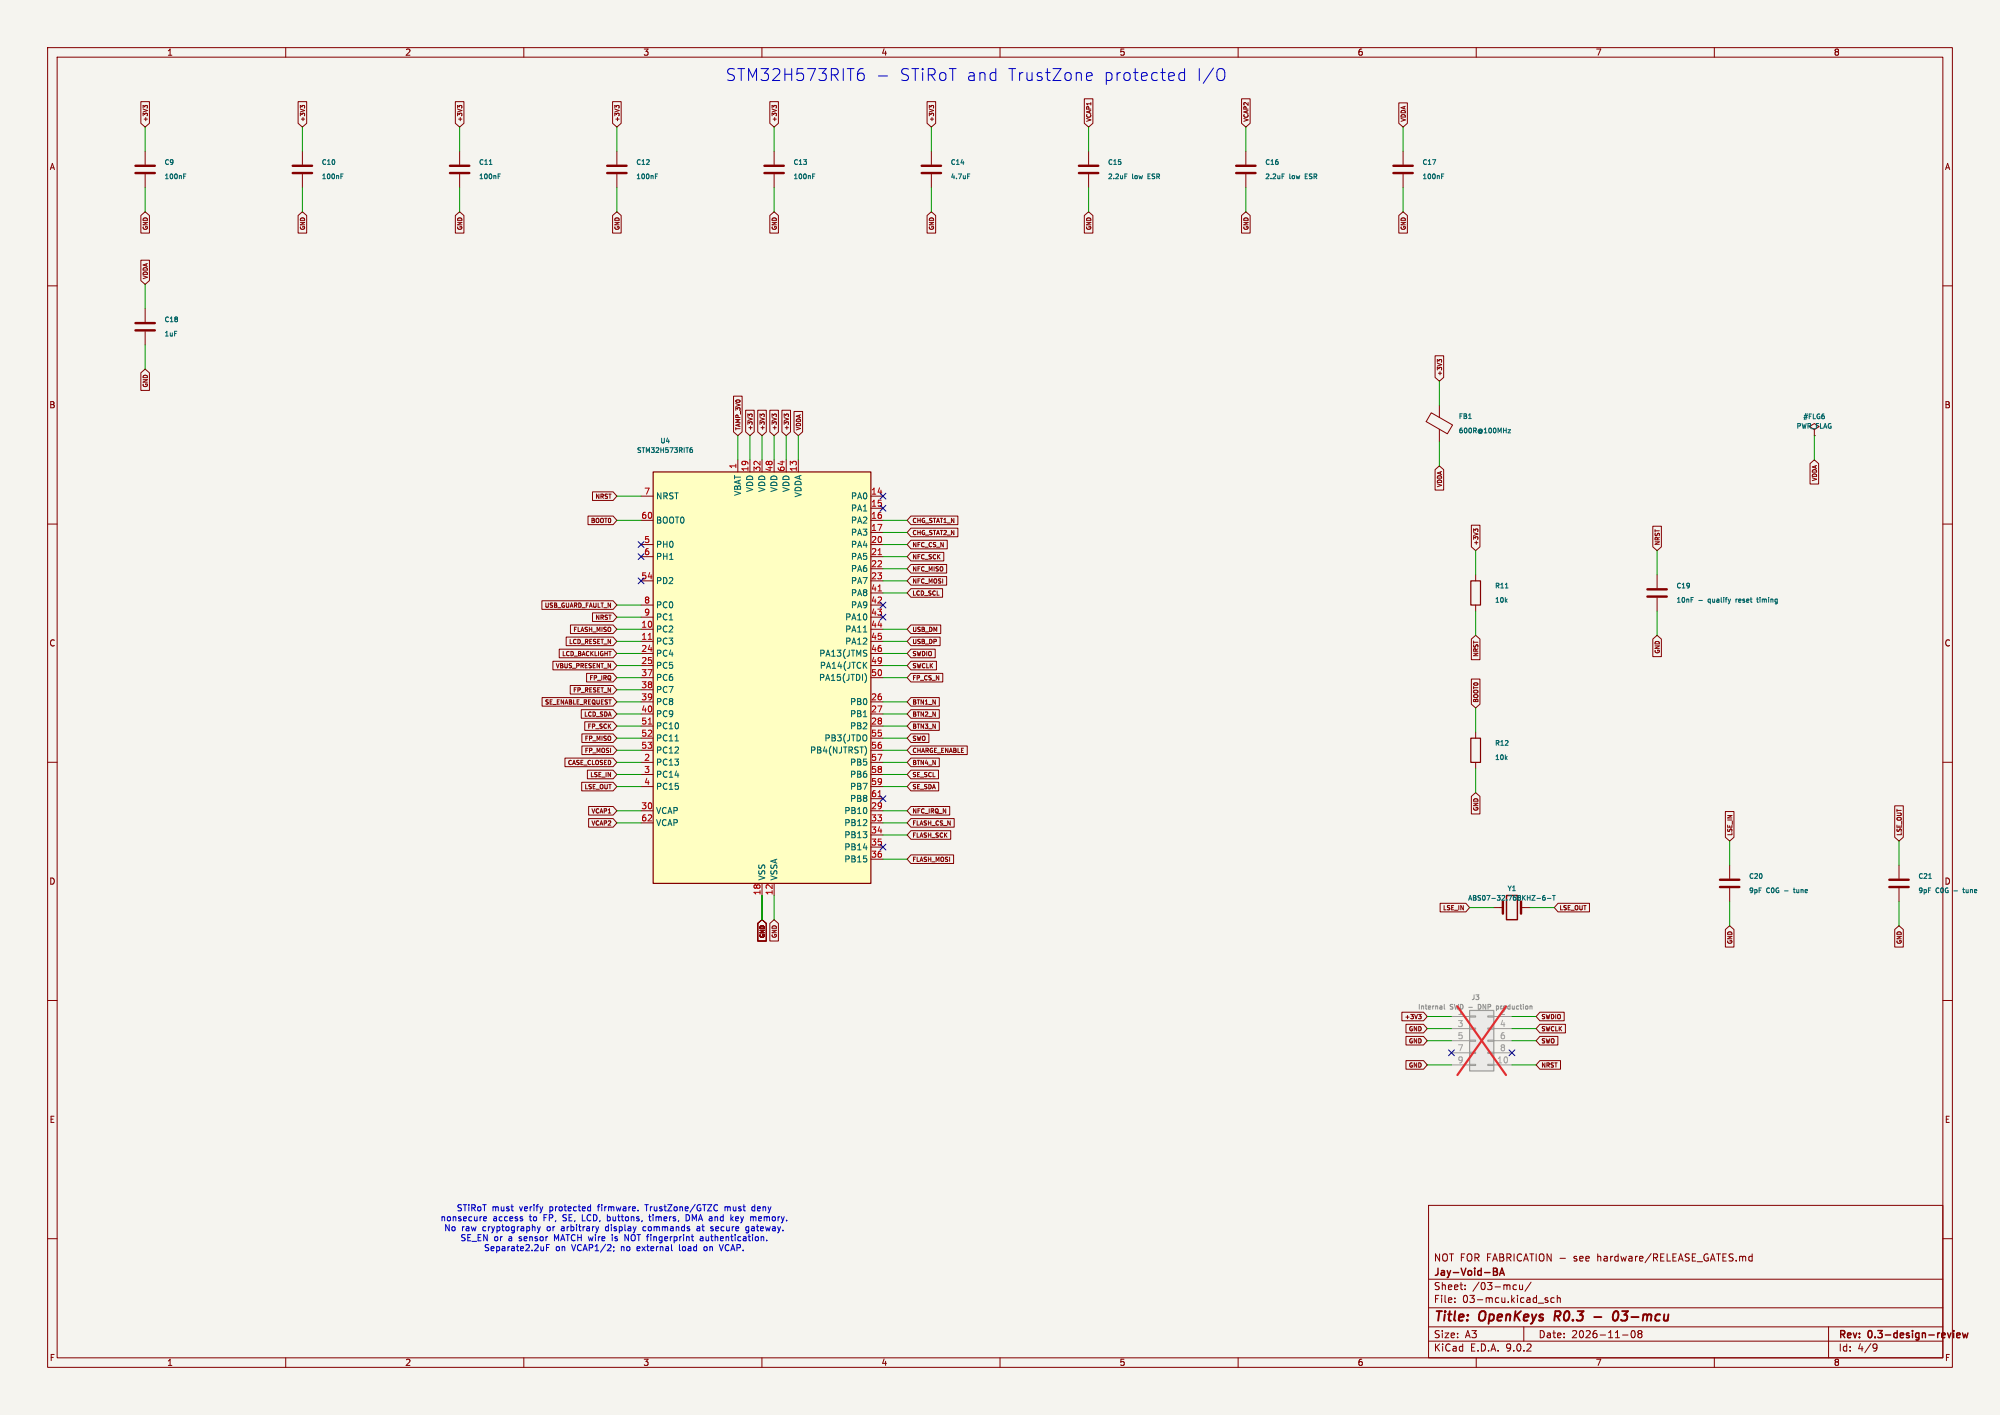
[picture p59: page 4]

1 VDD 19 VDD 32 VSS 18 VDD 48 VSSA 12 VDD 64 VDDA 13 PA0 14 PA1 15 PA2 16 PA3 17 PA4 20 PA5 21 PA6 22 PA7 23 PA8 41 PA9 42 PA10 43 PA11 44 PA12 45 PA13(JTMS 46 PA14(JTCK 49 PA15(JTDI) 50 PB0 26 PB1 27 PB2 28 PB3(JTDO 55 PB4(NJTRST) 56 PB5 57 PB6 58 PB7 59 PB8 61 PB10 29 PB12 33 PB13 34 PB14 35 PB15 36

File: 03-mcu.kicad_sch Sheet: /03-mcu/ Jay-Void-BA

Id: 4/9 Title: OpenKeys R0.3 - 03-mcu

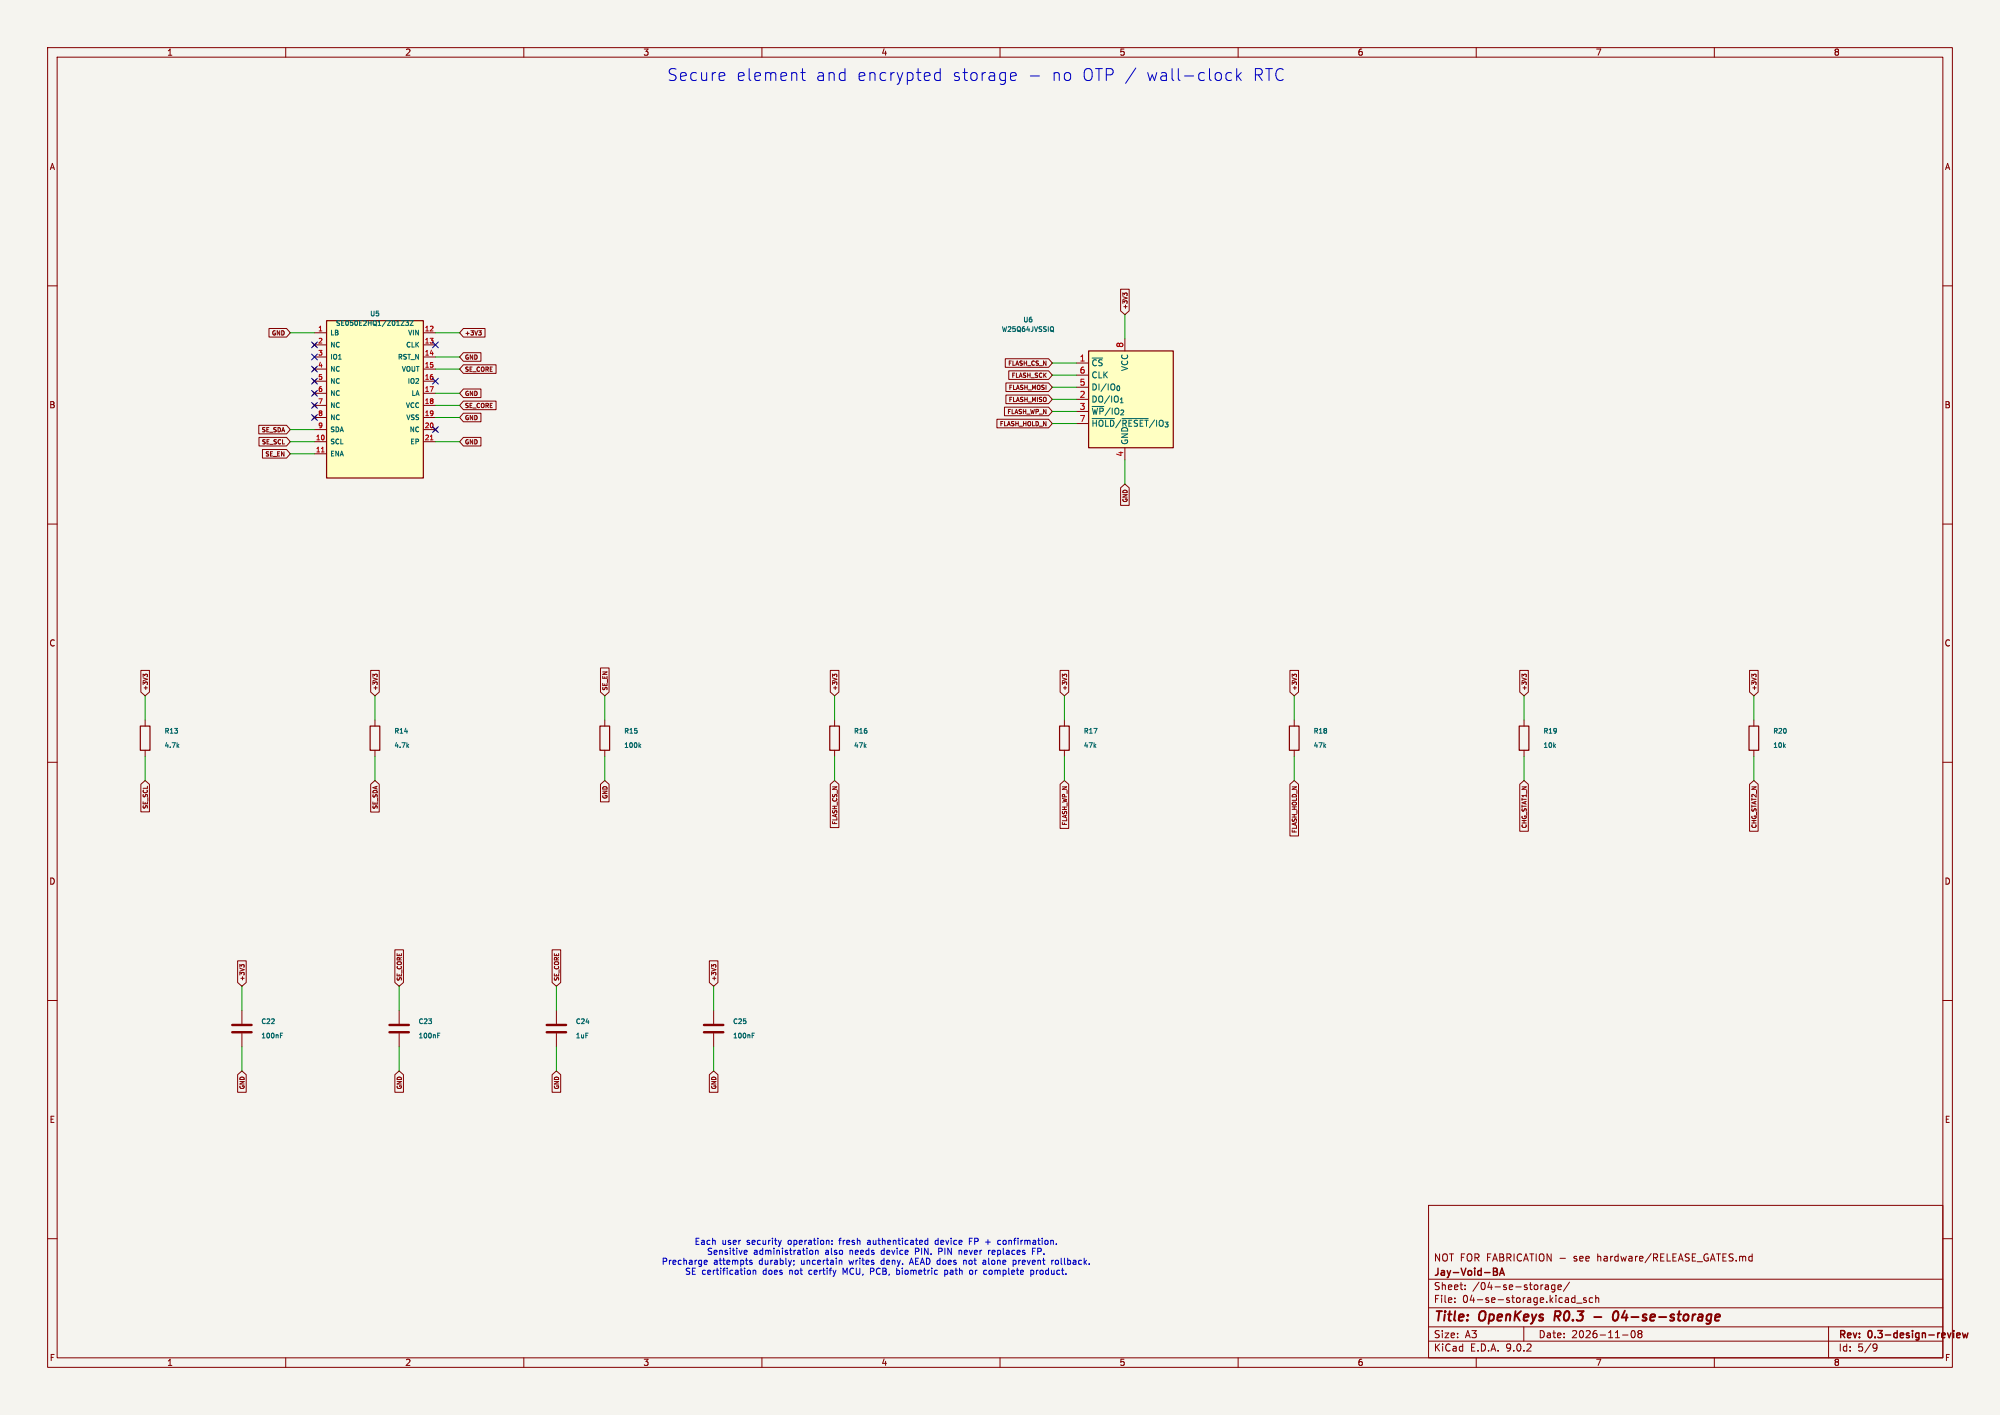
[picture p60: page 5]

Jay-Void-BA
File: 04-se-storage.kicad_sch Sheet: /04-se-storage/
Id: 5/9 Title: OpenKeys R0.3 - 04-se-storage

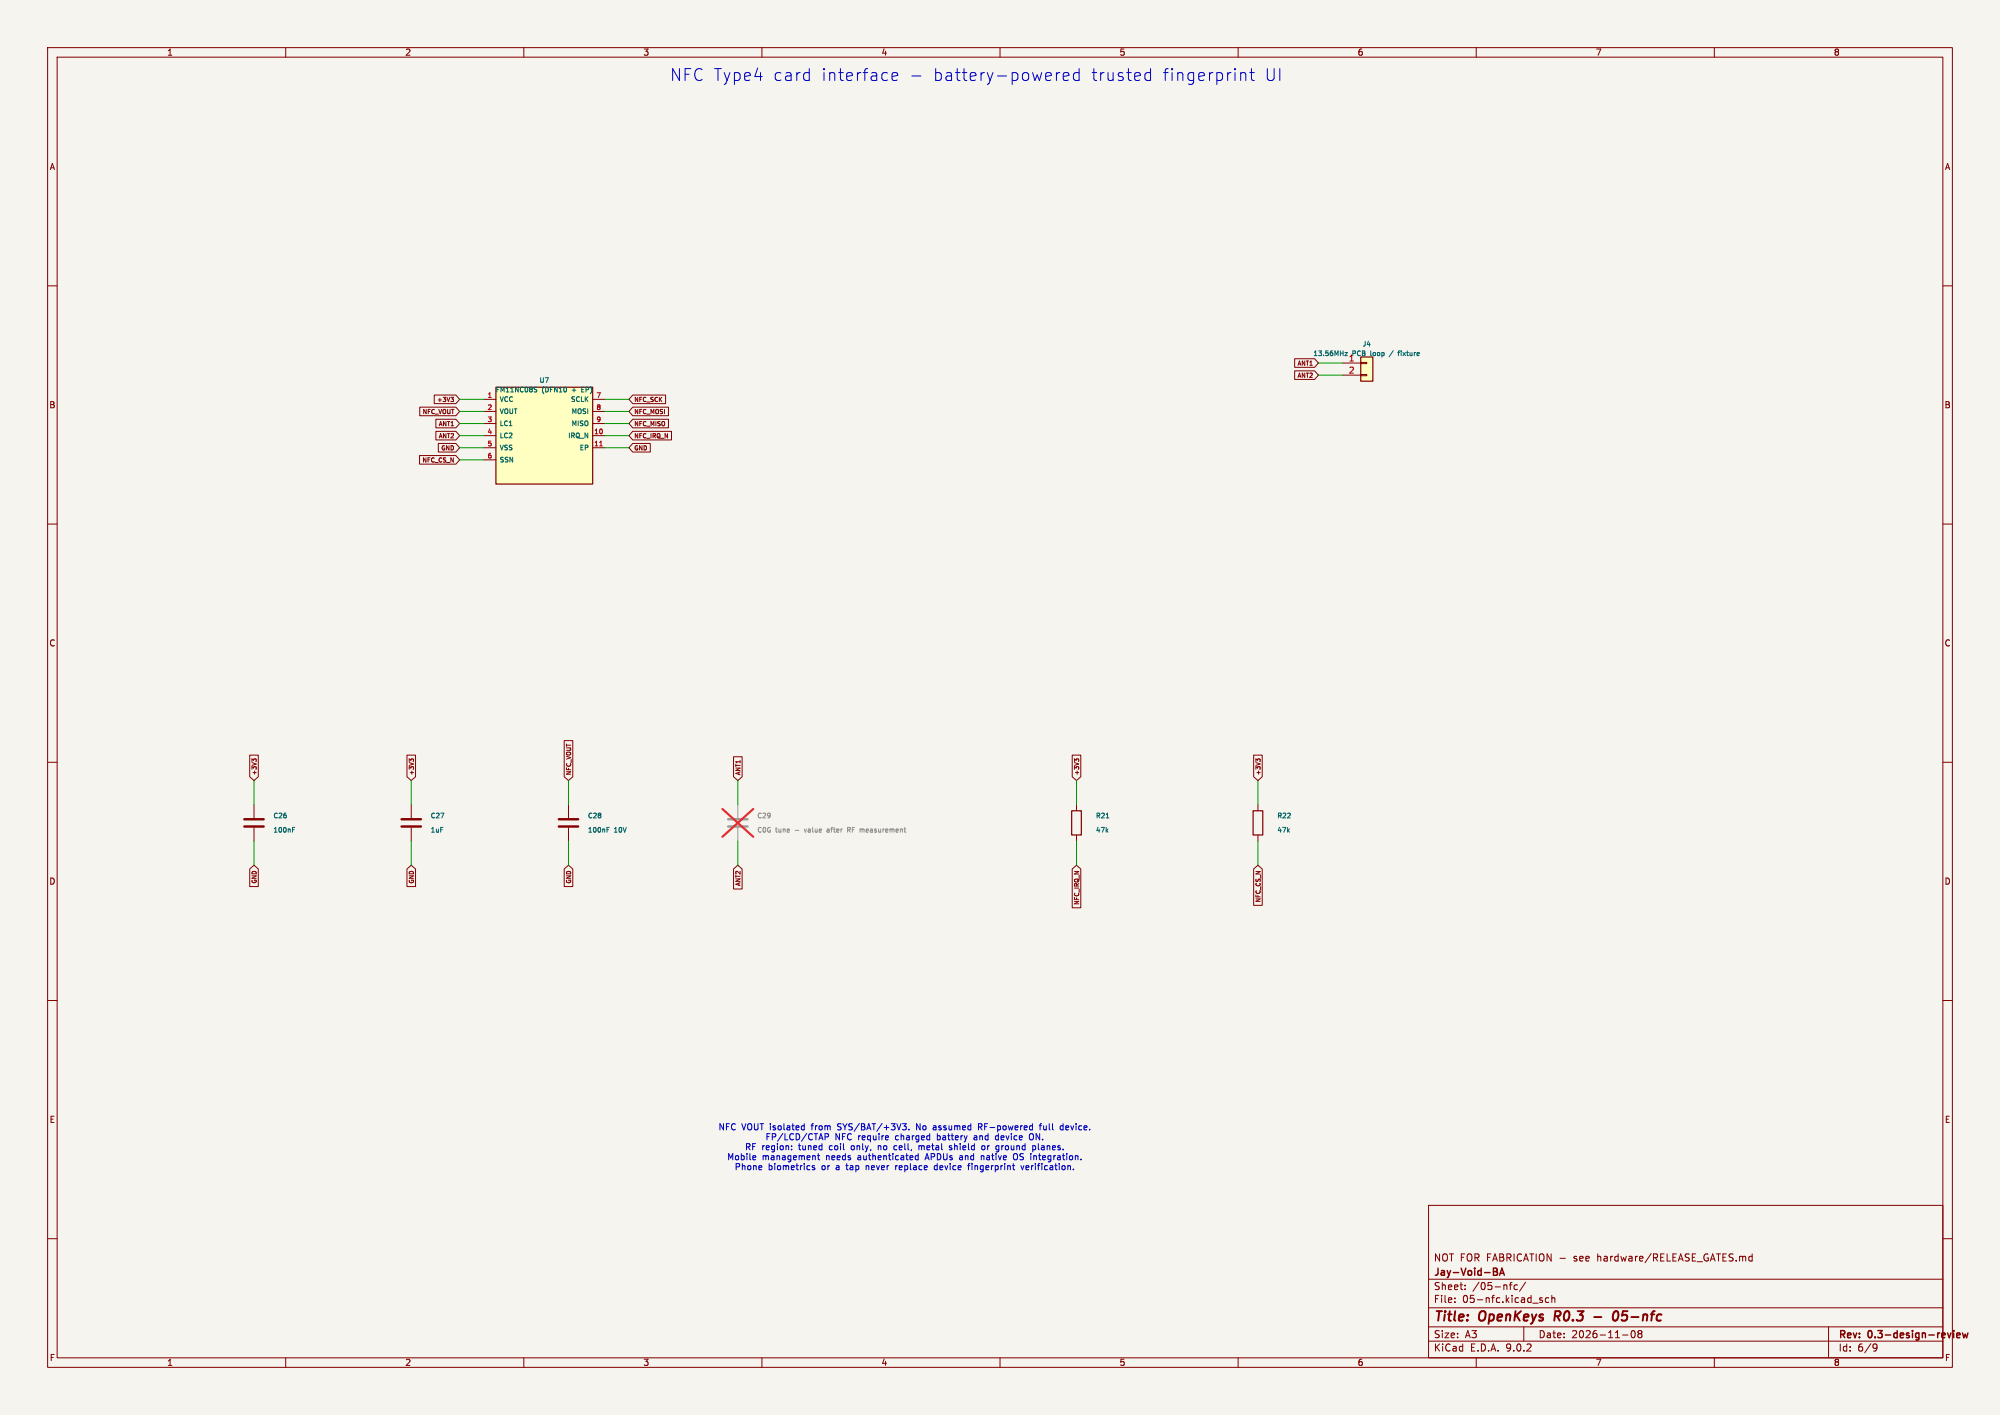
[picture p61: page 6]

File: 05-nfc.kicad_sch Sheet: /05-nfc/ Jay-Void-BA

Id: 6/9 Title: OpenKeys R0.3 - 05-nfc

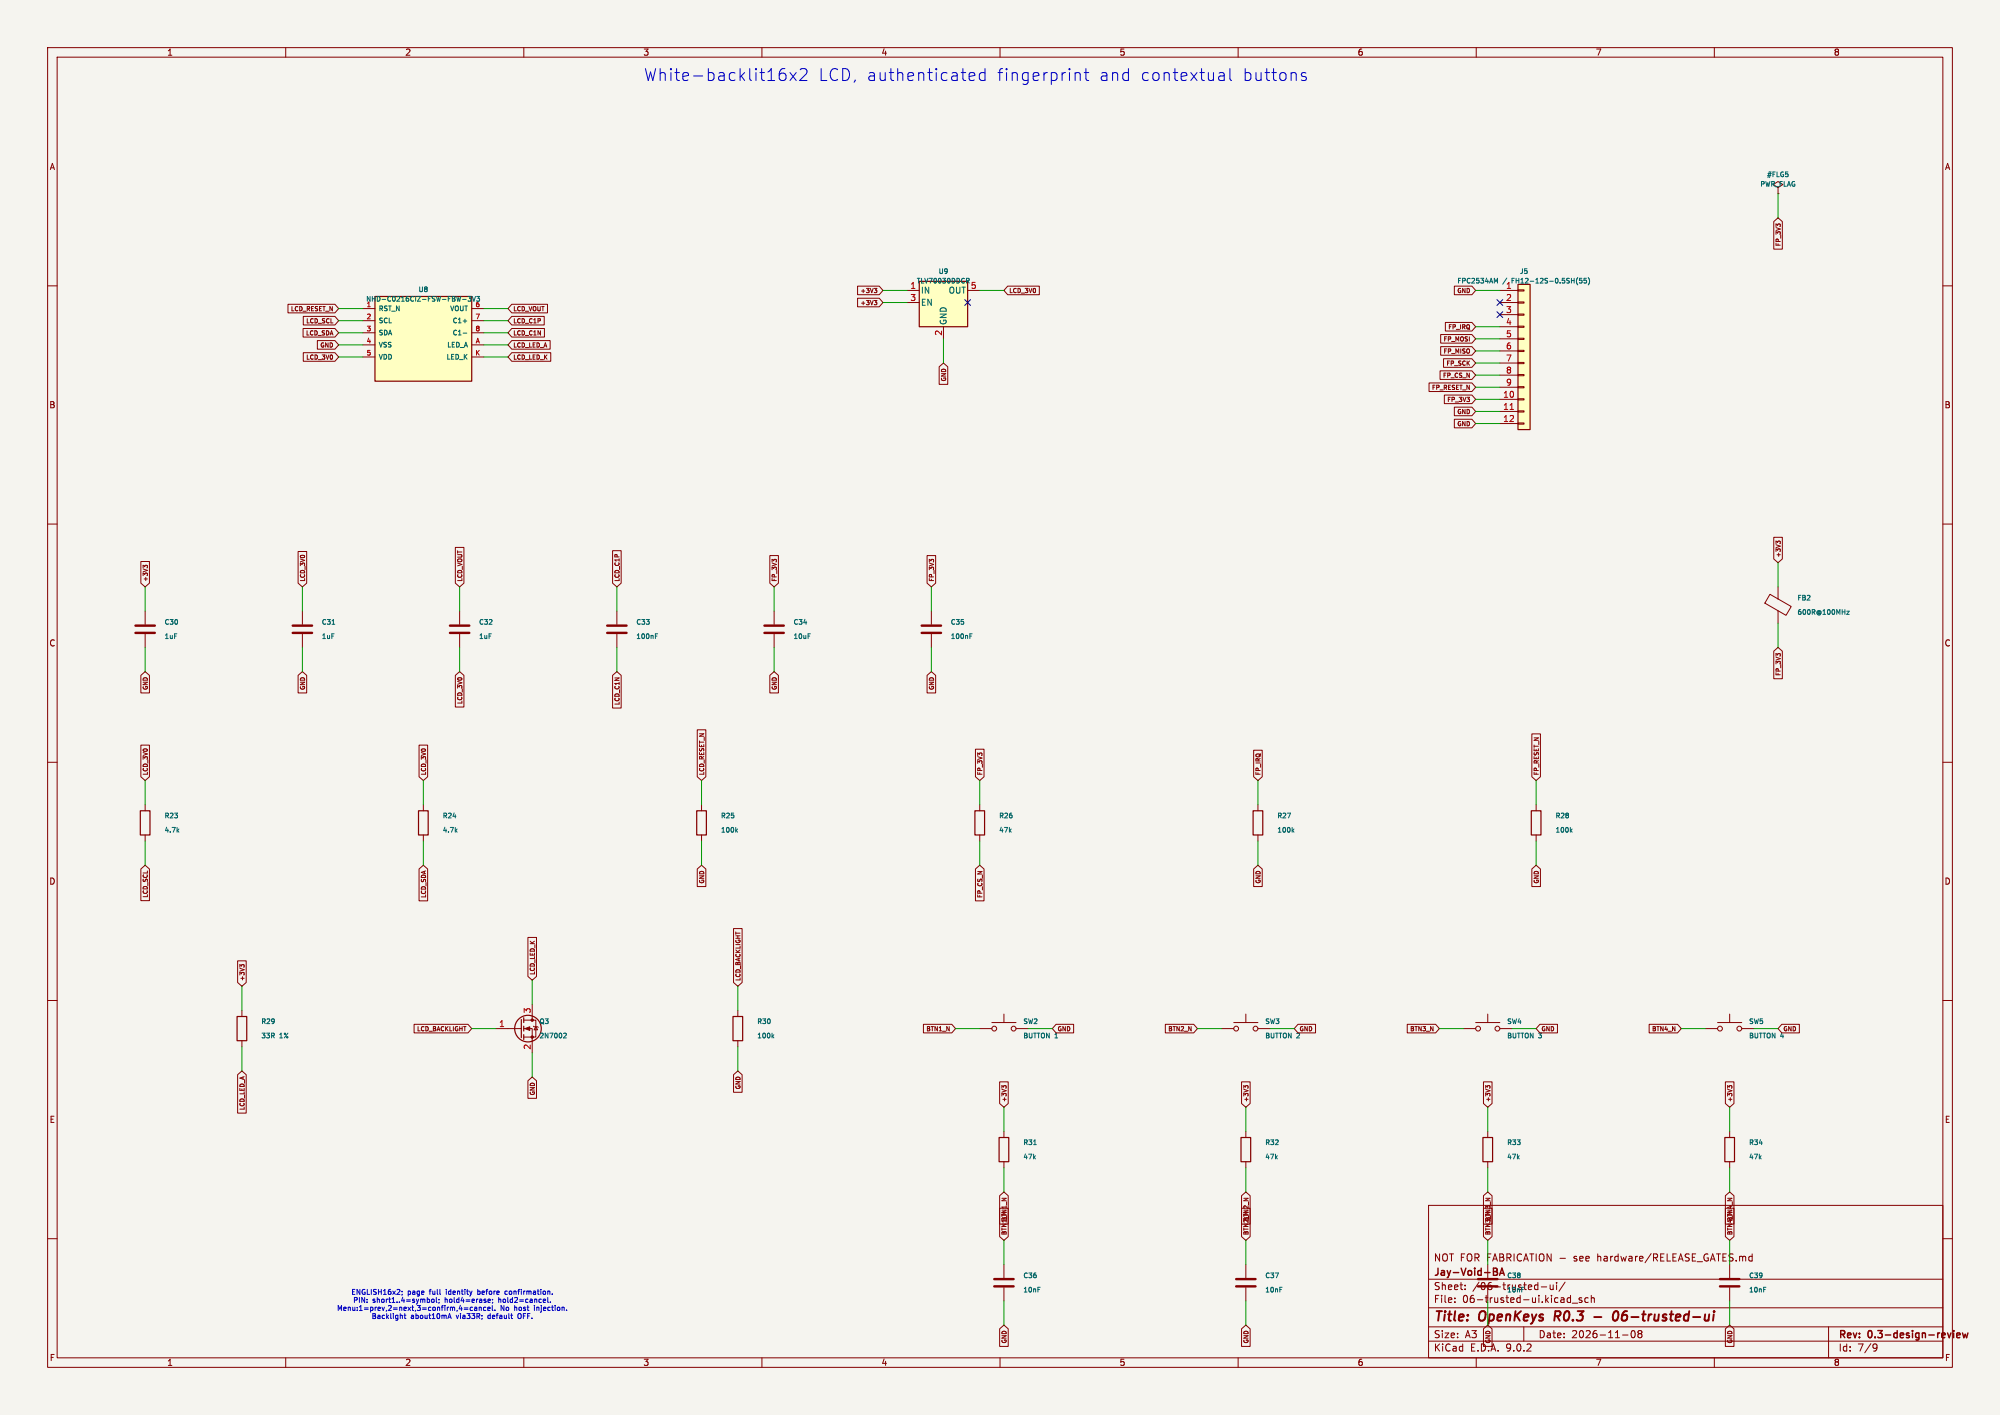
[picture p62: page 7]

Id: 7/9 Title: OpenKeys R0.3 - 06-trusted-ui File: 06-trusted-ui.kicad_sch Sheet: /06-trusted-ui/ Jay-Void-BA

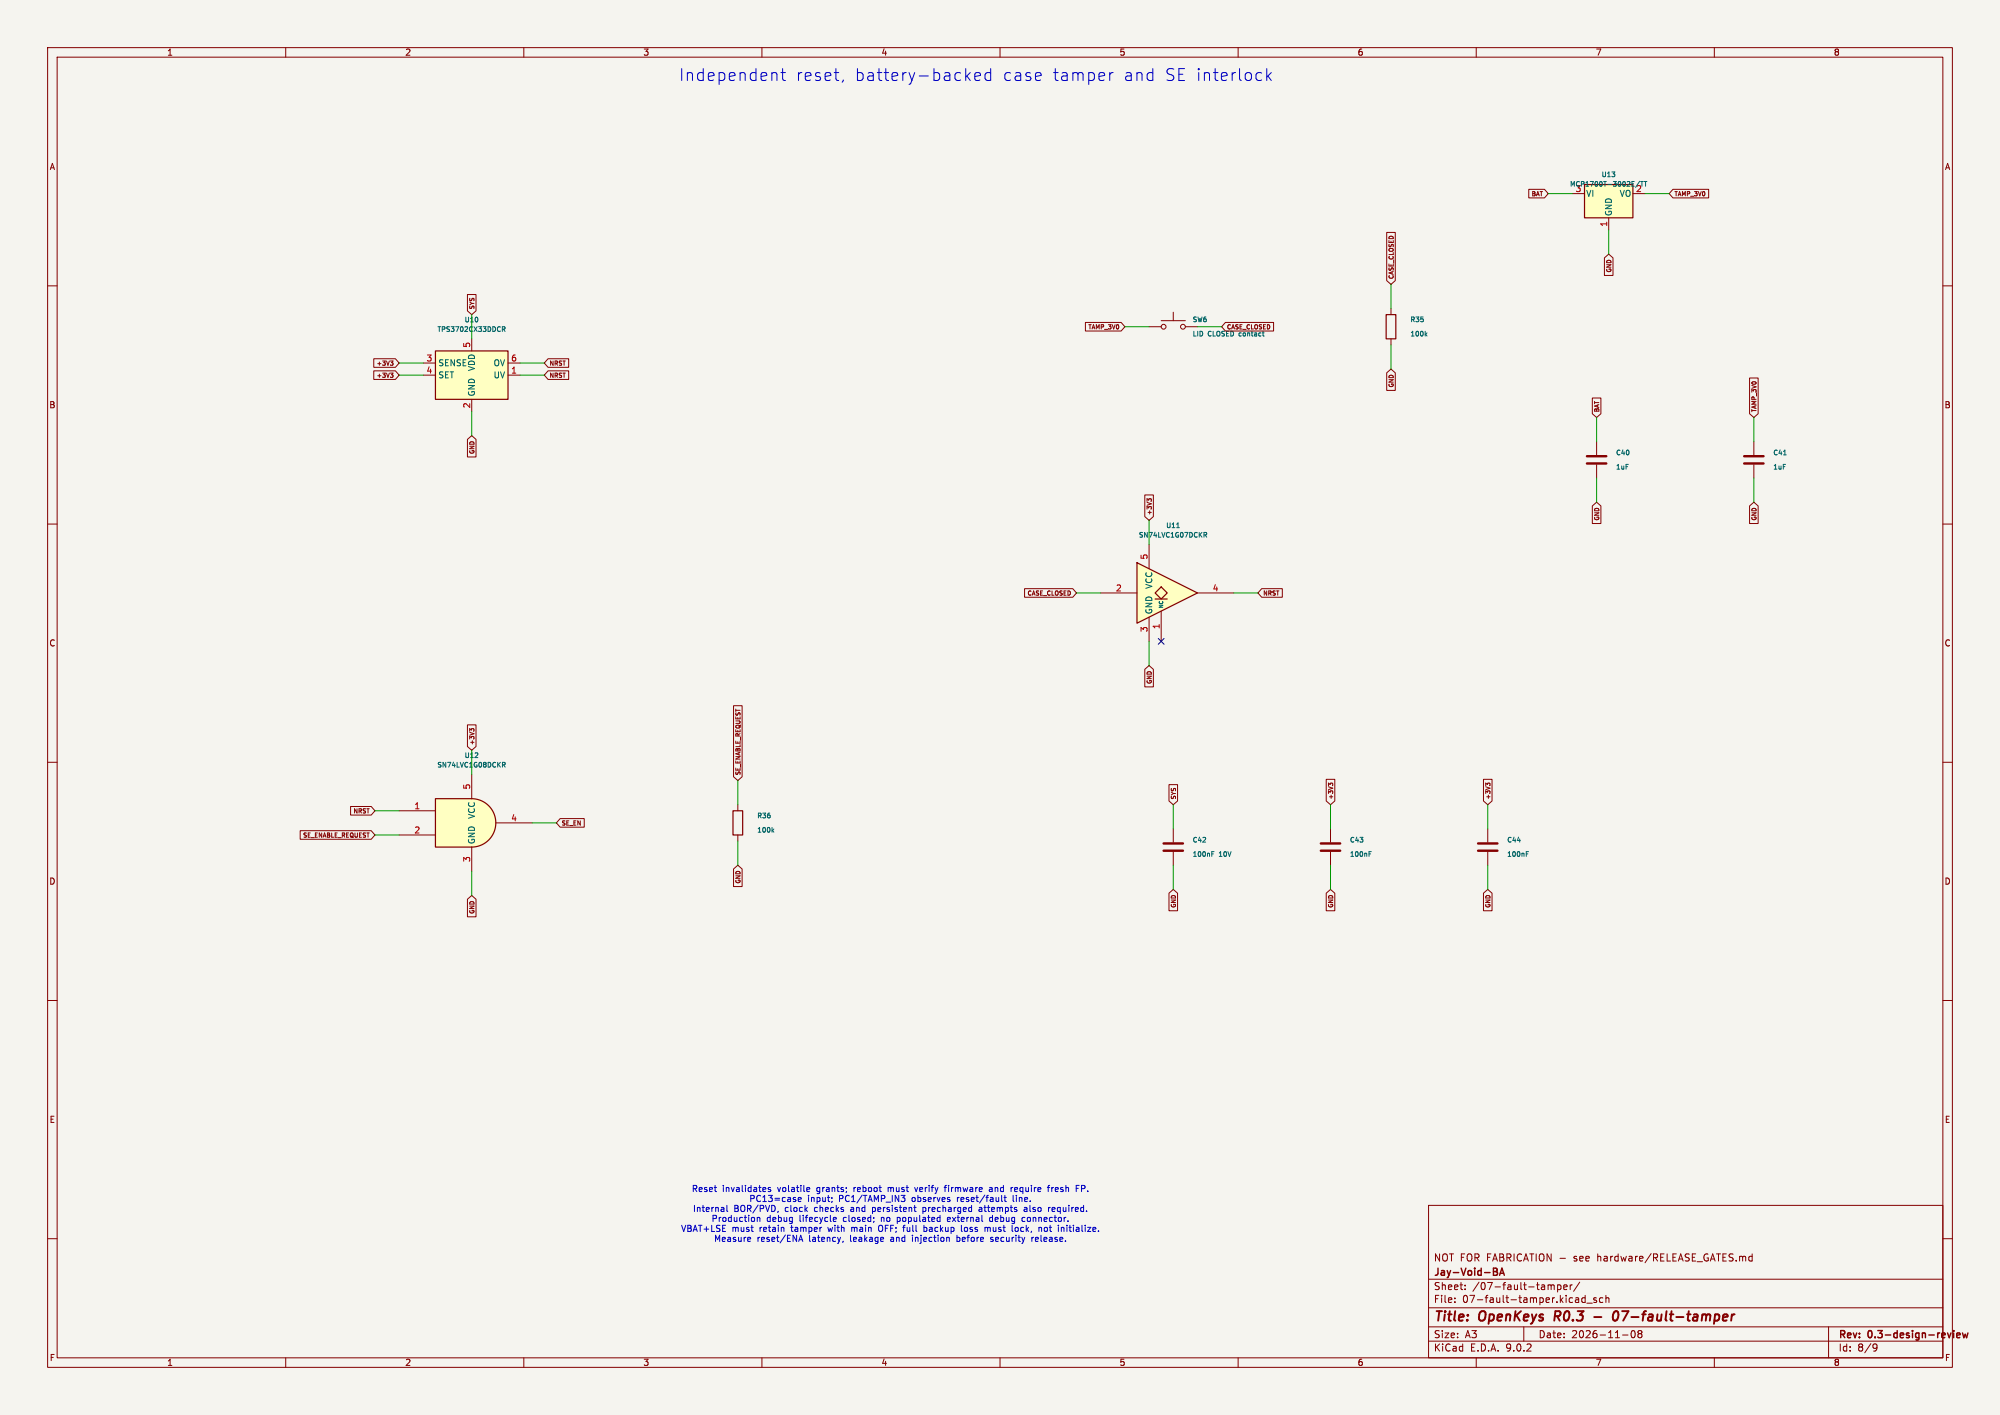
[picture p63: page 8]

Jay-Void-BA
Id: 8/9 Title: OpenKeys R0.3 - 07-fault-tamper File: 07-fault-tamper.kicad_sch Sheet: /07-fault-tamper/

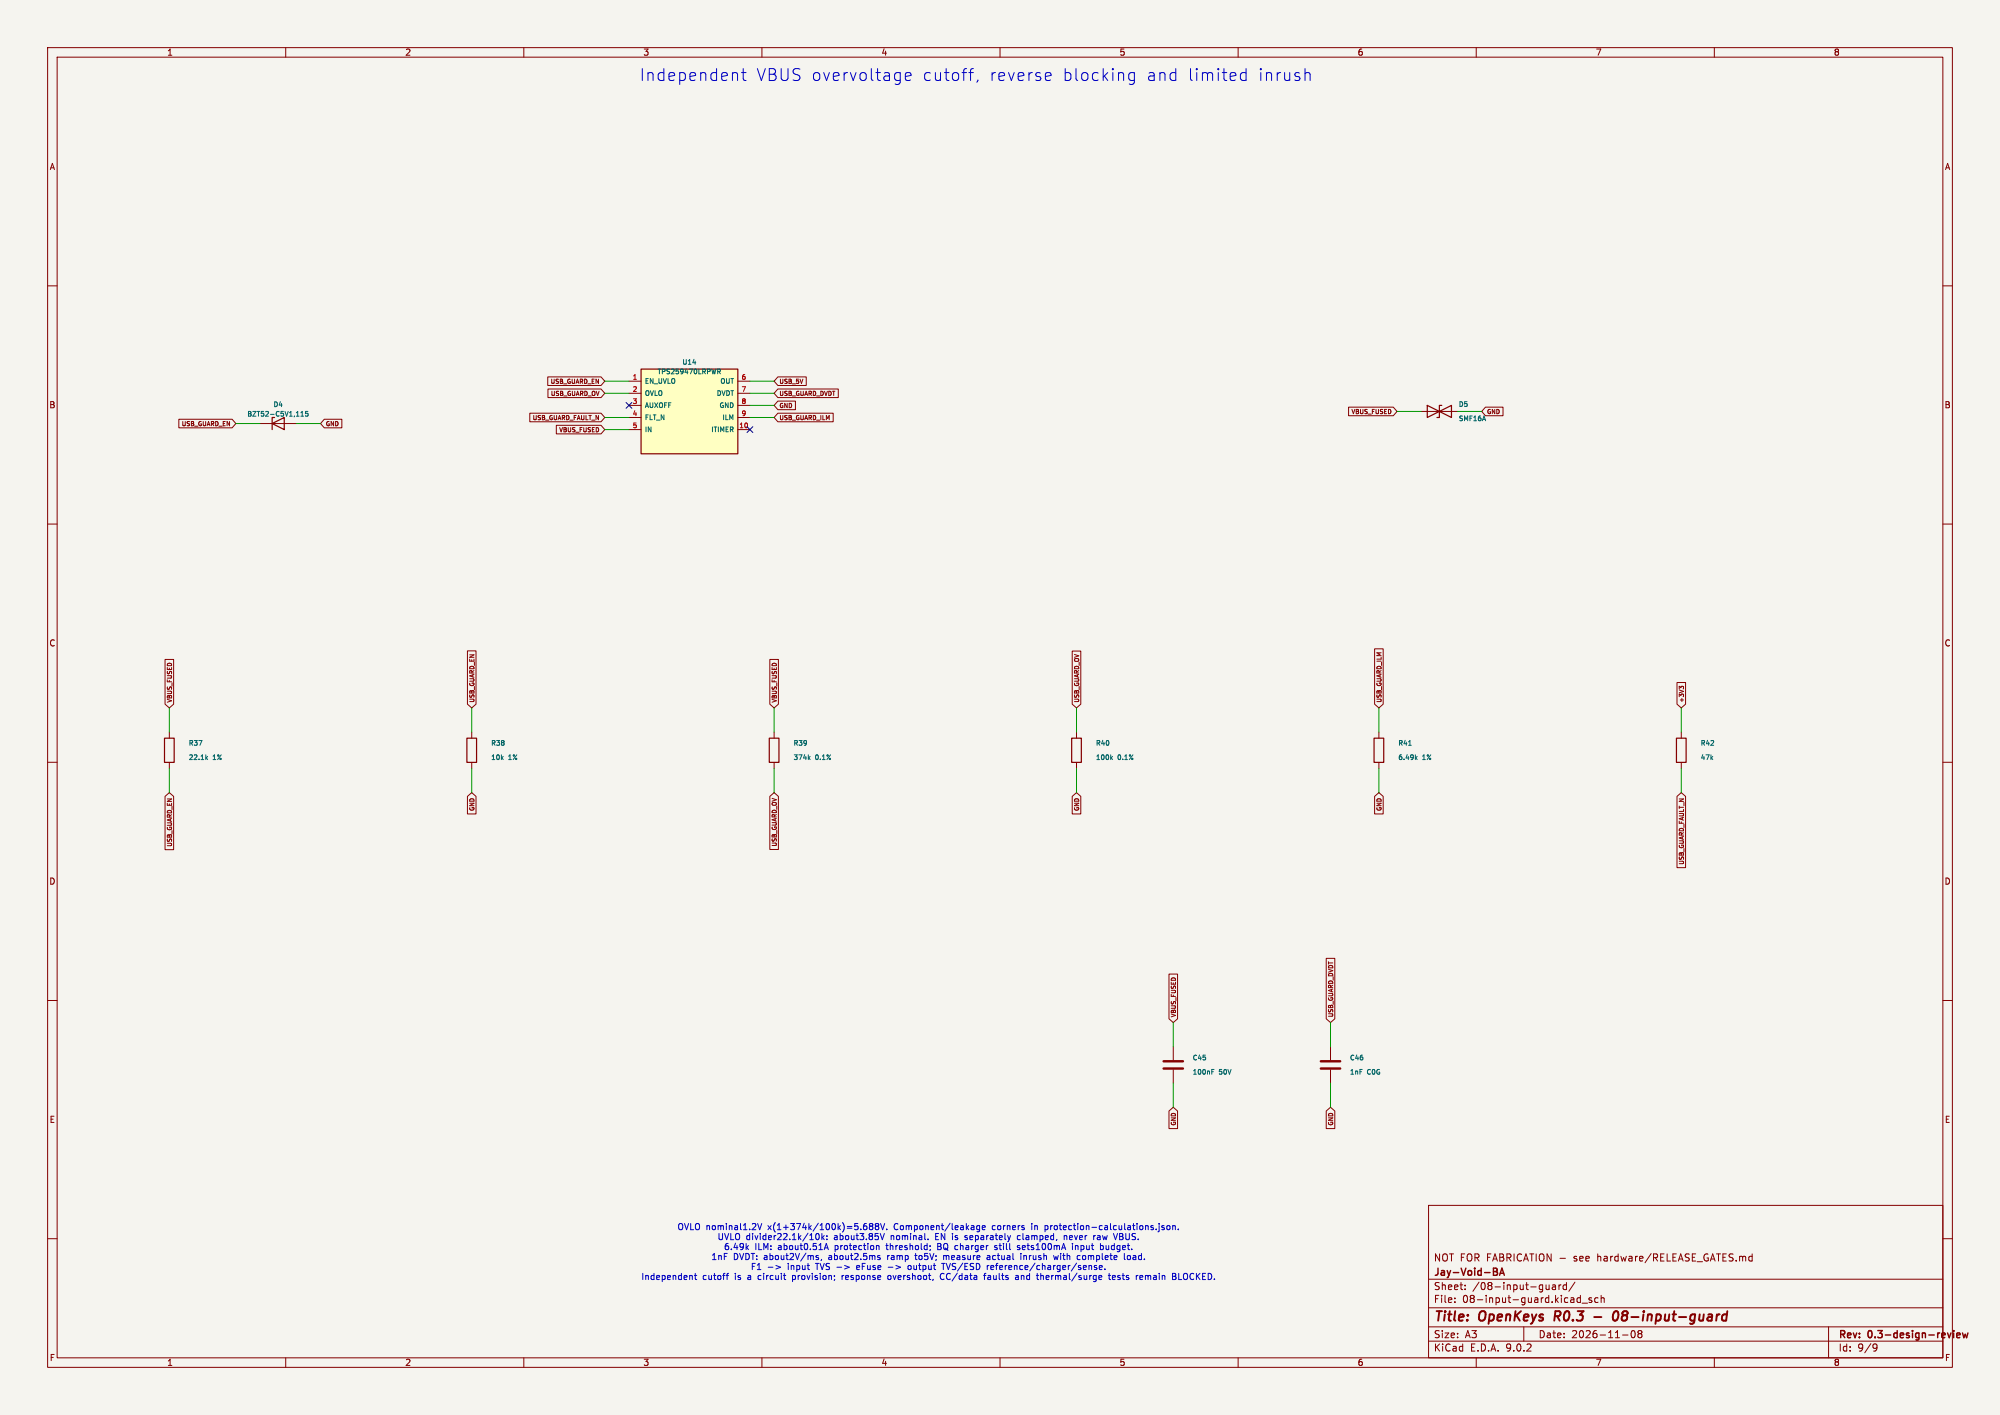
[picture p64: page 9]

Jay-Void-BA
File: 08-input-guard.kicad_sch Sheet: /08-input-guard/
Id: 9/9 Title: OpenKeys R0.3 - 08-input-guard
