Jay-Void-BA/OpenKeys/(list of files, drawings)

Other design files:
hardware/r04/review/OpenKeys-core.dsn
