Jay-Void-BA/OpenKeys/hardware/r05/kicad/OpenKeys.kicad_pcb

## KiCad design hardware/r05/kicad/OpenKeys.kicad_pcb (2026-11-14)

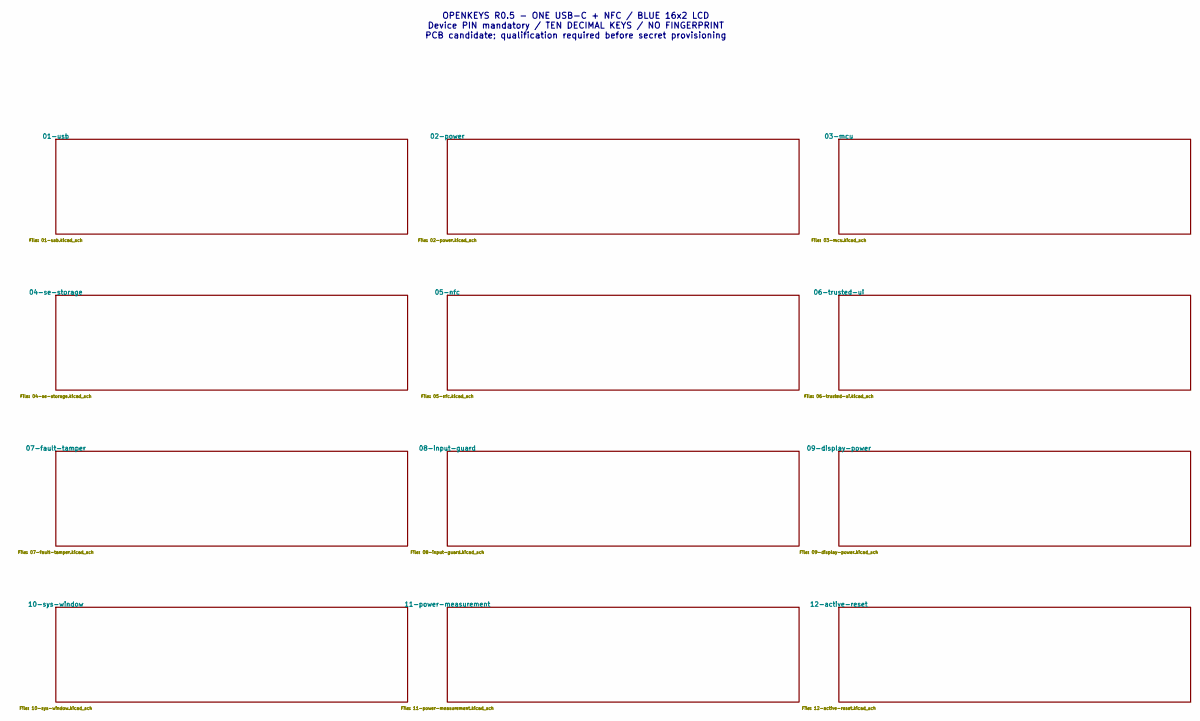
[picture p65: schematic OpenKeys.kicad_sch, OpenKeys R0.5 - Engineering review]

Notes on the sheet:
OPENKEYS R0.5 - ONE USB-C + NFC / BLUE 16x2 LCD Device PIN mandatory / TEN DECIMAL KEYS / NO FINGERPRINT PCB candidate; qualification required before secret provisioning

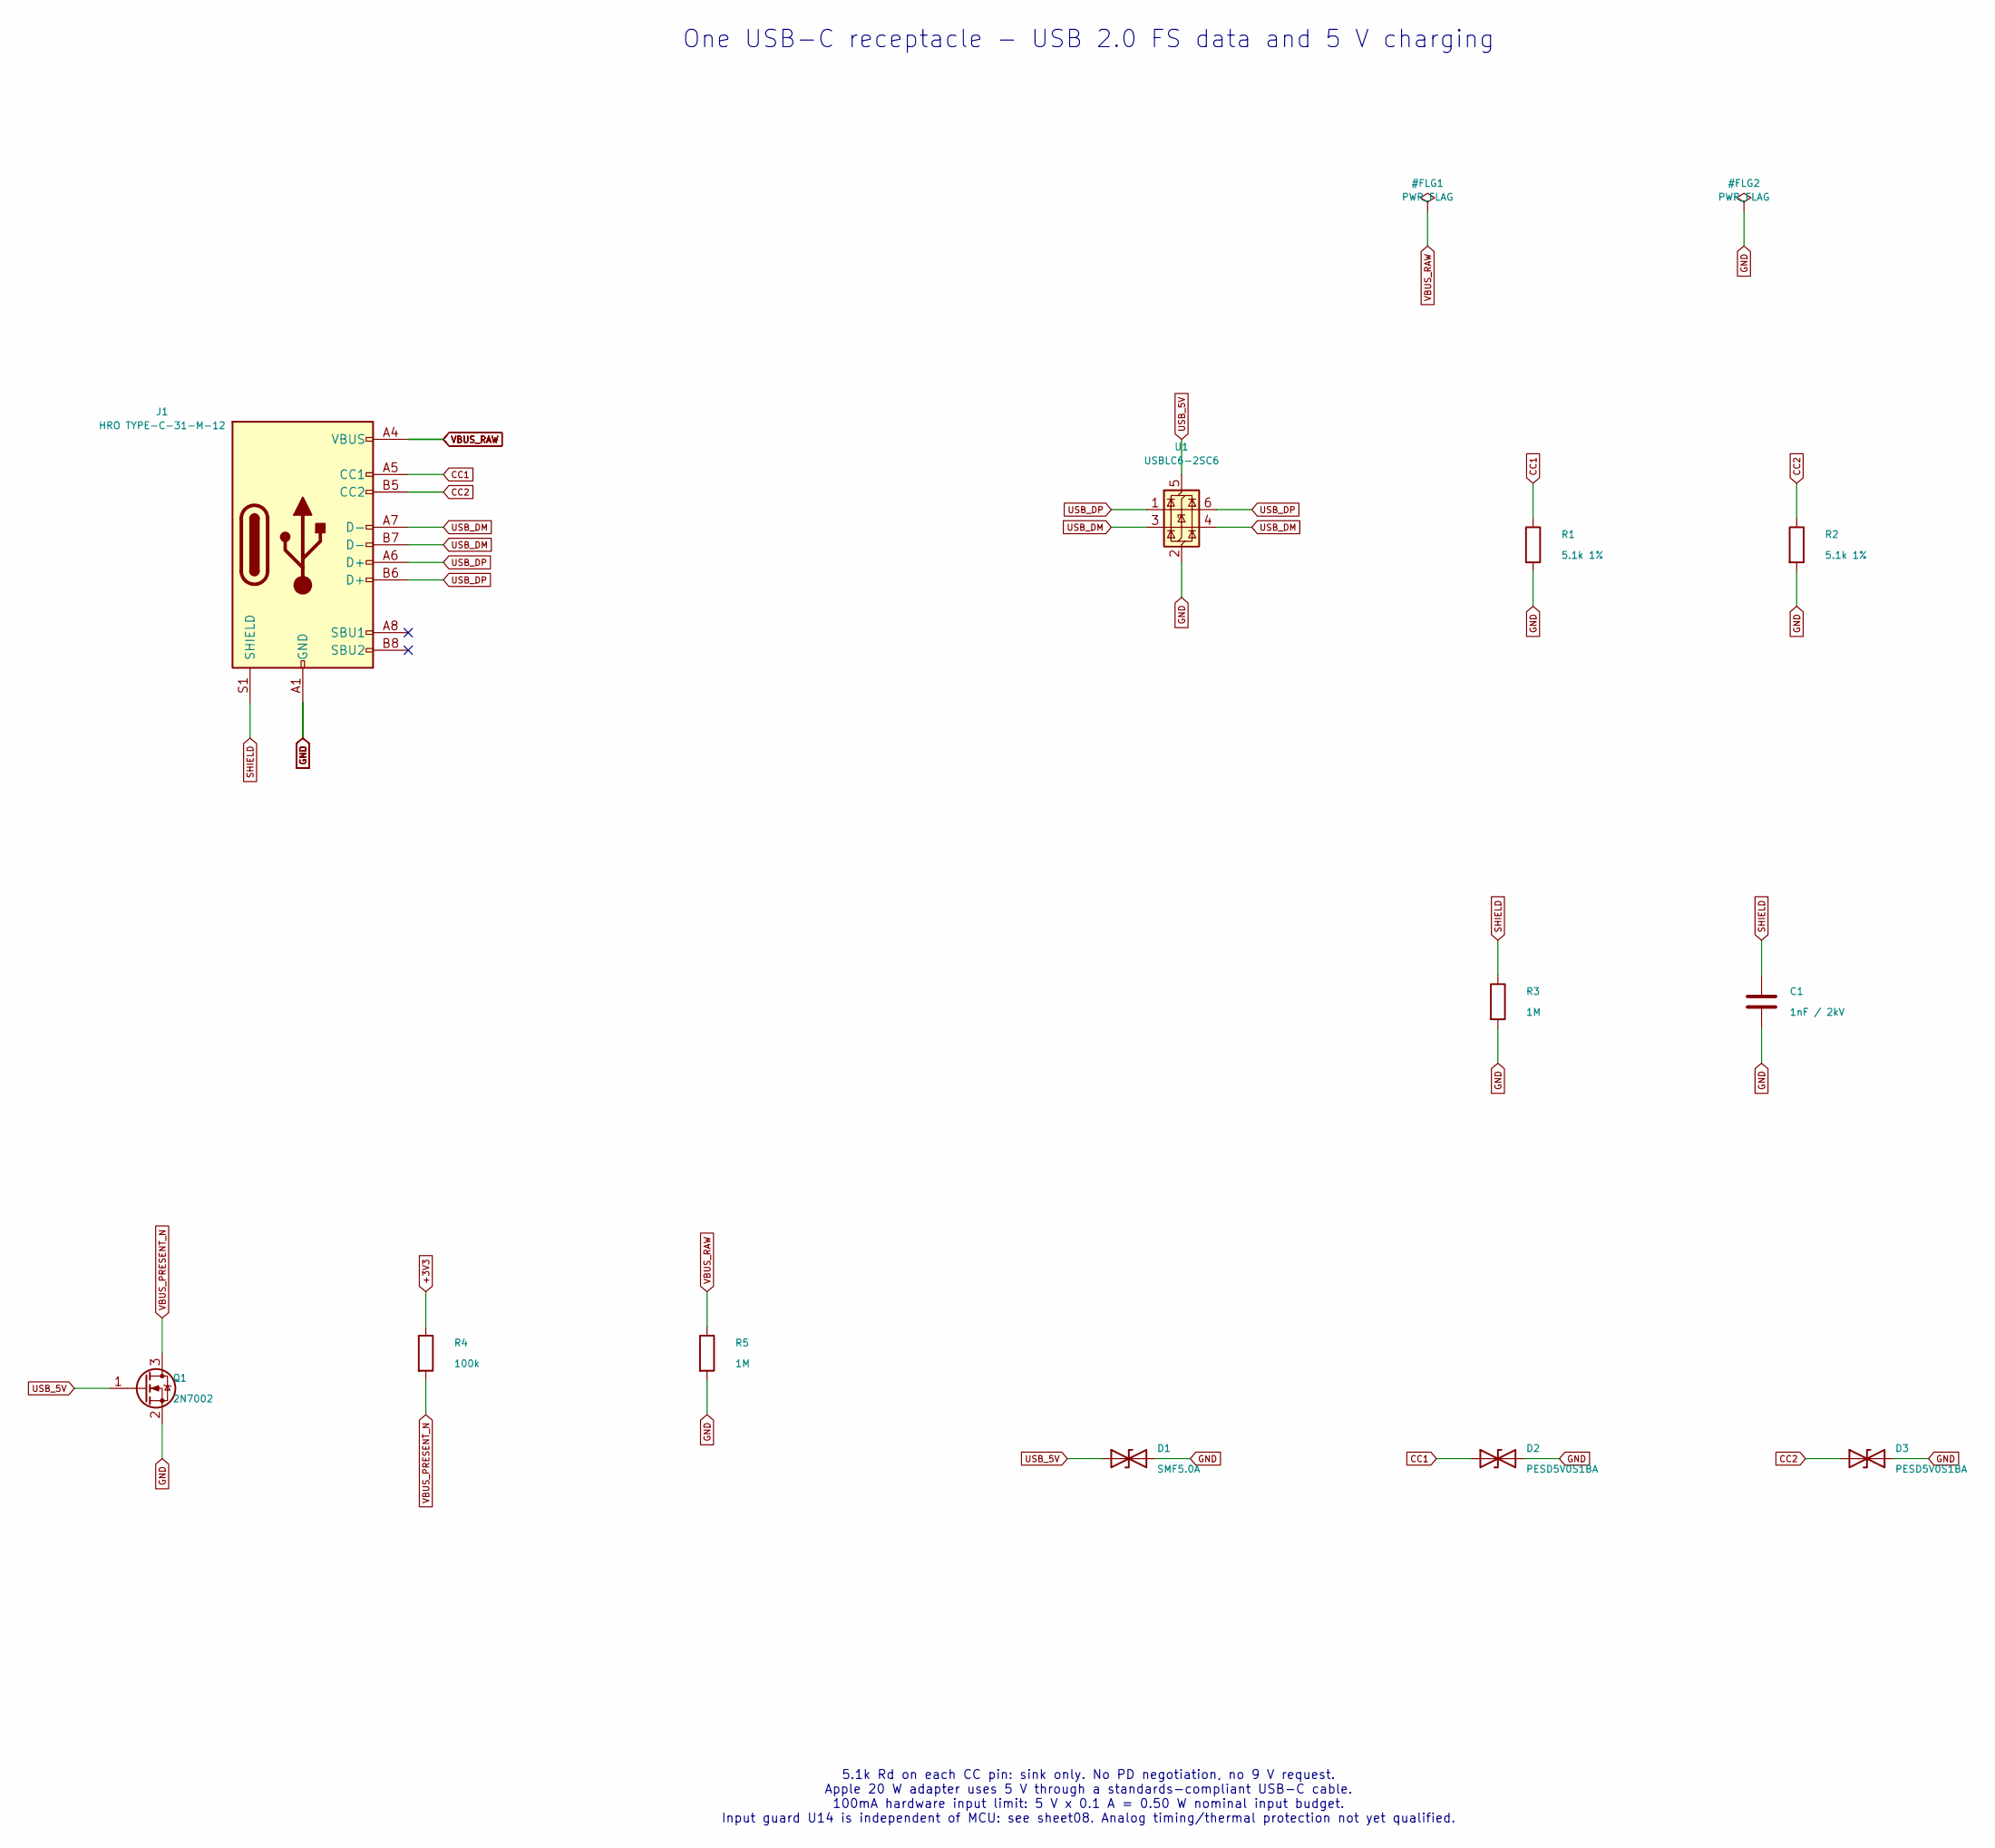
[picture p66: schematic 01-usb.kicad_sch, OpenKeys R0.5 - 01-usb]

Parts:
C1: 1nF / 2kV; C_1206_3216Metric
D1: SMF5.0A; D_SOD-123F
D2, D3: PESD5V0S1BA; D_SOD-323
J1: HRO TYPE-C-31-M-12; USB_C_Receptacle_HRO_TYPE-C-31-M-12
Q1: 2N7002; SOT-23
R1, R2: 5.1k 1%; R_0603_1608Metric
R3, R5: 1M; R_0603_1608Metric
R4: 100k; R_0603_1608Metric
U1: USBLC6-2SC6; SOT-23-6

Connections:
+3V3: R4.1; also elsewhere on the board
CC1: D2.1 (A1), J1.A5 (CC1), R1.1
CC2: D3.1 (A1), J1.B5 (CC2), R2.1
GND: C1.2, D1.2 (A2), D2.2 (A2), D3.2 (A2), J1.A1 (GND), J1.A12 (GND), J1.B1 (GND), J1.B12 (GND), Q1.2 (S), R1.2, R2.2, R3.2, R5.2, U1.2 (GND); also elsewhere on the board
SHIELD: C1.1, J1.S1 (SHIELD), R3.1
USB_5V: D1.1 (A1), Q1.1 (G), U1.5 (VBUS); also elsewhere on the board
USB_DM: J1.A7 (D-), J1.B7 (D-), U1.3 (I/O2), U1.4 (I/O2); also elsewhere on the board
USB_DP: J1.A6 (D+), J1.B6 (D+), U1.1 (I/O1), U1.6 (I/O1); also elsewhere on the board
VBUS_PRESENT_N: Q1.3 (D), R4.2; also elsewhere on the board
VBUS_RAW: J1.A4 (VBUS), J1.A9 (VBUS), J1.B4 (VBUS), J1.B9 (VBUS), R5.1; also elsewhere on the board

Notes on the sheet:
One USB-C receptacle - USB 2.0 FS data and 5 V charging
5.1k Rd on each CC pin: sink only. No PD negotiation, no 9 V request. Apple 20 W adapter uses 5 V through a standards-compliant USB-C cable. 100mA hardware input limit: 5 V x 0.1 A = 0.50 W nominal input budget. Input guard U14 is independent of MCU: see sheet08. Analog timing/thermal protection no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

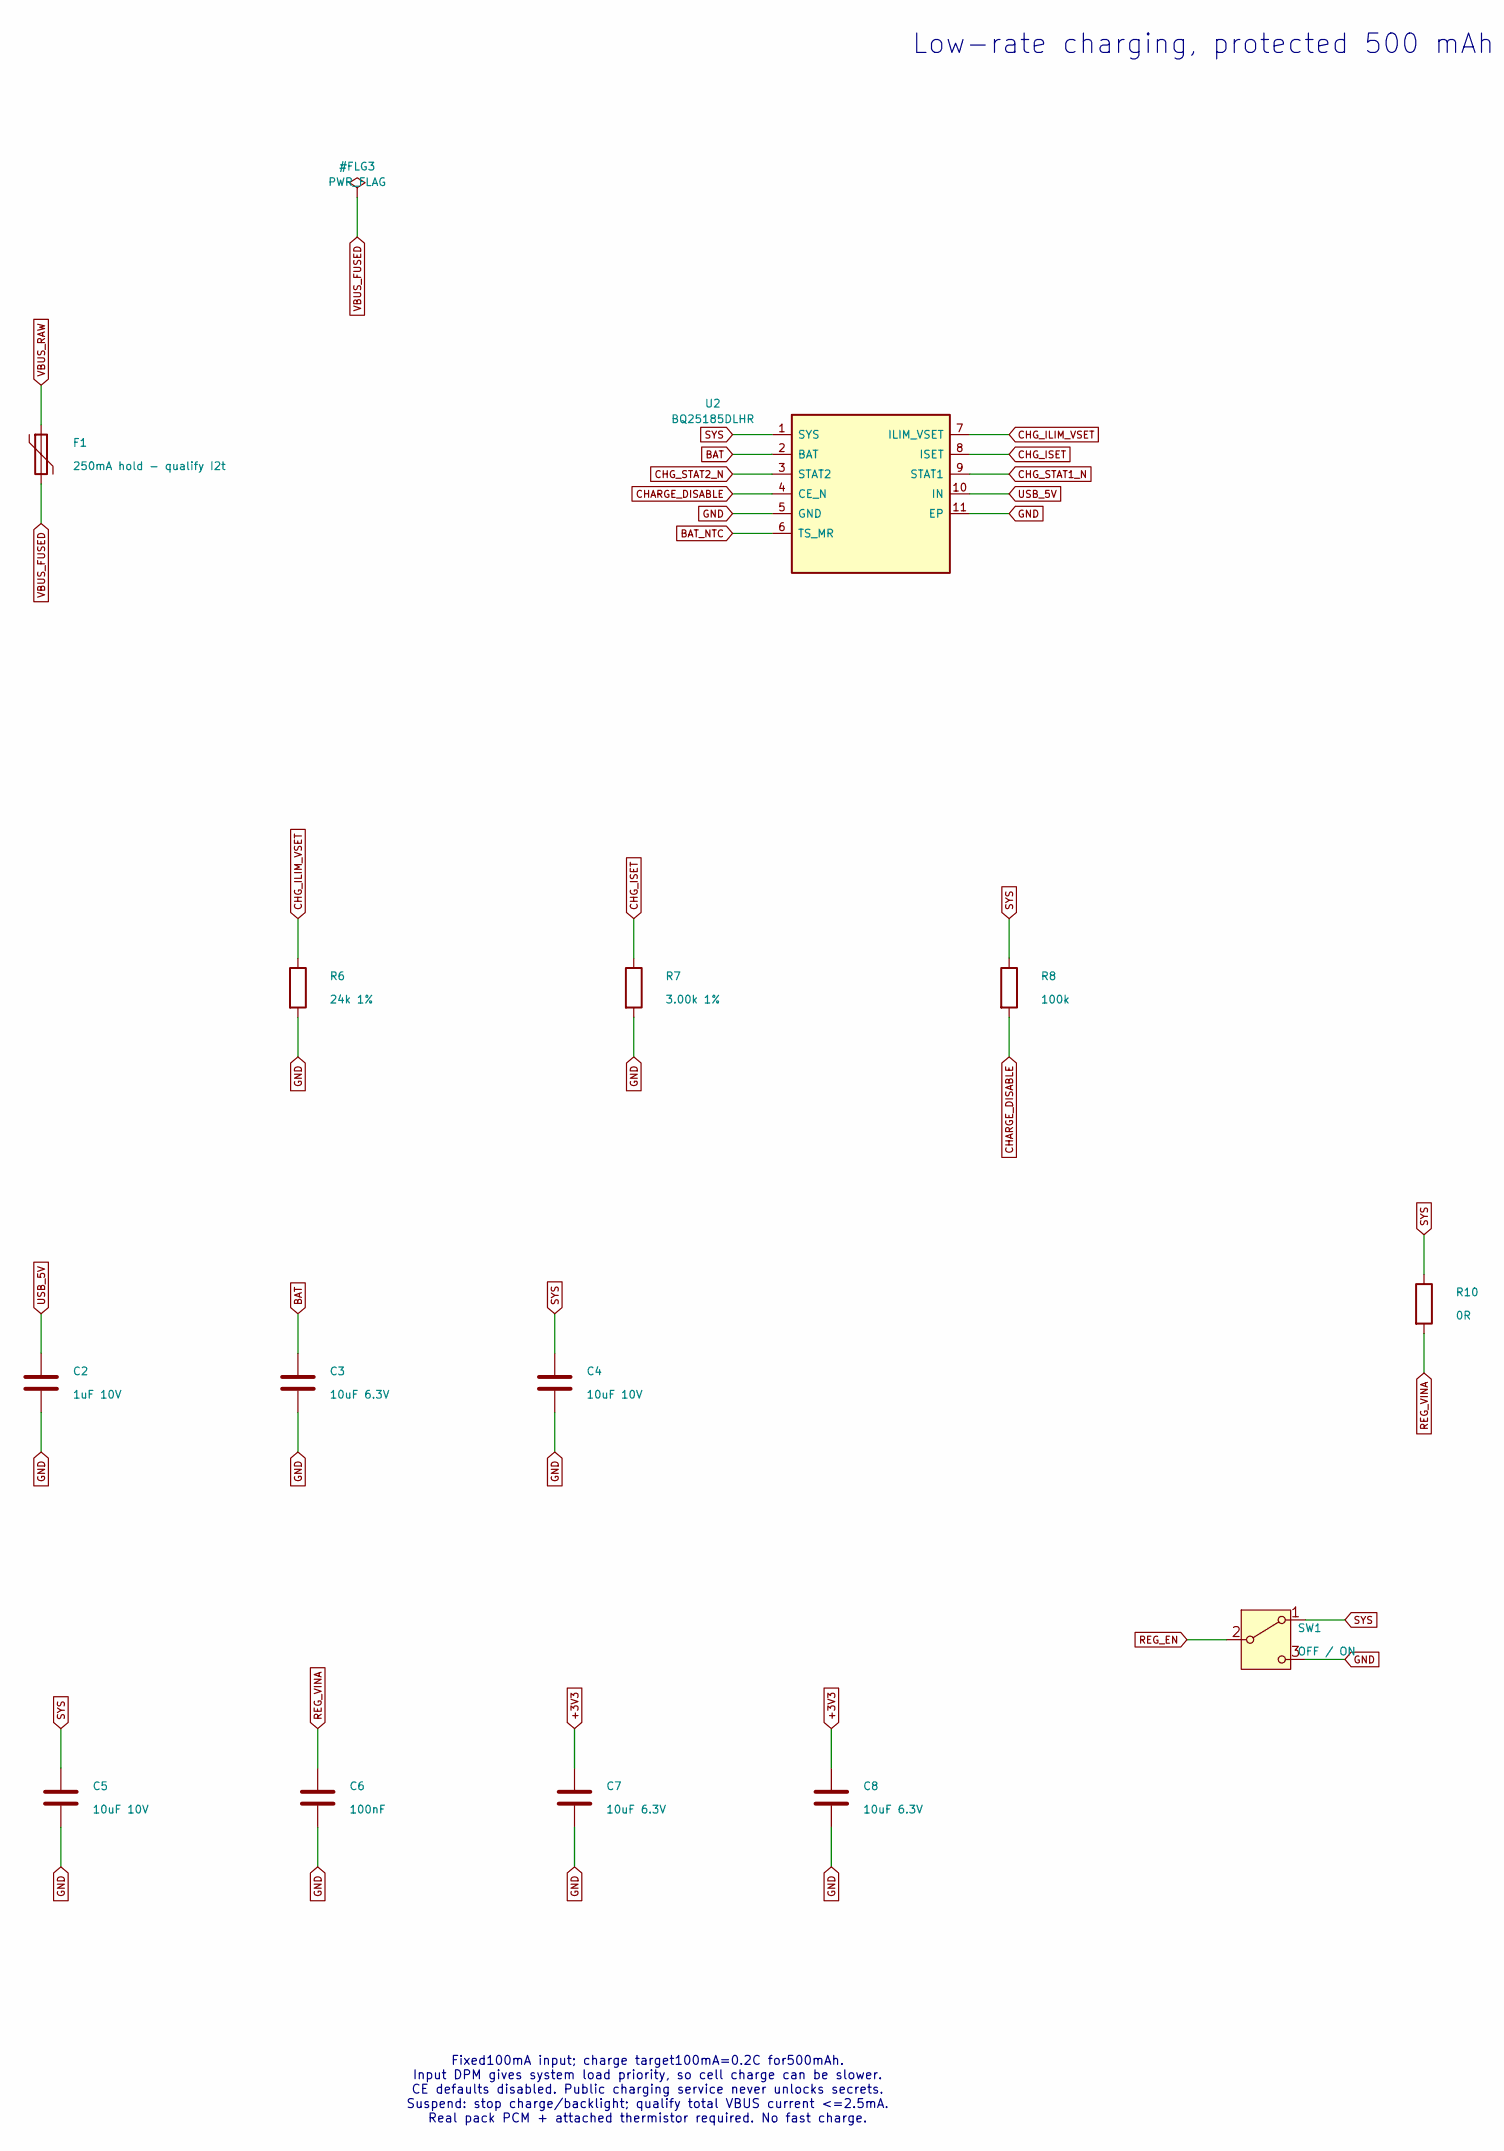
[picture p67: schematic 02-power.kicad_sch, OpenKeys R0.5 - 02-power, part in row 1, column 1]

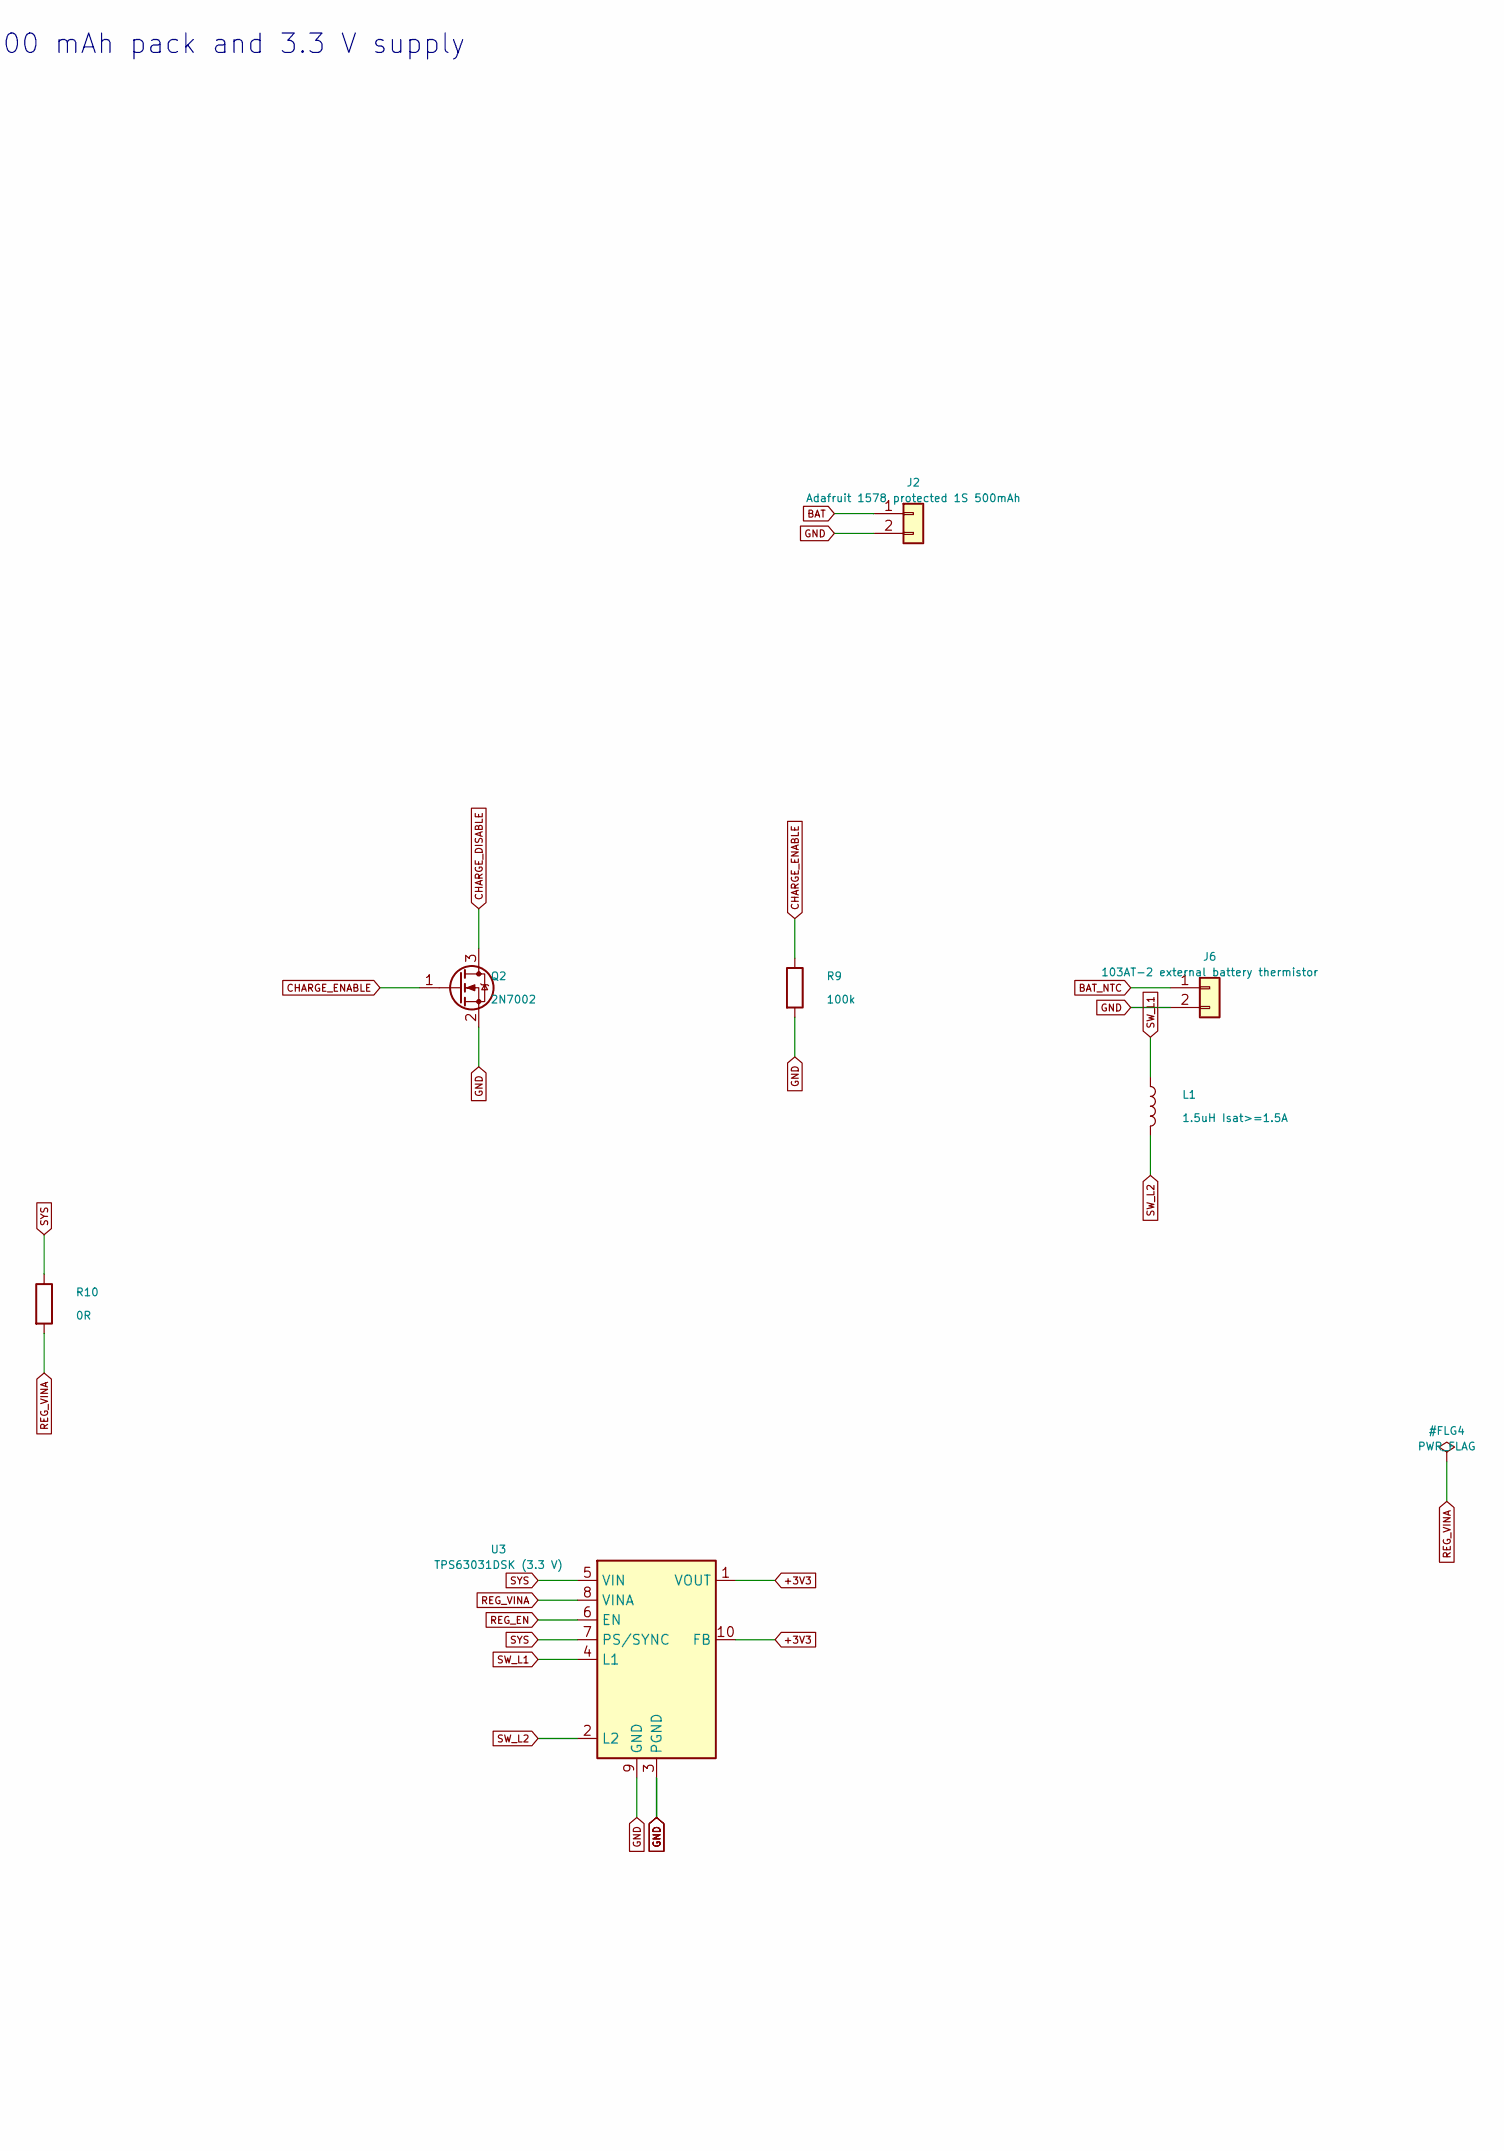
[picture p68: schematic 02-power.kicad_sch, OpenKeys R0.5 - 02-power, part in row 1, column 2]

Parts:
C2: 1uF 10V; C_0805_2012Metric
C3, C7, C8: 10uF 6.3V; C_0805_2012Metric
C4, C5: 10uF 10V; C_0805_2012Metric
C6: 100nF; C_0603_1608Metric
F1: 250mA hold - qualify I2t; Fuse_1206_3216Metric
J2: Adafruit 1578 protected 1S 500mAh; JST_PH_S2B-PH-K_1x02_P2.00mm_Horizontal
J6: 103AT-2 external battery thermistor; JST_SH_SM02B-SRSS-TB_1x02-1MP_P1.00mm_Horizontal
L1: 1.5uH Isat>=1.5A; L_Sunlord_SWPA3015S
Q2: 2N7002; SOT-23
R6: 24k 1%; R_0603_1608Metric
R7: 3.00k 1%; R_0603_1608Metric
R8, R9: 100k; R_0603_1608Metric
R10: 0R; R_0603_1608Metric
SW1: OFF / ON; SW_SPDT_CK_JS102011SAQN
U2: BQ25185DLHR; Texas_DLH0010A_WSON-10-1EP_2.2x2mm_P0.4mm_EP0.9x1.5mm
U3: TPS63031DSK (3.3 V); WSON-10-1EP_2.5x2.5mm_P0.5mm_EP1.2x2mm

Connections:
+3V3: C7.1, C8.1, U3.1 (VOUT), U3.10 (FB); also elsewhere on the board
BAT: C3.1, J2.1, U2.2 (BAT); also elsewhere on the board
BAT_NTC: J6.1, U2.6 (TS_MR)
CHARGE_DISABLE: Q2.3 (D), R8.2, U2.4 (CE_N)
CHARGE_ENABLE: Q2.1 (G), R9.1; also elsewhere on the board
CHG_ILIM_VSET: R6.1, U2.7 (ILIM_VSET)
CHG_ISET: R7.1, U2.8 (ISET)
CHG_STAT1_N: U2.9 (STAT1); also elsewhere on the board
CHG_STAT2_N: U2.3 (STAT2); also elsewhere on the board
GND: C2.2, C3.2, C4.2, C5.2, C6.2, C7.2, C8.2, J2.2, J6.2, Q2.2 (S), R6.2, R7.2, R9.2, SW1.3 (C), U2.5 (GND), U2.11 (EP), U3.3 (PGND), U3.9 (GND), U3.11 (PGND); also elsewhere on the board
REG_EN: SW1.2 (B), U3.6 (EN)
REG_VINA: C6.1, R10.2, U3.8 (VINA)
SW_L1: L1.1, U3.4 (L1)
SW_L2: L1.2, U3.2 (L2)
SYS: C4.1, C5.1, R8.1, R10.1, SW1.1 (A), U2.1 (SYS), U3.5 (VIN), U3.7 (PS/SYNC); also elsewhere on the board
USB_5V: C2.1, U2.10 (IN); also elsewhere on the board
VBUS_FUSED: F1.2; also elsewhere on the board
VBUS_RAW: F1.1; also elsewhere on the board

Notes on the sheet:
Low-rate charging, protected 500 mAh pack and 3.3 V supply
Fixed100mA input; charge target100mA=0.2C for500mAh. Input DPM gives system load priority, so cell charge can be slower. CE defaults disabled. Public charging service never unlocks secrets. Suspend: stop charge/backlight; qualify total VBUS current <=2.5mA. Real pack PCM + attached thermistor requi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

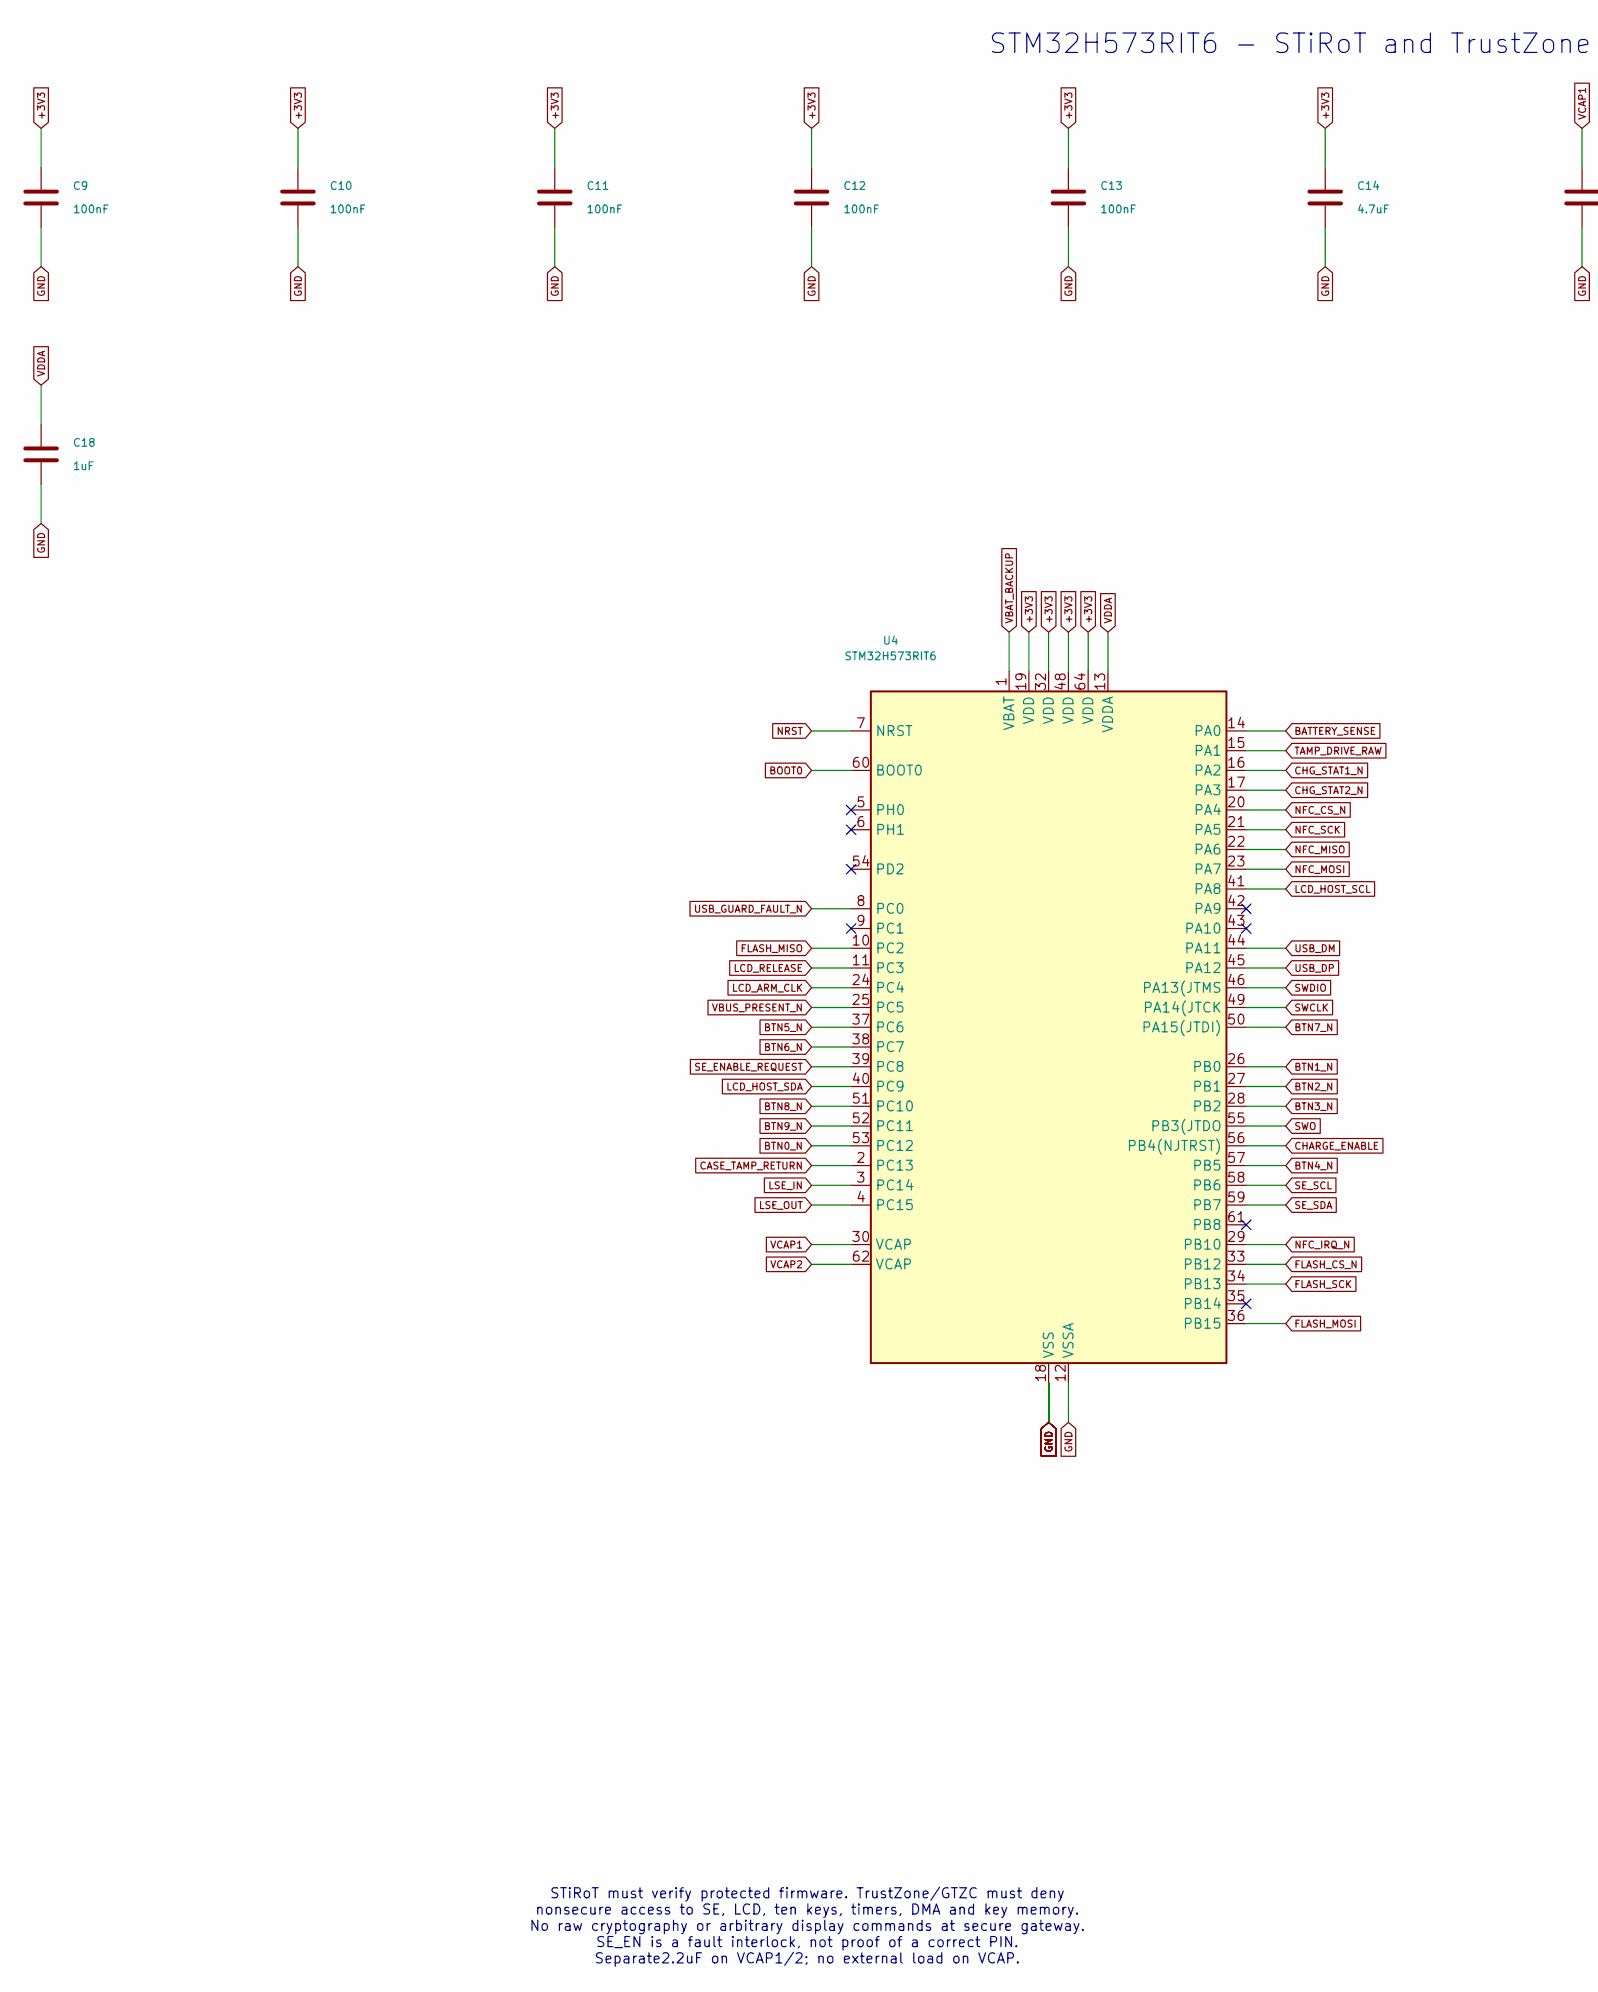
[picture p69: schematic 03-mcu.kicad_sch, OpenKeys R0.5 - 03-mcu, part in row 1, column 1]

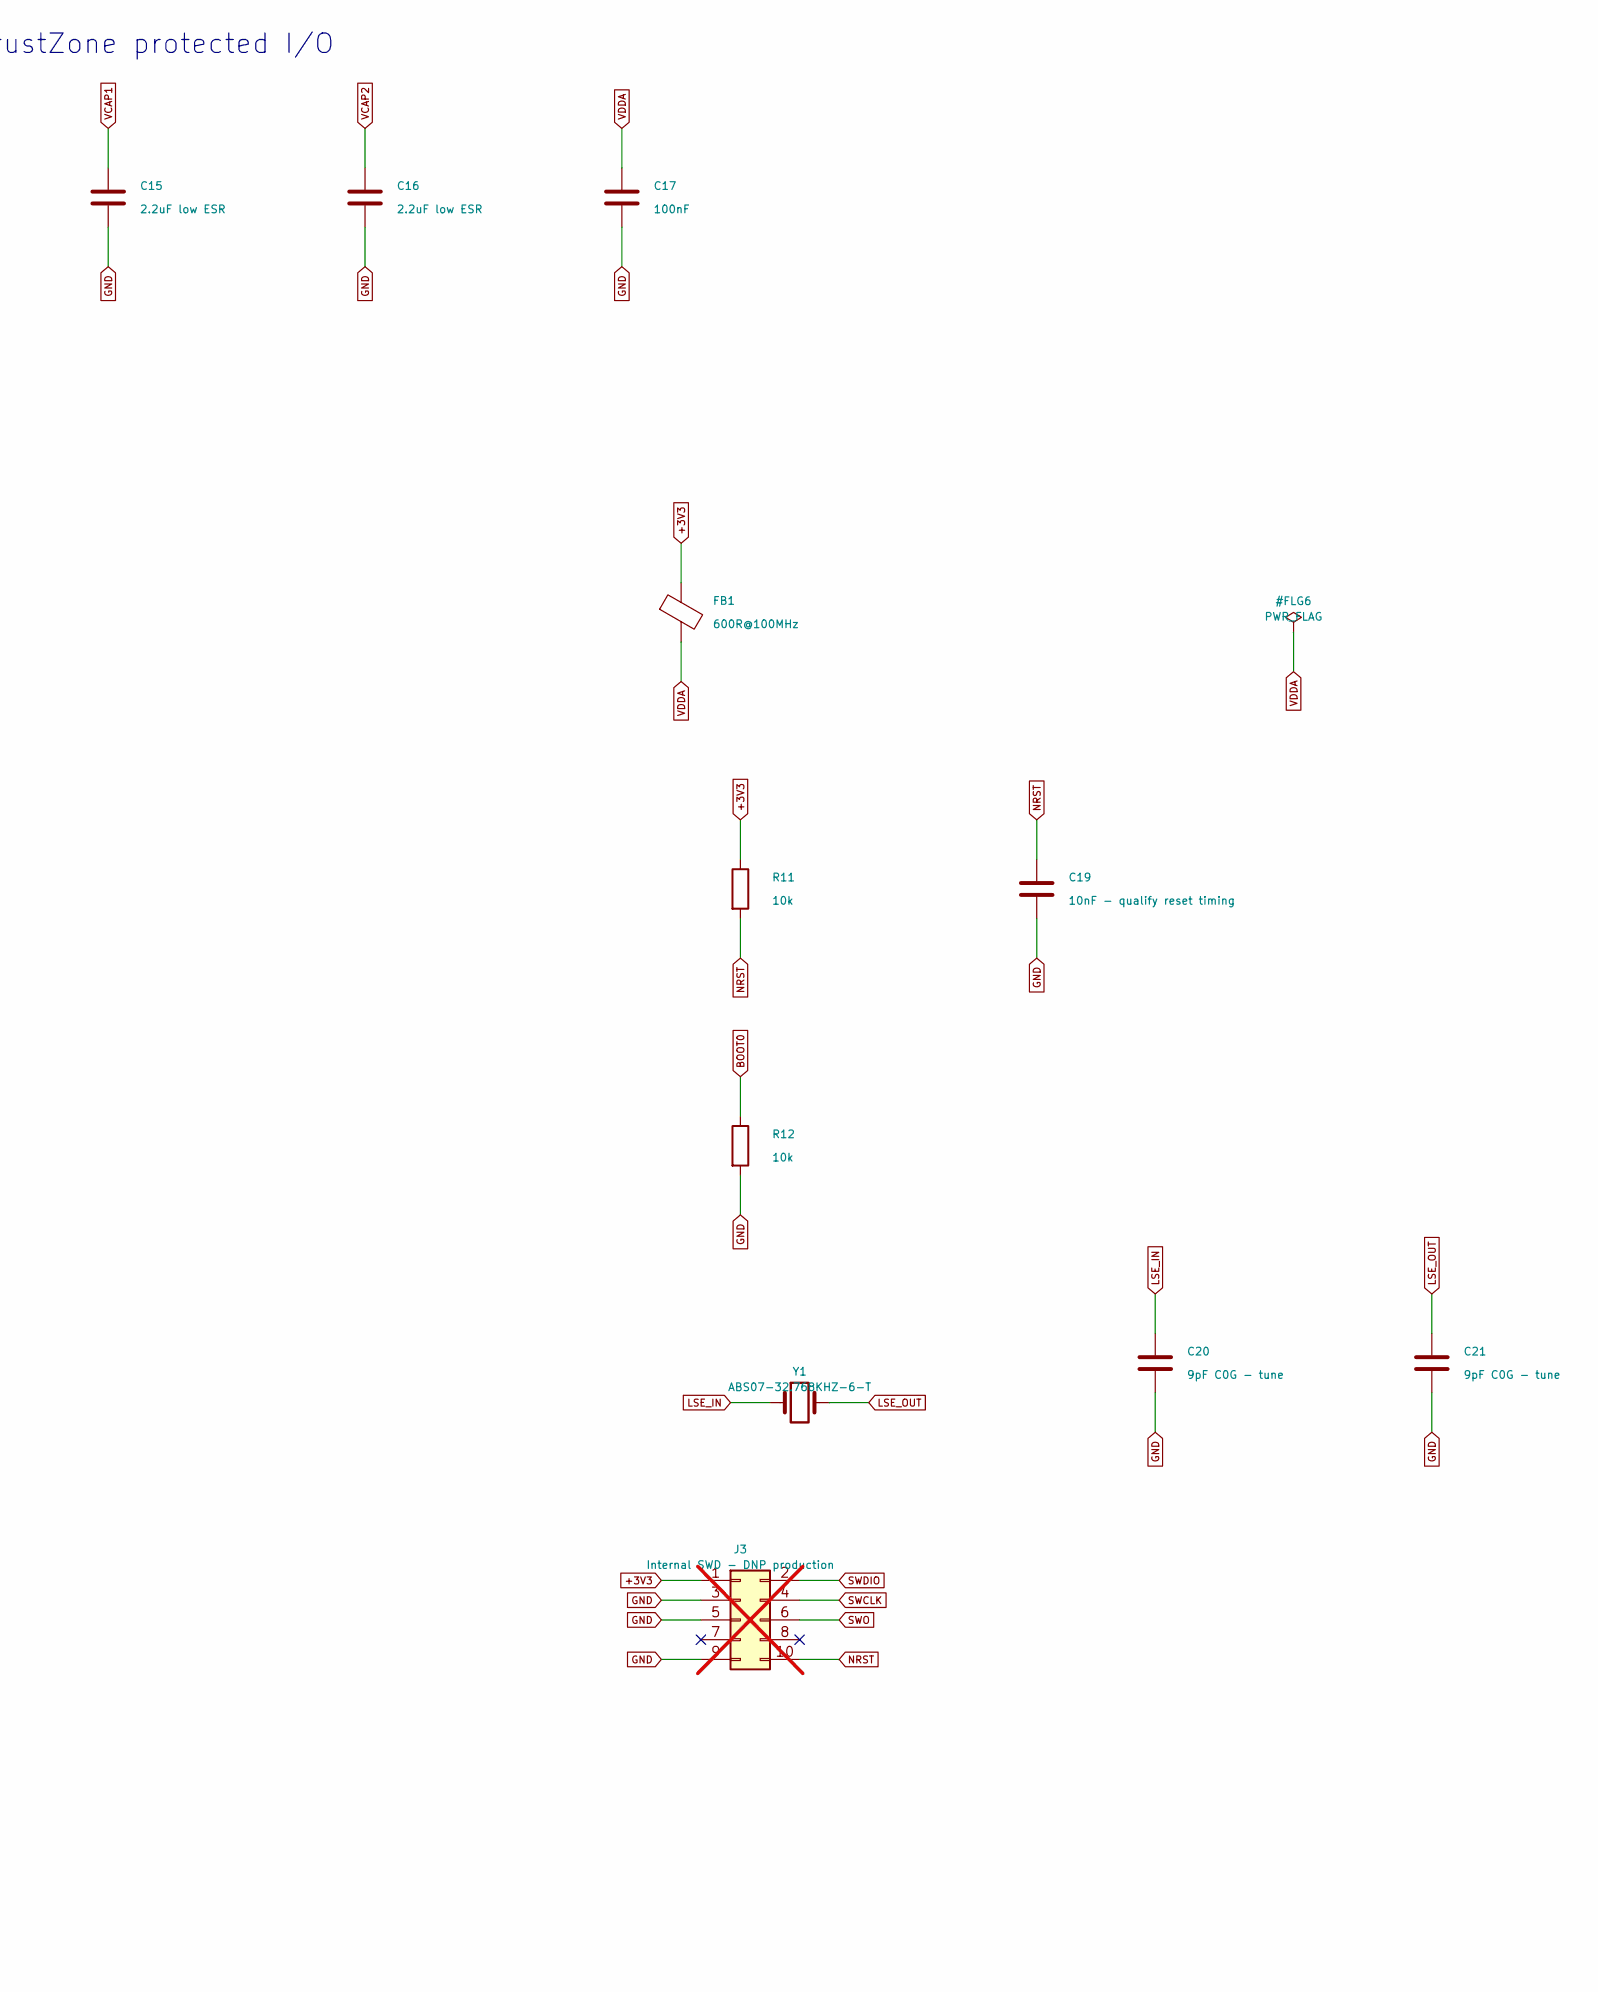
[picture p70: schematic 03-mcu.kicad_sch, OpenKeys R0.5 - 03-mcu, part in row 1, column 2]

Parts:
C9, C10, C11, C12, C13, C17: 100nF; C_0603_1608Metric
C14: 4.7uF; C_0805_2012Metric
C15, C16: 2.2uF low ESR; C_0805_2012Metric
C18: 1uF; C_0805_2012Metric
C19: 10nF - qualify reset timing; C_0603_1608Metric
C20, C21: 9pF C0G - tune; C_0603_1608Metric
FB1: 600R@100MHz; L_0603_1608Metric
J3: Internal SWD - DNP production; PinHeader_2x05_P1.27mm_Vertical; not fitted
R11, R12: 10k; R_0603_1608Metric
U4: STM32H573RIT6; LQFP-64_10x10mm_P0.5mm
Y1: ABS07-32.768KHZ-6-T; Crystal_SMD_3215-2Pin_3.2x1.5mm

Connections:
+3V3: C9.1, C10.1, C11.1, C12.1, C13.1, C14.1, FB1.1, J3.1, R11.1, U4.19 (VDD), U4.32 (VDD), U4.48 (VDD), U4.64 (VDD); also elsewhere on the board
BATTERY_SENSE: U4.14 (PA0); also elsewhere on the board
BOOT0: R12.1, U4.60 (BOOT0)
BTN0_N: U4.53 (PC12); also elsewhere on the board
BTN1_N: U4.26 (PB0); also elsewhere on the board
BTN2_N: U4.27 (PB1); also elsewhere on the board
BTN3_N: U4.28 (PB2); also elsewhere on the board
BTN4_N: U4.57 (PB5); also elsewhere on the board
BTN5_N: U4.37 (PC6); also elsewhere on the board
BTN6_N: U4.38 (PC7); also elsewhere on the board
BTN7_N: U4.50 (PA15(JTDI)); also elsewhere on the board
BTN8_N: U4.51 (PC10); also elsewhere on the board
BTN9_N: U4.52 (PC11); also elsewhere on the board
CASE_TAMP_RETURN: U4.2 (PC13); also elsewhere on the board
CHARGE_ENABLE: U4.56 (PB4(NJTRST)); also elsewhere on the board
CHG_STAT1_N: U4.16 (PA2); also elsewhere on the board
CHG_STAT2_N: U4.17 (PA3); also elsewhere on the board
FLASH_CS_N: U4.33 (PB12); also elsewhere on the board
FLASH_MISO: U4.10 (PC2); also elsewhere on the board
FLASH_MOSI: U4.36 (PB15); also elsewhere on the board
FLASH_SCK: U4.34 (PB13); also elsewhere on the board
GND: C9.2, C10.2, C11.2, C12.2, C13.2, C14.2, C15.2, C16.2, C17.2, C18.2, C19.2, C20.2, C21.2, J3.3, J3.5, J3.9, R12.2, U4.12 (VSSA), U4.18 (VSS), U4.31 (VSS), U4.47 (VSS), U4.63 (VSS); also elsewhere on the board
LCD_ARM_CLK: U4.24 (PC4); also elsewhere on the board
LCD_HOST_SCL: U4.41 (PA8); also elsewhere on the board
LCD_HOST_SDA: U4.40 (PC9); also elsewhere on the board
LCD_RELEASE: U4.11 (PC3); also elsewhere on the board
LSE_IN: C20.1, U4.3 (PC14), Y1.1
LSE_OUT: C21.1, U4.4 (PC15), Y1.2
NFC_CS_N: U4.20 (PA4); also elsewhere on the board
NFC_IRQ_N: U4.29 (PB10); also elsewhere on the board
NFC_MISO: U4.22 (PA6); also elsewhere on the board
NFC_MOSI: U4.23 (PA7); also elsewhere on the board
NFC_SCK: U4.21 (PA5); also elsewhere on the board
NRST: C19.1, J3.10, R11.2, U4.7 (NRST); also elsewhere on the board
SE_ENABLE_REQUEST: U4.39 (PC8); also elsewhere on the board
SE_SCL: U4.58 (PB6); also elsewhere on the board
SE_SDA: U4.59 (PB7); also elsewhere on the board
SWCLK: J3.4, U4.49 (PA14(JTCK)
SWDIO: J3.2, U4.46 (PA13(JTMS)
SWO: J3.6, U4.55 (PB3(JTDO)
TAMP_DRIVE_RAW: U4.15 (PA1); also elsewhere on the board
USB_DM: U4.44 (PA11); also elsewhere on the board
USB_DP: U4.45 (PA12); also elsewhere on the board
USB_GUARD_FAULT_N: U4.8 (PC0); also elsewhere on the board
VBAT_BACKUP: U4.1 (VBAT); also elsewhere on the board
VBUS_PRESENT_N: U4.25 (PC5); also elsewhere on the board
VCAP1: C15.1, U4.30 (VCAP)
VCAP2: C16.1, U4.62 (VCAP)
VDDA: C17.1, C18.1, FB1.2, U4.13 (VDDA)

Notes on the sheet:
STM32H573RIT6 - STiRoT and TrustZone protected I/O
STiRoT must verify protected firmware. TrustZone/GTZC must deny nonsecure access to SE, LCD, ten keys, timers, DMA and key memory. No raw cryptography or arbitrary display commands at secure gateway. SE_EN is a fault interlock, not proof of a correct PIN. Separate2.2uF on VCAP1/2; no external load 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
