Jay-Void-BA/OpenKeys/hardware/r05/kicad/OpenKeys.kicad_pcb

## KiCad design hardware/r05/kicad/OpenKeys.kicad_pcb (continued)

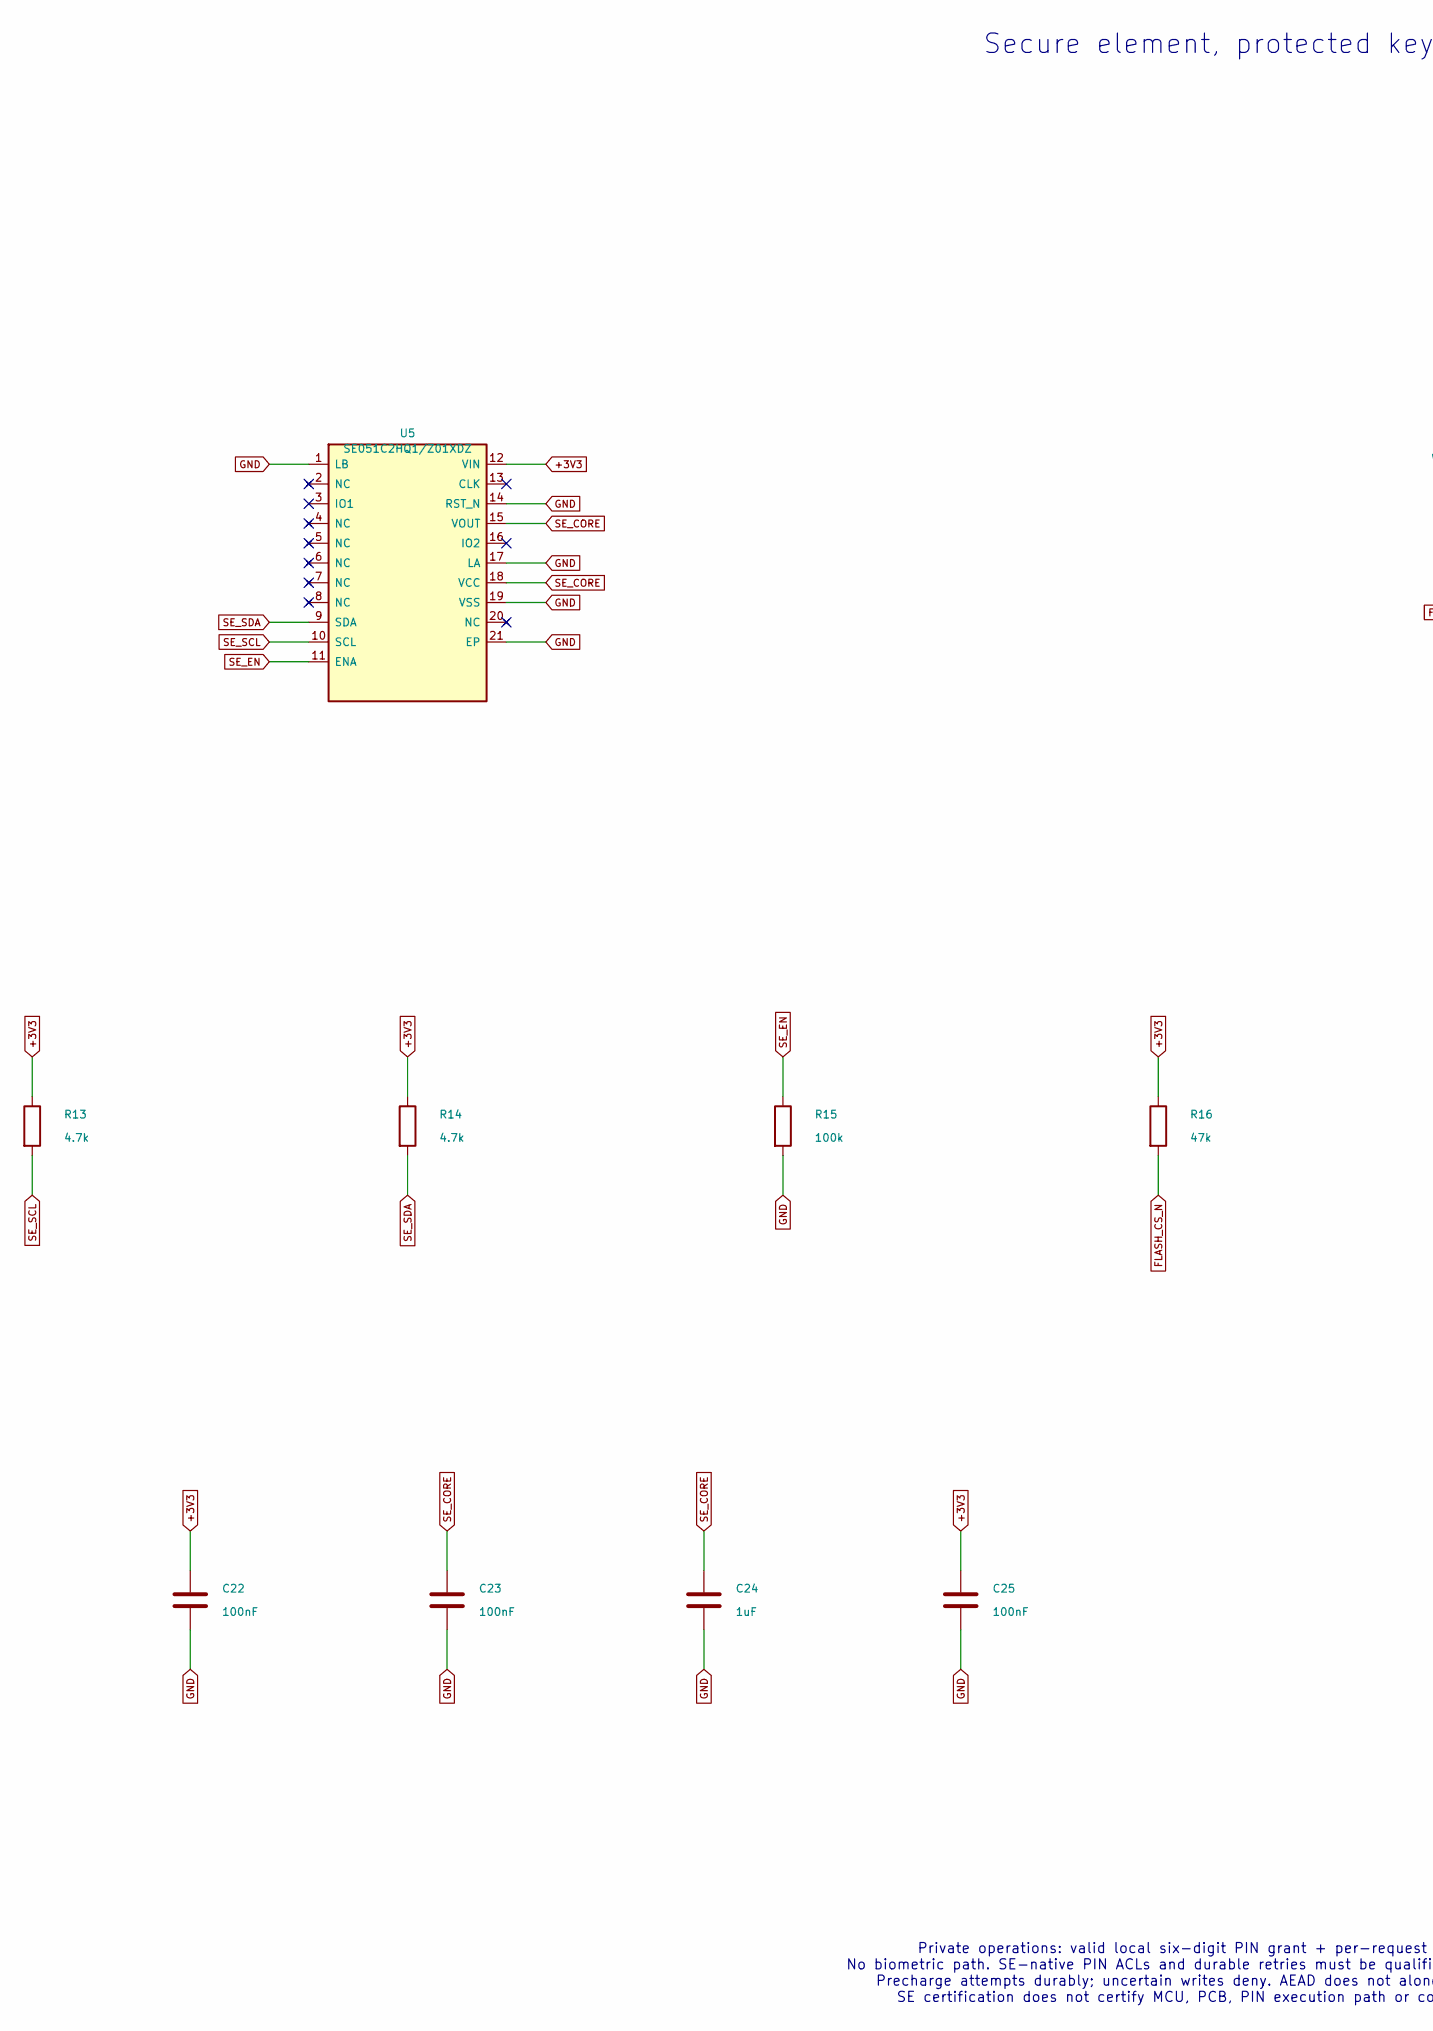
[picture p71: schematic 04-se-storage.kicad_sch, OpenKeys R0.5 - 04-se-storage, part in row 1, column 1]

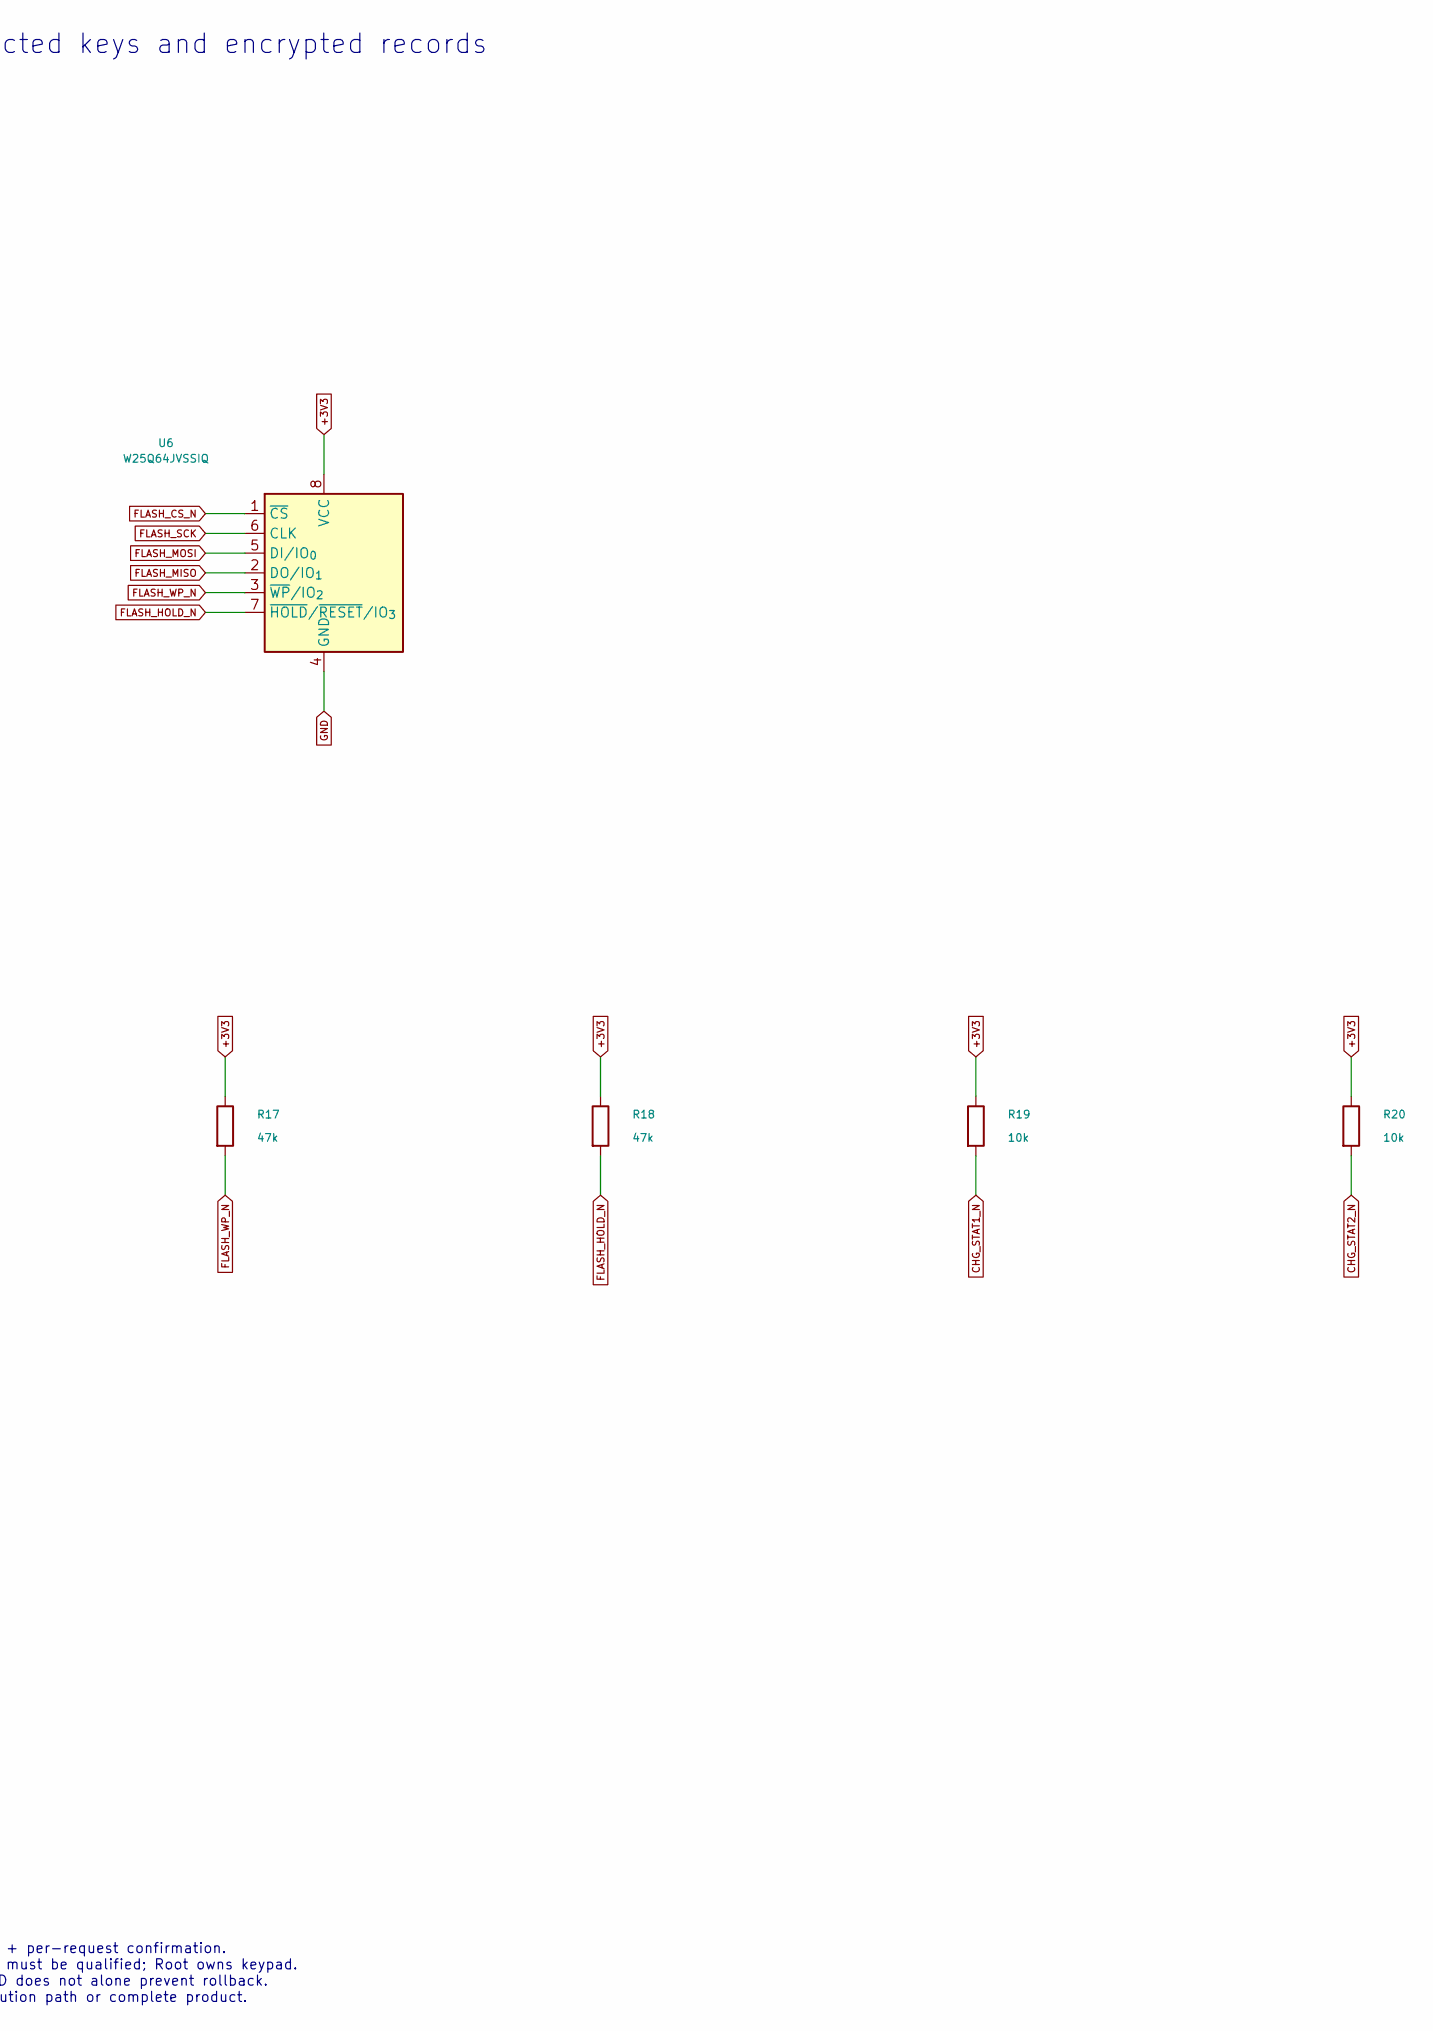
[picture p72: schematic 04-se-storage.kicad_sch, OpenKeys R0.5 - 04-se-storage, part in row 1, column 2]

Parts:
C22, C23, C25: 100nF; C_0603_1608Metric
C24: 1uF; C_0805_2012Metric
R13, R14: 4.7k; R_0603_1608Metric
R15: 100k; R_0603_1608Metric
R16, R17, R18: 47k; R_0603_1608Metric
R19, R20: 10k; R_0603_1608Metric
U5: SE051C2HQ1/Z01XDZ; SE050_SOT1969-1_HX2QFN20
U6: W25Q64JVSSIQ; SOIC-8_5.3x5.3mm_P1.27mm

Connections:
+3V3: C22.1, C25.1, R13.1, R14.1, R16.1, R17.1, R18.1, R19.1, R20.1, U5.12 (VIN), U6.8 (VCC); also elsewhere on the board
CHG_STAT1_N: R19.2; also elsewhere on the board
CHG_STAT2_N: R20.2; also elsewhere on the board
FLASH_CS_N: R16.2, U6.1 (~CS); also elsewhere on the board
FLASH_HOLD_N: R18.2, U6.7 (~HOLD/~RESET/IO_{3})
FLASH_MISO: U6.2 (DO/IO_{1}); also elsewhere on the board
FLASH_MOSI: U6.5 (DI/IO_{0}); also elsewhere on the board
FLASH_SCK: U6.6 (CLK); also elsewhere on the board
FLASH_WP_N: R17.2, U6.3 (~WP/IO_{2})
GND: C22.2, C23.2, C24.2, C25.2, R15.2, U5.1 (LB), U5.14 (RST_N), U5.17 (LA), U5.19 (VSS), U5.21 (EP), U6.4 (GND); also elsewhere on the board
SE_CORE: C23.1, C24.1, U5.15 (VOUT), U5.18 (VCC)
SE_EN: R15.1, U5.11 (ENA); also elsewhere on the board
SE_SCL: R13.2, U5.10 (SCL); also elsewhere on the board
SE_SDA: R14.2, U5.9 (SDA); also elsewhere on the board

Notes on the sheet:
Secure element, protected keys and encrypted records
Private operations: valid local six-digit PIN grant + per-request confirmation. No biometric path. SE-native PIN ACLs and durable retries must be qualified; Root owns keypad. Precharge attempts durably; uncertain writes deny. AEAD does not alone prevent rollback. SE certification does not certify M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

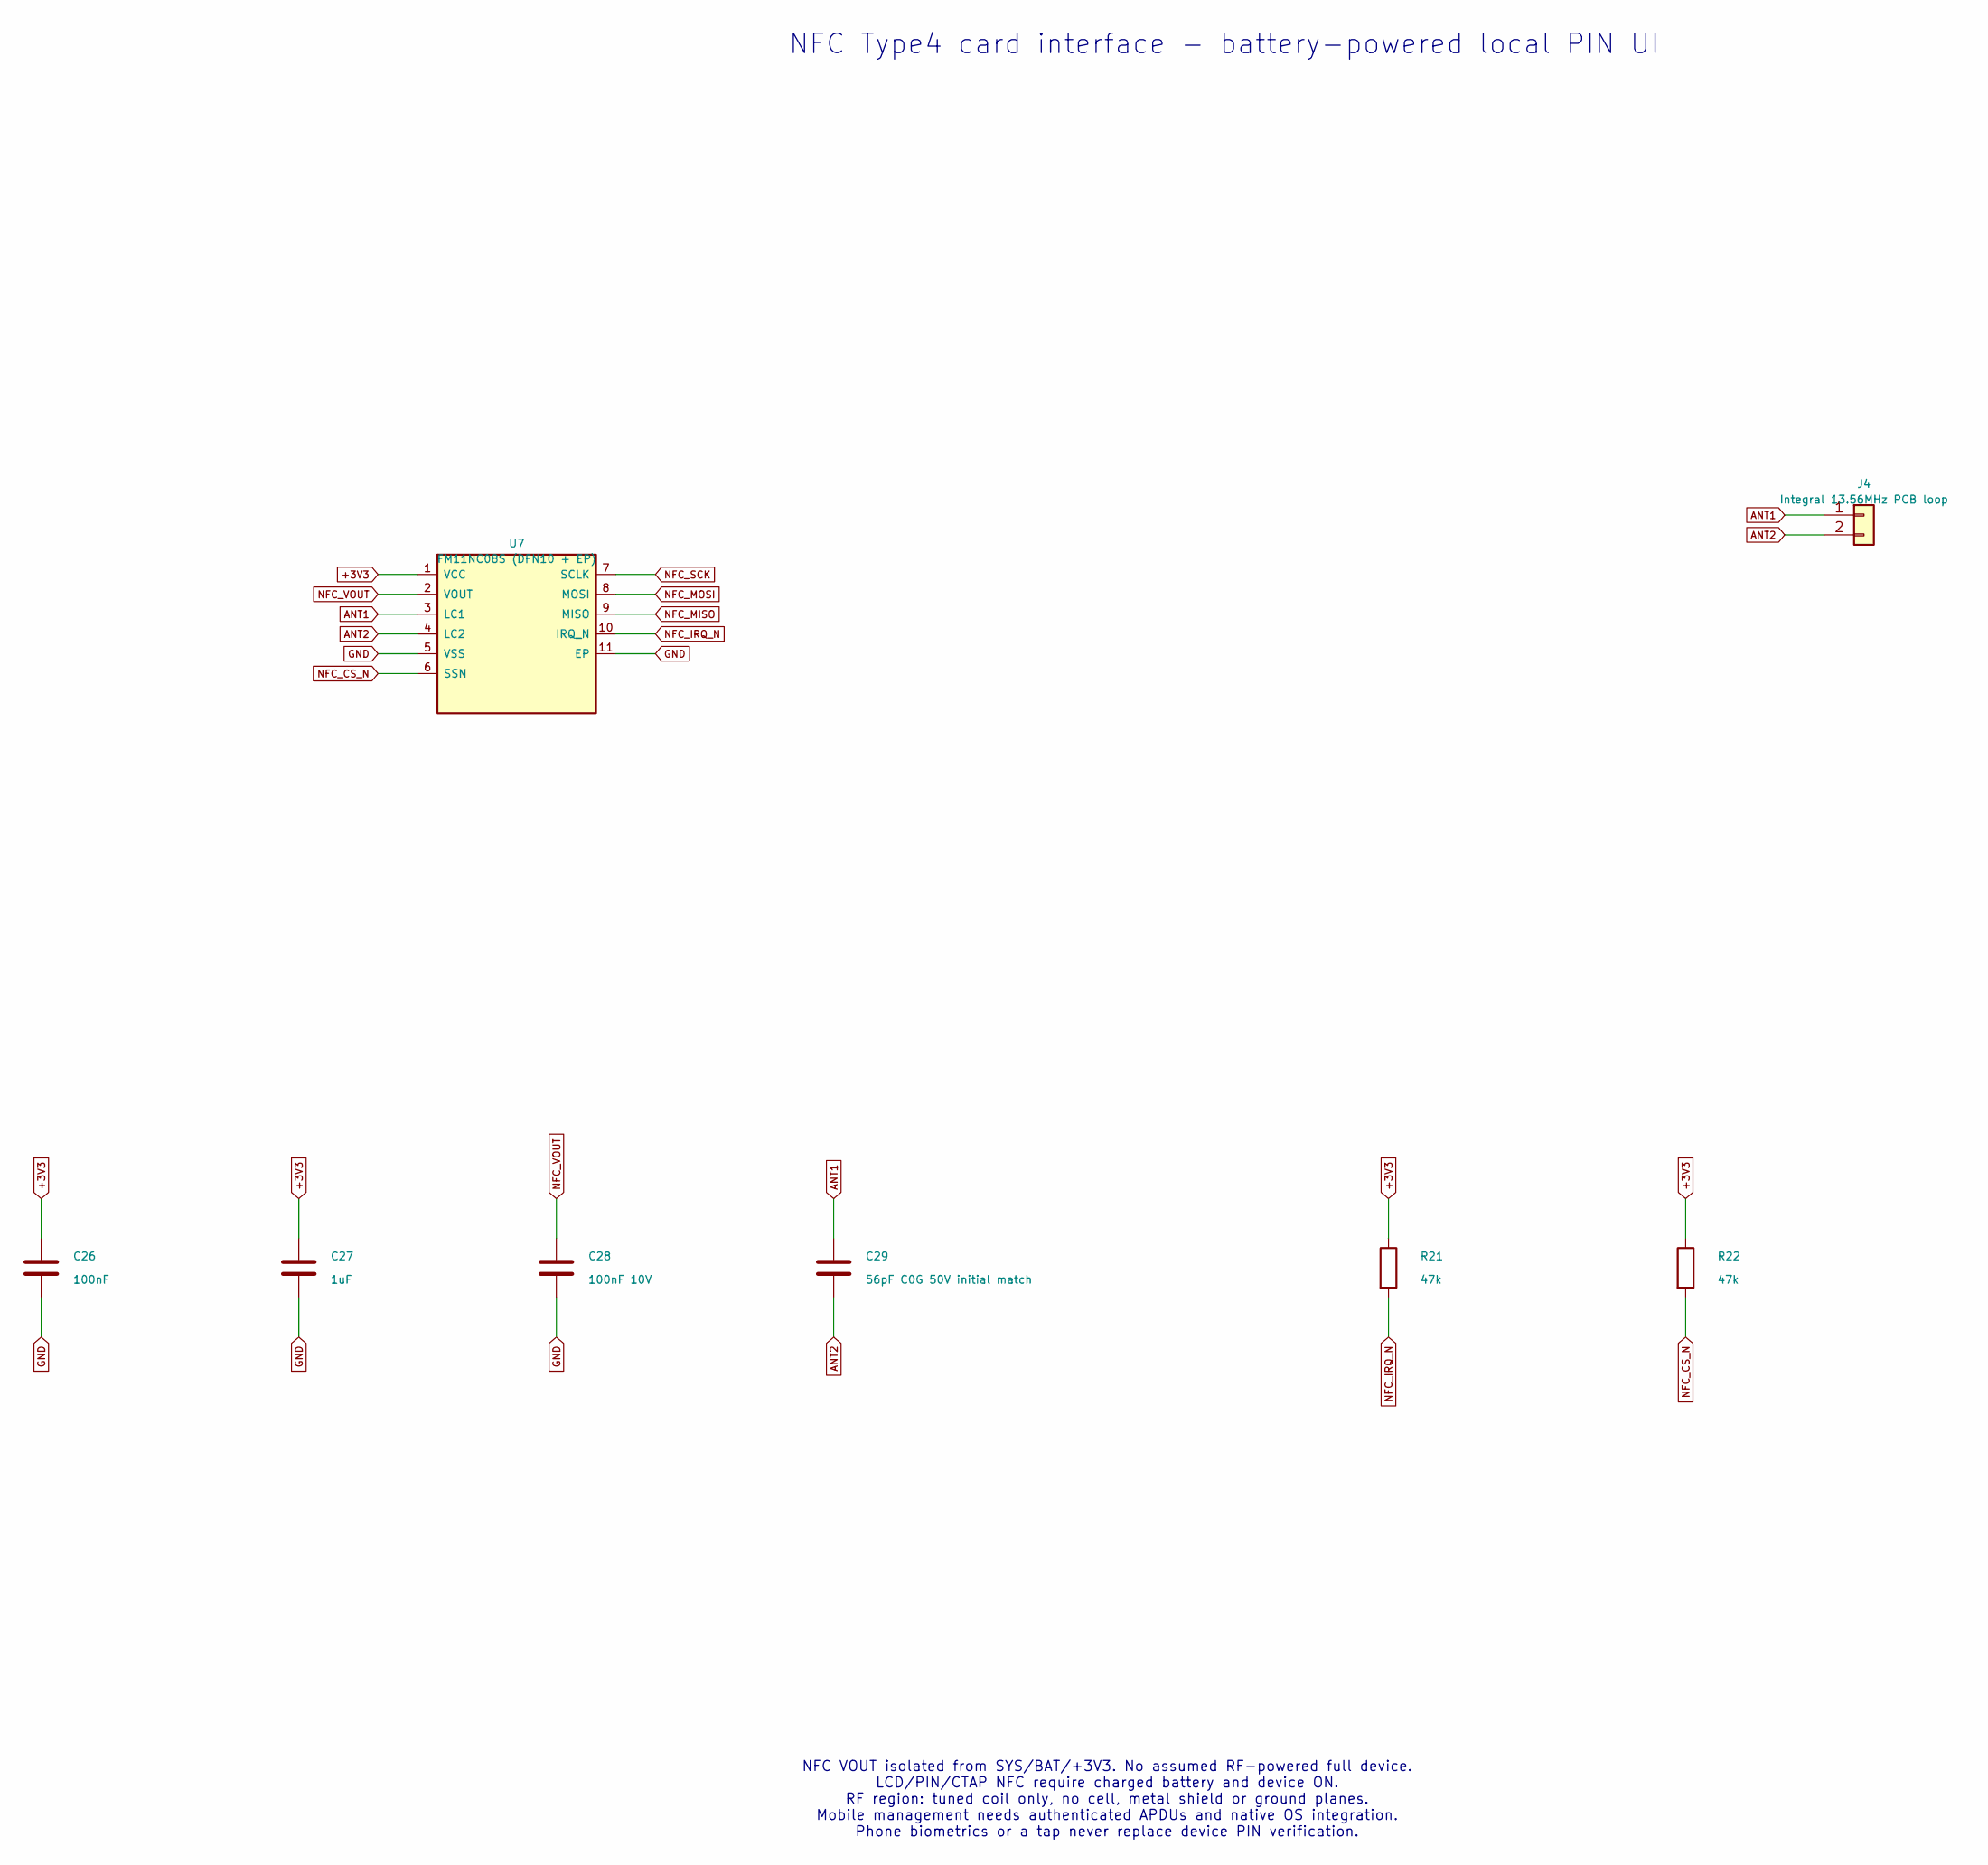
[picture p73: schematic 05-nfc.kicad_sch, OpenKeys R0.5 - 05-nfc]

Parts:
C26: 100nF; C_0603_1608Metric
C27: 1uF; C_0805_2012Metric
C28: 100nF 10V; C_0603_1608Metric
C29: 56pF C0G 50V initial match; C_0603_1608Metric
J4: Integral 13.56MHz PCB loop; NFC_PCB_Loop_4T_62x15
R21, R22: 47k; R_0603_1608Metric
U7: FM11NC08S (DFN10 + EP); FM11NC08S_DFN10_3x3_EP1.7x2.4

Connections:
+3V3: C26.1, C27.1, R21.1, R22.1, U7.1 (VCC); also elsewhere on the board
ANT1: C29.1, J4.1, U7.3 (LC1)
ANT2: C29.2, J4.2, U7.4 (LC2)
GND: C26.2, C27.2, C28.2, U7.5 (VSS), U7.11 (EP); also elsewhere on the board
NFC_CS_N: R22.2, U7.6 (SSN); also elsewhere on the board
NFC_IRQ_N: R21.2, U7.10 (IRQ_N); also elsewhere on the board
NFC_MISO: U7.9 (MISO); also elsewhere on the board
NFC_MOSI: U7.8 (MOSI); also elsewhere on the board
NFC_SCK: U7.7 (SCLK); also elsewhere on the board
NFC_VOUT: C28.1, U7.2 (VOUT)

Notes on the sheet:
NFC Type4 card interface - battery-powered local PIN UI
NFC VOUT isolated from SYS/BAT/+3V3. No assumed RF-powered full device. LCD/PIN/CTAP NFC require charged battery and device ON. RF region: tuned coil only, no cell, metal shield or ground planes. Mobile management needs authenticated APDUs and native OS integration. Phone biometrics or a tap never 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

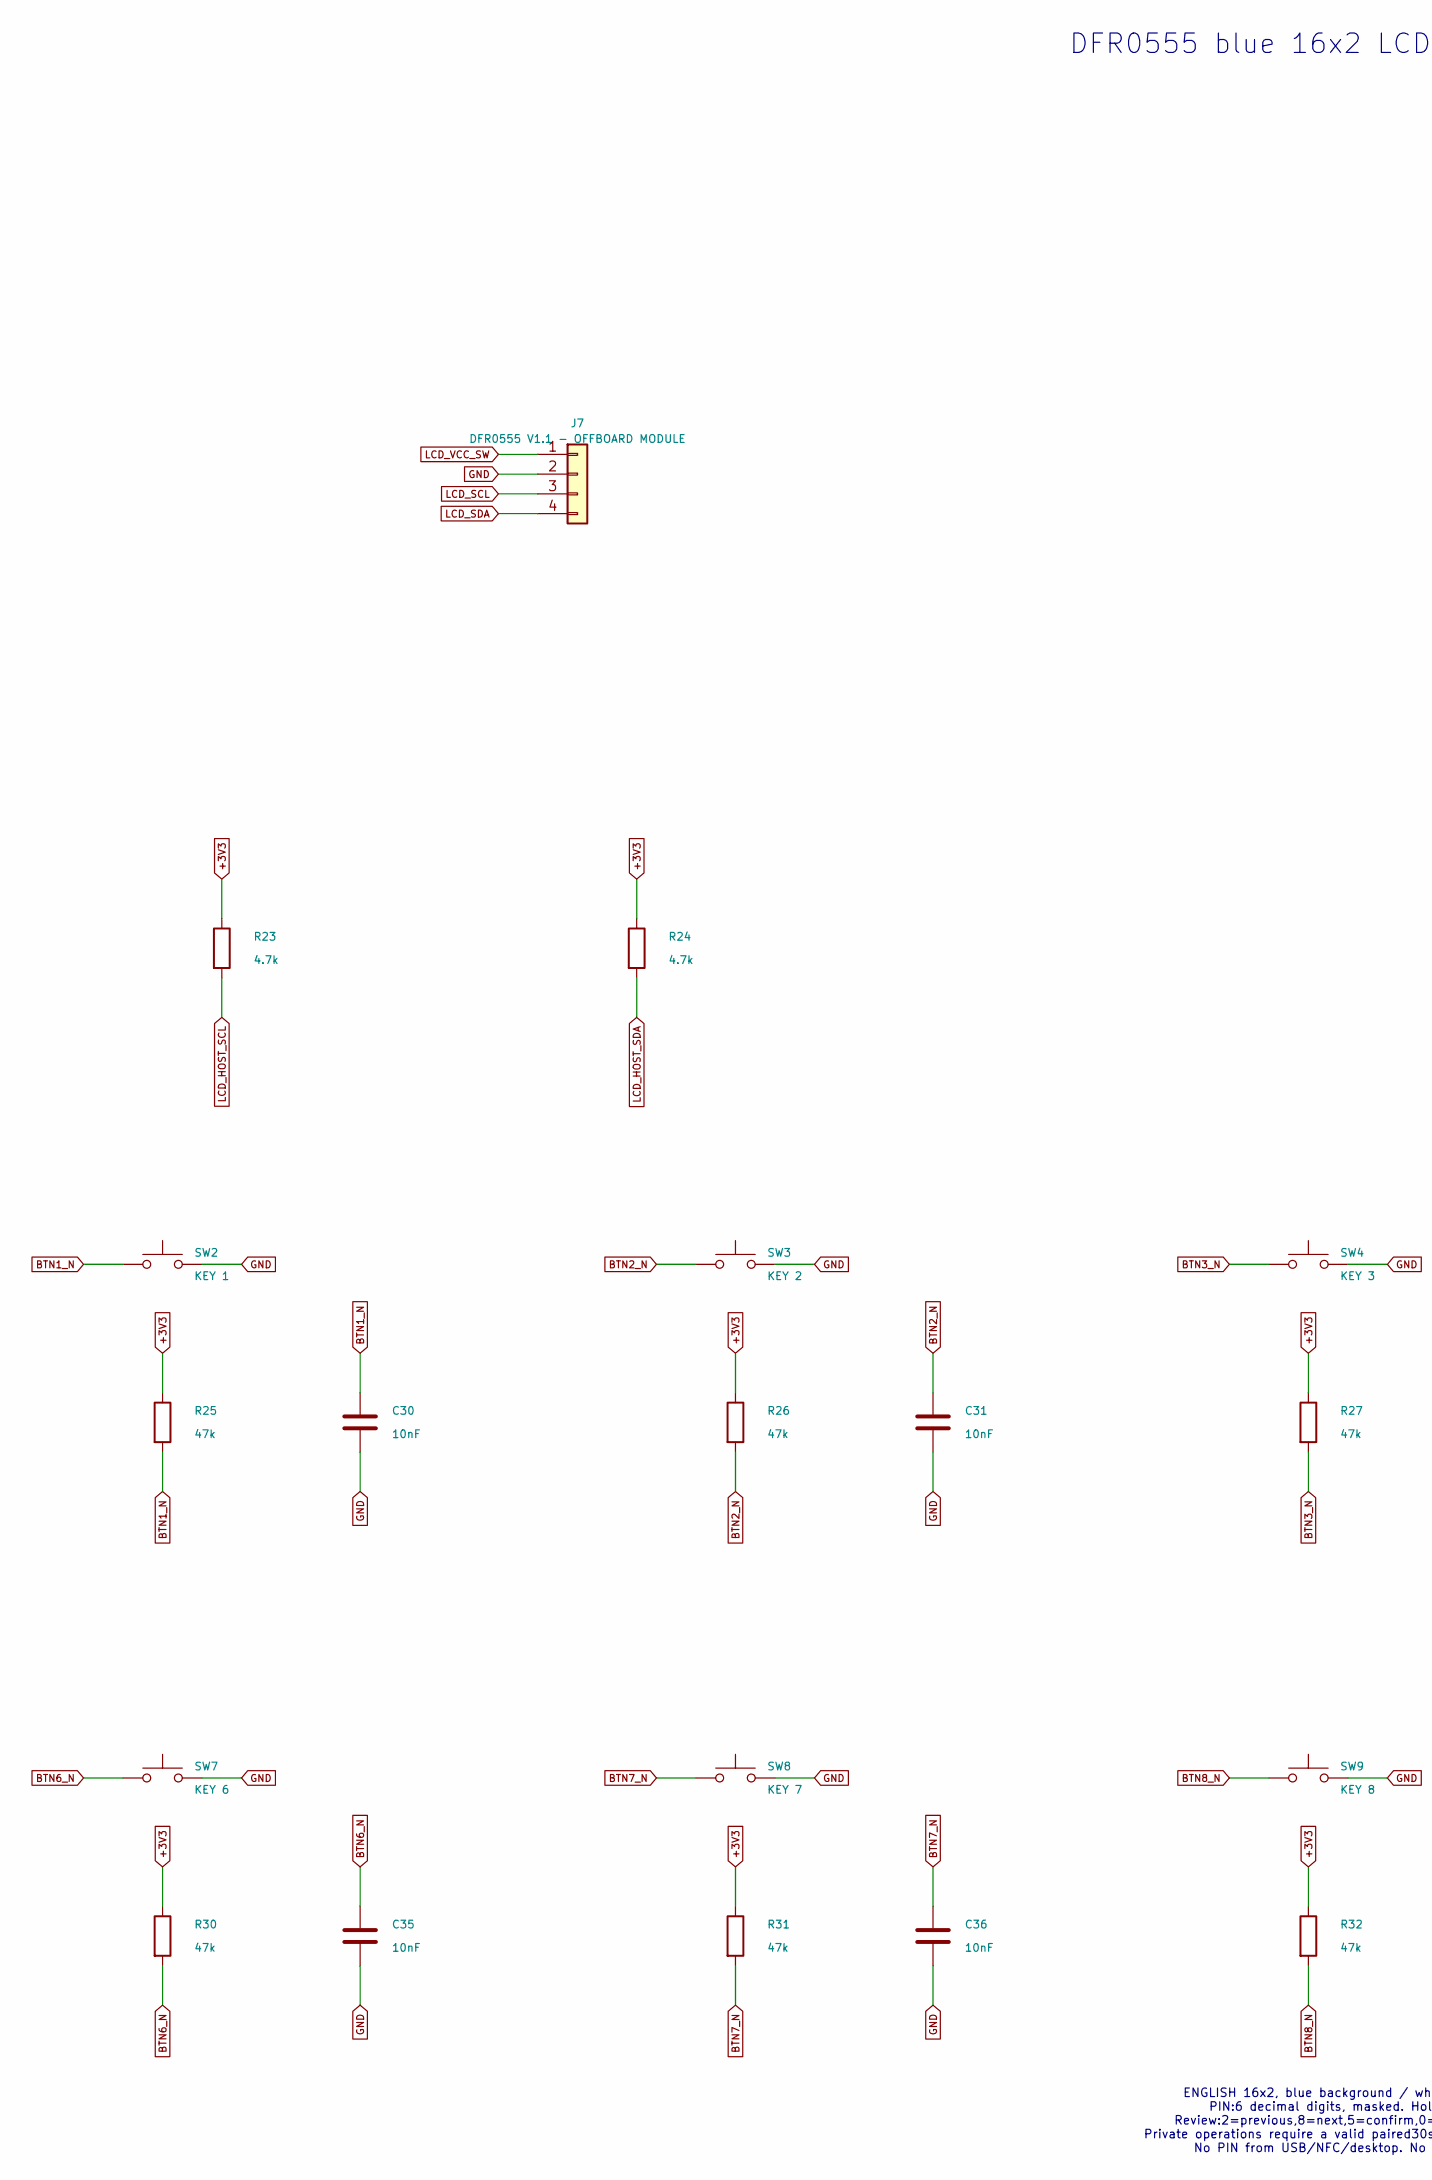
[picture p74: schematic 06-trusted-ui.kicad_sch, OpenKeys R0.5 - 06-trusted-ui, part in row 1, column 1]

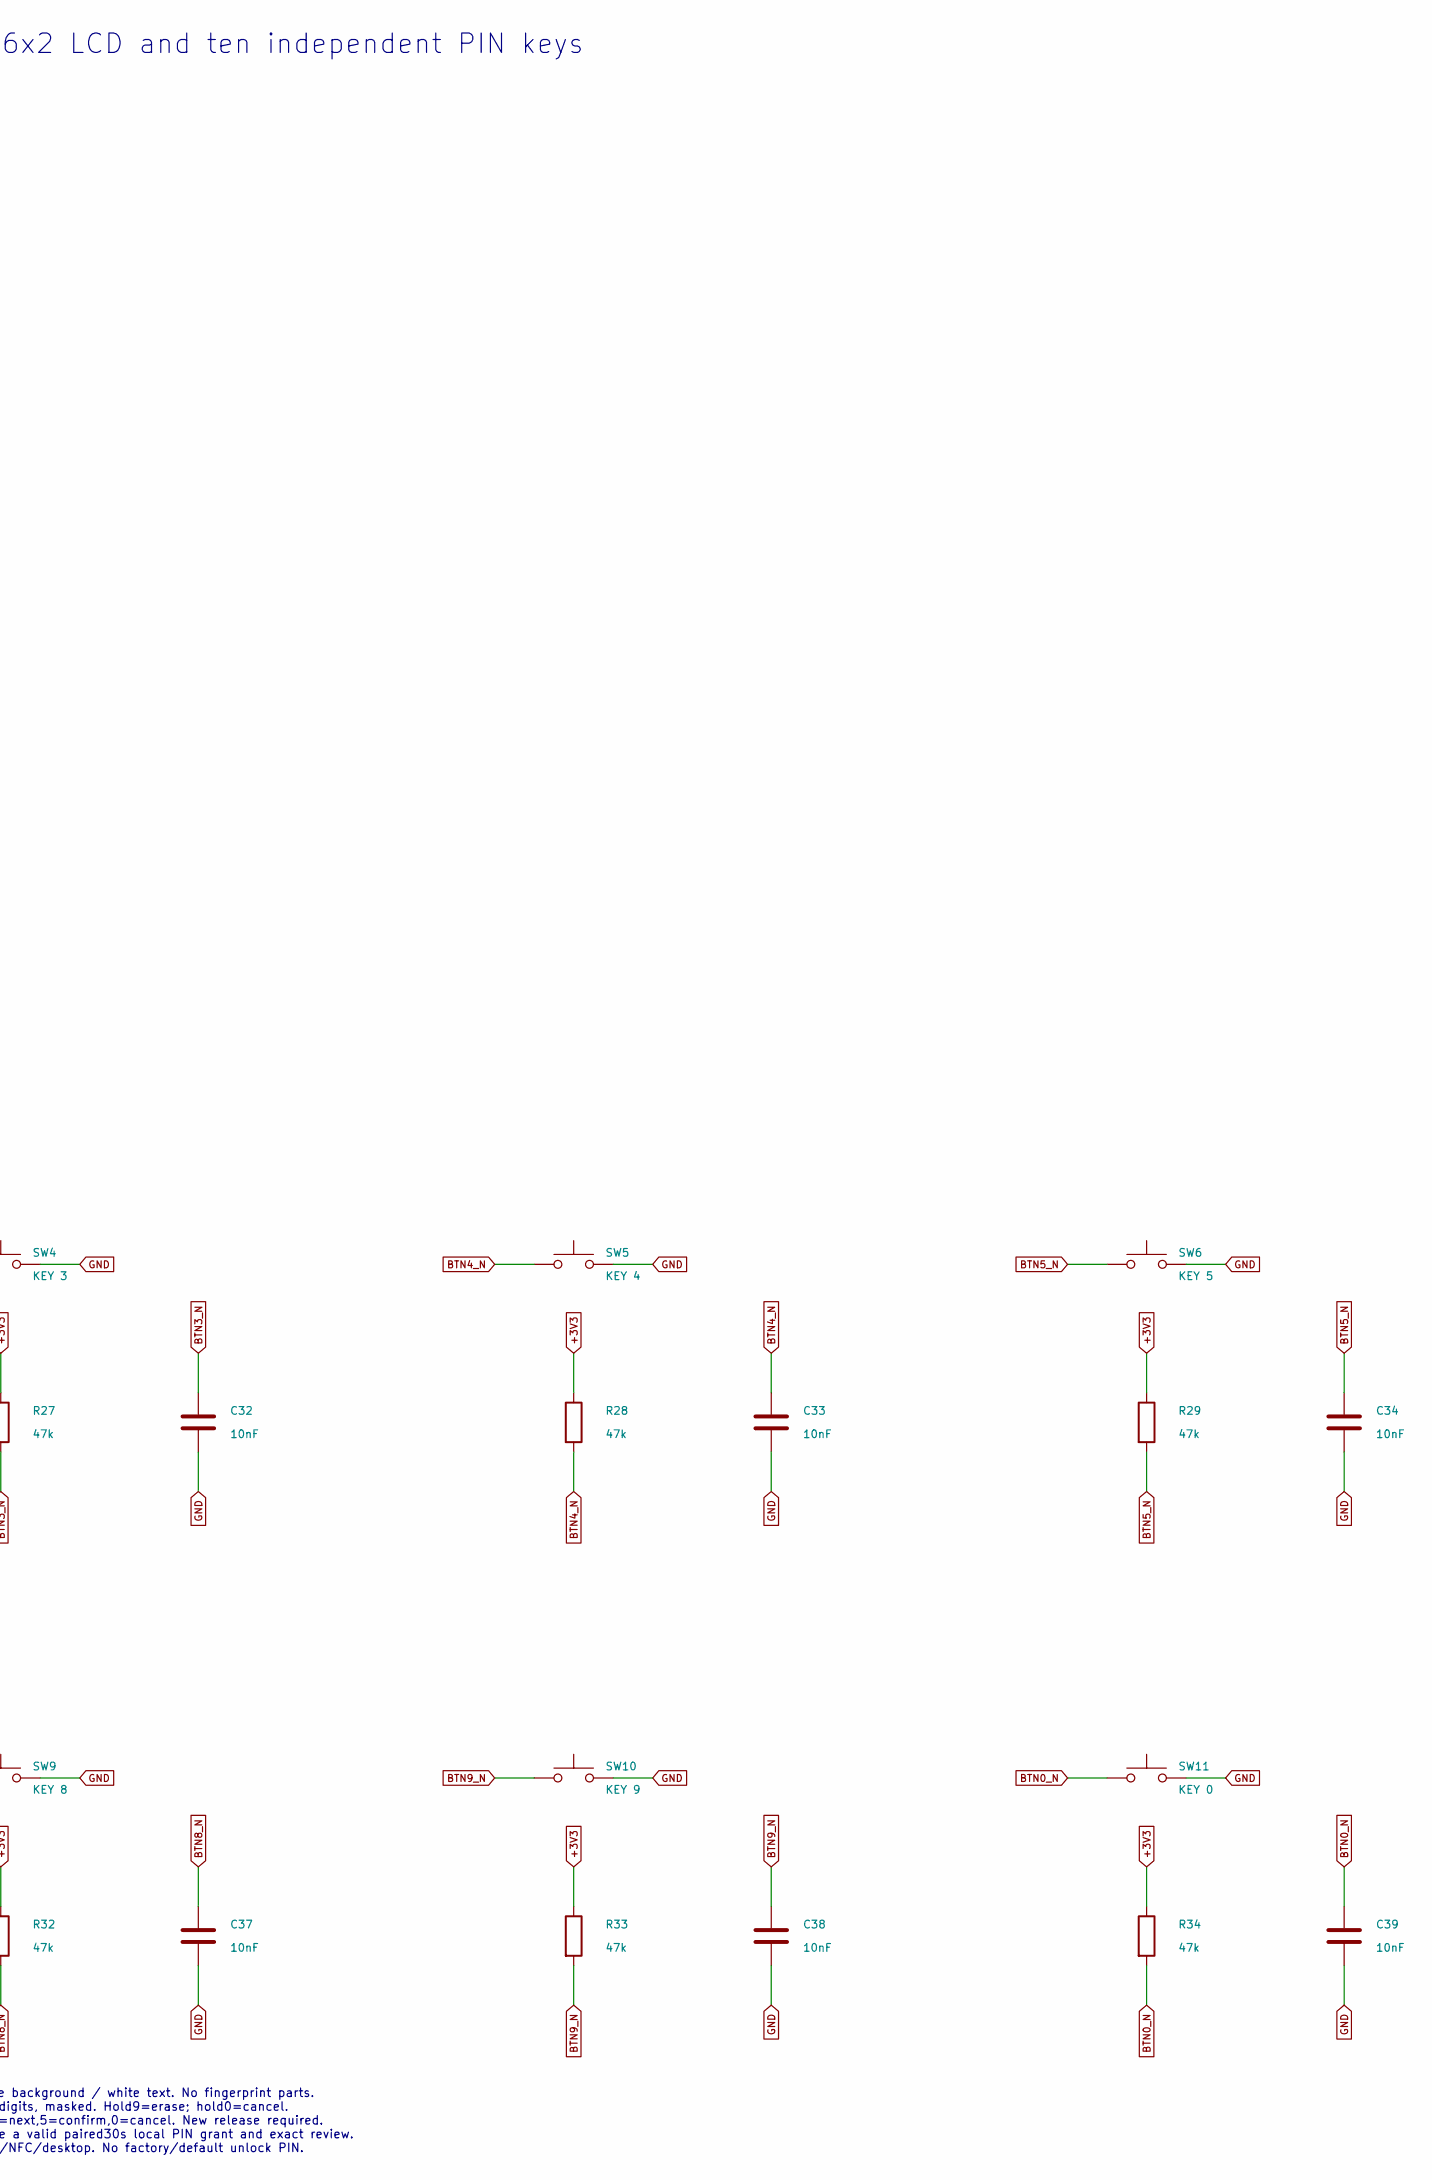
[picture p75: schematic 06-trusted-ui.kicad_sch, OpenKeys R0.5 - 06-trusted-ui, part in row 1, column 2]

Parts:
C30, C31, C32, C33, C34, C35, C36, C37, C38, C39: 10nF; C_0603_1608Metric
J7: DFR0555 V1.1 - OFFBOARD MODULE; PinHeader_1x04_P2.54mm_Vertical
R23, R24: 4.7k; R_0603_1608Metric
R25, R26, R27, R28, R29, R30, R31, R32, R33, R34: 47k; R_0603_1608Metric
SW2: KEY 1; SW_SPST_TL3342
SW3: KEY 2; SW_SPST_TL3342
SW4: KEY 3; SW_SPST_TL3342
SW5: KEY 4; SW_SPST_TL3342
SW6: KEY 5; SW_SPST_TL3342
SW7: KEY 6; SW_SPST_TL3342
SW8: KEY 7; SW_SPST_TL3342
SW9: KEY 8; SW_SPST_TL3342
SW10: KEY 9; SW_SPST_TL3342
SW11: KEY 0; SW_SPST_TL3342

Connections:
+3V3: R23.1, R24.1, R25.1, R26.1, R27.1, R28.1, R29.1, R30.1, R31.1, R32.1, R33.1, R34.1; also elsewhere on the board
BTN0_N: C39.1, R34.2, SW11.1; also elsewhere on the board
BTN1_N: C30.1, R25.2, SW2.1; also elsewhere on the board
BTN2_N: C31.1, R26.2, SW3.1; also elsewhere on the board
BTN3_N: C32.1, R27.2, SW4.1; also elsewhere on the board
BTN4_N: C33.1, R28.2, SW5.1; also elsewhere on the board
BTN5_N: C34.1, R29.2, SW6.1; also elsewhere on the board
BTN6_N: C35.1, R30.2, SW7.1; also elsewhere on the board
BTN7_N: C36.1, R31.2, SW8.1; also elsewhere on the board
BTN8_N: C37.1, R32.2, SW9.1; also elsewhere on the board
BTN9_N: C38.1, R33.2, SW10.1; also elsewhere on the board
GND: C30.2, C31.2, C32.2, C33.2, C34.2, C35.2, C36.2, C37.2, C38.2, C39.2, J7.2, SW2.2, SW3.2, SW4.2, SW5.2, SW6.2, SW7.2, SW8.2, SW9.2, SW10.2, SW11.2; also elsewhere on the board
LCD_HOST_SCL: R23.2; also elsewhere on the board
LCD_HOST_SDA: R24.2; also elsewhere on the board
LCD_SCL: J7.3; also elsewhere on the board
LCD_SDA: J7.4; also elsewhere on the board
LCD_VCC_SW: J7.1; also elsewhere on the board

Notes on the sheet:
DFR0555 blue 16x2 LCD and ten independent PIN keys
ENGLISH 16x2, blue background / white text. No fingerprint parts. PIN:6 decimal digits, masked. Hold9=erase; hold0=cancel. Review:2=previous,8=next,5=confirm,0=cancel. New release required. Private operations require a valid paired30s local PIN grant and exact review. No PIN from USB/NFC/desktop. N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
