Jay-Void-BA/OpenKeys/hardware/r05/kicad/OpenKeys.kicad_pcb

## KiCad design hardware/r05/kicad/OpenKeys.kicad_pcb (continued)

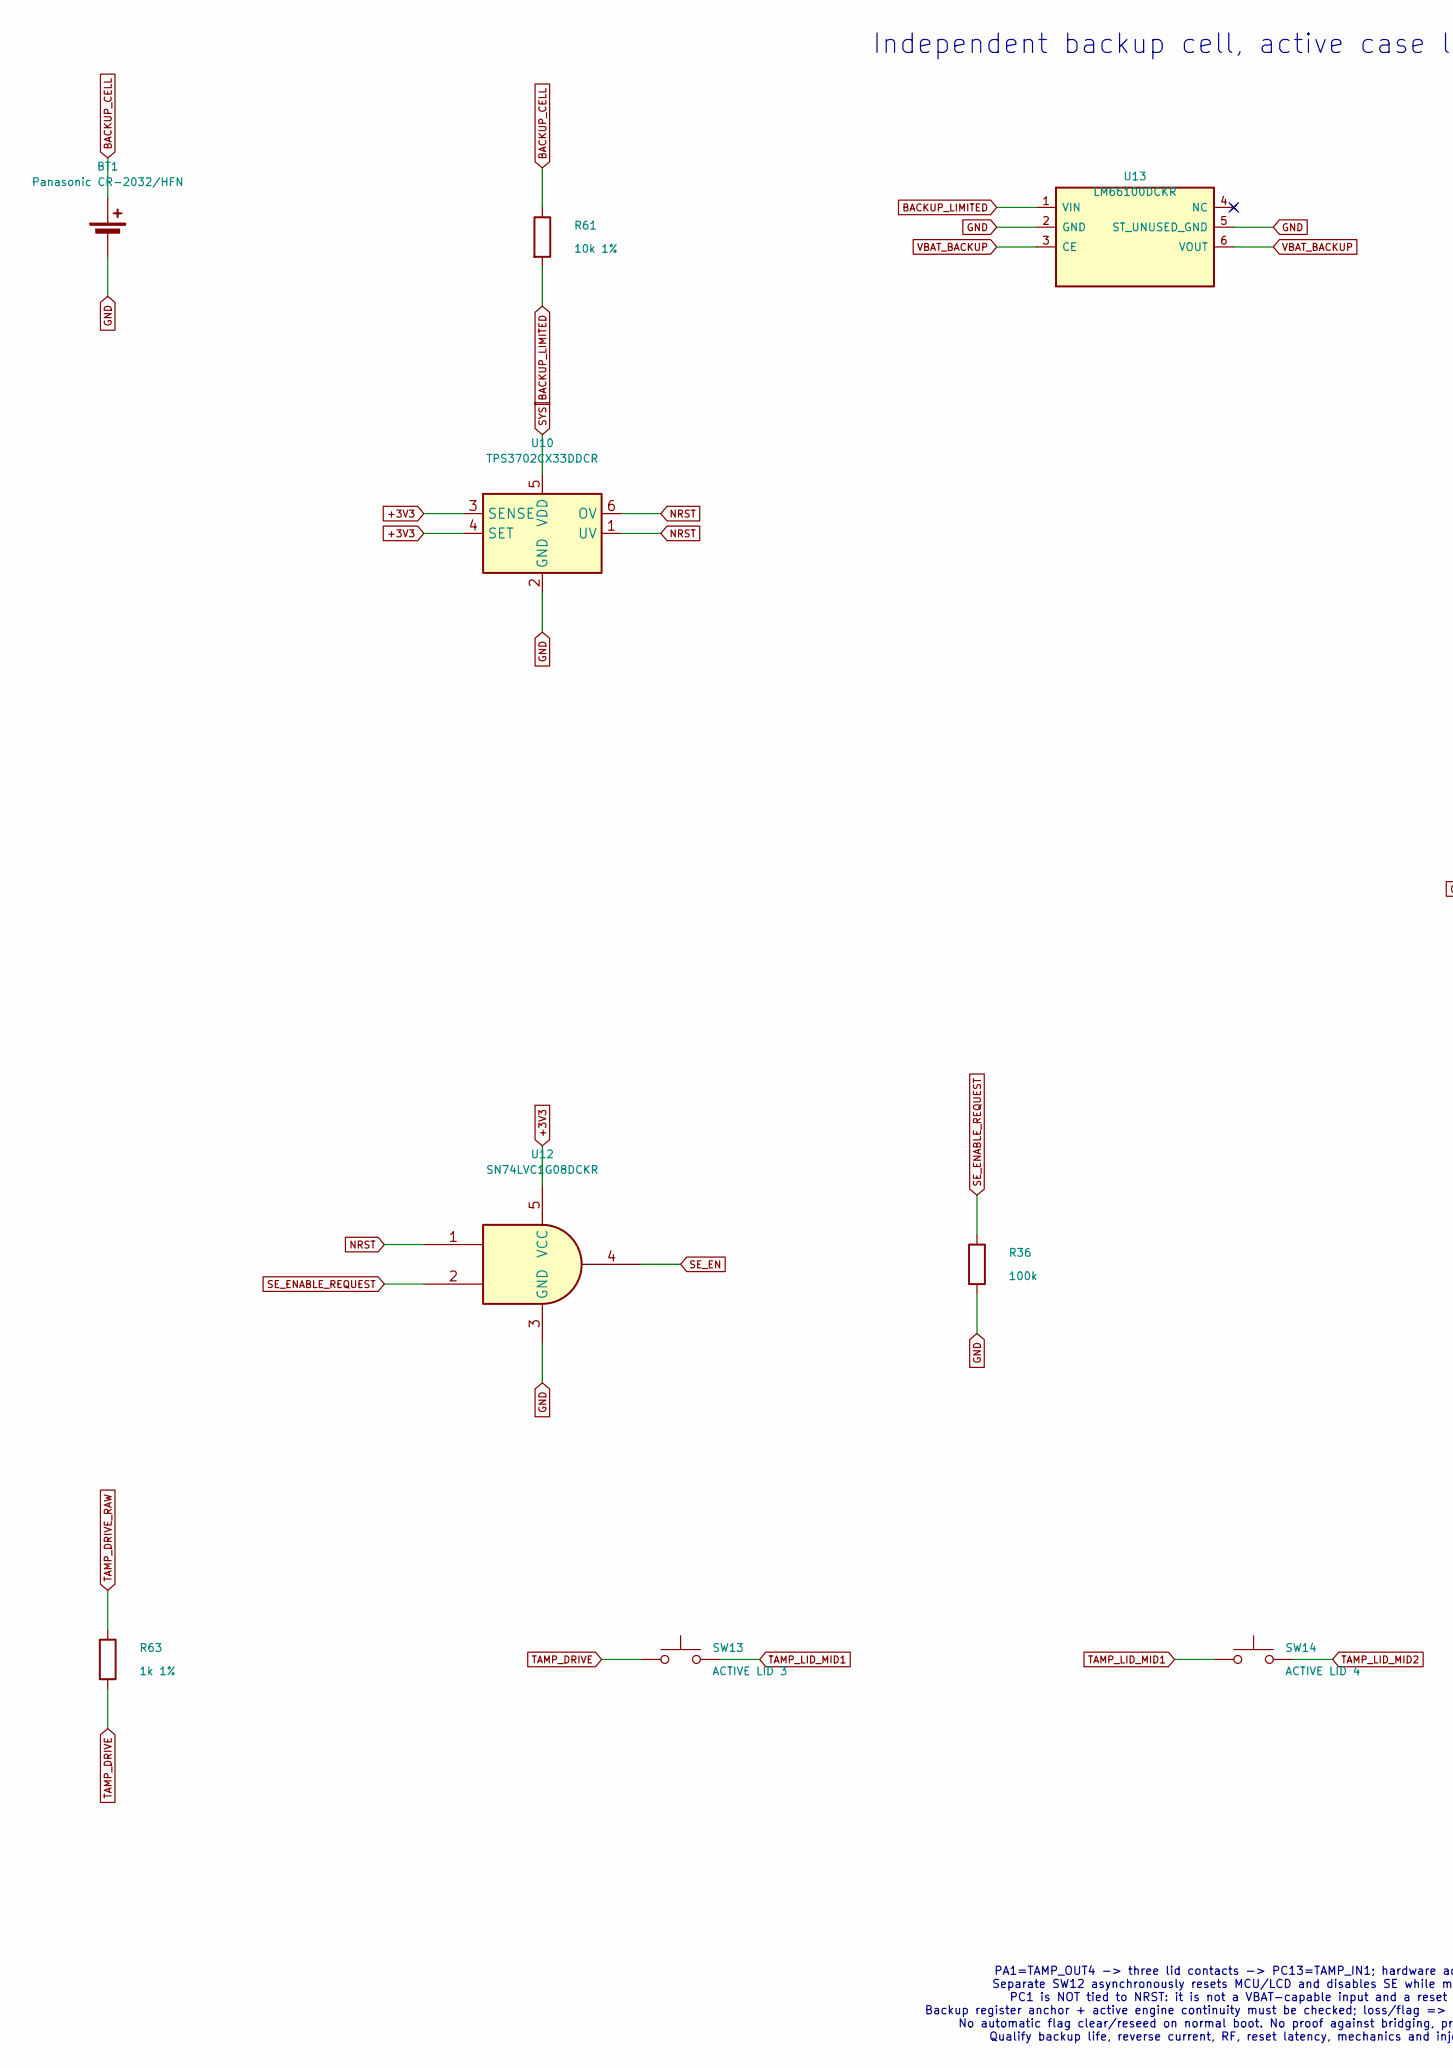
[picture p76: schematic 07-fault-tamper.kicad_sch, OpenKeys R0.5 - 07-fault-tamper, part in row 1, column 1]

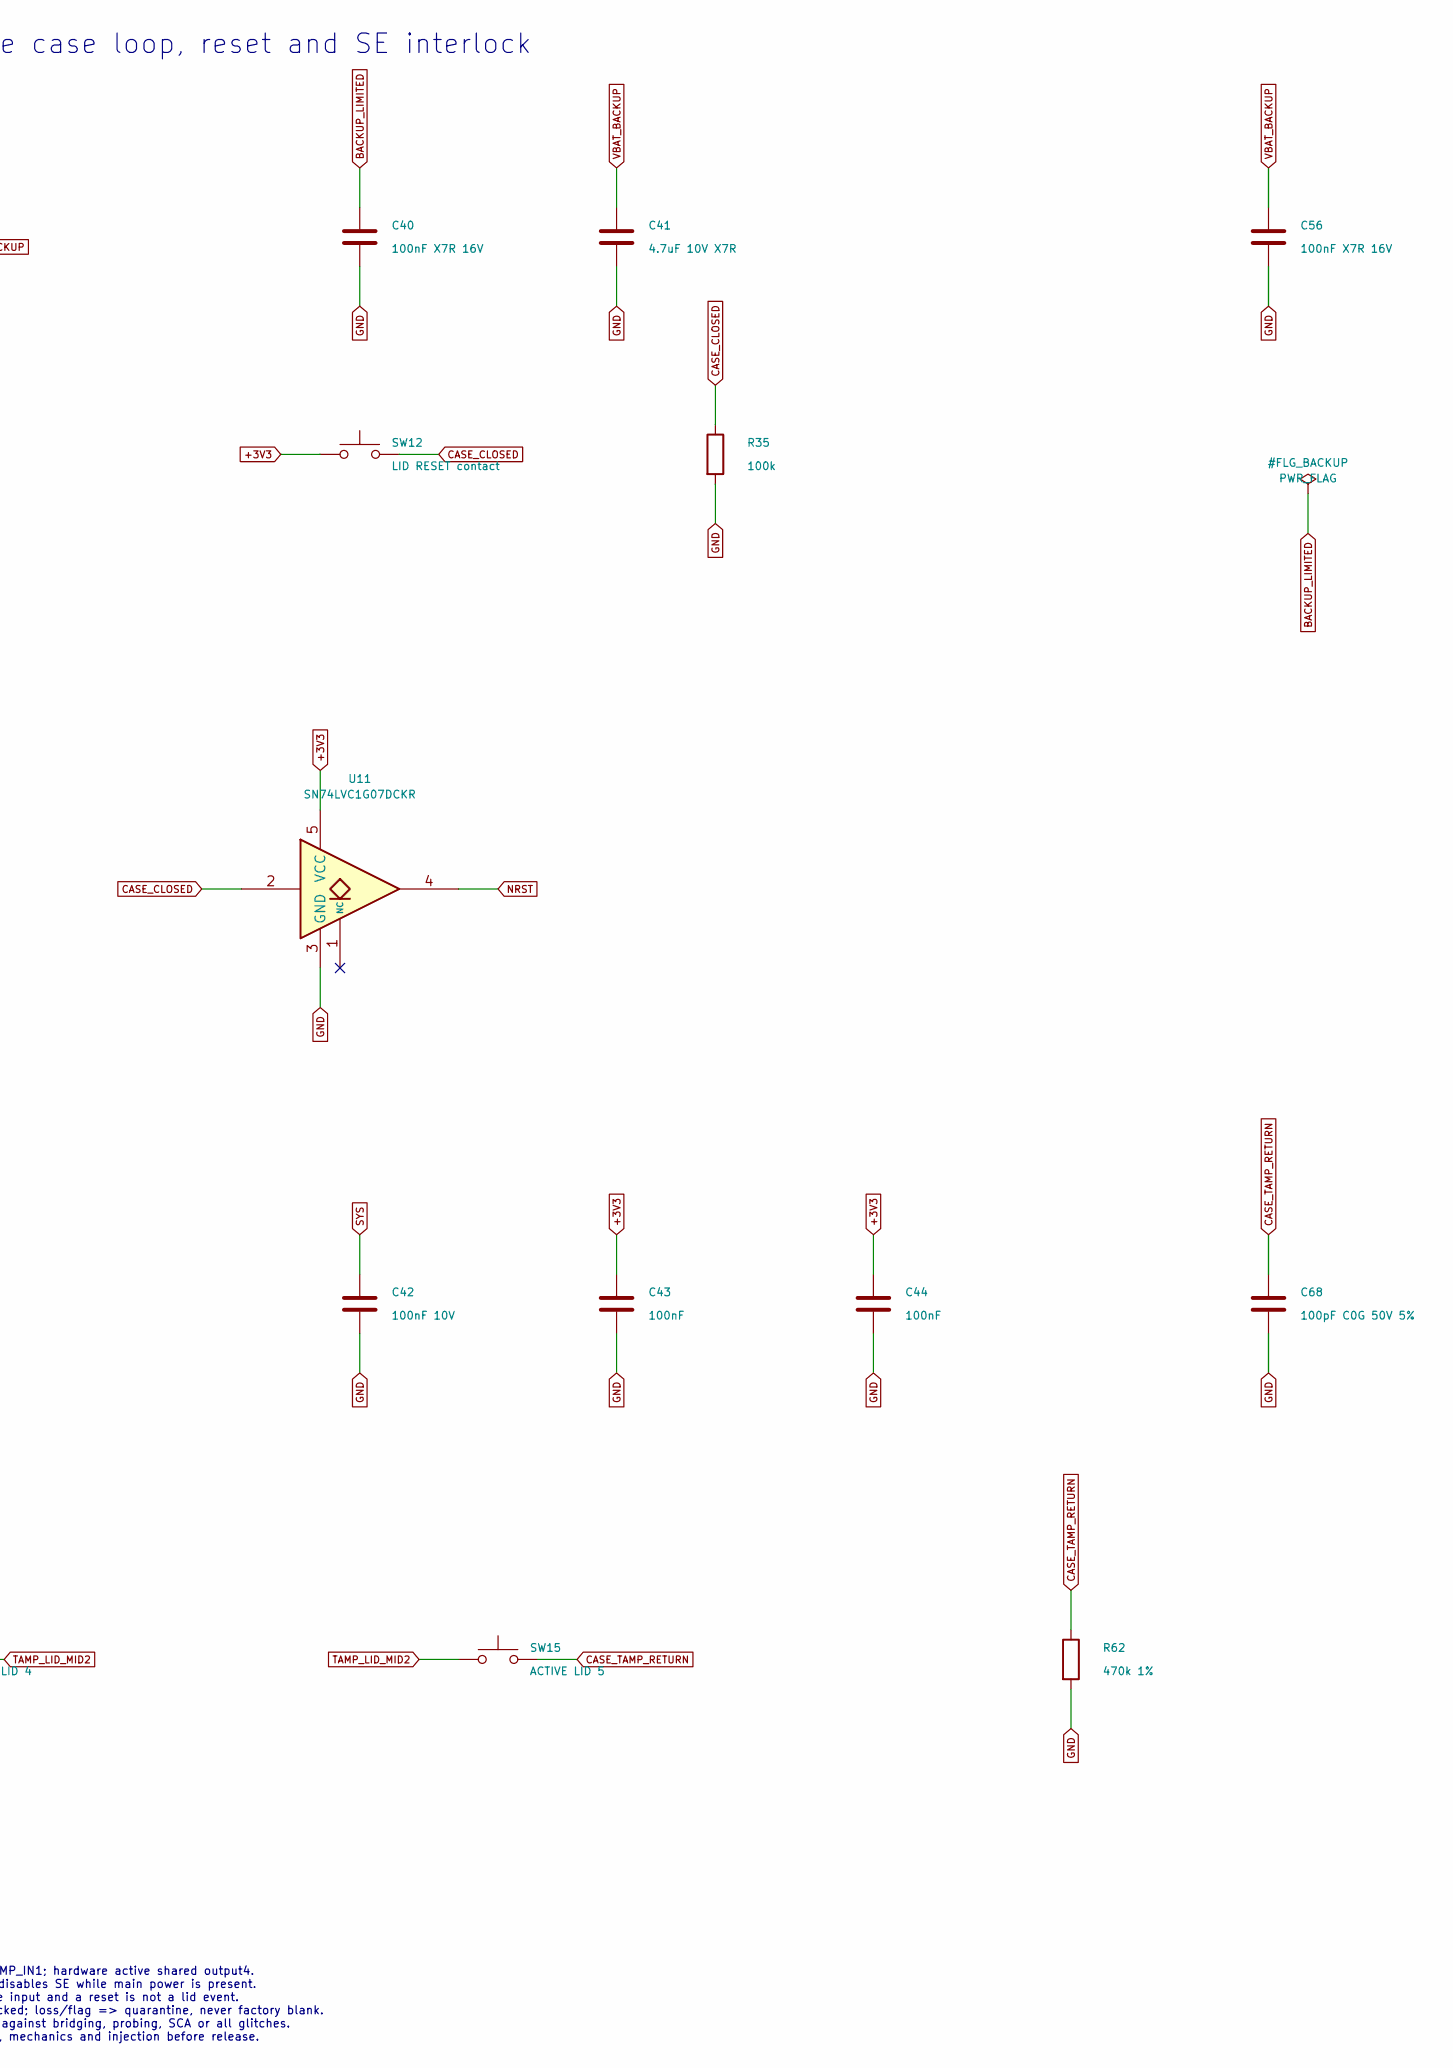
[picture p77: schematic 07-fault-tamper.kicad_sch, OpenKeys R0.5 - 07-fault-tamper, part in row 1, column 2]

Parts:
BT1: Panasonic CR-2032/HFN; Battery_Panasonic_CR2032-HFN_Horizontal_CircularHoles
C40, C56: 100nF X7R 16V; C_0603_1608Metric
C41: 4.7uF 10V X7R; C_0805_2012Metric
C42: 100nF 10V; C_0603_1608Metric
C43, C44: 100nF; C_0603_1608Metric
C68: 100pF C0G 50V 5%; C_0603_1608Metric
R35, R36: 100k; R_0603_1608Metric
R61: 10k 1%; R_0603_1608Metric
R62: 470k 1%; R_0603_1608Metric
R63: 1k 1%; R_0603_1608Metric
SW12: LID RESET contact; SW_SPST_TL3342
SW13: ACTIVE LID 3; SW_SPST_TL3342
SW14: ACTIVE LID 4; SW_SPST_TL3342
SW15: ACTIVE LID 5; SW_SPST_TL3342
U10: TPS3702CX33DDCR; TSOT-23-6
U11: SN74LVC1G07DCKR; SOT-353_SC-70-5
U12: SN74LVC1G08DCKR; SOT-353_SC-70-5
U13: LM66100DCKR; SOT-363_SC-70-6

Connections:
+3V3: C43.1, C44.1, SW12.1, U10.3 (SENSE), U10.4 (SET), U11.5 (VCC), U12.5 (VCC); also elsewhere on the board
BACKUP_CELL: BT1.1 (+), R61.1
BACKUP_LIMITED: C40.1, R61.2, U13.1 (VIN)
CASE_CLOSED: R35.1, SW12.2, U11.2
CASE_TAMP_RETURN: C68.1, R62.1, SW15.2; also elsewhere on the board
GND: BT1.2 (-), C40.2, C41.2, C42.2, C43.2, C44.2, C56.2, C68.2, R35.2, R36.2, R62.2, U10.2 (GND), U11.3 (GND), U12.3 (GND), U13.2 (GND), U13.5 (ST_UNUSED_GND); also elsewhere on the board
NRST: U10.1 (UV), U10.6 (OV), U11.4, U12.1; also elsewhere on the board
SE_EN: U12.4; also elsewhere on the board
SE_ENABLE_REQUEST: R36.1, U12.2; also elsewhere on the board
SYS: C42.1, U10.5 (VDD); also elsewhere on the board
TAMP_DRIVE: R63.2, SW13.1
TAMP_DRIVE_RAW: R63.1; also elsewhere on the board
TAMP_LID_MID1: SW13.2, SW14.1
TAMP_LID_MID2: SW14.2, SW15.1
VBAT_BACKUP: C41.1, C56.1, U13.3 (CE), U13.6 (VOUT); also elsewhere on the board

Notes on the sheet:
Independent backup cell, active case loop, reset and SE interlock
PA1=TAMP_OUT4 -> three lid contacts -> PC13=TAMP_IN1; hardware active shared output4. Separate SW12 asynchronously resets MCU/LCD and disables SE while main power is present. PC1 is NOT tied to NRST: it is not a VBAT-capable input and a reset is not a lid event. Backup register anchor + active engi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

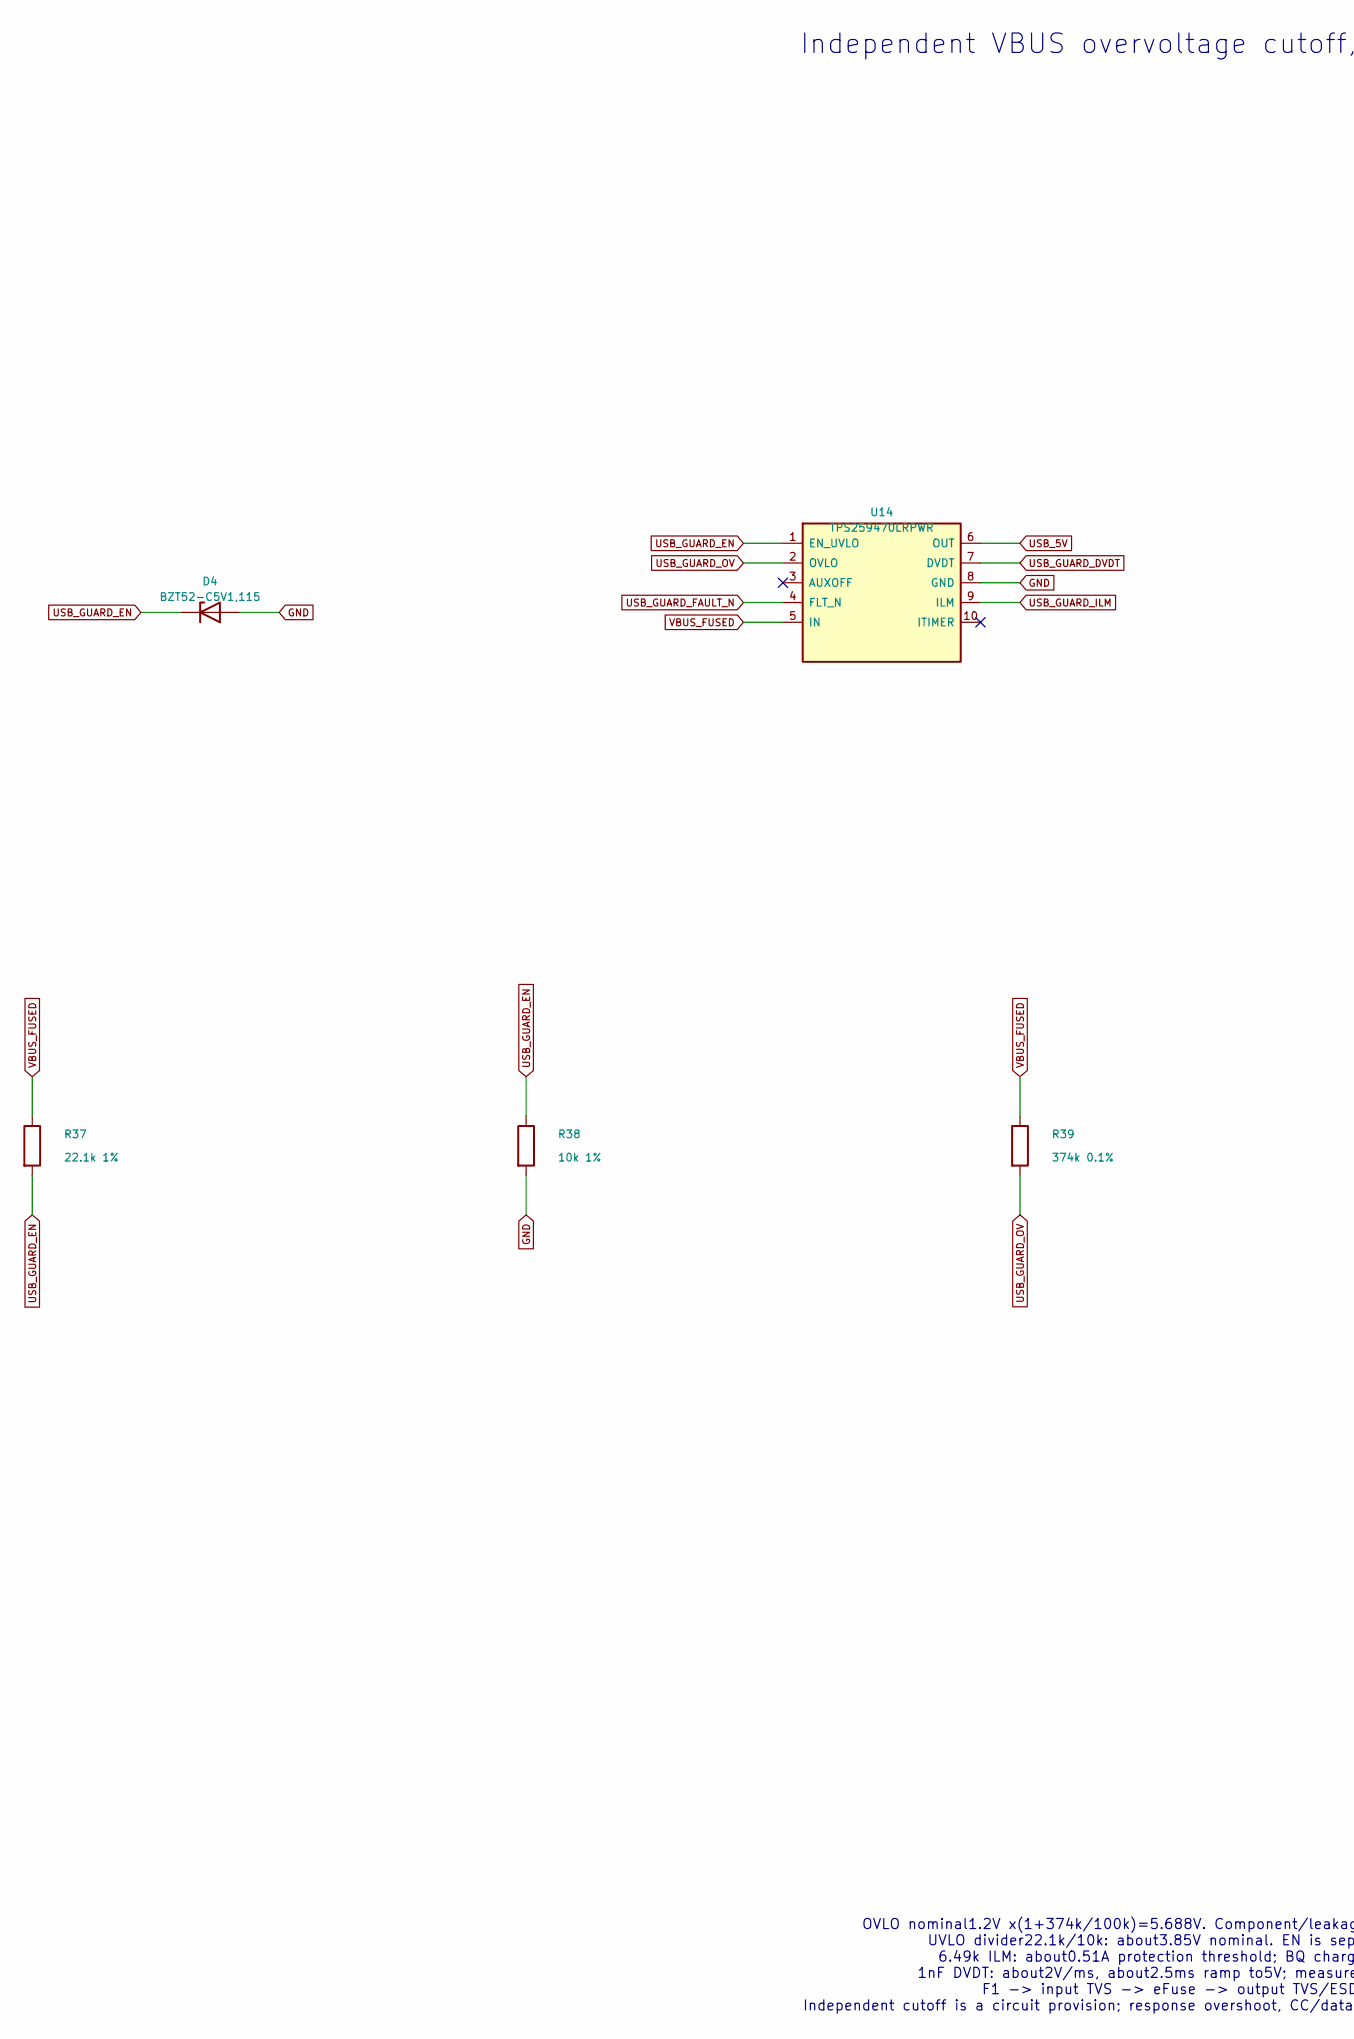
[picture p78: schematic 08-input-guard.kicad_sch, OpenKeys R0.5 - 08-input-guard, part in row 1, column 1]

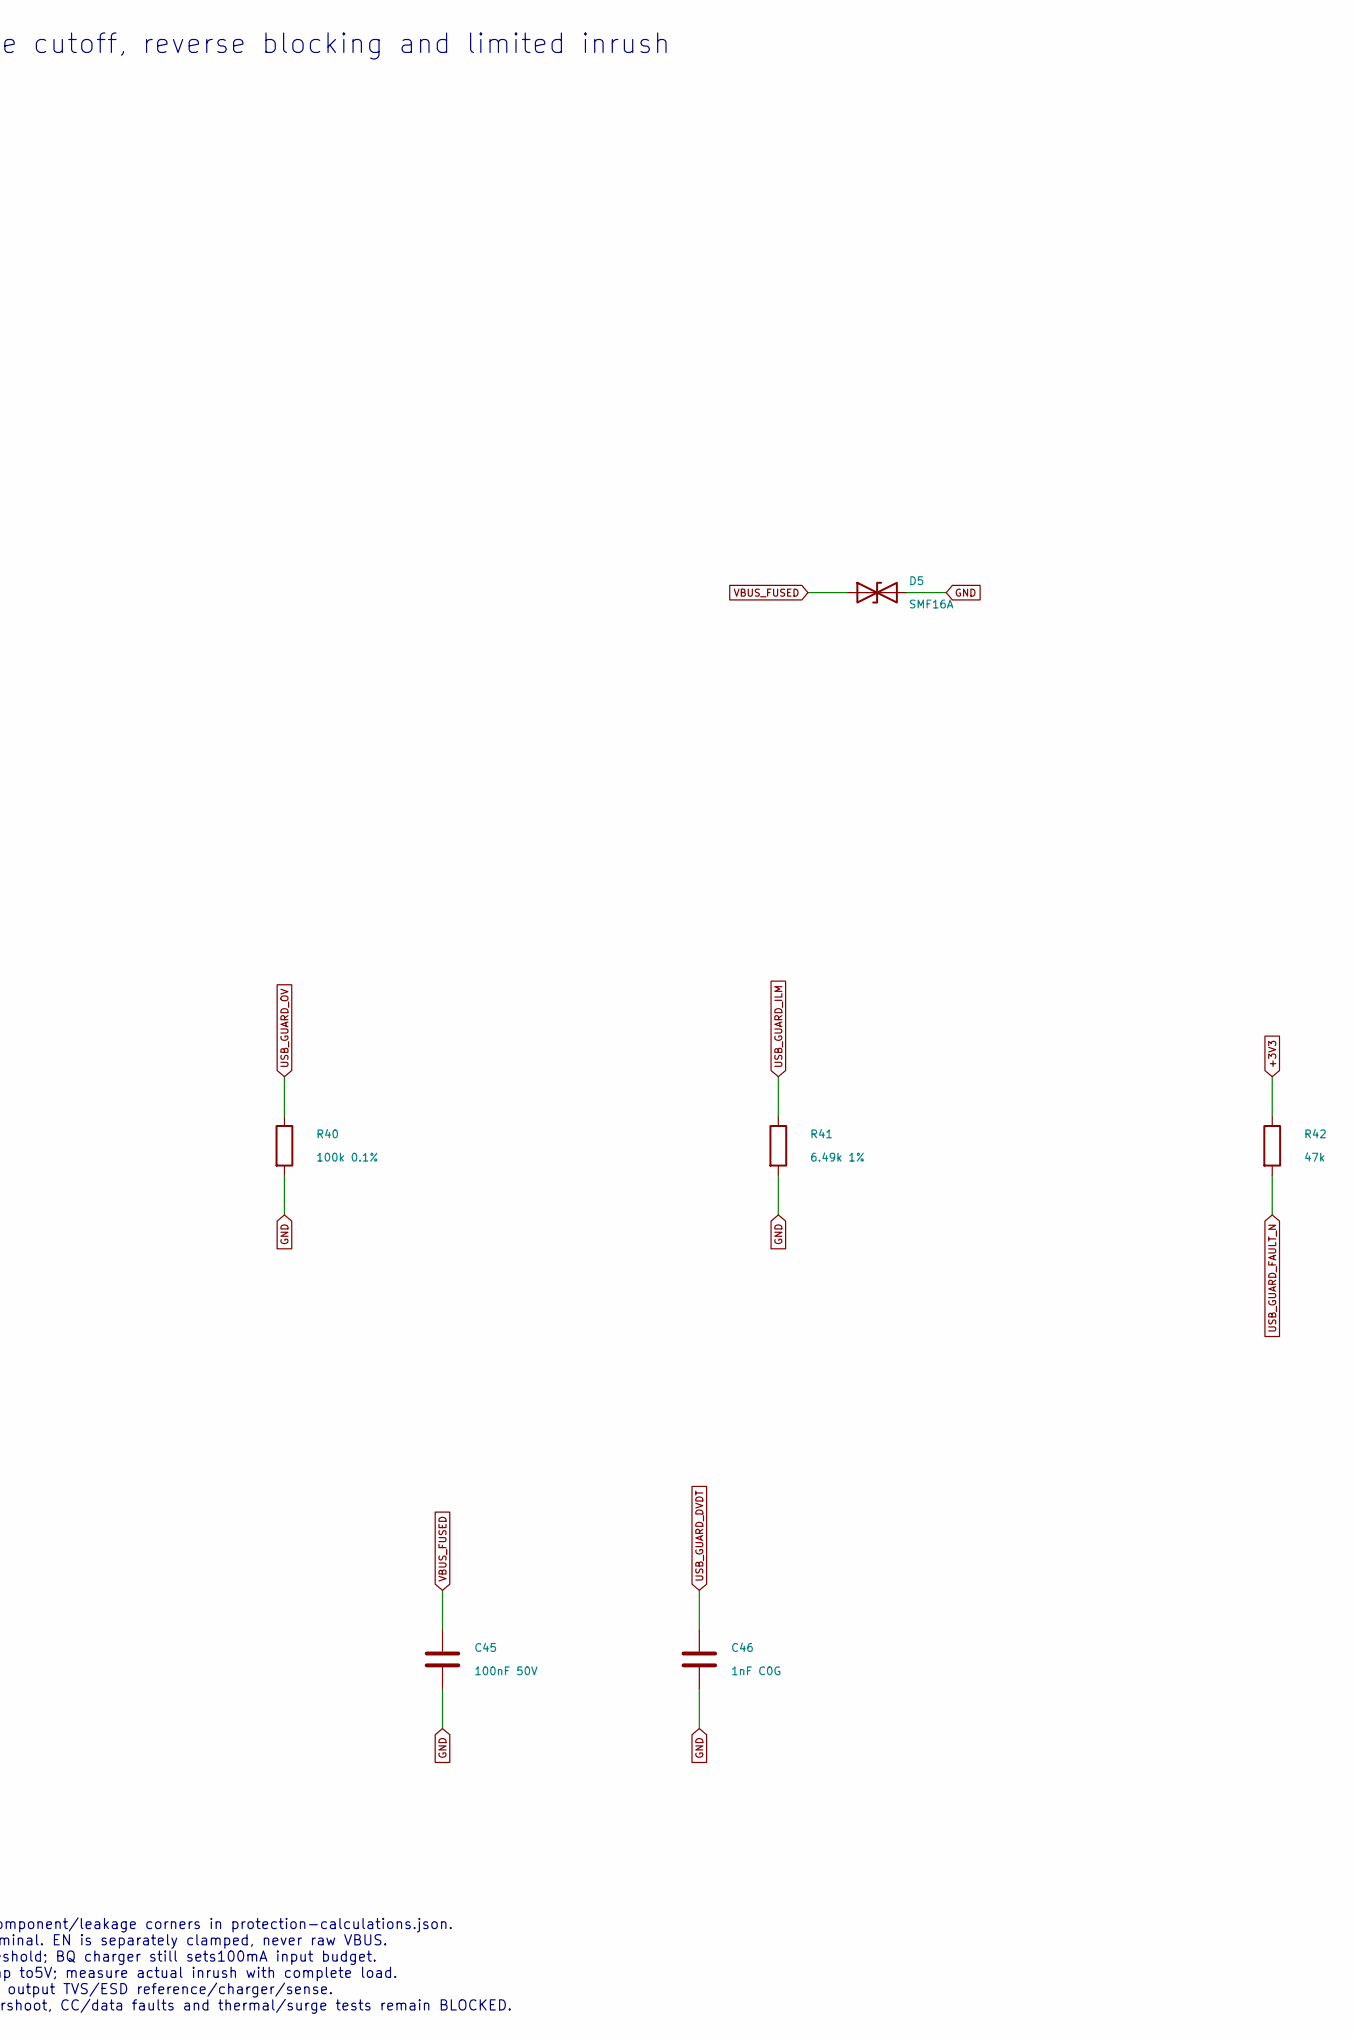
[picture p79: schematic 08-input-guard.kicad_sch, OpenKeys R0.5 - 08-input-guard, part in row 1, column 2]

Parts:
C45: 100nF 50V; C_0603_1608Metric
C46: 1nF C0G; C_0603_1608Metric
D4: BZT52-C5V1,115; D_SOD-123
D5: SMF16A; D_SOD-123F
R37: 22.1k 1%; R_0603_1608Metric
R38: 10k 1%; R_0603_1608Metric
R39: 374k 0.1%; R_0603_1608Metric
R40: 100k 0.1%; R_0603_1608Metric
R41: 6.49k 1%; R_0603_1608Metric
R42: 47k; R_0603_1608Metric
U14: TPS259470LRPWR; TPS25947_RPW0010A

Connections:
+3V3: R42.1; also elsewhere on the board
GND: C45.2, C46.2, D4.2 (A), D5.2 (A2), R38.2, R40.2, R41.2, U14.8 (GND); also elsewhere on the board
USB_5V: U14.6 (OUT); also elsewhere on the board
USB_GUARD_DVDT: C46.1, U14.7 (DVDT)
USB_GUARD_EN: D4.1 (K), R37.2, R38.1, U14.1 (EN_UVLO)
USB_GUARD_FAULT_N: R42.2, U14.4 (FLT_N); also elsewhere on the board
USB_GUARD_ILM: R41.1, U14.9 (ILM)
USB_GUARD_OV: R39.2, R40.1, U14.2 (OVLO)
VBUS_FUSED: C45.1, D5.1 (A1), R37.1, R39.1, U14.5 (IN); also elsewhere on the board

Notes on the sheet:
Independent VBUS overvoltage cutoff, reverse blocking and limited inrush
OVLO nominal1.2V x(1+374k/100k)=5.688V. Component/leakage corners in protection-calculations.json. UVLO divider22.1k/10k: about3.85V nominal. EN is separately clamped, never raw VBUS. 6.49k ILM: about0.51A protection threshold; BQ charger still sets100mA input budget. 1nF DVDT: about2V/ms, about2.5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

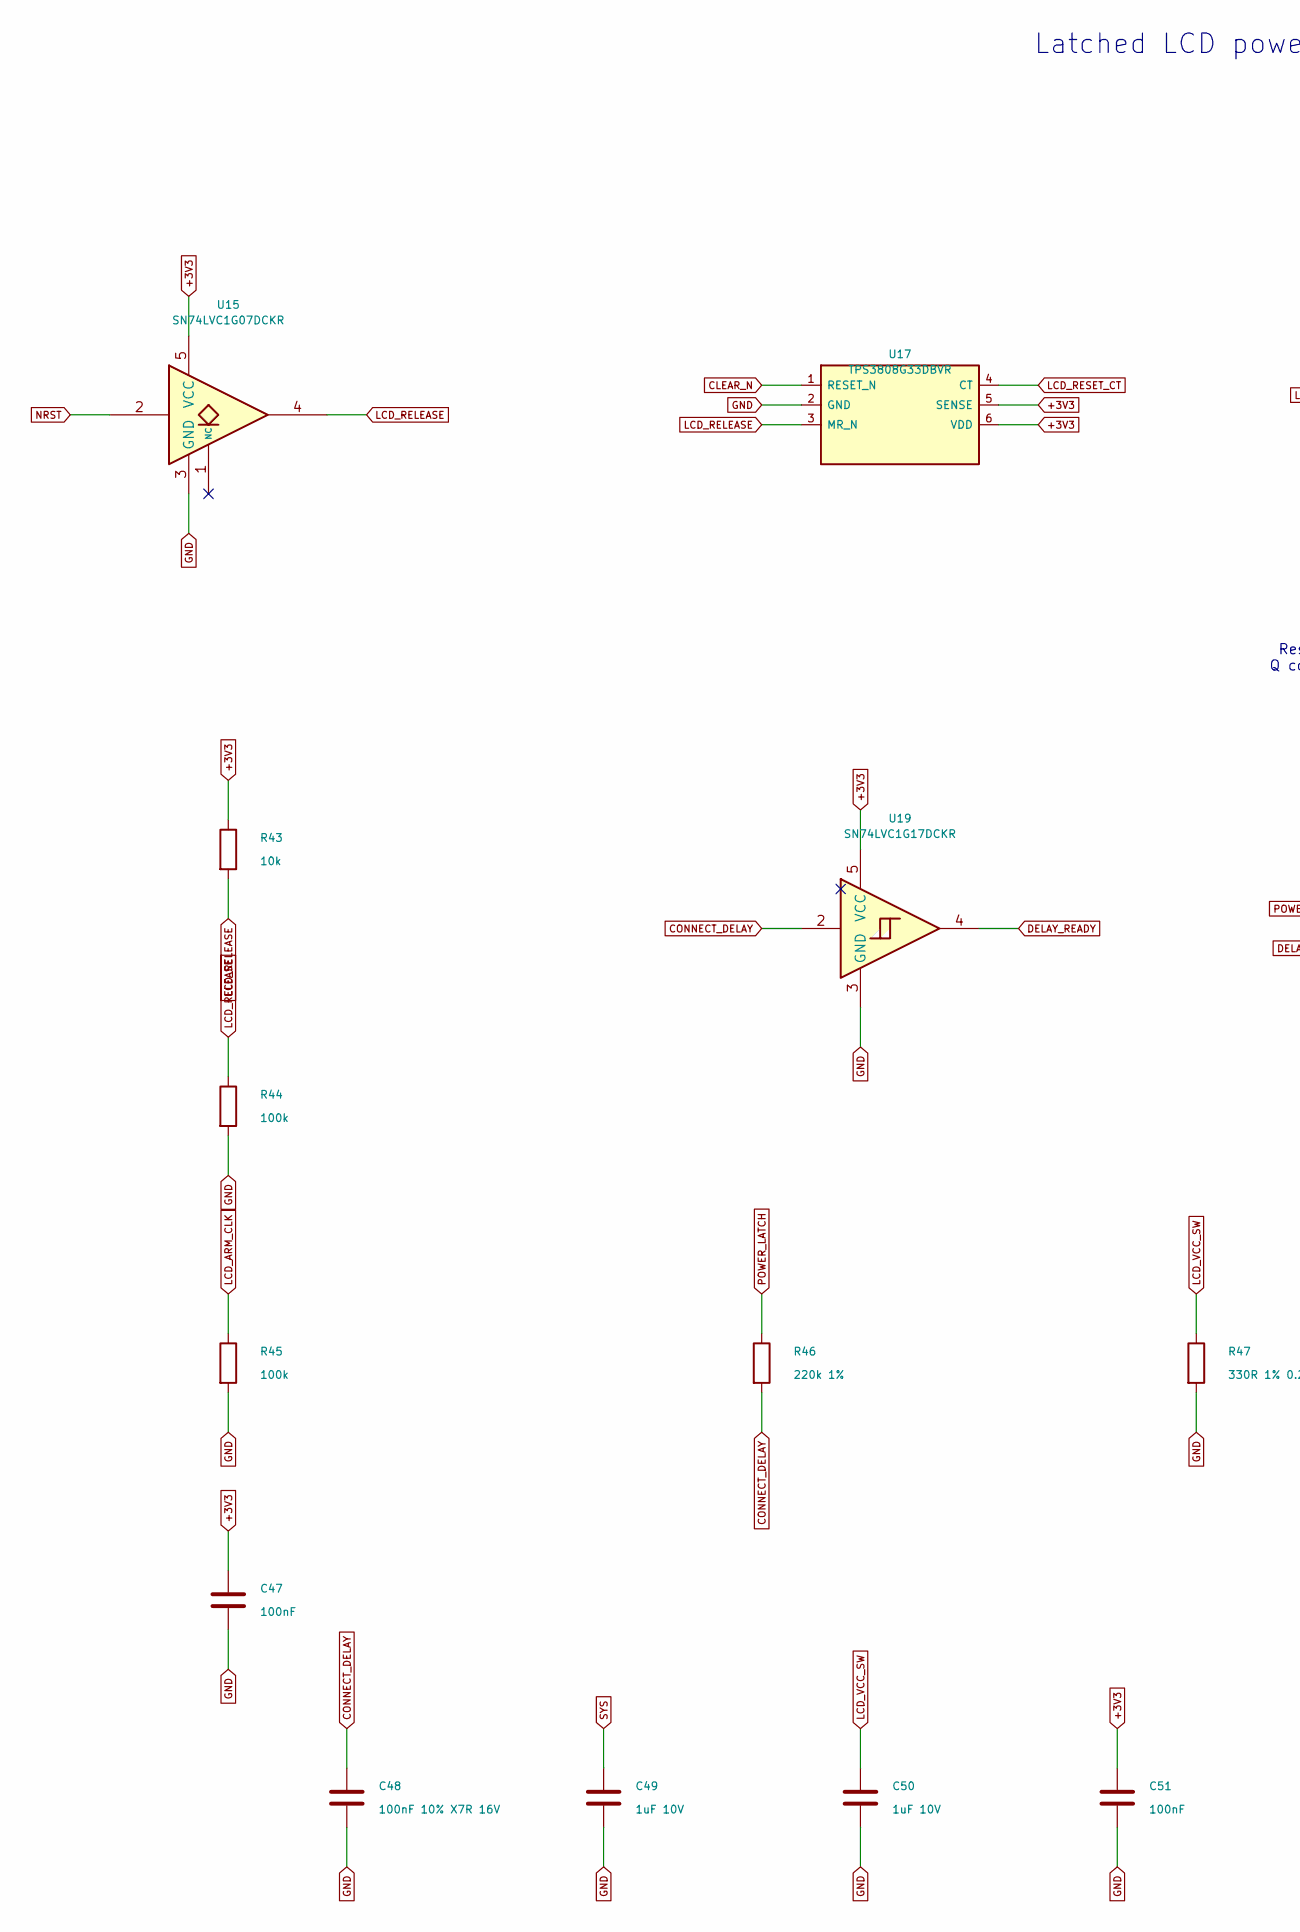
[picture p80: schematic 09-display-power.kicad_sch, OpenKeys R0.5 - 09-display-power, part in row 1, column 1]

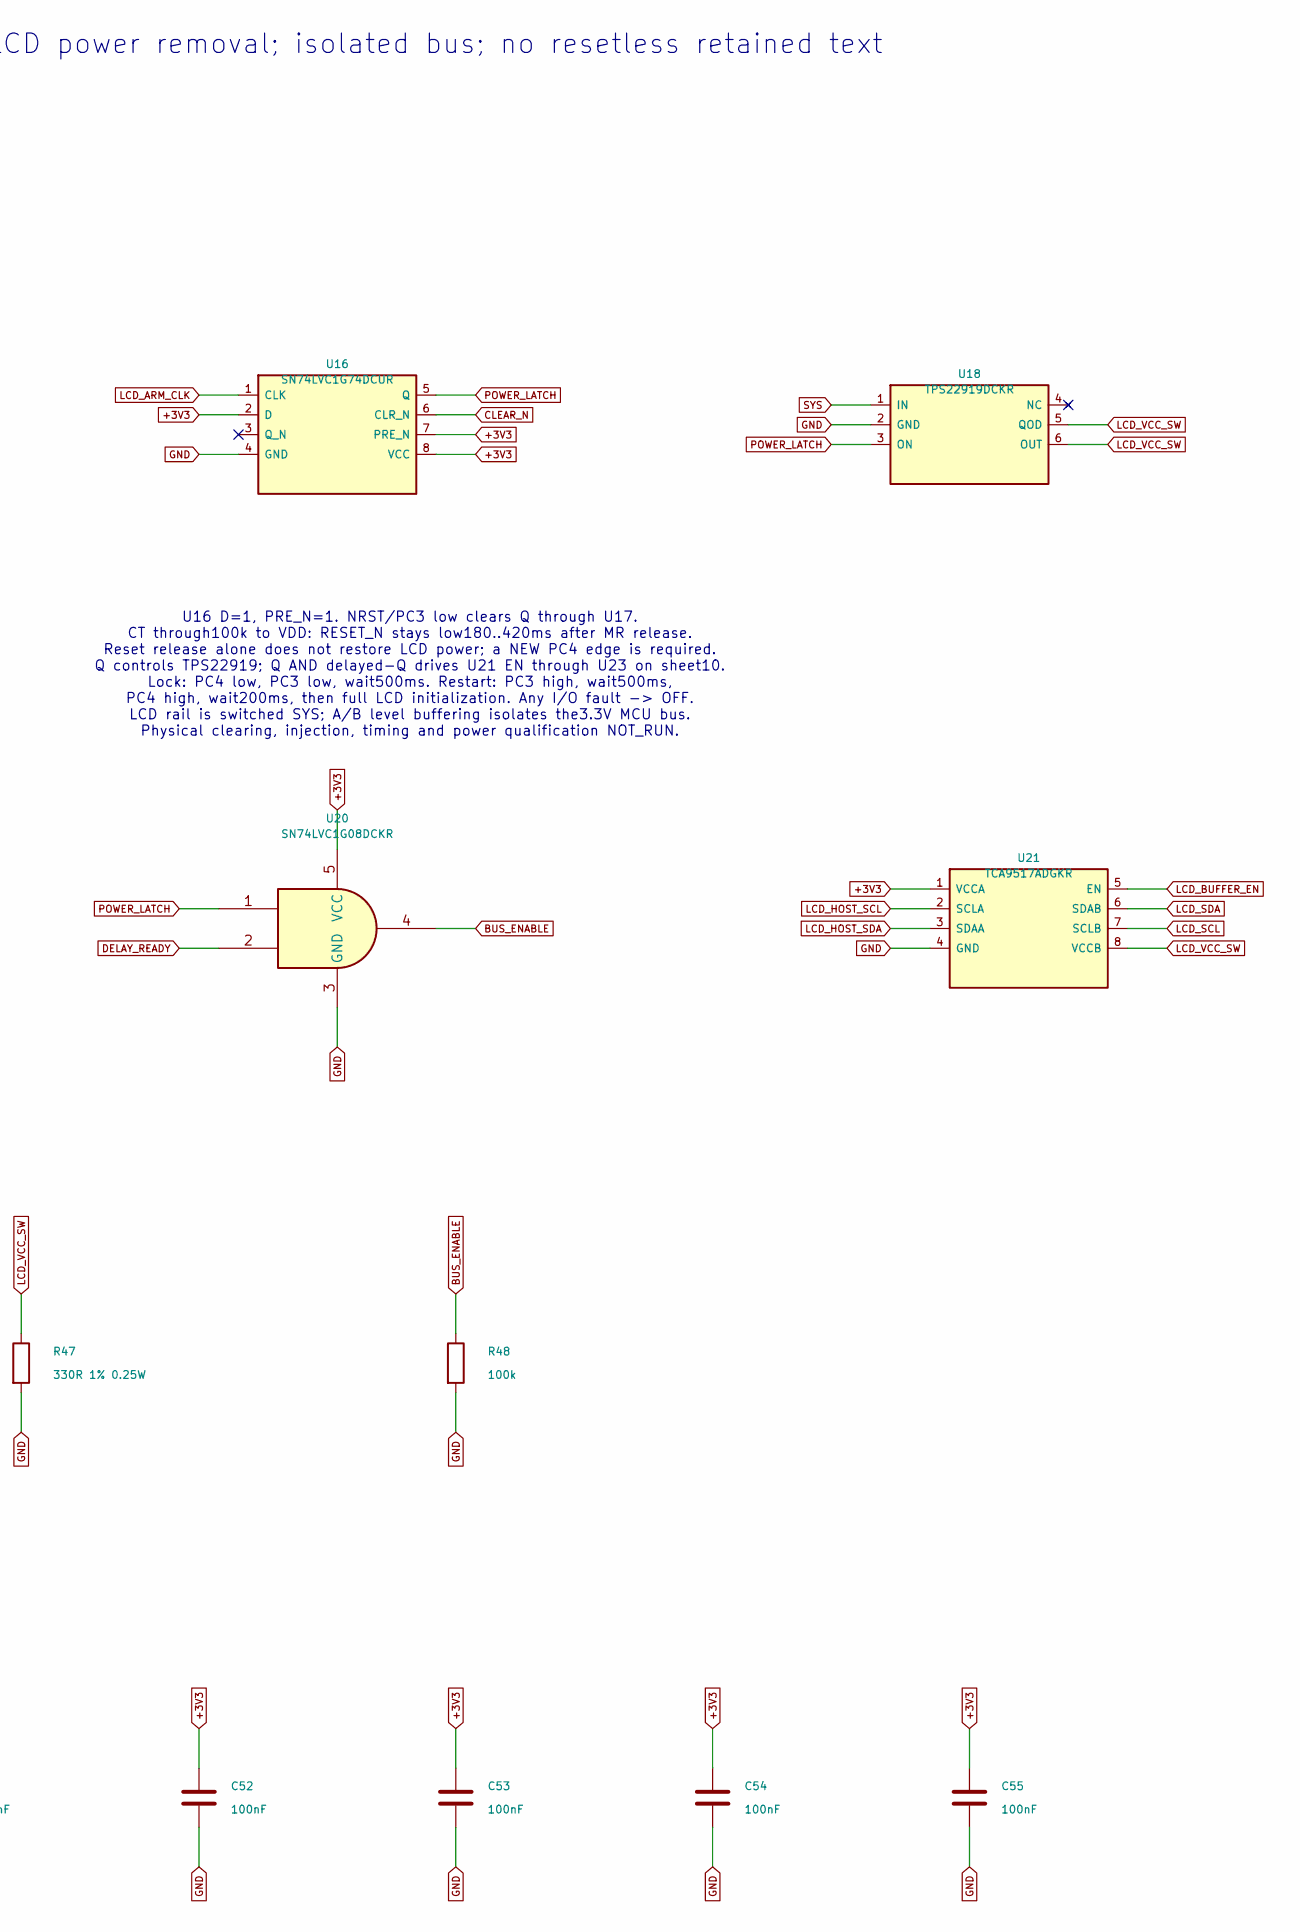
[picture p81: schematic 09-display-power.kicad_sch, OpenKeys R0.5 - 09-display-power, part in row 1, column 2]

Parts:
C47, C51, C52, C53, C54, C55: 100nF; C_0603_1608Metric
C48: 100nF 10% X7R 16V; C_0603_1608Metric
C49, C50: 1uF 10V; C_0805_2012Metric
R43: 10k; R_0603_1608Metric
R44, R45, R48: 100k; R_0603_1608Metric
R46: 220k 1%; R_0603_1608Metric
R47: 330R 1% 0.25W; R_1206_3216Metric
U15: SN74LVC1G07DCKR; SOT-353_SC-70-5
U16: SN74LVC1G74DCUR; VSSOP-8_2.3x2mm_P0.5mm
U17: TPS3808G33DBVR; SOT-23-6
U18: TPS22919DCKR; SOT-363_SC-70-6
U19: SN74LVC1G17DCKR; SOT-353_SC-70-5
U20: SN74LVC1G08DCKR; SOT-353_SC-70-5
U21: TCA9517ADGKR; VSSOP-8_3x3mm_P0.65mm

Connections:
+3V3: C47.1, C51.1, C52.1, C53.1, C54.1, C55.1, R43.1, U15.5 (VCC), U16.2 (D), U16.7 (PRE_N), U16.8 (VCC), U17.5 (SENSE), U17.6 (VDD), U19.5 (VCC), U20.5 (VCC), U21.1 (VCCA); also elsewhere on the board
BUS_ENABLE: R48.1, U20.4; also elsewhere on the board
CLEAR_N: U16.6 (CLR_N), U17.1 (RESET_N); also elsewhere on the board
CONNECT_DELAY: C48.1, R46.2, U19.2
DELAY_READY: U19.4, U20.2
GND: C47.2, C48.2, C49.2, C50.2, C51.2, C52.2, C53.2, C54.2, C55.2, R44.2, R45.2, R47.2, R48.2, U15.3 (GND), U16.4 (GND), U17.2 (GND), U18.2 (GND), U19.3 (GND), U20.3 (GND), U21.4 (GND); also elsewhere on the board
LCD_ARM_CLK: R45.1, U16.1 (CLK); also elsewhere on the board
LCD_BUFFER_EN: U21.5 (EN); also elsewhere on the board
LCD_HOST_SCL: U21.2 (SCLA); also elsewhere on the board
LCD_HOST_SDA: U21.3 (SDAA); also elsewhere on the board
LCD_RELEASE: R43.2, R44.1, U15.4, U17.3 (MR_N); also elsewhere on the board
LCD_RESET_CT: U17.4 (CT); also elsewhere on the board
LCD_SCL: U21.7 (SCLB); also elsewhere on the board
LCD_SDA: U21.6 (SDAB); also elsewhere on the board
LCD_VCC_SW: C50.1, R47.1, U18.5 (QOD), U18.6 (OUT), U21.8 (VCCB); also elsewhere on the board
NRST: U15.2; also elsewhere on the board
POWER_LATCH: R46.1, U16.5 (Q), U18.3 (ON), U20.1; also elsewhere on the board
SYS: C49.1, U18.1 (IN); also elsewhere on the board

Notes on the sheet:
Latched LCD power removal; isolated bus; no resetless retained text
U16 D=1, PRE_N=1. NRST/PC3 low clears Q through U17. CT through100k to VDD: RESET_N stays low180..420ms after MR release. Reset release alone does not restore LCD power; a NEW PC4 edge is required. Q controls TPS22919; Q AND delayed-Q drives U21 EN through U23 on sheet10. Lock: PC4 low, PC3 low, wa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
