Jay-Void-BA/OpenKeys/hardware/r05/kicad/OpenKeys.kicad_pcb

## KiCad design hardware/r05/kicad/OpenKeys.kicad_pcb (continued)

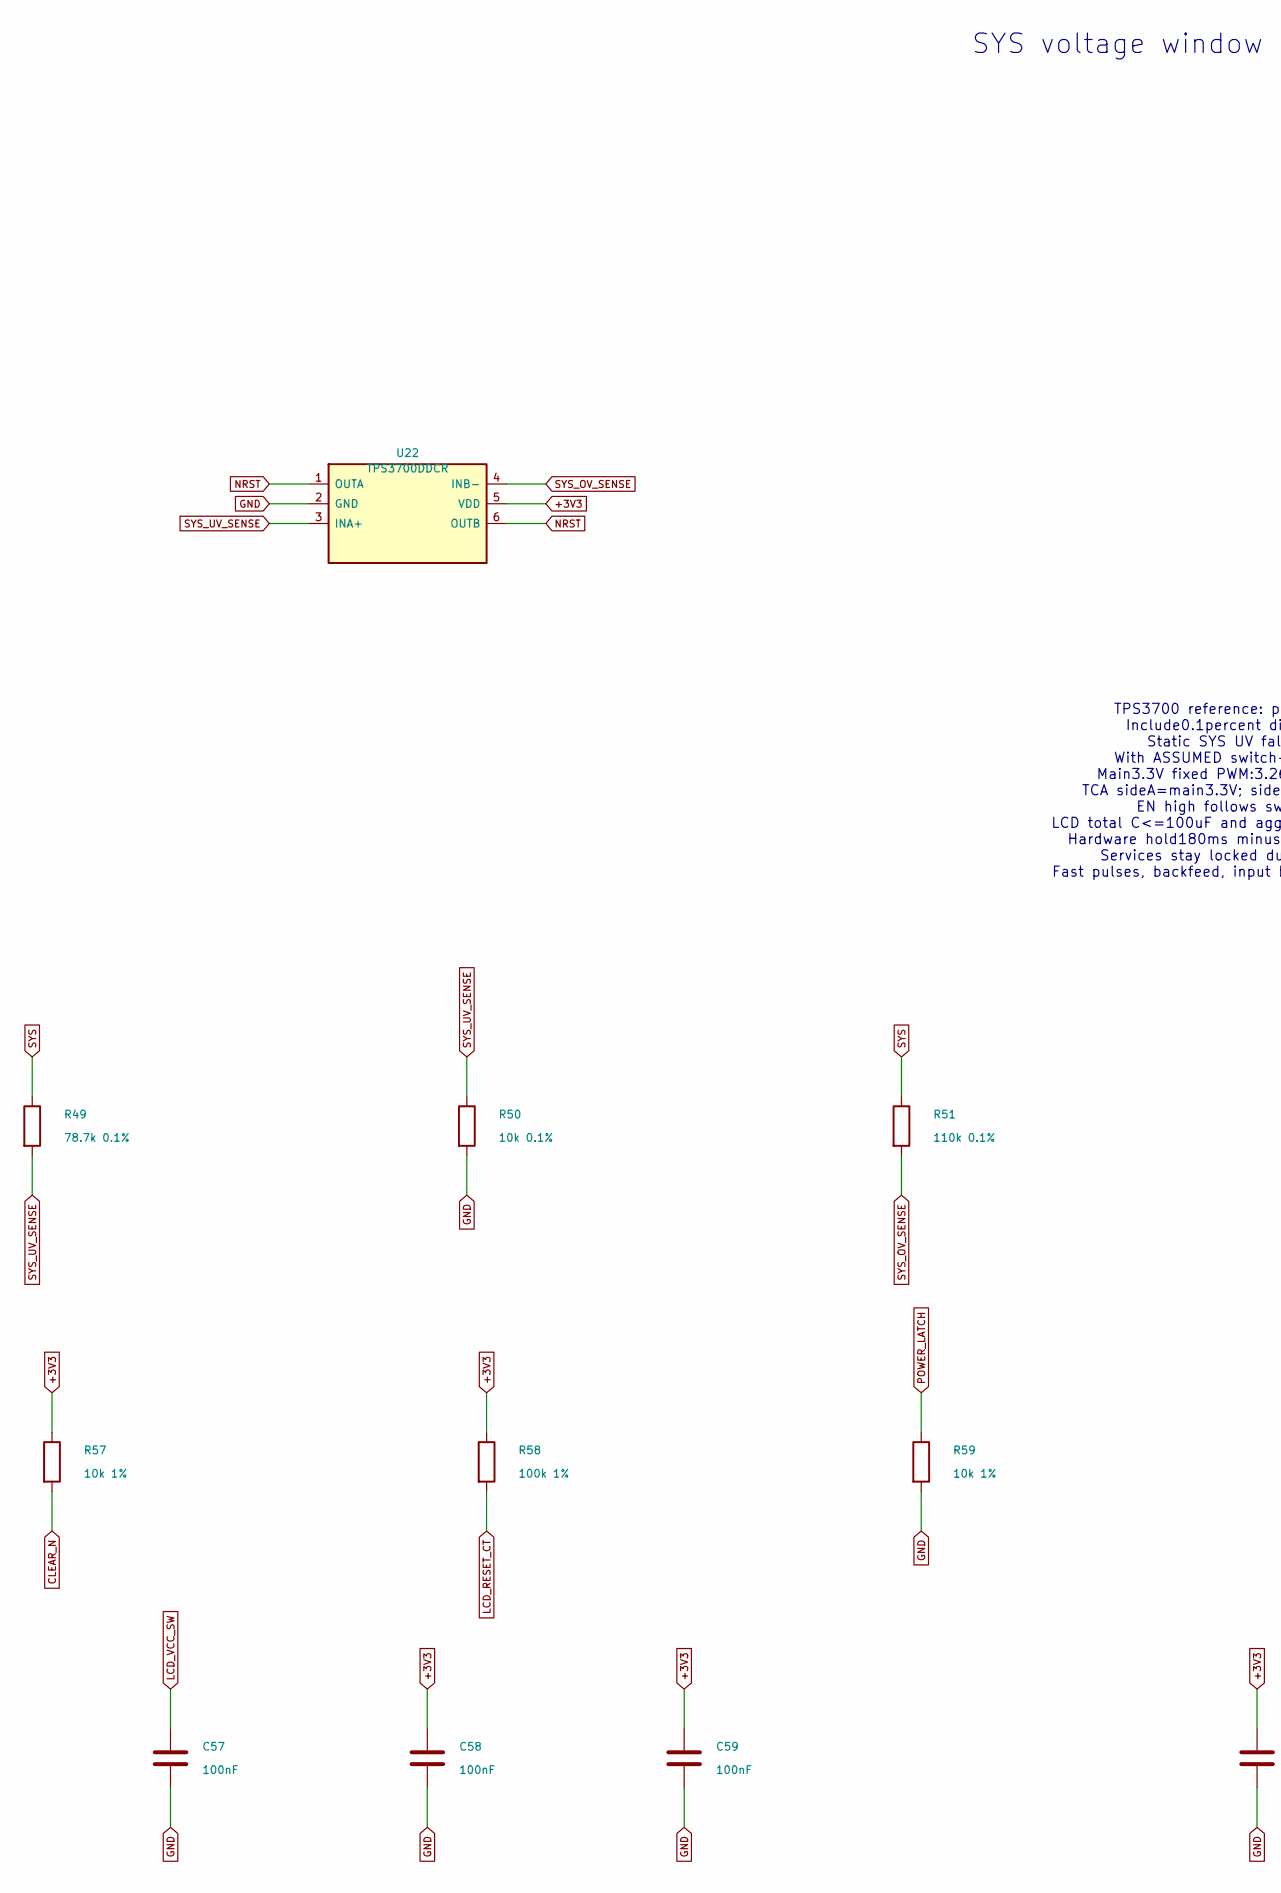
[picture p82: schematic 10-sys-window.kicad_sch, OpenKeys R0.5 - 10-sys-window, part in row 1, column 1]

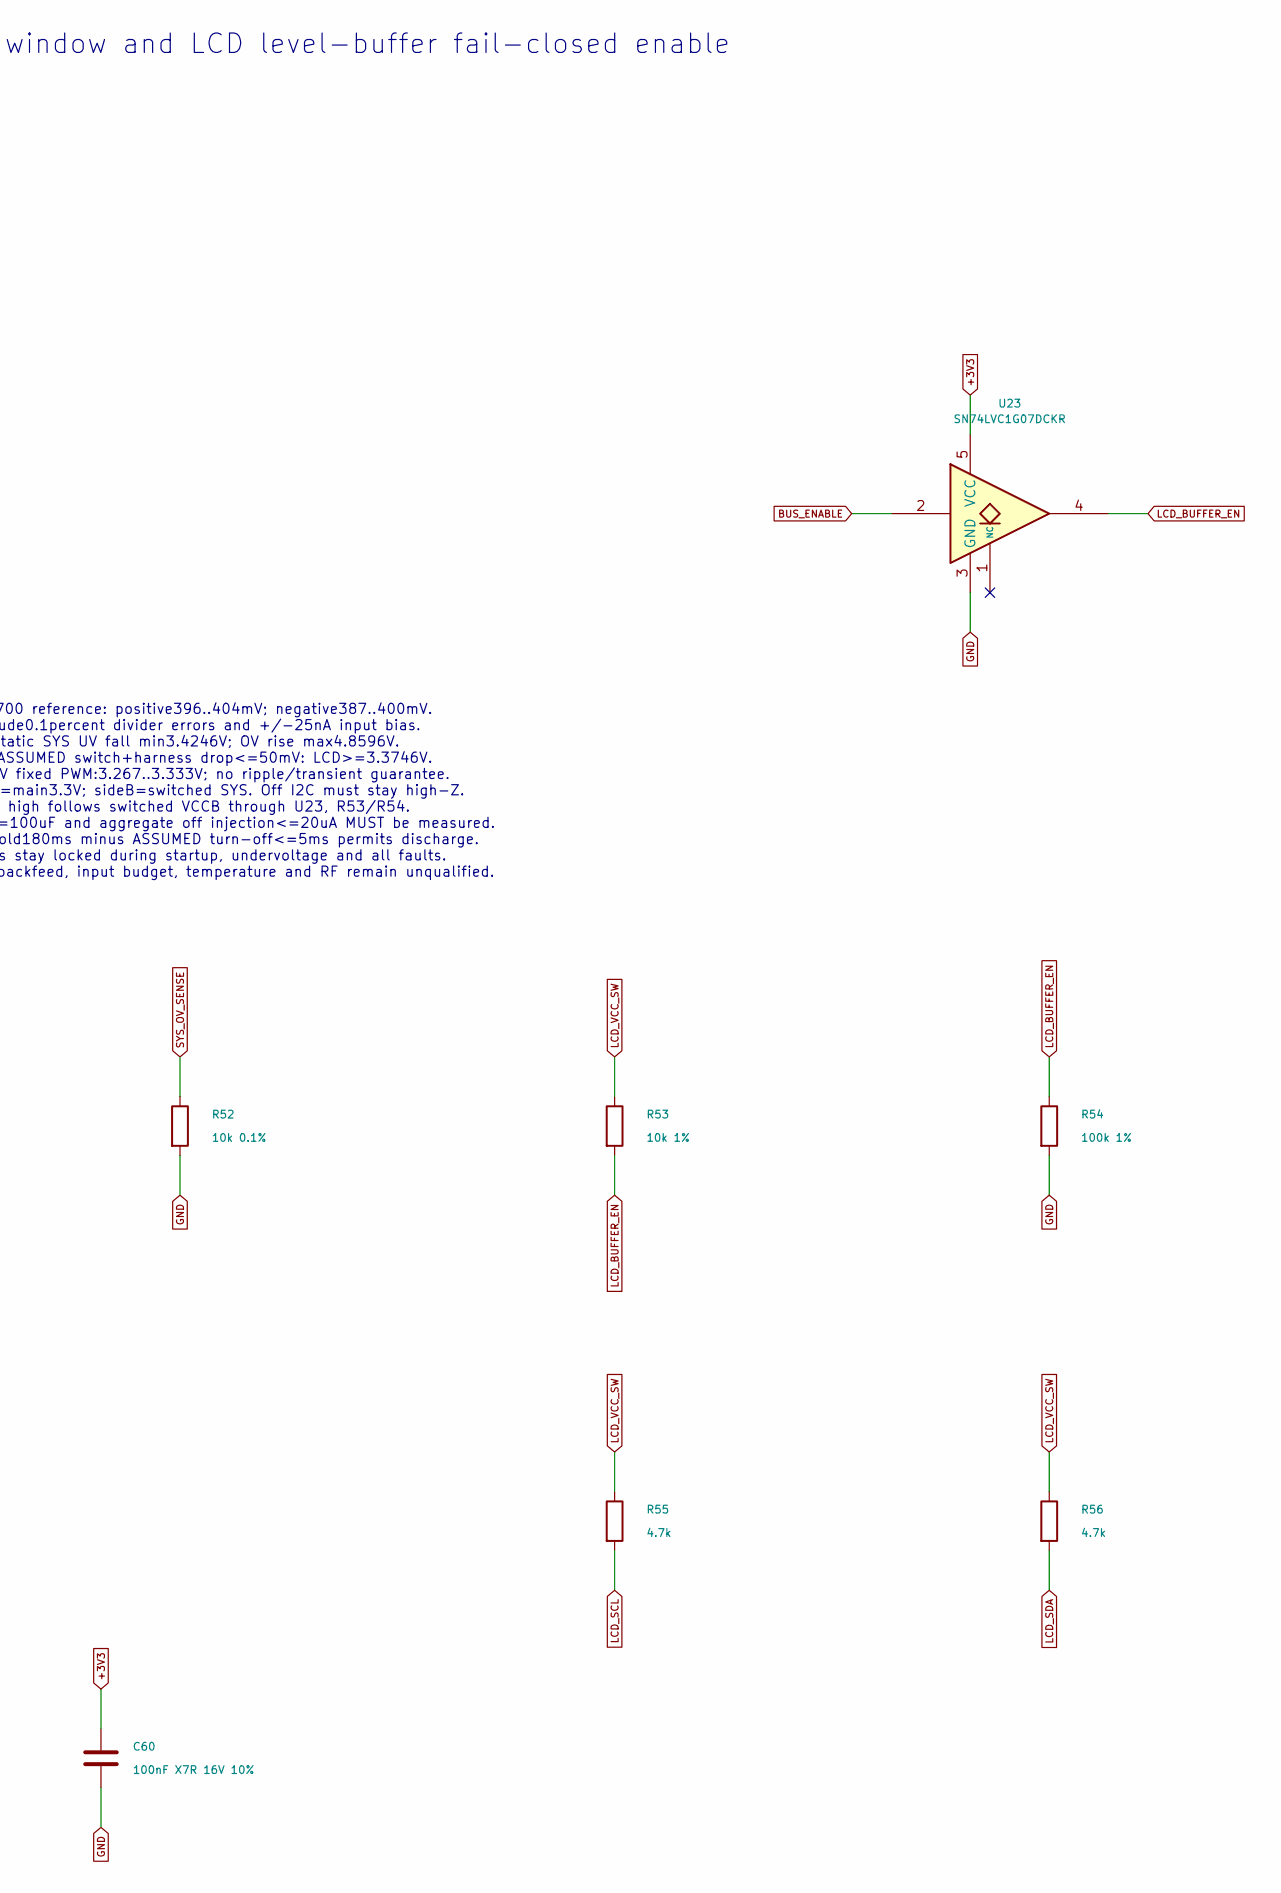
[picture p83: schematic 10-sys-window.kicad_sch, OpenKeys R0.5 - 10-sys-window, part in row 1, column 2]

Parts:
C57, C58, C59: 100nF; C_0603_1608Metric
C60: 100nF X7R 16V 10%; C_0603_1608Metric
R49: 78.7k 0.1%; R_0603_1608Metric
R50, R52: 10k 0.1%; R_0603_1608Metric
R51: 110k 0.1%; R_0603_1608Metric
R53, R57, R59: 10k 1%; R_0603_1608Metric
R54, R58: 100k 1%; R_0603_1608Metric
R55, R56: 4.7k; R_0603_1608Metric
U22: TPS3700DDCR; TSOT-23-6
U23: SN74LVC1G07DCKR; SOT-353_SC-70-5

Connections:
+3V3: C58.1, C59.1, C60.1, R57.1, R58.1, U22.5 (VDD), U23.5 (VCC); also elsewhere on the board
BUS_ENABLE: U23.2; also elsewhere on the board
CLEAR_N: R57.2; also elsewhere on the board
GND: C57.2, C58.2, C59.2, C60.2, R50.2, R52.2, R54.2, R59.2, U22.2 (GND), U23.3 (GND); also elsewhere on the board
LCD_BUFFER_EN: R53.2, R54.1, U23.4; also elsewhere on the board
LCD_RESET_CT: R58.2; also elsewhere on the board
LCD_SCL: R55.2; also elsewhere on the board
LCD_SDA: R56.2; also elsewhere on the board
LCD_VCC_SW: C57.1, R53.1, R55.1, R56.1; also elsewhere on the board
NRST: U22.1 (OUTA), U22.6 (OUTB); also elsewhere on the board
POWER_LATCH: R59.1; also elsewhere on the board
SYS: R49.1, R51.1; also elsewhere on the board
SYS_OV_SENSE: R51.2, R52.1, U22.4 (INB-)
SYS_UV_SENSE: R49.2, R50.1, U22.3 (INA+)

Notes on the sheet:
SYS voltage window and LCD level-buffer fail-closed enable
TPS3700 reference: positive396..404mV; negative387..400mV. Include0.1percent divider errors and +/-25nA input bias. Static SYS UV fall min3.4246V; OV rise max4.8596V. With ASSUMED switch+harness drop<=50mV: LCD>=3.3746V. Main3.3V fixed PWM:3.267..3.333V; no ripple/transient guarantee. TCA sideA=mai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

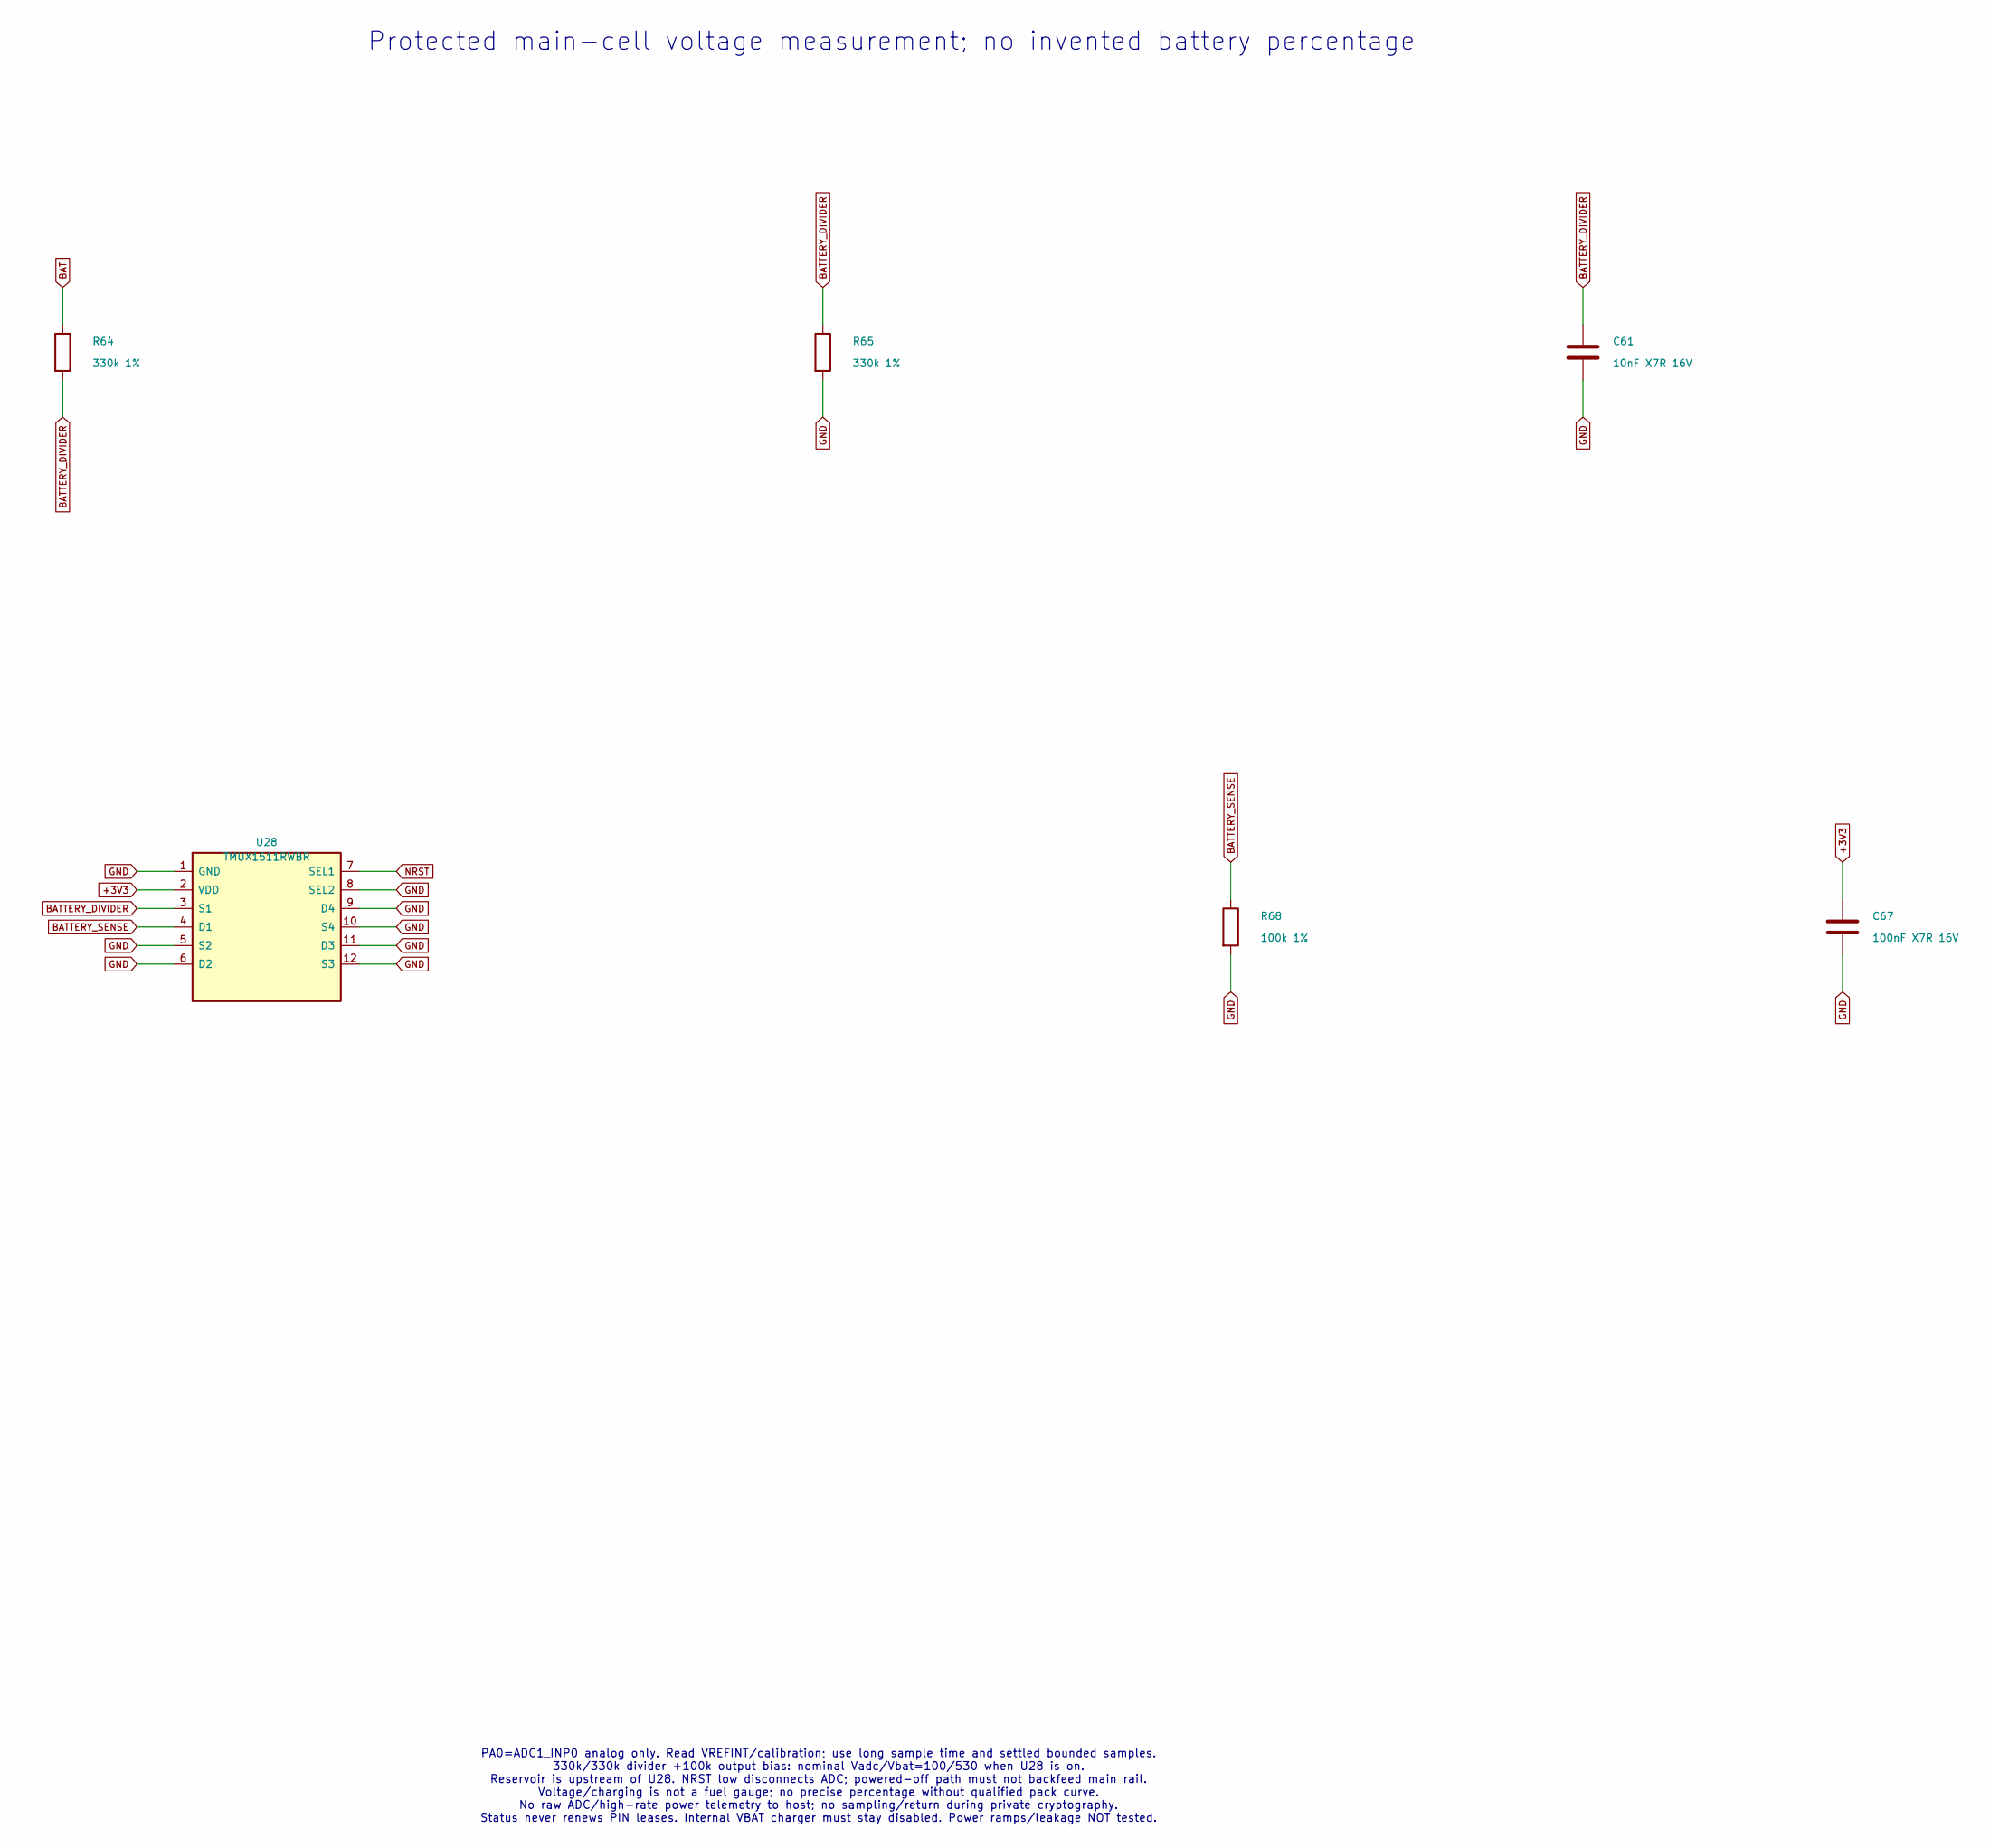
[picture p84: schematic 11-power-measurement.kicad_sch, OpenKeys R0.5 - 11-power-measurement]

Parts:
C61: 10nF X7R 16V; C_0603_1608Metric
C67: 100nF X7R 16V; C_0603_1608Metric
R64, R65: 330k 1%; R_0603_1608Metric
R68: 100k 1%; R_0603_1608Metric
U28: TMUX1511RWBR; Texas_X2QFN-12_1.6x1.6mm_P0.4mm

Connections:
+3V3: C67.1, U28.2 (VDD); also elsewhere on the board
BAT: R64.1; also elsewhere on the board
BATTERY_DIVIDER: C61.1, R64.2, R65.1, U28.3 (S1)
BATTERY_SENSE: R68.1, U28.4 (D1); also elsewhere on the board
GND: C61.2, C67.2, R65.2, R68.2, U28.1 (GND), U28.5 (S2), U28.6 (D2), U28.8 (SEL2), U28.9 (D4), U28.10 (S4), U28.11 (D3), U28.12 (S3); also elsewhere on the board
NRST: U28.7 (SEL1); also elsewhere on the board

Notes on the sheet:
Protected main-cell voltage measurement; no invented battery percentage
PA0=ADC1_INP0 analog only. Read VREFINT/calibration; use long sample time and settled bounded samples. 330k/330k divider +100k output bias: nominal Vadc/Vbat=100/530 when U28 is on. Reservoir is upstream of U28. NRST low disconnects ADC; powered-off path must not backfeed main rail. Voltage/chargin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

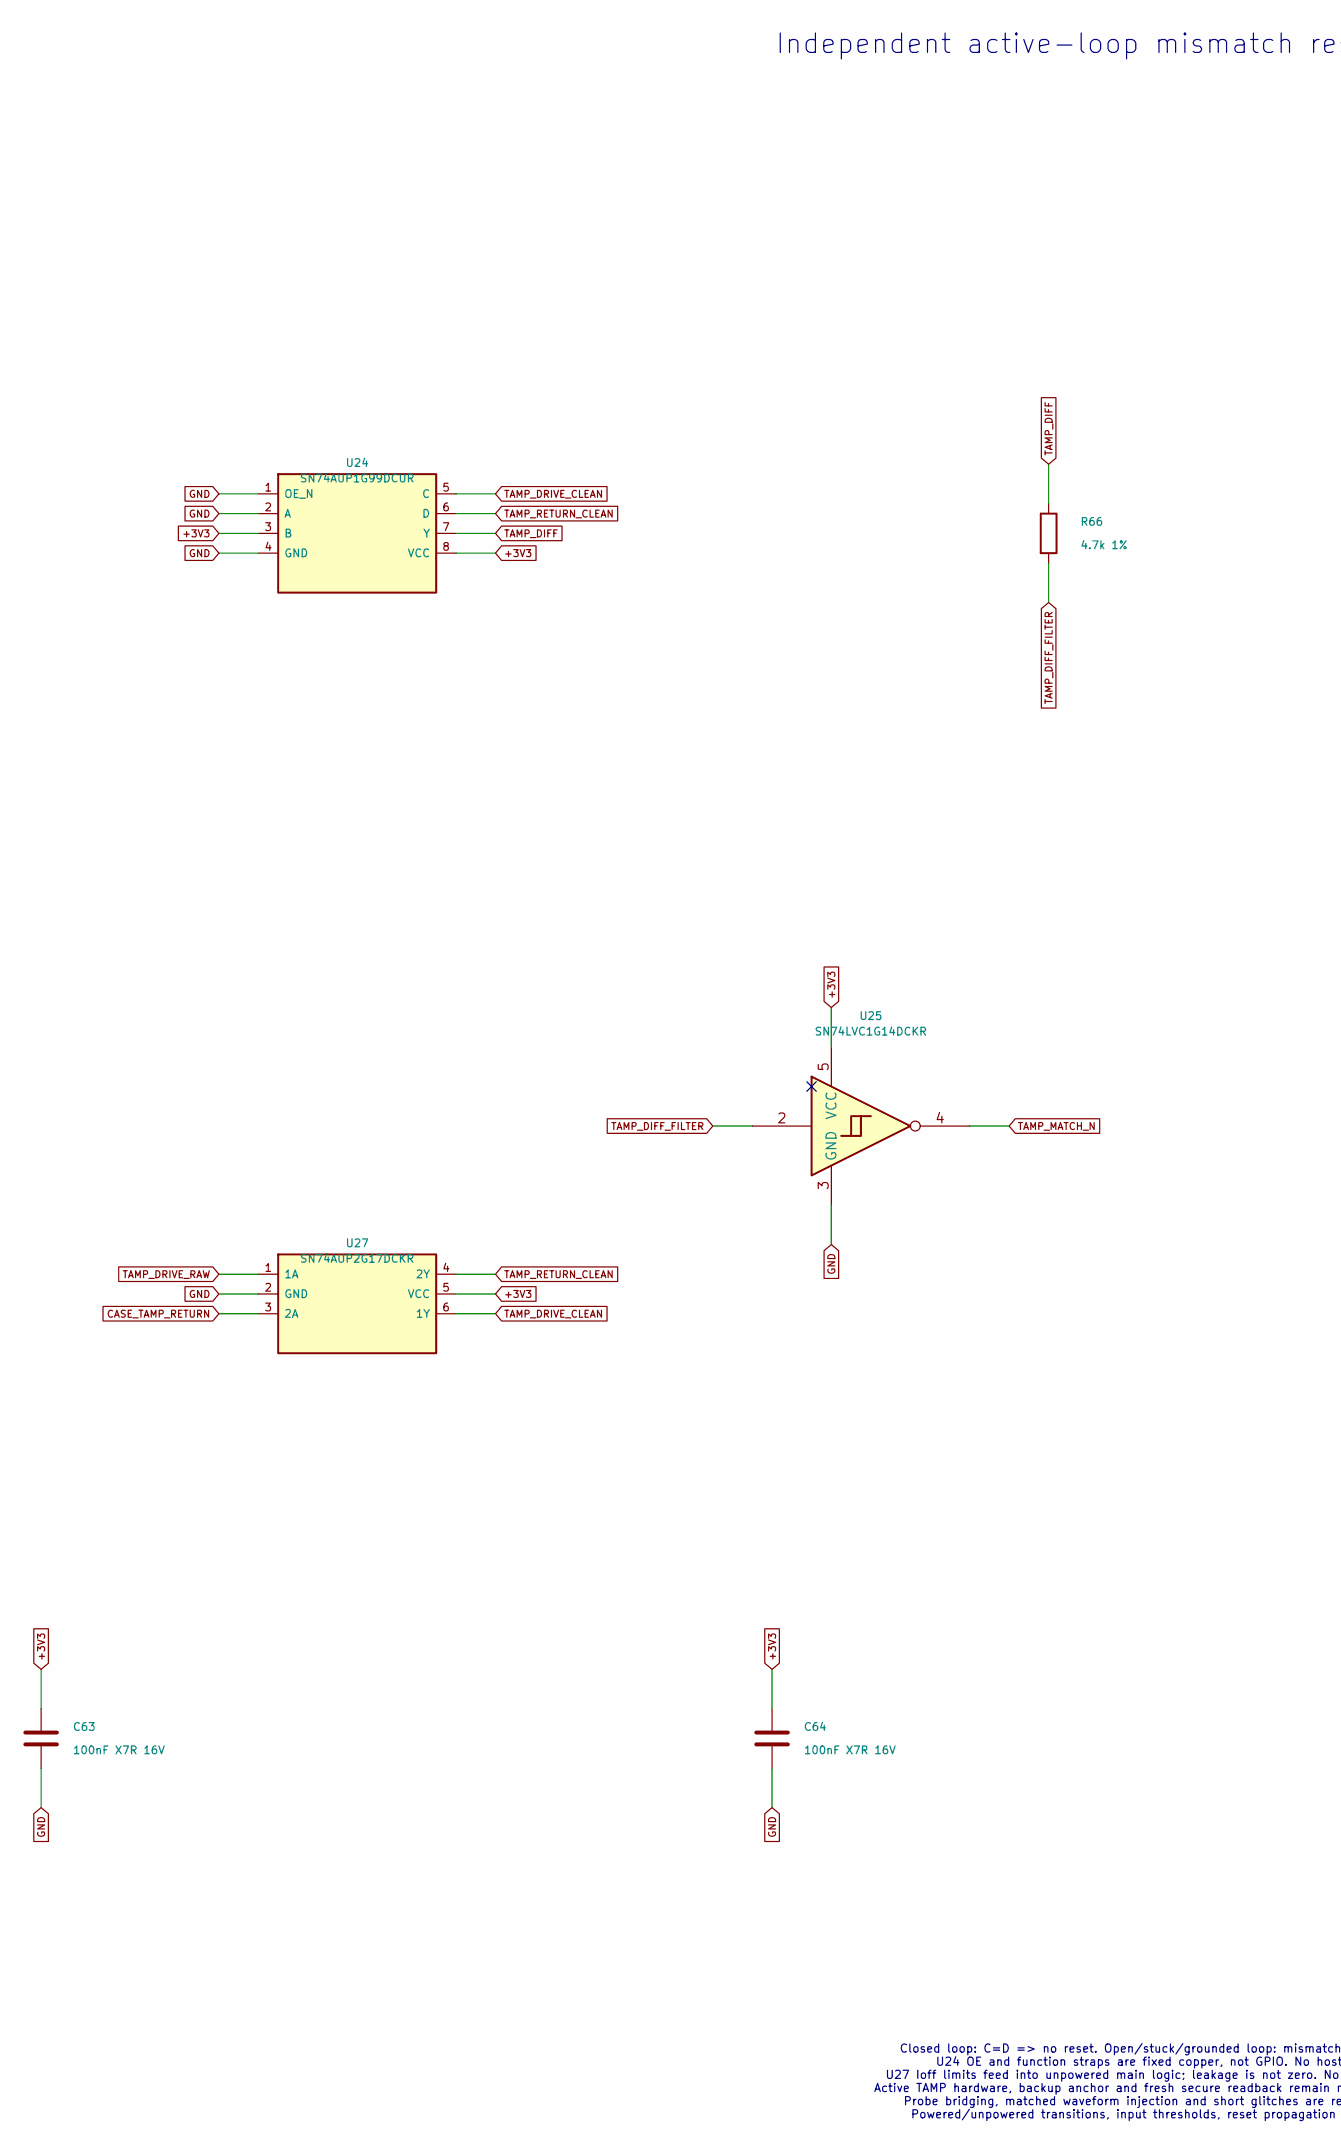
[picture p85: schematic 12-active-reset.kicad_sch, OpenKeys R0.5 - 12-active-reset, part in row 1, column 1]

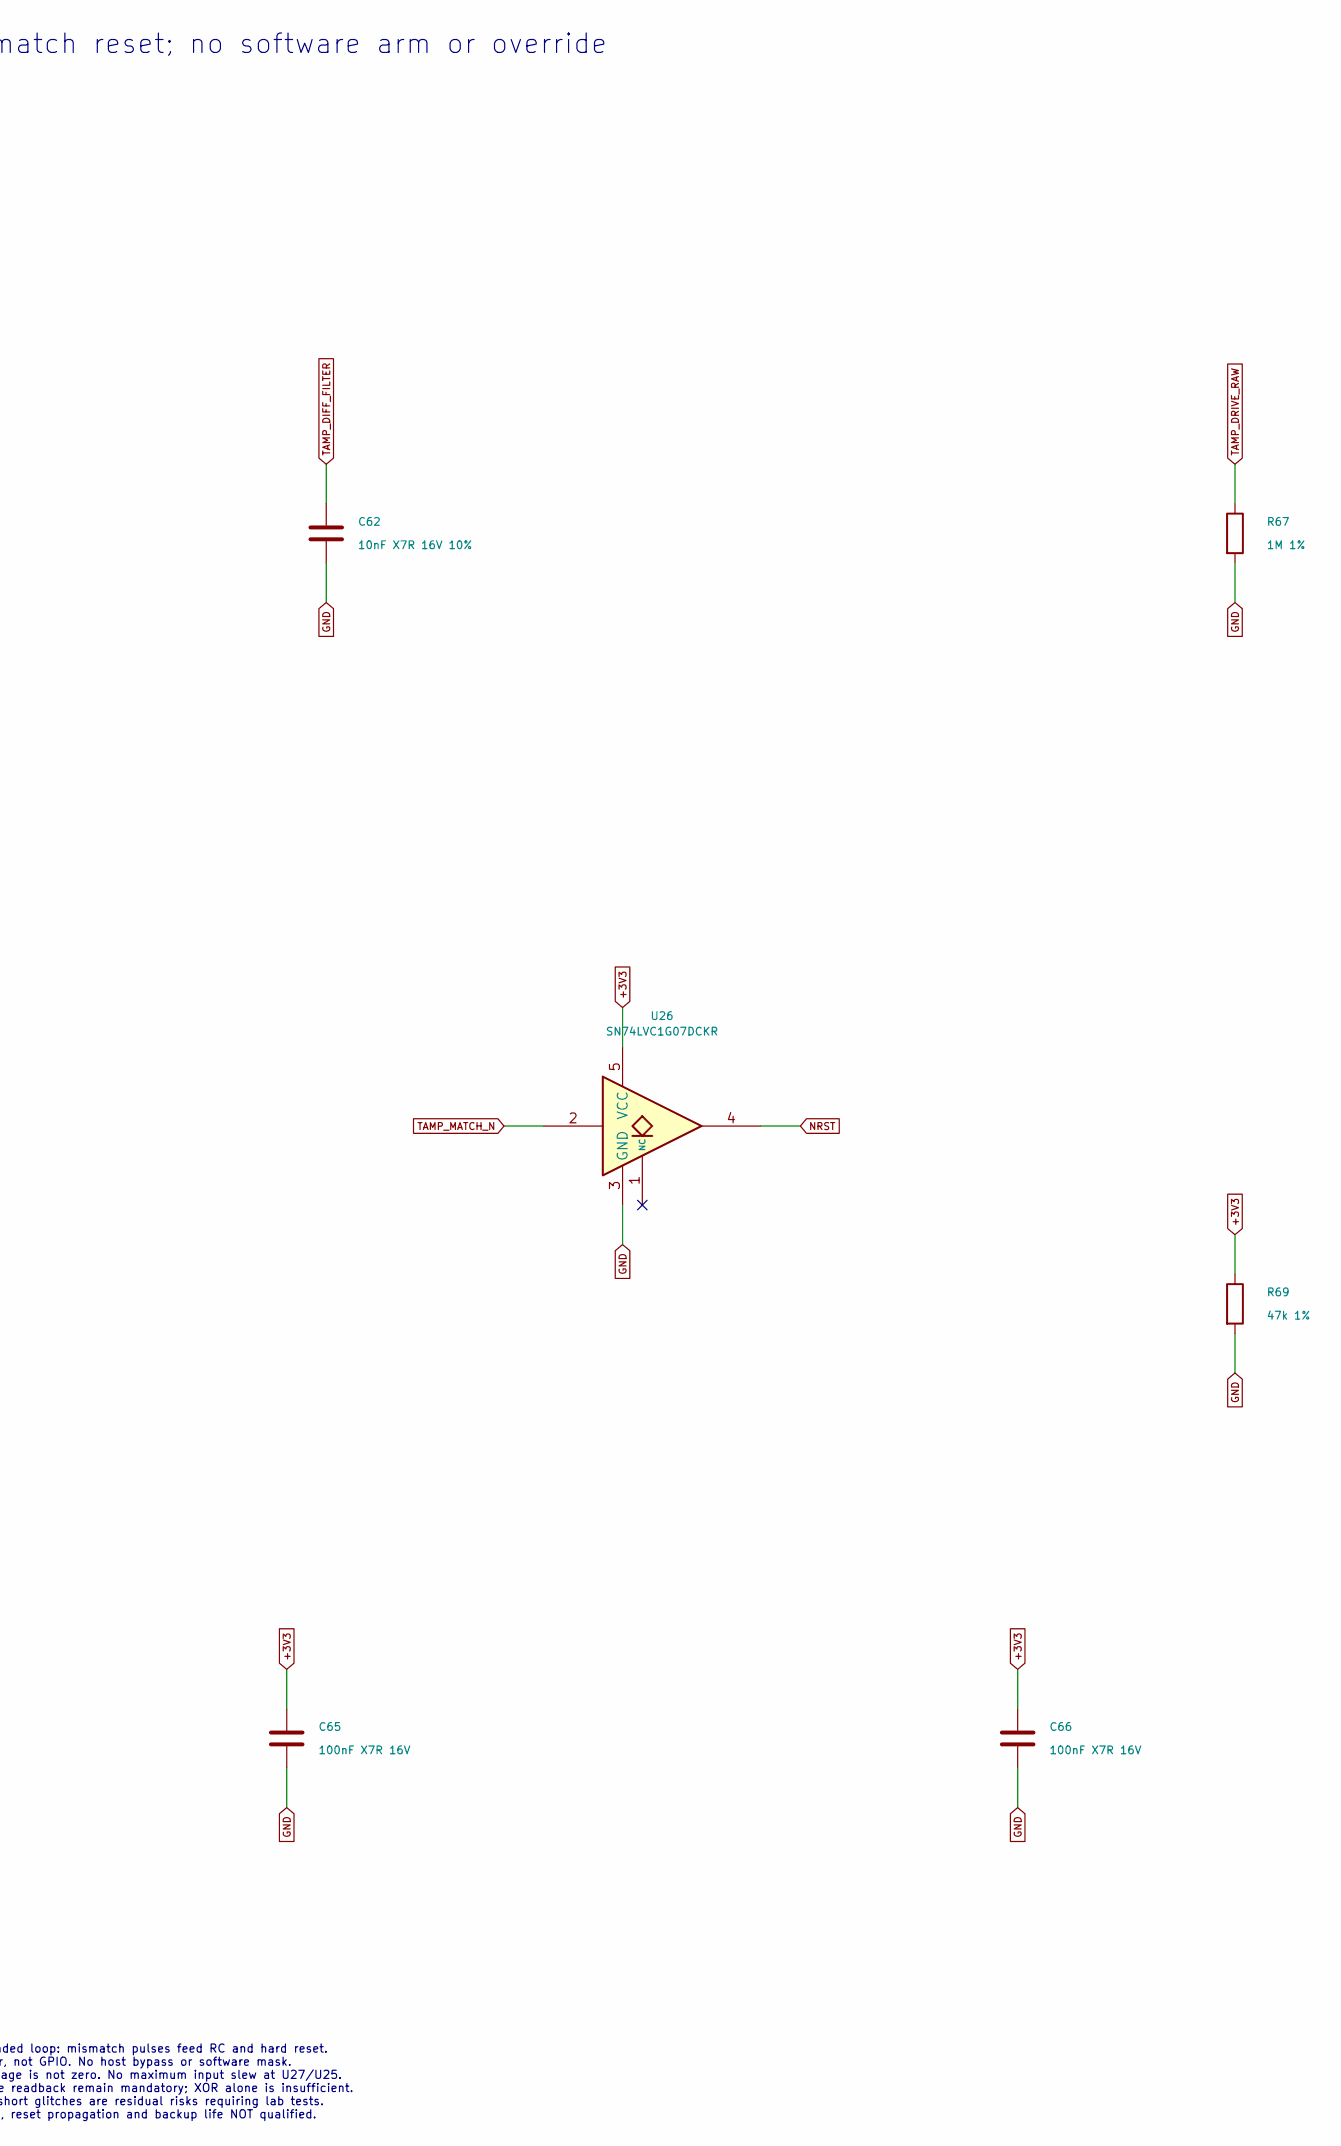
[picture p86: schematic 12-active-reset.kicad_sch, OpenKeys R0.5 - 12-active-reset, part in row 1, column 2]

Parts:
C62: 10nF X7R 16V 10%; C_0603_1608Metric
C63, C64, C65, C66: 100nF X7R 16V; C_0603_1608Metric
R66: 4.7k 1%; R_0603_1608Metric
R67: 1M 1%; R_0603_1608Metric
R69: 47k 1%; R_0603_1608Metric
U24: SN74AUP1G99DCUR; VSSOP-8_2.3x2mm_P0.5mm
U25: SN74LVC1G14DCKR; SOT-353_SC-70-5
U26: SN74LVC1G07DCKR; SOT-353_SC-70-5
U27: SN74AUP2G17DCKR; SOT-363_SC-70-6

Connections:
+3V3: C63.1, C64.1, C65.1, C66.1, R69.1, U24.3 (B), U24.8 (VCC), U25.5 (VCC), U26.5 (VCC), U27.5 (VCC); also elsewhere on the board
CASE_TAMP_RETURN: U27.3 (2A); also elsewhere on the board
GND: C62.2, C63.2, C64.2, C65.2, C66.2, R67.2, R69.2, U24.1 (OE_N), U24.2 (A), U24.4 (GND), U25.3 (GND), U26.3 (GND), U27.2 (GND); also elsewhere on the board
NRST: U26.4; also elsewhere on the board
TAMP_DIFF: R66.1, U24.7 (Y)
TAMP_DIFF_FILTER: C62.1, R66.2, U25.2
TAMP_DRIVE_CLEAN: U24.5 (C), U27.6 (1Y)
TAMP_DRIVE_RAW: R67.1, U27.1 (1A); also elsewhere on the board
TAMP_MATCH_N: U25.4, U26.2
TAMP_RETURN_CLEAN: U24.6 (D), U27.4 (2Y)

Notes on the sheet:
Independent active-loop mismatch reset; no software arm or override
Closed loop: C=D => no reset. Open/stuck/grounded loop: mismatch pulses feed RC and hard reset. U24 OE and function straps are fixed copper, not GPIO. No host bypass or software mask. U27 Ioff limits feed into unpowered main logic; leakage is not zero. No maximum input slew at U27/U25. Active TAMP 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

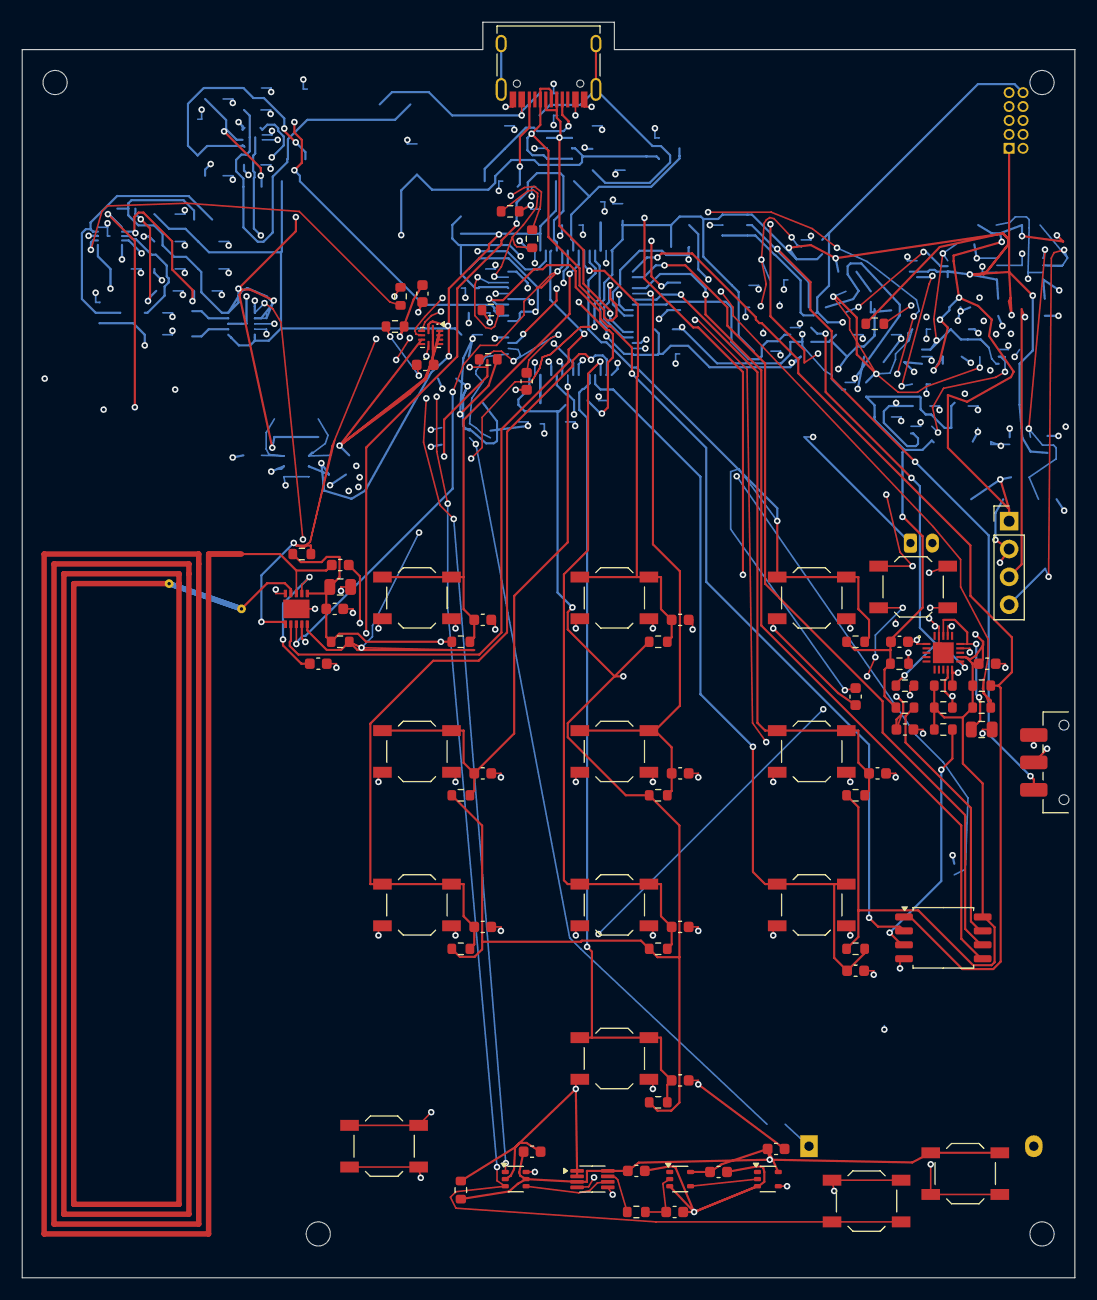
[picture p87: board OpenKeys.kicad_pcb from above]

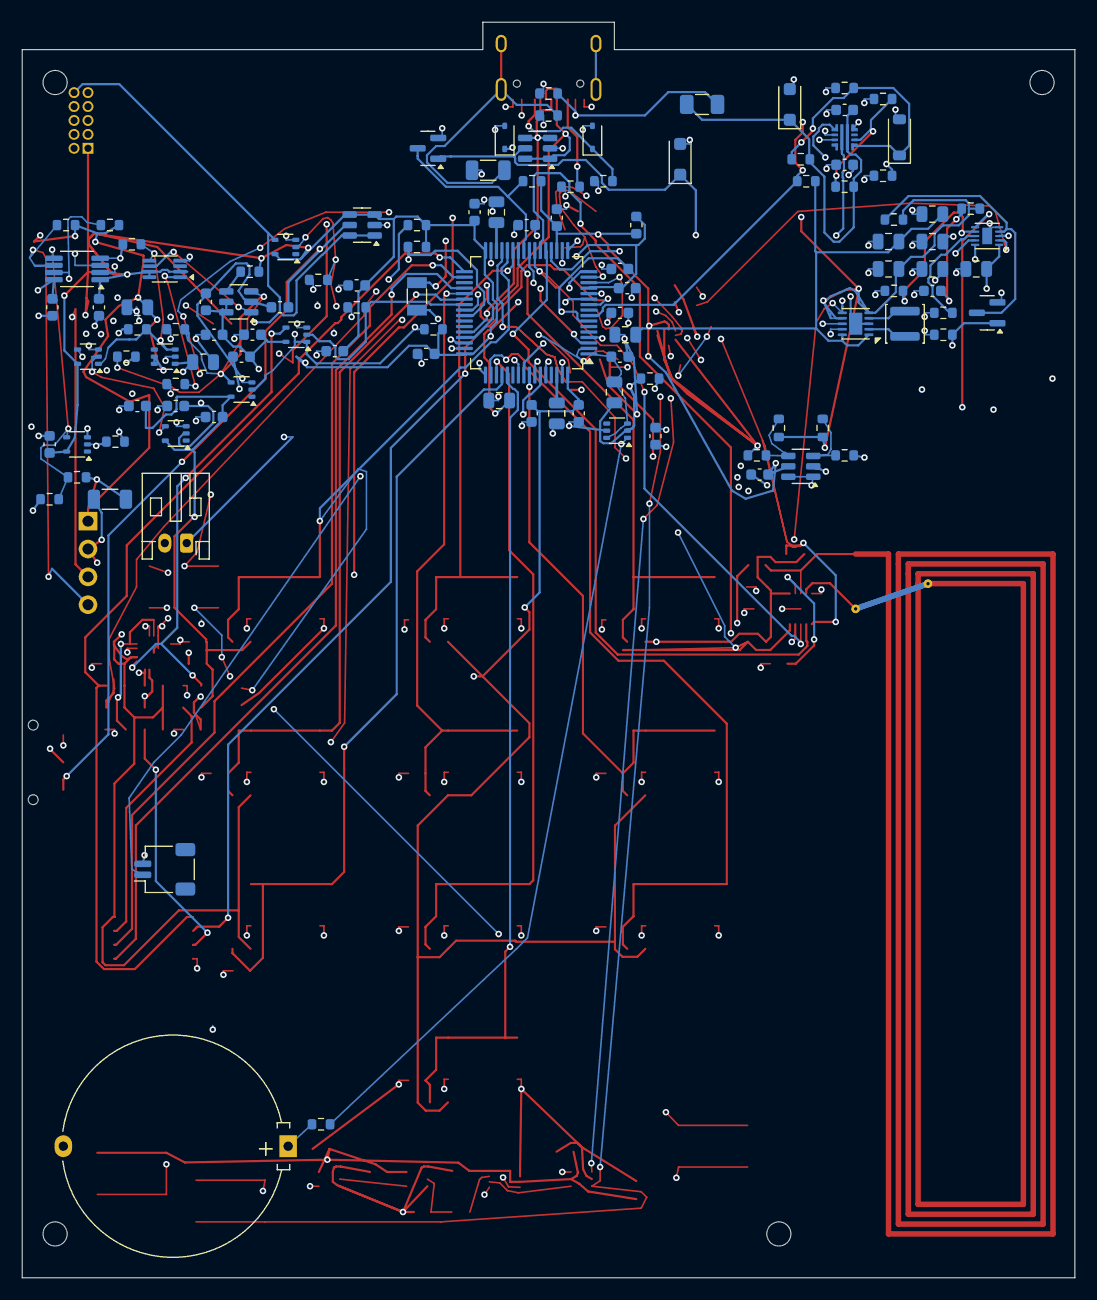
[picture p88: board OpenKeys.kicad_pcb from below]

Board: 4 copper layers, 96.0 x 114.5 mm, 199 parts (114 on the bottom side), 100 nets.

Other parts of the board:
H1, H2, H3, H4: MountingHole_2.2mm_M2
