Jay-Void-BA/OpenKeys/crates/scp03/src/test_vectors.rs

// Public TEST VECTORS ONLY. Generated with OpenSSL 3.5.7 9 Jun 2026 (Library: OpenSSL 3.5.7 9 Jun 2026).
pub mod aes128_random {
    pub const INITIALIZE: [u8; 14] = [
        0x80, 0x50, 0x01, 0x00, 0x08, 0x01, 0x02, 0x03, 0x04, 0x05, 0x06, 0x07, 0x08, 0x00,
    ];
    pub const IU_RESPONSE: [u8; 31] = [
        0x00, 0x00, 0x00, 0x00, 0x00, 0x00, 0x00, 0x00, 0x00, 0x00, 0x01, 0x03, 0x60, 0x10, 0x11,
        0x12, 0x13, 0x14, 0x15, 0x16, 0x17, 0x6d, 0x0e, 0xa7, 0xc4, 0xab, 0x47, 0x99, 0xc6, 0x90,
        0x00,
    ];
    pub const EXTERNAL: [u8; 21] = [
        0x84, 0x82, 0x33, 0x00, 0x10, 0xef, 0xdf, 0x1f, 0xa9, 0xe1, 0x07, 0xd0, 0x39, 0x3d, 0xd6,
        0xb4, 0x3e, 0xb5, 0xce, 0xec, 0x41,
    ];
    pub const SESSION_ENC: [u8; 16] = [
        0x28, 0xde, 0xe8, 0xa3, 0xe2, 0xb0, 0xea, 0xda, 0x60, 0x70, 0xba, 0x2a, 0x69, 0x9b, 0xd4,
        0x5a,
    ];
    pub const SESSION_MAC: [u8; 16] = [
        0xee, 0x42, 0x51, 0xb6, 0xe1, 0x3d, 0x4c, 0x76, 0x40, 0xdb, 0x86, 0xe2, 0x60, 0xe3, 0x78,
        0x8c,
    ];
    pub const SESSION_RMAC: [u8; 16] = [
        0x97, 0x27, 0x27, 0x9e, 0x50, 0xf9, 0xf4, 0xc9, 0xc2, 0x04, 0xab, 0x11, 0xf9, 0x6f, 0x9d,
        0x18,
    ];
    pub const COMMAND_1: [u8; 14] = [
        0x84, 0xca, 0x00, 0x00, 0x08, 0xc5, 0xca, 0x4e, 0x91, 0xd7, 0x98, 0x09, 0xf5, 0x00,
    ];
    pub const RESPONSE_1: [u8; 10] = [0x16, 0x13, 0xd5, 0xba, 0xeb, 0xd0, 0x4f, 0xe9, 0x90, 0x00];
    pub const COMMAND_2: [u8; 46] = [
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
        0x33, 0xf1, 0xce, 0xac, 0xae, 0x87, 0x95, 0xa8, 0xdd, 0x93, 0x9c, 0xa8, 0xc4, 0x8d, 0x98,
        0x90,
    ];
    pub const RESPONSE_8: [u8; 10] = [0x57, 0x9a, 0xf3, 0x30, 0x34, 0x99, 0x43, 0x50, 0x90, 0x00];
}
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
