Jay-Void-BA/OpenKeys/crates/scp03/src/tests.rs

extern crate std;

use super::*;
use aes::cipher::{BlockDecrypt, BlockEncrypt, KeyInit};
use cmac::{Cmac, Mac};

#[path = "test_vectors.rs"]
mod vectors;

// Software crypto exists only in cfg(test), with public synthetic keys. The
// target build never links this backend, the OpenSSL CLI or a software AES.
struct Software {
    challenge: [u8; 8],
    fail: bool,
    decrypt_calls: usize,
}

impl Software {
    fn new() -> Self {
        Self {
            challenge: [1, 2, 3, 4, 5, 6, 7, 8],
            fail: false,
            decrypt_calls: 0,
        }
    }
    fn check(&self) -> Result<(), Error> {
        if self.fail {
            Err(Error::Crypto)
        } else {
            Ok(())
        }
    }
}

macro_rules! backend {
    ($size:expr, $aes:ty) => {
        impl Crypto<$size> for Software {
            fn random_challenge(&mut self, out: &mut [u8; 8]) -> Result<(), Error> {
                self.check()?;
                *out = self.challenge;
                Ok(())
            }
            fn cmac(
                &mut self,
                key: &[u8; $size],
                message: &[u8],
                out: &mut [u8; 16],
            ) -> Result<(), Error> {
                self.check()?;
                let mut mac = <Cmac<$aes> as Mac>::new_from_slice(key).unwrap();
                mac.update(message);
                out.copy_from_slice(&mac.finalize().into_bytes());
                Ok(())
            }
            fn encrypt_block(
                &mut self,
                key: &[u8; $size],
                input: &[u8; 16],
                out: &mut [u8; 16],
            ) -> Result<(), Error> {
                self.check()?;
                let cipher = <$aes>::new_from_slice(key).unwrap();
                let mut block = (*input).into();
                cipher.encrypt_block(&mut block);
                out.copy_from_slice(&block);
                Ok(())
            }
            fn encrypt_cbc(
                &mut self,
                key: &[u8; $size],
                iv: &[u8; 16],
                bytes: &mut [u8],
            ) -> Result<(), Error> {
                self.check()?;
                if !bytes.len().is_multiple_of(16) {
                    return Err(Error::Input);
                }
                let mut previous = *iv;
                for block in bytes.chunks_exact_mut(16) {
                    let mut input = [0; 16];
                    for (i, byte) in input.iter_mut().enumerate() {
                        *byte = block[i] ^ previous[i];
                    }
                    <Self as Crypto<$size>>::encrypt_block(self, key, &input, &mut previous)?;
                    block.copy_from_slice(&previous);
                }
                Ok(())
            }
            fn decrypt_cbc(
                &mut self,
                key: &[u8; $size],
                iv: &[u8; 16],
                bytes: &mut [u8],
            ) -> Result<(), Error> {
                self.check()?;
                self.decrypt_calls += 1;
                if !bytes.len().is_multiple_of(16) {
                    return Err(Error::Input);
                }
                let cipher = <$aes>::new_from_slice(key).unwrap();
                let mut previous = *iv;
                for block in bytes.chunks_exact_mut(16) {
                    let saved: [u8; 16] = block.try_into().unwrap();
                    let mut input = saved.into();
                    cipher.decrypt_block(&mut input);
                    for (i, byte) in block.iter_mut().enumerate() {
                        *byte = input[i] ^ previous[i];
                    }
                    previous = saved;
                }
                Ok(())
            }
        }
    };
}
backend!(16, aes::Aes128);
backend!(32, aes::Aes256);

const AID: [u8; 8] = [0xa0, 0, 0, 1, 0x51, 0, 0, 0];

fn masters<const N: usize>() -> StaticKeys<N> {
    StaticKeys::new(
        Zeroizing::new(core::array::from_fn(|i| i as u8)),
        Zeroizing::new(core::array::from_fn(|i| i as u8 + 32)),
    )
    .unwrap()
}
fn command(data: &[u8]) -> Command<'_> {
    Command {
        class: 0x80,
        instruction: 0xca,
        p1: 0,
        p2: 0,
        data,
        le: Some(Le::Short(0)),
    }
}
fn established() -> (Software, Channel<16>) {
    let mut crypto = Software::new();
    let keys = masters();
    let handshake = Handshake::start(&mut crypto, &keys, 1, &AID).unwrap();
    let pending = handshake
        .accept(&mut crypto, &vectors::aes128_random::IU_RESPONSE)
        .unwrap();
    let channel = pending.finish(&[0x90, 0]).unwrap();
    (crypto, channel)
}
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
