Jay-Void-BA/OpenKeys/(commit log)

2026-11-08 Add OpenKeys R0 circuit and mechanical design with Rust development workspace
    [01-usb.kicad_sch, 02-power.kicad_sch, 03-mcu.kicad_sch, 04-se-storage-rtc.kicad_sch, 05-nfc.kicad_sch, 06-trusted-ui.kicad_sch, BOM.csv, OpenKeys-assembly.blend]
2026-11-08 Harden biometric policy and document manufacturing release blockers
    [01-usb.kicad_sch, 02-power.kicad_sch, 03-mcu.kicad_sch, 04-se-storage-rtc.kicad_sch, 05-nfc.kicad_sch, 06-trusted-ui.kicad_sch, BOM.csv, OpenKeys-base.stl]
2026-11-08 Use current macOS runner and allow targeted native checks
2026-11-08 Require fingerprint authorization and add R0.3 LCD hardware review
    [01-usb.kicad_sch, 02-power.kicad_sch, 03-mcu.kicad_sch, 04-se-storage.kicad_sch, 05-nfc.kicad_sch, 06-trusted-ui.kicad_sch, 07-fault-tamper.kicad_sch, BOM.csv]
2026-11-08 Normalize KiCad SVG export whitespace reproducibly
2026-11-08 Correct input TVS coordination and remove implicit audit toolchain warning
    [01-usb.kicad_sch, OpenKeys-base.stl, OpenKeys-floorplan.kicad_pcb, OpenKeys-lid.stl]
2026-11-08 Add independent USB input cutoff and source-based NFC package lands
    [01-usb.kicad_sch, 02-power.kicad_sch, 03-mcu.kicad_sch, 05-nfc.kicad_sch, 08-input-guard.kicad_sch, BOM.csv, OpenKeys-base.stl, OpenKeys-floorplan.kicad_pcb]
2026-11-08 Complete R04 electrical PCB, fabrication data and physical security test plan
    [01-usb.kicad_sch, 02-power.kicad_sch, 03-mcu.kicad_sch, 04-se-storage.kicad_sch, 05-nfc.kicad_sch, 06-trusted-ui.kicad_sch, 07-fault-tamper.kicad_sch, 08-input-guard.kicad_sch]
2026-11-08 Set explicit Git default branch for warning-free CAD checkout
2026-11-09 Add PCB-bound Rust drivers, ARM diagnostics and privacy failure tests
    [build.rs, buttons.rs, critical_sections.rs, drivers.rs, export-diagnostic.py, flash.rs, lcd.rs, lib.rs]
2026-11-09 Preserve CAD and pin contract bytes on Windows checkouts
2026-11-09 Implement strict SE channel and checked H573 secure crypto adapters
    [references.lock.tsv]
2026-11-09 Record three-platform and ARM crypto validation evidence
2026-11-09 Add guarded FPC SPI transport and encrypted Identify requests
2026-11-09 Record 125-test CI and verified current native development builds
2026-11-09 Integrate protected OpenSK core, SE key APDUs and progress-aware I2C
2026-11-09 Bind long private operations to fixed revocable execution scopes
    [lib.rs, tests.rs]
2026-11-10 Add complete R04 build manual, printable PDF and sourcing worksheets
    [procurement-r04-board.csv, procurement-r04-external.csv]
2026-11-10 Add R05 PIN keypad CAD and scoped PIN/OTP candidate modules
    [01-usb.kicad_sch, 02-power.kicad_sch, 03-mcu.kicad_sch, 04-se-storage.kicad_sch, 05-nfc.kicad_sch, 06-trusted-ui.kicad_sch, 07-fault-tamper.kicad_sch, 08-input-guard.kicad_sch]
2026-11-10 Fix Apple Blocks ABI and reject future-incompatible dependencies
    [check-future-compat.py]
2026-11-10 Record warning-free R05 CI and current development artifacts
2026-11-10 Add default-off native UserID session qualification probe
2026-11-11 Enforce native PIN boundaries and add encrypted management and OTP cores
2026-11-11 Select RSA-capable SE051C2 and correct USB backup supply
    [04-se-storage.kicad_sch, 06-trusted-ui.kicad_sch, 07-fault-tamper.kicad_sch, BOM.csv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]
2026-11-11 Support bounded extended SCP03 and native PIN APDUs
2026-11-11 Refresh native PIN source contract after extended APDU changes
2026-11-12 Correct classical LCD supply margins and enforce hardware reset hold
    [01-usb.kicad_sch, 02-power.kicad_sch, 03-mcu.kicad_sch, 04-se-storage.kicad_sch, 05-nfc.kicad_sch, 06-trusted-ui.kicad_sch, 07-fault-tamper.kicad_sch, 08-input-guard.kicad_sch]
2026-11-13 Separate classical hardware PIN and FIDO protocol PIN authorization
2026-11-13 Revoke both PIN layers on FIDO runtime failures and teardown
    [tests.rs]
2026-11-13 Link current classical CI artifacts with explicit verification limits
2026-11-13 Bind native PIN private I/O to live executions and add locked lifecycle primitives
2026-11-13 Refresh native PIN source contract after sharing the fixed session encoder
2026-11-13 Publish current classical CI evidence and remaining delivery blockers
2026-11-14 Add independent backup active tamper and isolated battery sensing
    [03-mcu.kicad_sch, 07-fault-tamper.kicad_sch, 11-power-measurement.kicad_sch, 12-active-reset.kicad_sch, BOM.csv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]
